hirakuni45/RX/rxprog/README.md

Renesas RX microcontroller flash programming tool (rx_prog)
=========
R5F564ML

[Japanese](READMEja.md)

## Overview
Tool to write program to flash memory of RX microcontroller using serial interface   
   
|RX Microcontroller|Support|operation verification|
|:-:|:-:|:-:|
|RX13T|〇|ー|
|RX140|〇|〇|
|RX220|〇|〇|
|RX230|〇|ー|
|RX231|〇|〇|
|RX23T|〇|ー|
|RX24T|〇|〇|
|RX24U|〇|ー|
|RX260/RX261|〇|ー|
|RX26T|〇|〇|
|RX621/RX62N|〇|〇|
|RX631/RX63N|〇|〇|
|RX63T|〇|〇|
|RX64M|〇|〇|
|RX651/RX65N|〇|ー|
|RX66T|〇|〇|
|RX71M|〇|〇|
|RX72T|〇|〇|
|RX72N|〇|ー|
   
---
   
## Project list
   
- main.cpp
- conf_in.hpp
- file_io.cpp
- file_io.hpp
- format.hpp
- motsx_io.hpp
- protocol_base.hpp
- rs232c_io.hpp
- rx_prog.hpp
- rx_protocol.hpp
- rx220_protocol.hpp
- rx23x_protocol.hpp
- rx24t_protocol.hpp
- rx26t_protocol.hpp
- rx62x_protocol.hpp
- rx63x_protocol.hpp
- rx64m_protocol.hpp
- rx65x_protocol.hpp
- rx66t_protocol.hpp
- rx72t_protocol.hpp
- sjis_utf16.cpp
- sjis_utf16.hpp
- string_utils.cpp
- string_utils.hpp
- Makefile
- rx_prog.conf
- /USB_CH9102F
- /USB_CP2102N
   
---
   
## Preparation of build (compilation) environment (Windows)
   
- MSYS2 setup
- gcc related installation (C++20)
- With C++20 support, Boost is no longer required
   
See development environment preparation of 'RX/README.md'
   
---
   
## Build method, environment setting
   
- make
- Copy configuration file and executable file by make install
- pass the path to '/usr/local/bin'
   
---
   
## Connection preparation (serial connection)
   
- Connect the VSS pin of the microcontroller to the GND of USB serial.
- Connect the RXD1 pin on the microcontroller side with the USB serial TXD.
- Connect the TXD1 pin on the microcontroller side with the USB serial RXD.
※SCI port at boot (usually SCI1, hardware manual for confirmation)   
- Pull down if the device has a UB terminal. (4.7K)
- Pull down if there is an EMLE terminal. (4.7K)
- Set the MD terminal to "Low" and input the "Reset" signal.
- When executing an internal program, set the MD pin to "High level" and input reset signal.
- MDE(13) is 0 (assumed little-endian)

---

## Connection terminal list

### RX140:

|Terminal|LFQFP 64|
|---|---|
|MD|MD(3)|
|RXD|P30/RXD1(14)|
|TXD|P26/TXD1(16)|

|Mode|MD|
|---|:---:|
|Serial Boot|0|
|Single Chip|1|

VCL: 4.7uF

### RX220:
|Terminal|LFQFP 64|
|---|---|
|MD|MD(3)|
|B/UB|PC7(27)|
|RXD|P30/RXD1(14)|
|TXD|P26/TXD1(16)|

|Mode|B/UB|MD|
|---|:---:|:---:|
|Boot Mode|0|0|
|User Boot Mode|1|0|
|Single Chip|-|1|

VCL: 0.1uF

---
### RX231:   
|Terminal|LFQFP 64|LFQFP 100|
|---|---|---|
|MD|MD(3)|MD(7)|
|UB|PC7(27)|PC7(45)|
|RXD|P30/RXD1(14)|P30/RXD1(20)|
|TXD|P26/TXD1(16)|P25/TXD1(23)|

|Mode|UB|MD|
|---|:---:|:---:|
|Serial Boot|0|0|
|USB Boot|1|0|
|Single Chip|-|1|

VCL: 4.7uF

---
### RX621/RX62N:
|Terminal|RX621/RX62N (144)|
|---|---|
|MD0|MD0(16)|
|MD1|MD1(15)|
|EMLE|EMLE(10)|
|RXD|P30/RXD1(29)|
|TXD|P26/TXD1(31)|
   
|Mode|MD0|MD1|
|---|:---:|:---:|
|Serial Boot|1|0|
|USB Boot|0|1|
|Single Chip|1|1|

VCL: 0.1uF

---
### RX631/RX63N:
|Terminal|LQFP 48|LQFP 64|TFLGA 64|LQFP 100|TFLGA 100|LQFP 144|TFLGA 145|LQFP 176|LFBGA 176|TFLGA 177|
|---|---|---|---|---|---|---|---|---|---|---|
|UB|PC7(21)|PC7(27)|PA6(D5)|PC7(45)|PC7(H7)|PC7(60)|PC7(N9)|PC7(76)|PC7(N10)|PC7(N10)|
|MD|MD/FINED(2)|MD/FINED(3)|MD/FINED(C2)|MD/FINED(7)|MD/FINED(D3)|MD/FINED(16)|MD/FINED(G3)|MD/FINED(18)|MD/FINED(G3)|MD/FINED(G3)|
|EMLE|-|EMLE(1)|EMLE(C3)|EMLE(2)|EMLE(B1)|EMLE(10)|EMLE(E4)|EMLE(10)|EMLE(E2)|EMLE(E2)|
|RXD|P30/RXD1(10)|P30/RXD1(14)|P30/RXD1(E3)|P30/RXD1(20)|P30/RXD1(G3)|P30/RXD1(29)|P30/RXD1(J4)|PF2/RXD1(31)|PF2/RXD1(K3)|PF2/RXD1(K3)|
|TXD|P26/TXD1(12)|P26/TXD1(16)|P26/TXD1(G2)|P26/TXD1(22)|P26/RXD1(H1)|P26/RXD1(31)|P26/RXD1(K2)|PF0/RXD1(35)|PF0/RXD1(L3)|PF0/RXD1(L3)|

|Mode|UB|MD|
|---|:---:|:---:|
|Serial Boot|0|0|
|USB Boot|1|0|
|Single Chip|-|1|

VCL: 0.1uF

---
### RX63T/RX24T/RX26T/RX66T/RX72T:
|Terminal|RX63T (64)|RX24T (100)|RX26T (100)|RX66T (100)|RX72T (144)|
|---|---|---|---|---|---|
|VCL|0.1uF|4.7uF|0.47uF|0.47uF|0.47uF|0.47uF|
|UB|P00(2)|ー|ー|UB/P00(4)|UB/P00(9)|
|MD|MD(5)|MD(6)|MD/FINED(6)|MD/FINED(6)|MD/FINED(11)|
|EMLE|EMLE(1)|ー|EMLE(2)|EMLE(2)|EMLE(7)|
|RXD|PD5/RXD1(14)|PD5/RXD1(20)|PD5/RXD1(20)|PD5/RXD1(20)|PD5/RXD1(25)|
|TXD|PD3/TXD1(16)|PD3/TXD1(22)|PD3/TXD1(22)|PD3/TXD1(22)|PD3/TXD1(27)|

|Mode|UB|MD|
|---|:---:|:---:|
|Serial Boot|0|0|
|USB Boot|1|0|
|Single Chip|-|1|

---
### RX64M/RX71M/RX651/RX65N:
|Terminal|RX64M (176)|RX71M (176)|RX651/RX65N (176)|
|---|---|---|---|
|VCL|0.1uF|0.22uF|0.22uF|
|UB|PC7/UB(76)|PC7/UB(76)|PC7/UB(76)|
|MD|MD/FINED(18)|MD/FINED(18)|MD/FINED(18)|
|EMLE|EMLE(10)|EMLE(10)|EMLE(10)|
|RXD|PF2/RXD1(31)|PF2/RXD1(31)|PF2/RXD1(31)|
|TXD|PF0/TXD1(35)|PF0/TXD1(35)|PF0/TXD1(35)|
   
|Mode|UB|MD|
|---|:---:|:---:|
|Serial Boot|0|0|
|USB Boot|1|0|
|Single Chip|-|1|

---
### RX660/RX671:
|Terminal|RX660 (144)|RX671 (144)|
|---|---|---|
|UB|PC7/UB(60)|PC7/UB(60)|
|MD|MD/PN6(16)|MD(16)|
|RXD|P30/RXD1(29)|P30/RXD1(29)|
|TXD|P26/TXD1(31)|P26/TXD1(31)|

RX660:
|Mode|UB|MD|
|---|:---:|:---:|
|Serial Boot|0|0|
|User Boot|1|0|
|Single Chip|-|1|

VCL: 0.47uF

RX660: USB boot not available due to lack of USB interface

RX671:
|Mode|UB|MD|
|---|:---:|:---:|
|Serial Boot|0|0|
|USB Boot|1|0|
|Single Chip|-|1|

VCL: 0.22uF

---
   
- MD0、MD1、UB、MD、B/UB, and EMLE terminals are pulled up or down with a resistor (approximately 4.7K).
- Connect appropriate crystals to XTAL and EXTAL.
- Connect the specified capacitor to VCL.
- Connect all the power supplies such as VSS, VCC, AVSS, AVCC etc.
- Connect USB power sources such as USB_VSS and USB_VCC properly.
   
※For details, refer to the hardware manual for each device, "Overview, Pin Assignment", "Flash Memory, Boot Mode".   
※The circuit diagram of the Renesas board is available for reference.   
   
---
## Method of operation
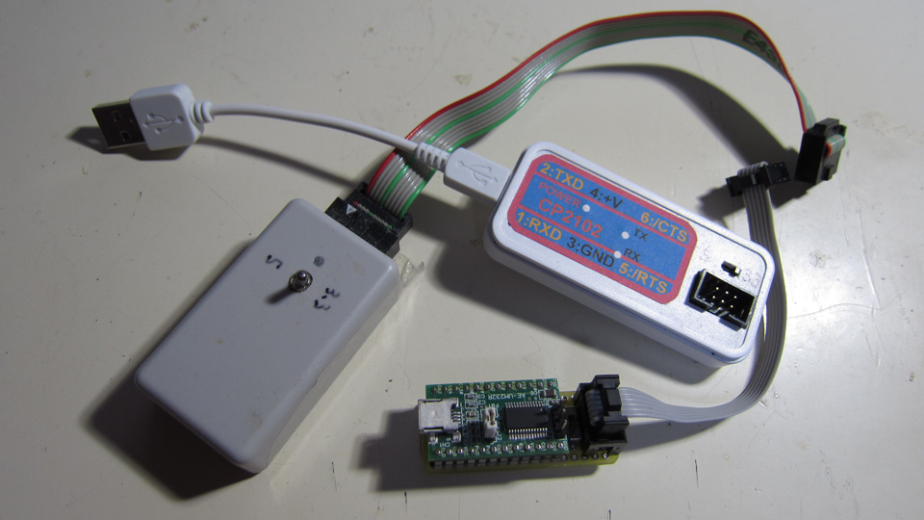
[picture p10: docs/USB_Serial.jpg]

### Confirm start of rx_prog
 - Run rx_prog and verify that it works (help is listed)
```
% rx_prog
Renesas RX Series Programmer Version 1.98
Copyright (C) 2016, 2026 Hiramatsu Kunihito (hira@rvf-rc45.net)
usage:
rx_prog [options] [mot file] ...

Options :
    -P PORT,   --port=PORT     Specify serial port
    -s SPEED,  --speed=SPEED   Specify serial speed
    -d DEVICE, --device=DEVICE Specify device name
    -e, --erase                Perform a device erase to a minimum
    --id=ID[:,]ID[:,] ...      Specify protect ID (16 bytes)
    -r, --read                 Perform data read
	--area=ORG[:,]END          Specify read area
    -v, --verify               Perform data verify
    -w, --write                Perform data write
    --progress                 display Progress output
    --erase-page-wait=WAIT     Delay per read page  (2000) [uS]
    --write-page-wait=WAIT     Delay per write page (5000) [uS]
    --device-list              Display device list
    --verbose                  Verbose output
    -h, --help                 Display this
```
   
### rx_prog.conf settings
 - Describe the settings of each device, port, baud rate, and so on.
 - You can specify the serial device port path individually so that settings can be shared between platforms.
 - Set the port name, baud rate, etc. according to your environment.
 - For the RX62x, the error is limited to 115200 for high baud rates.
   
rx_prog.conf configuration example
```
# Standard serial port, platform dependent port name
# port_win, port_osx and port_linux are recognized by platform and take precedence over port.
#port = /dev/ttyS10
#port = COM12
port_win   = COM3
port_osx   = /dev/tty.usbserial-DA00X2QP
port_linux = /dev/ttyUSB0

# Standard serial speed, platform dependent speed
# speed_win, speed_osx and speed_linux are recognized by platform and take precedence over speed.
# ※The maximum speed that can be set varies depending on the platform.
#speed = 230400
speed_win = 230400
speed_osx = 230400
speed_linux = 230400

# erase-page command wait [uS]
erase_page_wait = 2000
# write-page command wait [uS]
write_page_wait = 5000
```
rx_prog.conf is scanned and loaded in the following order:   
- Current directory
- Command directory (usually /usr/local/bin)
- The RX621/RX62N internally limits the serial speed to 115200 due to high baud rate errors.
- For devices such as RX621/RX62N and RX63T, external connection crystal frequency and multiplier settings are required when connecting.
- The RX63T internally limits the serial speed to 115200 due to high baud rate errors.
- This is done in the configuration file as shown below.
- If there are multiple settings with the same group name, the first setting found in the group will take effect.

```C++
R5F56217 {
	group = "RX621"
	clock = 1200
	divide_sys = 8
	divide_ext = 4

...

}
```

---

### Supported device list display

```sh
 % rx_prog --device-list
R5F513T3 (RX13T): Program-Flash:   64K, RAM:   12K, Data-Flash:  4K
R5F513T5 (RX13T): Program-Flash:  128K, RAM:   12K, Data-Flash:  4K
R5F51403 (RX140): Program-Flash:   64K, RAM:   16K, Data-Flash:  4K
R5F51405 (RX140): Program-Flash:  128K, RAM:   32K, Data-Flash:  8K
R5F51406 (RX140): Program-Flash:  256K, RAM:   64K, Data-Flash:  8K
R5F52206 (RX220): Program-Flash:  256K, RAM:   16K, Data-Flash:  8K
R5F52315 (RX231): Program-Flash:  128K, RAM:   32K, Data-Flash:  8K
R5F52316 (RX231): Program-Flash:  256K, RAM:   32K, Data-Flash:  8K
R5F52317 (RX231): Program-Flash:  384K, RAM:   64K, Data-Flash:  8K
R5F52318 (RX231): Program-Flash:  512K, RAM:   64K, Data-Flash:  8K
R5F524T8 (RX24T): Program-Flash:  128K, RAM:   16K, Data-Flash:  8K
R5F524TA (RX24T): Program-Flash:  256K, RAM:   16K, Data-Flash:  8K
R5F524UB (RX24U): Program-Flash:  256K, RAM:   32K, Data-Flash:  8K
R5F524UE (RX24U): Program-Flash:  512K, RAM:   32K, Data-Flash:  8K
R5F52618 (RX261): Program-Flash:  512K, RAM:  128K, Data-Flash:  8K
R5F526TF (RX26T): Program-Flash:  512K, RAM:   64K, Data-Flash: 16K
R5F56217 (RX621): Program-Flash:  384K, RAM:   64K, Data-Flash: 32K
R5F56218 (RX621): Program-Flash:  512K, RAM:   96K, Data-Flash: 32K
R5F562N7 (RX62N): Program-Flash:  384K, RAM:   64K, Data-Flash: 32K
R5F562N8 (RX62N): Program-Flash:  512K, RAM:   96K, Data-Flash: 32K
R5F5631F (RX631): Program-Flash: 2048K, RAM:  256K, Data-Flash: 32K
R5F563NE (RX63N): Program-Flash: 2048K, RAM:  128K, Data-Flash: 32K
R5F564MF (RX64M): Program-Flash: 2048K, RAM:  512K, Data-Flash: 64K
R5F571MF (RX71M): Program-Flash: 2048K, RAM:  512K, Data-Flash: 64K
R5F564MG (RX64M): Program-Flash: 2560K, RAM:  512K, Data-Flash: 64K
R5F571MG (RX71M): Program-Flash: 2560K, RAM:  512K, Data-Flash: 64K
R5F564MJ (RX64M): Program-Flash: 3072K, RAM:  512K, Data-Flash: 64K
R5F571MJ (RX71M): Program-Flash: 3072K, RAM:  512K, Data-Flash: 64K
R5F564ML (RX64M): Program-Flash: 4096K, RAM:  512K, Data-Flash: 64K
R5F571ML (RX71M): Program-Flash: 4096K, RAM:  512K, Data-Flash: 64K
R5F5651E (RX651): Program-Flash: 2048K, RAM:  640K, Data-Flash: 32K
R5F565NE (RX65N): Program-Flash: 2048K, RAM:  640K, Data-Flash: 32K
R5F5671C (RX671): Program-Flash: 1536K, RAM:  384K, Data-Flash:  8K
R5F5671E (RX671): Program-Flash: 2048K, RAM:  384K, Data-Flash:  8K
R5F566ND (RX66N): Program-Flash: 2048K, RAM: 1024K, Data-Flash: 32K
R5F566NN (RX66N): Program-Flash: 4096K, RAM: 1024K, Data-Flash: 32K
R5F572ND (RX72N): Program-Flash: 2048K, RAM: 1024K, Data-Flash: 32K
R5F572NN (RX72N): Program-Flash: 4096K, RAM: 1024K, Data-Flash: 32K
R5F572MD (RX72M): Program-Flash: 2048K, RAM: 1024K, Data-Flash: 32K
R5F572MN (RX72M): Program-Flash: 4096K, RAM: 1024K, Data-Flash: 32K
R5F563T6 (RX63T): Program-Flash:   64K, RAM:    8K, Data-Flash:  8K
R5F566TA (RX66T): Program-Flash:  256K, RAM:   64K, Data-Flash: 32K
R5F566TE (RX66T): Program-Flash:  512K, RAM:   64K, Data-Flash: 32K
R5F566TF (RX66T): Program-Flash:  512K, RAM:  128K, Data-Flash: 32K
R5F566TK (RX66T): Program-Flash: 1024K, RAM:  128K, Data-Flash: 32K
R5F572TF (RX72T): Program-Flash:  512K, RAM:  128K, Data-Flash: 32K
R5F572TK (RX72T): Program-Flash: 1024K, RAM:  128K, Data-Flash: 32K
```
   
---

### Current Implementation Dependency

- The current implementation does not implement a mechanism for device information profiles defined in rx_prog.conf to be referenced or evaluated during flash programming.
- This is for future extension.
- Information required for connection, such as "clock, divide_sys, divide_ext", is based on the profile of the first matched group device.
- Originally, the device profile obtained at the time of connection, in line with the device TYP, should be used, but this has not been implemented.
- This is because the TYP and device profile documents are not publicly available.
- Note that there are devices in the same group with different hardware specifications, and even if different definitions are made in rx_prog.conf, they will not be reflected.
- Rewriting of OFS option setting memory is not supported.

---

### Connection check
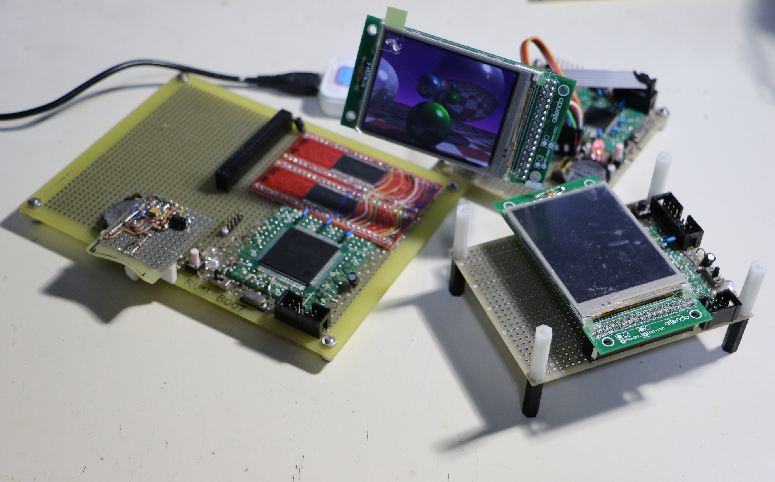
[picture p11: docs/RX_boards.jpg]

```
rx_prog -d RX71M --verbose
# Platform: 'Cygwin'
# Configuration file path: '/usr/local/bin/rx_prog.conf'
# Device: 'RX71M'
# Serial port path: 'COM3'
# Serial port speed: 230400
# Serial port alias: COM3 ---> /dev/ttyS2
# Serial port path: '/dev/ttyS2'
# Connection OK.
#01/01: Device Type TYP: 20 02 FD 09 01 48 40 00
#01/01: Device Type OSA: 16000000
#01/01: Device Type OSI: 16000000
#01/01: Device Type CPA: 120000000
#01/01: Device Type CPI: 120000000
#01/01: Endian is little.
#01/01: System clock: 120000000
#01/01: Device clock: 60000000
#01/01: Change baud rate: 230400
#01/01: ID: Disable
```
   
---

### Erase, write, compare (with progress bar, "test_sample.mot" file)
```
rx_prog -d RX71M --progress --write --verify test_sample.mot
Erase:  ################################################# 100 %
Write:  ################################################# 100 %
Verify: ################################################# 100 %
```
   
---

### Delete unnecessary serial port (Windows)
```
set devmgr_show_nonpresent_devices=1
start devmgmt.msc
```
   
- Remove all USB serial devices from your computer.
- Create a BAT file as above, right click and execute with "administrator privileges".
- Check "Display"-"Display Hidden Device".
- Delete unused COM ports.
- Once again, connect USB serial devices to the computer in order.
   
※In the case of the same maker device, since the change of COM port number etc. occur after the second one, it is necessary to take measures such as changing the internal serial ID number with a maker's dedicated tool depending on the situation.
※Please check with the device manufacturer's HP regarding the use of dedicated tools.
   
---
### Difference between FT232RL, FT231XS and CP2102
FT231XS, FT232RL:
```
Neptune./d/Git/RX/RAYTRACER_sample/RX66T % time rx_prog -d RX66T --progress --erase --write --verify raytracer_sample.mot
Erase:  ################################################# 100 %
Write:  ################################################# 100 %
Verify: ################################################# 100 %

real    0m16.617s
user    0m0.202s
sys     0m0.421s
```
   
CP2102:
```
Neptune./d/Git/RX/RAYTRACER_sample/RX66T % time rx_prog -P COM12 -d RX66T --progress --erase --write --verify raytracer_sample.mot
Erase:  ################################################# 100 %
Write:  ################################################# 100 %
Verify: ################################################# 100 %

real    0m6.616s
user    0m0.078s
sys     0m0.187s
```
   
※FTDI devices seem to be slower than silicon lab devices.

---

## USB Serial hardwear (KiCAD Project)

### CH9102F

---

## RX62N Imprint and Capacity

- The "R5F562N7" with FRK-RX62N is listed in the catalog as a FlashROM: 384K and RAM: 64K item.
- However, when we performed a connection test, it reported a FlashROM area that does not normally exist, as shown below.

```
 % rx_prog -d RX62N --verbose
# Platform: 'Cygwin'
# Configuration file path: 'rx_prog.conf'
# Device: 'RX62N'
# Serial port path: 'COM7'
# Serial port speed: 230400
# Erase Page Wait: 2000 [uS]
# Write Page Wait: 5000 [uS]
# Serial port alias: COM7 ---> /dev/ttyS6
# Serial port path: '/dev/ttyS6'
Connection OK. (RX62x)
#01/01: Device: RX600 Series
#01/01: Device ID: 0x35307936
#01/01: Clock Mode: 0x00
#01/02: Multiplier: 1, 2, 4, 8
#02/02: Multiplier: 1, 2, 4, 8
#01/02: Frequency Min: 8 MHz, Max: 100 MHz
#02/02: Frequency Min: 8 MHz, Max: 50 MHz
#01/01: Change baud rate: 115200
#01/01: Boot Area: FF7FC000, FF7FFFFF
#01/01: Area: FFF80000, FFFFFFFF
#01/54: Area: FFFFF000, FFFFFFFF
#02/54: Area: FFFFE000, FFFFEFFF
#03/54: Area: FFFFD000, FFFFDFFF
#04/54: Area: FFFFC000, FFFFCFFF
#05/54: Area: FFFFB000, FFFFBFFF
#06/54: Area: FFFFA000, FFFFAFFF
#07/54: Area: FFFF9000, FFFF9FFF
#08/54: Area: FFFF8000, FFFF8FFF

...

#50/54: Area: 00102000, 001027FF
#51/54: Area: 00101800, 00101FFF
#52/54: Area: 00101000, 001017FF
#53/54: Area: 00100800, 00100FFF
#54/54: Area: 00100000, 001007FF
#01/01: Program size: 256 Bytes
#01/01: ID Protect: false
```

- As with the R5F562N8, 512K bytes of FlashROM and 96K bytes of RAM are available from FFF80000.
- The actual program is ready and operation has been confirmed.

---

Translated with www.DeepL.com/Translator (free version)

---
   
License
---

MIT
