hirakuni45/RX/RX72T/README.md

## RX72T features / 特徴

- RXv3 core / RXv3 コア
- Maximum operating frequency 200MHz / 最大動作周波数 200MHz
- Single-precision 32-bit floating point / 32 ビット単精度浮動小数点
- 2.7V ～ 5.5V Operation / 動作
- USB2.0 Full Speed, Host, Function (Optional)
- CAN Module (CAN) / CAN モジュール (CAN)
- Arithmetic Unit for Trigonometric Functions (TFUv1) / 三角関数演算器 (TFUv1)
- 12 Bits A/D / １２ビットＡ／Ｄ変換器
- 12 Bits D/A / １２ビットＤ／Ａ変換器

### Package/パッケージ

|R5F572T---XX|Package/パッケージ|Pin/ピン数|Pitch/ピッチ|
|---|:-:|:-:|:-:|
|R5F572TxxxFB|LFQFP|144|0.50|
|R5F572TxxxFP|LFQFP|100|0.50|

### Ambient operating temperature/動作周囲温度

|R5F572T--X--|degree Celsius|
|---|:-:|
|R5F572TxxDxx|-40 ～ +85℃|
|R5F572TxxGxx|-40 ～ +105℃|

### PGA, TSIP, USB

|R5F572T-X---|PGA|TSIP|USB|
|---|:-:|:-:|:-:|
|R5F572TxAxxx|〇|-|-|
|R5F572TxBxxx|-|-|-|
|R5F572TxCxxx|〇|-|〇|
|R5F572TxExxx|〇|〇|-|
|R5F572TxFxxx|-|〇|-|
|R5F572TxGxxx|〇|〇|〇|

### Memoey size/メモリ容量

|R5F572TX----|CodeFlash|RAM|ECCRAM|DataFlash|
|---|:-:|:-:|:-:|:-:|
|R5F572TKxxxx|1M|128K|16K|32K|
|R5F572TFxxxx|512K|128K|16K|32K|

### Data Flash/データ・フラッシュ

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

---

## RX72T Linker file / リンカーファイル

|Type|Code Flash|RAM|Data Flash|Linker File|Ustack|Istack|
|---|:-:|:-:|:-:|---|:-:|:-:|
|R5F572TK|1024K|128K+16K|32K|[R5F572TK.ld](R5F572TK.ld?ts=4)|7168|1024|
|R5F572TF|512K|128K+16K|32K|[R5F572TF.ld](R5F572TF.ld?ts=4)|7168|1024|

RAM: 16K(With ECC)

---

## RX72T Dedicated class / 専用クラス

|Function/機能|Source|Remarks/備考|
|---|---|:-:|
|Peripheral Name/ペリフェラル名|[peripheral.hpp](peripheral.hpp?ts=4)||
|Hardware-specific Definition/ハード固有定義|[board_profile.hpp](board_profile.hpp?ts=4)||
|Operating Frequency Definition/動作周波数定義|[clock_profile.hpp](clock_profile.hpp?ts=4)||
|Power Control/電力制御|[power_mgr.hpp](power_mgr.hpp?ts=4)||
|Port Definition/ポート定義|[port.hpp](port.hpp?ts=4)||
|Interrupt Definition/割り込み定義|[icu.hpp](icu.hpp?ts=4)||
|Interrupt Management/割り込み管理|[icu_mgr.hpp](icu_mgr.hpp?ts=4)||
|Port Function Definition/ポート機能定義|[mpc.hpp](mpc.hpp?ts=4)||
|Port Mapping/ポートマッピング|[port_map.hpp](port_map.hpp?ts=4)||
|Port Mapping IRQ/ポートマッピング IRQ|[port_map_irq.hpp](port_map_irq.hpp?ts=4)||
|Port Mapping MTU/ポートマッピング MTU|[port_map_mtu.hpp](port_map_mtu.hpp?ts=4)||
|Port Mapping TMR/ポートマッピング TMR|[port_map_tmr.hpp](port_map_tmr.hpp?ts=4)||
|Port Mapping GPTW/ポートマッピング GPTW|[port_map_gptw.hpp](port_map_gptw.hpp?ts=4)||
|POE3 Definition/POE3 定義|[poe3.hpp](poe3.hpp?ts=4)||
|A/D Definition/A/D 定義|[s12adh.hpp](s12adh.hpp?ts=4)||

---

## Basic Pin Assignments / 基本ピンアサイン

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

- VCL: 0.47uF/25V

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

- EMLE: 0

---

## Device, Renesas / デバイス、ルネサス

- [device.hpp (SIG_RX72T)](../common/device.hpp?ts=4)
- [renesas.hpp (SIG_RX72T)](../common/renesas.hpp?ts=4)

|name space|Device, Renesas|デバイス、ルネサス|
|---|---|---|
|[clock_profile](../RX72T/clock_profile?ts=4)|Clock Profile|クロック・プロファイル|
|[SYSTEM](../RX72T/system.hpp?ts=4)|Clock Generation Circuit|クロック発生回路|
|[power_mgr](../RX72T/power_mgr.hpp?ts=4)|Low Power Consumption|消費電力低減機能|
|[ICU](../RX72T/icu.hpp?ts=4)|Interrupt Controller|割り込みコントローラ|
|[icu_mgr](../RX72T/icu_mgr.hpp?ts=4)|ICU Manager|ICU マネージャー|
|[MPC](../RX72T/mpc.hpp?ts=4)|Multi-Function Pin Controller|マルチファンクションピンコントローラ|
|[PORTx](../RX72T/port.hpp?ts=4)|I/O Ports|I/O ポート|
|[port_map](../RX72T/port_map.hpp?ts=4)|Port Mapping|ポート・マッピング|
|[port_map_mtu](../RX72T/port_map_mtu.hpp?ts=4)|Port Mapping MTU|ポート・マッピング MTU|
|[port_map_gptw](../RX72T/port_map_gptw.hpp?ts=4)|Port Mapping GPTW|ポート・マッピング GPTW|
|[port_map_tmr](../RX72T/port_map_tmr.hpp?ts=4)|Port Mapping TMR|ポート・マッピング TMR|
|[port_map_irq](../RX72T/port_map_irq.hpp?ts=4)|Port Mapping IRQ|ポート・マッピング IRQ|
|[FLASH](../RX600/flash.hpp?ts=4)|Flash Memory|フラッシュメモリ|
|[SYSTEM_IO](../RX600/system_io.hpp?ts=4)|System In/Out (Clock Setting)|システム In/Out (クロック設定)|
|[FLASH_IO](../RX600/flash_io.hpp?ts=4)|Flash In/Out|フラッシュ In/Out|
|[adc_in](../RX600/adc_in.hpp?ts=4)|A/D Converter Input|A/D 変換入力|
|[dac_out](../RX600/dac_out.hpp?ts=4)|D/A Converter Output|D/A 変換出力|
|[board_profile](../RX72T/board_profile?ts=4)|Board Profile|ボード・プロファイル|

---

## Peripheral / ペリフェラル

- [peripheral.hpp](peripheral.hpp?ts=4)

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

---

## Port map order (IRQ) / ポートマップ候補 (IRQ)

- [port_map_irq.hpp](port_map_irq.hpp?ts=4)

### LFQFP100

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

### LFQFP144

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

---

## Port map order / ポートマップ候補

- [port_map.hpp](port_map.hpp?ts=4)

### LFQFP100

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

### LFQFP144

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

---

## Port map order (GPTW) / ポートマップ候補 (GPTW)

- [port_map_gptw.hpp](port_map_gptw.hpp?ts=4)

### LFQFP100

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

### LFQFP144

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

---

## Port map order (MTU) / ポートマップ候補 (MTU)

- [port_map_mtu.hpp](port_map_mtu.hpp?ts=4)

### LFQFP100

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

### LFQFP144

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

---

## 12 Bits A/D Converter input (S12AD) / 12 ビット A/D コンバーター入力 (S12AD)

- [s12adh.hpp](s12adh.hpp?ts=4)

### LFQFP100

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

### LFQFP144

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

---

## 12 Bits D/A Converter output (R12DA) / 12 ビット D/A コンバーター出力 (R12DA)

- [r12da.hpp](../RX600/r12da.hpp?ts=4)

### LFQFP100

|R12DA/ANALOG|Port|
|---|---|
|DA0|P64 (71)|
|DA1|P65 (70)|

### LFQFP144

|R12DA/ANALOG|Port|
|---|---|
|DA0|P64 (103)|
|DA1|P65 (102)|

---

## rx_prog Flash Programming / rx_prog フラッシュプログラム

||Support/サポート|operation verification/動作検証|
|-|:-:|:-:|
|[rxprog](../rxprog)|〇|〇|

---

Translated with www.DeepL.com/Translator (free version)

---

## License

[MIT](../LICENSE)
