hirakuni45/RX/RX21A/README.md

---

# underconstructions...

---

## RX21A features / 特徴

- RXv1 core / RXv1 コア
- Maximum operating frequency 50MHz / 最大動作周波数 50MHz
- 1.8V ～ 3.6V Operation / 動作
- 24 bits ∆ΣA/D converter / 24 ビット ∆ΣA/D コンバータ
- The operating supply voltage for the ΔΣA/D converter is 2.7 V to 3.6 V / ΔΣA/D コンバータ動作時の電源電圧は 2.7V ～ 3.6V

### Package/パッケージ

|R5F521A---XX|Package/パッケージ|Pin/ピン数|Pitch/ピッチ|
|---|:-:|:-:|:-:|
|R5F521AxxxFP|LQFP|100|0.50|
|R5F521AxxxFN|LQFP|80|0.50|
|R5F521AxxxFM|LQFP|64|0.50|
|R5F521AxxxLJ|TFLGA|100|0.65|

### Ambient operating temperature/動作周囲温度

|R5F521A--X--|degree Celsius|
|---|:-:|
|R5F521AxxDxx|-40 ～ +85℃|
|R5F521AxxGxx|-40 ～ +105℃|

### Memoey size/メモリ容量

|R5F521AX----|CodeFlash|RAM|DataFlash|
|---|:-:|:-:|:-:|
|R5F521A8xxxx|512K|64K|8K|
|R5F521A7xxxx|384K|64K|8K|
|R5F521A6xxxx|256K|32K|8K|

### Data Flash/データ・フラッシュ

|Capacity|Erase Size|Blank Check Size|Write Size|Erase Value|ID|
|:-:|:-:|:-:|:-:|:-:|:-:|
|8K|128|2/2048|2|0x??|4|

---

## RX21A Linker file / リンカーファイル

|Type|Code Flash|RAM|Data Flash|Linker File|Ustack|Istack|
|---|:-:|:-:|:-:|---|:-:|:-:|
|R5F521A6|256K|32K|8K|[R5F521A6.ld](R5F521A6.ld?ts=4)|1536|512|

---

## RX21A Dedicated class / 専用クラス

|Function/機能|Source|Remarks/備考|
|---|---|:-:|
|Peripheral Name/ペリフェラル名|[peripheral.hpp](peripheral.hpp?ts=4)||
|Hardware-specific Definition/ハード固有定義|[board_profile.hpp](board_profile.hpp?ts=4)||
|Operating Frequency Definition/動作周波数定義|[clock_profile.hpp](clock_profile.hpp?ts=4)||
|Power Control/電力制御|[power_mgr.hpp](power_mgr.hpp?ts=4)||
|Port Definition/ポート定義|[port.hpp](port.hpp?ts=4)||
|Interrupt Definition/割り込み定義|[icu.hpp](icu.hpp?ts=4)||
|Interrupt Management/割り込み管理|[icu_mgr.hpp](../RX220/icu_mgr.hpp?ts=4)||
|Port Function Definition/ポート機能定義|[mpc.hpp](mpc.hpp?ts=4)||
|Port Mapping/ポートマッピング|[port_map.hpp](port_map.hpp?ts=4)||
|Port Mapping IRQ/ポートマッピング IRQ|[port_map_irq.hpp](port_map_irq.hpp?ts=4)||
|Port Mapping MTU/ポートマッピング MTU|[port_map_mtu.hpp](port_map_mtu.hpp?ts=4)||
|Port Mapping MTU/ポートマッピング TMR|[port_map_tmr.hpp](../RX220/port_map_tmr.hpp?ts=4)||
|CMPA Definition/CMPA 定義|[cmpa.hpp](cmpa.hpp?ts=4)||
|MTU2 Definition/MTU2 定義|[mtu2.hpp](mtu2.hpp?ts=4)||
|POE2 Definition/POE2 定義|[poe2.hpp](poe2.hpp?ts=4)||
|RTC Definition/RTC 定義|[rtc.hpp](rtc.hpp?ts=4)||
|A/D Definition/A/D 定義|[s12ad.hpp](s12ad.hpp?ts=4)||
|FLASH Definition/FLASH 定義|[flash.hpp](flash.hpp?ts=4)||
|FLASH I/O Definition/FLASH I/O 定義|[flash_io.hpp](flash_io.hpp?ts=4)||
|System Definition/システム定義|[system.hpp](system.hpp?ts=4)||
|System I/O Definition/システム I/O 定義|[system_io.hpp](system_io.hpp?ts=4)||

---

## Basic Pin Assignments / 基本ピンアサイン

|Terminal/端子|LQFP 64|LQFP 100|
|---|---|---|
|VCL|VCL(2)|VCL(5)|
|Reset Input/リセット入力|RES#(6)|RES#(10)|
|Mode Select|PC7(27)|PC7(45)|
|Mode Controle/モード制御|MD/FINED(3)|MD/FINED(7)|
|RXD|P30/RXD1(14)|P30/RXD1(20)|
|TXD|P26/TXD1(16)|P26/TXD1(22)|
|Power/電源|VCC(10), VCC(38)|VCC(14), VCC(60)|
|GND/接地|VSS(8), VSS(40)|VSS(12), VSS(62)|
|Analog Power/アナログ電源|AVCC0(62)|AVCC0(97)|
|Analog GND/アナログ接地|AVSS0(64)|AVSS0(99)|
|Analog Refarence L/アナログ基準電源Ｌ|VREFL0(59)|VREFL0(94)|
|Analog Refarence H/アナログ基準電源Ｈ|VREFH0(61)|VREFH0(96)|
|OSC out|XTAL(7)|XTAL(11)|
|OSC in|EXTAL(9)|EXTAL(13)|
|Sub OSC out|XCOUT(5)|XCOUT(9)|
|Sub OSC in|XCIN(4)|XCIN(8)|
|DSAD Power 電源|AVCCA(52)|AVCCA(83)|
|DSAD GND 接地|AVSSA(51)|AVSSA(82)|
|DSAD Refarence L 基準電源Ｌ|VREFDSL(53)|VREFDSL(84)|
|DSAD Refarence H 基準電源Ｈ|VREFDSH(54)|VREFDSH(85)|
|DSAD VCOMMDS|VCOMMDS(55)|VCOMMDS(86)|
|DSAD Signal GND|ANDSSG(57)|ANDSSG(90)|
|DSAD Refarence external/リファレンス外部印加|BGR_BO(46)|BGR_BO(73)|

- VCL: 0.1uF/25V
- VCOMMDS: 0.1uF/25V to Analog GND

|Mode/モード|PC7|MD|
|---|:---:|:---:|
|Serial BOOT/シリアルブート|0|0|
|User Boot/ユーザーブート|1|0|
|Single Chip/シングルチップ|-|1|

---

## Peripheral / ペリフェラル

- [peripheral.hpp](peripheral.hpp?ts=4)

|Peripheral|Function|機能|
|---|---|---|
|CAC|Clock Frequency Accuracy Measurement Circuit|クロック周波数精度測定回路|
|DMAC0|DMA Controller channel 0|DMA コントローラ・チャネル０|
|DMAC1|DMA Controller channel 1|DMA コントローラ・チャネル１|
|DMAC2|DMA Controller channel 2|DMA コントローラ・チャネル２|
|DMAC3|DMA Controller channel 3|DMA コントローラ・チャネル３|
|DTC|Data Transfer Controller|データトランスファコントローラ|
|ELC|Event Link Controller|イベントリンクコントローラ|
|MTU0|Multi-Function Timer Pulse Unit 0|マルチファンクションタイマパルスユニット０|
|MTU1|Multi-Function Timer Pulse Unit 1|マルチファンクションタイマパルスユニット１|
|MTU2|Multi-Function Timer Pulse Unit 2|マルチファンクションタイマパルスユニット２|
|MTU3|Multi-Function Timer Pulse Unit 3|マルチファンクションタイマパルスユニット３|
|MTU4|Multi-Function Timer Pulse Unit 4|マルチファンクションタイマパルスユニット４|
|MTU5|Multi-Function Timer Pulse Unit 5|マルチファンクションタイマパルスユニット５|
|POE2|Port Output Enable 2|ポートアウトプットイネーブル２|
|TMR0|8-Bit Timer 0|8 ビットタイマ０|
|TMR1|8-Bit Timer 1|8 ビットタイマ１|
|TMR2|8-Bit Timer 2|8 ビットタイマ２|
|TMR3|8-Bit Timer 3|8 ビットタイマ３|
|CMT0|Compare Match Timer 0|コンペアマッチタイマ０|
|CMT1|Compare Match Timer 1|コンペアマッチタイマ１|
|CMT2|Compare Match Timer 2|コンペアマッチタイマ２|
|CMT3|Compare Match Timer 3|コンペアマッチタイマ３|
|RTC|Realtime Clock|リアルタイムクロック|
|IWDT|Independent Watchdog Timer|独立ウォッチドッグタイマ|
|SCI1|Serial Communications Interface 1|シリアルコミュニケーションインタフェース１|
|SCI5|Serial Communications Interface 5|シリアルコミュニケーションインタフェース５|
|SCI6|Serial Communications Interface 6|シリアルコミュニケーションインタフェース６|
|SCI8|Serial Communications Interface 8|シリアルコミュニケーションインタフェース８|
|SCI9|Serial Communications Interface 9|シリアルコミュニケーションインタフェース９|
|IrDA|IrDA Interface|IrDA インタフェース|
|RIIC0|I2C-bus Interface 0|I2C バスインタフェース０|
|RIIC1|I2C-bus Interface 1|I2C バスインタフェース１|
|RSPI0|Serial Peripheral Interface 0|シリアルペリフェラルインタフェース０|
|RSPI1|Serial Peripheral Interface 1|シリアルペリフェラルインタフェース１|
|CRC|CRC Calculator|CRC 演算器|
|AD|10-Bit A/D Converter|10 ビット A/D コンバータ|
|CMPA|Comparator A|コンパレータＡ|
|CMPB|Comparator B|コンパレータＢ|
|DOC|Data Operation Circuit|データ演算回路|

---

## Port map order (IRQ) / ポートマップ候補 (IRQ)

- [port_map_irq.hpp](port_map_irq.hpp?ts=4)

### LQFP64

|IRQ|FIRST|SECOND|THIRD|FOURTH|
|---|---|---|---|---|
|IRQ0|P30 (14)|PD0 (--)|PH1 (23)|-|
|IRQ1|P31 (13)|PD1 (--)|PH2 (22)|-|
|IRQ2|P32 (12)|P12 (--)|PD2 (--)|-|
|IRQ3|P33 (--)|P13 (--)|PD3 (--)|-|
|IRQ4|PB1 (37)|P14 (20)|P34 (--)|PD4 (--)|
|IRQ5|PA4 (42)|P15 (19)|PD5 (--)|PE5 (46)|
|IRQ6|PA3 (43)|P16 (18)|PD6 (--)|PE6 (--)|
|IRQ7|PE2 (49)|P17 (17)|PD7 (--)|PE7 (--)|

### LQFP100

|IRQ|FIRST|SECOND|THIRD|FOURTH|
|---|---|---|---|---|
|IRQ0|P30 (20)|PD0 (86)|PH1 (37)|-|
|IRQ1|P31 (19)|PD1 (85)|PH2 (36)|-|
|IRQ2|P32 (18)|P12 (34)|PD2 (84)|-|
|IRQ3|P33 (17)|P13 (33)|PD3 (83)|-|
|IRQ4|PB1 (59)|P14 (32)|P34 (16)|PD4 (82)|
|IRQ5|PA4 (66)|P15 (31)|PD5 (81)|PE5 (73)|
|IRQ6|PA3 (67)|P16 (30)|PD6 (80)|PE6 (72)|
|IRQ7|PE2 (76)|P17 (29)|PD7 (79)|PE7 (71)|

---

## Port map order / ポートマップ候補

- [port_map.hpp](port_map.hpp?ts=4)

### LQFP64

|Peripheral|FIRST|SECOND|THIRD|FOURTH|
|---|---|---|---|---|
|SCI1 / RXD|P15 (19)|P30 (14)|-|-|
|SCI1 / TXD|P16 (18)|P26 (16)|-|-|
|SCI1 / SCK|P17 (17)|P27 (15)|-|-|
|SCI5 / RXD|PA2 (--)|PA3 (43)|PC2 (32)|-|
|SCI5 / TXD|PA4 (42)|PA4 (42)|PC3 (31)|-|
|SCI5 / SCK|PA1 (44)|PA1 (44)|PC4 (30)|-|
|SCI6 / RXD|P33 (--)|PB0 (39)|-|-|
|SCI6 / TXD|P32 (12)|PB1 (37)|-|-|
|SCI6 / SCK|P34 (--)|PB3 (36)|-|-|
|SCI9 / RXD|PB6 (34)|-|-|-|
|SCI9 / TXD|PB7 (33)|-|-|-|
|SCI9 / SCK|PB5 (35)|-|-|-|
|SCI12 / RXD|PE2 (49)|-|-|-|
|SCI12 / TXD|PE1 (50)|-|-|-|
|SCI12 / SCK|PE0 (51)|-|-|-|
|RIIC0 / SCL|P16 (18)|P12 (--)|-|-|
|RIIC0 / SDA|P17 (17)|P13 (--)|-|-|
|RSPI0 / RSPCK|PA5 (--)|PB0 (39)|PC5 (29)|-|
|RSPI0 / MOSI|PA6 (41)|P16 (18)|PC6 (28)|-|
|RSPI0 / MISO|PA7 (--)|P17 (17)|PC7 (27)|-|
|RSPI0 / SSL0|PA4 (42)|PC4 (30)|-|-|
|RSPI0 / SSL1|PA0 (45)|PC0 (--)|-|-|
|RSPI0 / SSL2|PA1 (44)|PC1 (--)|-|-|
|RSPI0 / SSL3|PA2 (--)|PC2 (32)|-|-|

### LQFP100

|Peripheral|FIRST|SECOND|THIRD|FOURTH|
|---|---|---|---|---|
|SCI1 / RXD|P15 (31)|P30 (20)|-|-|
|SCI1 / TXD|P16 (30)|P26 (22)|-|-|
|SCI1 / SCK|P17 (29)|P27 (21)|-|-|
|SCI5 / RXD|PA2 (68)|PA3 (67)|PC2 (50)|-|
|SCI5 / TXD|PA4 (66)|PA4 (66)|PC3 (49)|-|
|SCI5 / SCK|PA1 (69)|PA1 (69)|PC4 (48)|-|
|SCI6 / RXD|P33 (17)|PB0 (61)|-|-|
|SCI6 / TXD|P32 (18)|PB1 (59)|-|-|
|SCI6 / SCK|P34 (16)|PB3 (57)|-|-|
|SCI9 / RXD|PB6 (54)|-|-|-|
|SCI9 / TXD|PB7 (53)|-|-|-|
|SCI9 / SCK|PB5 (55)|-|-|-|
|SCI12 / RXD|PE2 (76)|-|-|-|
|SCI12 / TXD|PE1 (77)|-|-|-|
|SCI12 / SCK|PE0 (78)|-|-|-|
|RIIC0 / SCL|P16 (30)|P12 (34)|-|-|
|RIIC0 / SDA|P17 (29)|P13 (33)|-|-|
|RSPI0 / RSPCK|PA5 (65)|PB0 (61)|PC5 (47)|-|
|RSPI0 / MOSI|PA6 (64)|P16 (30)|PC6 (46)|-|
|RSPI0 / MISO|PA7 (63)|P17 (29)|PC7 (45)|-|
|RSPI0 / SSL0|PA4 (66)|PC4 (48)|-|-|
|RSPI0 / SSL1|PA0 (70)|PC0 (52)|-|-|
|RSPI0 / SSL2|PA1 (69)|PC1 (51)|-|-|
|RSPI0 / SSL3|PA2 (68)|PC2 (50)|-|-|

---

## Port map order (MTU) / ポートマップ候補 (MTU)

- [port_map_mtu.hpp](port_map_mtu.hpp?ts=4)

### LFQFP64

|MTU|FIRST|SECOND|THIRD|FOURTH|FIFTH|
|---|---|---|---|---|---|
|MTIOC0A|P34 (--)|PB3 (36)|-|-|-|
|MTIOC0B|P13 (--)|P15 (19)|PA1 (44)|-|-|
|MTIOC0C|P32 (12)|PB1 (37)|-|-|-|
|MTIOC0D|P33 (--)|PA3 (43)|-|-|-|
|MTIOC1A|P20 (--)|PE4 (47)|-|-|-|
|MTIOC1B|P21 (--)|PB5 (35)|-|-|-|
|MTIOC2A|P26 (16)|PB5 (35)|-|-|-|
|MTIOC2B|P27 (15)|PE5 (46)|-|-|-|
|MTIOC3A|P14 (20)|P17 (17)|PC1 (--)|PC7 (27)|PJ1 (--)|
|MTIOC3B|P17 (17)|P22 (--)|PB7 (33)|PC5 (29)|-|
|MTIOC3C|P16 (18)|PC0 (--)|PC6 (28)|PJ3 (--)|-|
|MTIOC3D|P16 (18)|P23 (--)|PB6 (34)|PC4 (30)|-|
|MTIOC4A|P24 (--)|PA0 (45)|PB3 (36)|PE2 (49)|-|
|MTIOC4B|P30 (14)|P54 (26)|PC2 (32)|PD1 (--)|PE3 (48)|
|MTIOC4C|P25 (--)|PB1 (37)|PE1 (50)|PE5 (46)|-|
|MTIOC4D|P31 (13)|P55 (25)|PC3 (31)|PD2 (--)|PE4 (47)|
|MTIOC5U|PA4 (42)|PD7 (--)|-|-|-|
|MTIOC5V|PA6 (41)|PD6 (--)|-|-|-|
|MTIOC5W|PB0 (39)|PD5 (--)|-|-|-|
|MTCLKA|P14 (20)|P24 (--)|PA4 (42)|PC6 (28)|-|
|MTCLKB|P15 (19)|P25 (--)|PA6 (41)|PC7 (27)|-|
|MTCLKC|P22 (--)|PA1 (44)|PC4 (30)|-|-|
|MTCLKD|P23 (--)|PA3 (43)|PC5 (29)|-|-|

### LFQFP100

|MTU|FIRST|SECOND|THIRD|FOURTH|FIFTH|
|---|---|---|---|---|---|
|MTIOC0A|P34 (16)|PB3 (57)|-|-|-|
|MTIOC0B|P13 (33)|P15 (31)|PA1 (69)|-|-|
|MTIOC0C|P32 (18)|PB1 (59)|-|-|-|
|MTIOC0D|P33 (17)|PA3 (67)|-|-|-|
|MTIOC1A|P20 (28)|PE4 (74)|-|-|-|
|MTIOC1B|P21 (27)|PB5 (55)|-|-|-|
|MTIOC2A|P26 (22)|PB5 (55)|-|-|-|
|MTIOC2B|P27 (21)|PE5 (73)|-|-|-|
|MTIOC3A|P14 (32)|P17 (29)|PC1 (51)|PC7 (45)|PJ1 (6)|
|MTIOC3B|P17 (29)|P22 (26)|PB7 (53)|PC5 (47)|-|
|MTIOC3C|P16 (30)|PC0 (52)|PC6 (46)|PJ3 (4)|-|
|MTIOC3D|P16 (30)|P23 (25)|PB6 (54)|PC4 (48)|-|
|MTIOC4A|P24 (24)|PA0 (70)|PB3 (57)|PE2 (76)|-|
|MTIOC4B|P30 (20)|P54 (40)|PC2 (50)|PD1 (85)|PE3 (75)|
|MTIOC4C|P25 (23)|PB1 (59)|PE1 (77)|PE5 (73)|-|
|MTIOC4D|P31 (19)|P55 (39)|PC3 (49)|PD2 (84)|PE4 (74)|
|MTIOC5U|PA4 (66)|PD7 (79)|-|-|-|
|MTIOC5V|PA6 (64)|PD6 (80)|-|-|-|
|MTIOC5W|PB0 (61)|PD5 (81)|-|-|-|
|MTCLKA|P14 (32)|P24 (24)|PA4 (66)|PC6 (46)|-|
|MTCLKB|P15 (31)|P25 (23)|PA6 (64)|PC7 (45)|-|
|MTCLKC|P22 (26)|PA1 (69)|PC4 (48)|-|-|
|MTCLKD|P23 (25)|PA3 (67)|PC5 (47)|-|-|

---

## Port map order (TMR) / ポートマップ候補 (TMR)

- [port_map_tmr.hpp](port_map_tmr.hpp?ts=4)

### LFQFP64

|TMR|FIRST|SECOND|THIRD|
|---|---|---|---|
|TMO0|P22 (--)|PB3 (36)|PH1 (23)|
|TMCI0|P21 (--)|PB1 (37)|PH3 (21)|
|TMRI0|P20 (--)|PA4 (42)|PH2 (22)|
|TMO1|P17 (17)|P26 (16)|-|
|TMCI1|P12 (--)|P54 (26)|PC4 (30)|
|TMRI1|P24 (--)|PB5 (35)|-|
|TMO2|P16 (18)|PC7 (27)|-|
|TMCI2|P15 (19)|P31 (13)|PC6 (28)|
|TMRI2|P14 (20)|PC5 (29)|-|
|TMO3|P13 (--)|P32 (12)|P55 (25)|
|TMCI3|P27 (15)|P34 (--)|PA6 (41)|
|TMRI3|P30 (14)|P33 (--)|-|

### LFQFP100

|TMR|FIRST|SECOND|THIRD|
|---|---|---|---|
|TMO0|P22 (26)|PB3 (57)|PH1 (37)|
|TMCI0|P21 (27)|PB1 (59)|PH3 (35)|
|TMRI0|P20 (28)|PA4 (66)|PH2 (36)|
|TMO1|P17 (29)|P26 (22)|-|
|TMCI1|P12 (34)|P54 (40)|PC4 (48)|
|TMRI1|P24 (24)|PB5 (55)|-|
|TMO2|P16 (30)|PC7 (45)|-|
|TMCI2|P15 (31)|P31 (19)|PC6 (46)|
|TMRI2|P14 (32)|PC5 (47)|-|
|TMO3|P13 (33)|P32 (18)|P55 (39)|
|TMCI3|P27 (21)|P34 (16)|PA6 (64)|
|TMRI3|P30 (20)|P33 (17)|-|

---

## 10 Bits A/D Converter input (AD) / 10 ビット A/D コンバーター入力 (AD)

- [ad.hpp](ad.hpp?ts=4)

### LFQFP64

|AD/ANALOG|Port|
|---|---|
|AN0|P40 (60)|
|AN1|P41 (58)|
|AN2|P42 (--)|
|AN3|P43 (--)|
|AN4|P03 (1)|
|AN5|P05 (63)|
|AN6|P07 (--)|

### LFQFP100

|AD/ANALOG|Port|
|---|---|
|AN0|P40 (95)|
|AN1|P41 (93)|
|AN2|P42 (92)|
|AN3|P43 (91)|
|AN4|P03 (2)|
|AN5|P05 (100)|
|AN6|P07 (98)|

---

## 24 Bits ∆ΣA/D Converter input (DSAD) / 24 ビット ∆ΣA/D コンバーター入力 (DSAD)

- [dsad.hpp](dsad.hpp?ts=4)

### LFQFP64

|DSAD/ANALOG|Port|
|---|---|
|ANDS0P|ANDS0P (48)|
|ANDS0N|ANDS0N (47)|
|ANDS1P|ANDS1P (50)|
|ANDS1N|ANDS1N (49)|
|ANDS2P|ANDS2P (--)|
|ANDS2N|ANDS2N (--)|
|ANDS3P|ANDS3P (--)|
|ANDS3N|ANDS3N (--)|
|ANDS4|ANDS4 (56)|
|ANDS5|ANDS5 (--)|
|ANDS6|ANDS6 (--)|

### LFQFP100

|DSAD/ANALOG|Port|
|---|---|
|ANDS0P|ANDS0P (75)|
|ANDS0N|ANDS0N (74)|
|ANDS1P|ANDS1P (77)|
|ANDS1N|ANDS1N (76)|
|ANDS2P|ANDS2P (79)|
|ANDS2N|ANDS2N (78)|
|ANDS3P|ANDS3P (81)|
|ANDS3N|ANDS3N (80)|
|ANDS4|ANDS4 (87)|
|ANDS5|ANDS5 (88)|
|ANDS6|ANDS6 (89)|

---

## rx_prog Flash Programming / rx_prog フラッシュプログラム

||Support/サポート|operation verification/動作検証|
|-|:-:|:-:|
|[rxprog](../rxprog)|-|-|

---

Translated with www.DeepL.com/Translator (free version)

---

## License

[MIT](../LICENSE)
