hirakuni45/RX/RX110/README.md

## RX110 features / 特徴

- RXv1 core / RXv1 コア
- Maximum operating frequency 32MHz / 最大動作周波数 32MHz
- 1.8V ～ 3.6V Operation / 動作
- 12 Bits A/D / １２ビットＡ／Ｄ変換器

### Package/パッケージ

|R5F5110---XX|Package/パッケージ|Pin/ピン数|Pitch/ピッチ|
|---|:-:|:-:|:-:|
|R5F5110xxxFM|LFQFP|64|0.50|
|R5F5110xxxFK|LQFP|64|0.80|
|R5F5110xxxLF|WFLGA|64|0.50|
|R5F5110xxxFL|LFQFP|48|0.50|
|R5F5110xxxNE|HWQFN|48|0.50|
|R5F5110xxxNF|HWQFN|40|0.50|
|R5F5110xxxLM|WFLGA|36|0.50|

### Ambient operating temperature/動作周囲温度

|R5F5110--X--|degree Celsius|
|---|:-:|
|R5F5110xxDxx|-40 ～ +85℃|
|R5F5110xxGxx|-40 ～ +105℃|

### Memoey size/メモリ容量

|R5F5110X----|CodeFlash|RAM|DataFlash|
|---|:-:|:-:|:-:|
|R5F51105xxxx|128K|16K|0K|
|R5F51104xxxx|96K|16K|0K|
|R5F51103xxxx|64K|10K|0K|
|R5F51101xxxx|32K|10K|0K|
|R5F5110Jxxxx|16K|8K|0K|
|R5F5110Hxxxx|8K|8K|0K|

### Data Flash/データ・フラッシュ

|Capacity|Erase Size|Blank Check Size|Write Size|Erase Value|ID|
|:-:|:-:|:-:|:-:|:-:|:-:|
|0K|-|-|-|-|4|

---

## RX110 Linker file / リンカーファイル

|Type|Code Flash|RAM|Data Flash|Linker File|Ustack|Istack|
|---|:-:|:-:|:-:|---|:-:|:-:|
|R5F51105|128K|16K|0K|[R5F51105.ld](R5F51105.ld?ts=4)|768|256|
|R5F51104|96K|16K|0K|[R5F51104.ld](R5F51104.ld?ts=4)|768|256|
|R5F51103|64K|10K|0K|[R5F51113.ld](R5F51103.ld?ts=4)|256|128|

---

## RX110 Dedicated class / 専用クラス

|Function/機能|Source|Remarks/備考|
|---|---|:-:|
|Peripheral Name/ペリフェラル名|[peripheral.hpp](peripheral.hpp?ts=4)||
|Hardware-specific Definition/ハード固有定義|[board_profile.hpp](board_profile.hpp?ts=4)||
|Operating Frequency Definition/動作周波数定義|[clock_profile.hpp](clock_profile.hpp?ts=4)||
|Power Control/電力制御|[power_mgr.hpp](power_mgr.hpp?ts=4)||
|Interrupt Definition/割り込み定義|[icu.hpp](icu.hpp?ts=4)||
|Port Function Definition/ポート機能定義|[mpc.hpp](mpc.hpp?ts=4)||
|Port Mapping/ポートマッピング|[port_map.hpp](port_map.hpp?ts=4)||
|Port Mapping IRQ/ポートマッピング IRQ|[port_map_irq.hpp](port_map_irq.hpp?ts=4)||
|Port Mapping MTU/ポートマッピング MTU|[port_map_mtu.hpp](port_map_mtu.hpp?ts=4)||
|FLASH Definition/FLASH 定義|[flash.hpp](flash.hpp?ts=4)||
|A/D Definition/A/D 定義|[s12adb.hpp](s12adb.hpp?ts=4)||
|System Definition/システム定義|[system.hpp](system.hpp?ts=4)||

---

## Basic Pin Assignments / 基本ピンアサイン

|Terminal/端子|LFQFP 64|
|---|---|
|VCL|VCL(13)|
|Reset Input/リセット入力|RES#(7)|
|Mode Controle/モード制御|MD/FINED(6)|
|B/UB|P14(20)|
|RXD|P15/RXD1(19)|
|TXD|P16/TXD1(18)|
|USB_VCC|VCC_USB(21)|
|USB_VSS|VSS_USB(24)|
|USB+|USB_DP(23)|
|USB-|USB_DM(22)|
|Power/電源|VCC(15), VCC(38)|
|GND/接地|VSS(14), VSS(40)|
|Analog Power/アナログ電源|AVCC0(63)|
|Analog GND/アナログ接地|AVSS0(62)|
|Analog Refarence L/アナログ基準電源Ｌ|VREFL0(59)|
|Analog Refarence H/アナログ基準電源Ｈ|VREFH0(61)|
|OSC out|XTAL(11)|
|OSC in|EXTAL(12)|
|Sub OSC out|XCOUT(8)|
|Sub OSC in|XCIN(9)|

- VCL: 4.7uF/25V

|Mode/モード|MD|
|---|:---:|
|Serial BOOT/シリアルブート|0|
|Single Chip/シングルチップ|1|

---

## Device, Renesas / デバイス、ルネサス

- [device.hpp (SIG_RX110)](../common/device.hpp?ts=4)
- [renesas.hpp (SIG_RX110)](../common/renesas.hpp?ts=4)

|name space|Device, Renesas|デバイス、ルネサス|
|---|---|---|
|[clock_profile](../RX110/clock_profile?ts=4)|Clock Profile|クロック・プロファイル|
|[SYSTEM](../RX111/system.hpp?ts=4)|Clock Generation Circuit|クロック発生回路|
|[power_mgr](../RX111/power_mgr.hpp?ts=4)|Low Power Consumption|消費電力低減機能|
|[ICU](../RX111/icu.hpp?ts=4)|Interrupt Controller|割り込みコントローラ|
|[icu_mgr](../RX111/icu_mgr.hpp?ts=4)|ICU Manager|ICU マネージャー|
|[MPC](../RX111/mpc.hpp?ts=4)|Multi-Function Pin Controller|マルチファンクションピンコントローラ|
|[PORTx](../RX111/port.hpp?ts=4)|I/O Ports|I/O ポート|
|[port_map](../RX111/port_map.hpp?ts=4)|Port Mapping|ポート・マッピング|
|[port_map_mtu](../RX111/port_map_mtu.hpp?ts=4)|Port Mapping MTU|ポート・マッピング MTU|
|[port_map_irq](../RX111/port_map_irq.hpp?ts=4)|Port Mapping IRQ|ポート・マッピング IRQ|
|[SYSTEM_IO](../RX140/system_io.hpp?ts=4)|System In/Out (Clock Setting)|システム In/Out (クロック設定)|
|[adc_in](../RX24T/adc_in.hpp?ts=4)|A/D Converter Input|A/D 変換入力|
|[board_profile](../RX110/board_profile?ts=4)|Board Profile|ボード・プロファイル|

---

## Peripheral / ペリフェラル

- [peripheral.hpp](../RX111/peripheral.hpp?ts=4)

|Peripheral|Function|機能|
|---|---|---|
|[CAC](../RX600/cac.hpp?ts=4)|Clock Frequency Accuracy Measurement Circuit|クロック周波数精度測定回路|
|[DTC](../RX600/dtc.hpp?ts=4)|Data Transfer Controller|データトランスファコントローラ|
|[ELC](../RX140/elc.hpp?ts=4)|Event Link Controller|イベントリンクコントローラ|
|[MTU0](../RX220/mtu2.hpp?ts=4)|Multi-Function Timer Pulse Unit 0|マルチファンクションタイマパルスユニット０|
|[MTU1](../RX220/mtu2.hpp?ts=4)|Multi-Function Timer Pulse Unit 1|マルチファンクションタイマパルスユニット１|
|[MTU2](../RX220/mtu2.hpp?ts=4)|Multi-Function Timer Pulse Unit 2|マルチファンクションタイマパルスユニット２|
|[MTU5](../RX220/mtu2.hpp?ts=4)|Multi-Function Timer Pulse Unit 5|マルチファンクションタイマパルスユニット５|
|[CMT0](../RX600/cmt.hpp?ts=4)|Compare Match Timer 0|コンペアマッチタイマ０|
|[CMT1](../RX600/cmt.hpp?ts=4)|Compare Match Timer 1|コンペアマッチタイマ１|
|[RTC](../RX140/rtc.hpp?ts=4)|Realtime Clock|リアルタイムクロック|
|[IWDT](../RX600/iwdt.hpp?ts=4)|Independent Watchdog Timer|独立ウォッチドッグタイマ|
|[SCI1](../RX600/sci_e.hpp?ts=4)|Serial Communications Interface 1|シリアルコミュニケーションインタフェース１|
|[SCI5](../RX600/sci_e.hpp?ts=4)|Serial Communications Interface 5|シリアルコミュニケーションインタフェース５|
|[SCI12](../RX600/sci_f.hpp?ts=4)|Serial Communications Interface 12|シリアルコミュニケーションインタフェース１２|
|[RIIC0](../RX600/riic.hpp?ts=4)|I2C-bus Interface 0|I2C バスインタフェース０|
|[RSPI0](../RX600/rspi.hpp?ts=4)|Serial Peripheral Interface 0|シリアルペリフェラルインタフェース０|
|[CRC](../RX600/crc.hpp?ts=4)|CRC Calculator|CRC 演算器|
|[S12AD](../RX111/s12adb.hpp?ts=4)|12-Bit A/D Converter|12 ビット A/D コンバータ|
|[DOC](../RX600/doc.hpp?ts=4)|Data Operation Circuit|データ演算回路|

---

## Port map order (IRQ) / ポートマップ候補 (IRQ)

- [port_map_irq.hpp](../RX111/port_map_irq.hpp?ts=4)

### LFQFP64

|IRQ|FIRST|SECOND|THIRD|
|---|---|---|---|
|IRQ0|P30 (4)|PE0 (51)|-|
|IRQ1|P31 (5)|PE1 (50)|-|
|IRQ2|P32 (16)|PB0 (39)|PC4 (30)|
|IRQ3|P27 (2)|PE3 (48)|PA6 (41)|
|IRQ4|P14 (20)|PB1 (37)|PE4 (47)|
|IRQ5|P15 (19)|PA4 (42)|PE5 (46)|
|IRQ6|P16 (18)|PA3 (43)|PE6 (53)|
|IRQ7|P17 (17)|PE2 (49)|PE7 (52)|

---

## Port map order / ポートマップ候補

- [port_map.hpp](../RX111/port_map.hpp?ts=4)

### LFQFP64

|Peripheral|FIRST|SECOND|THIRD|FOURTH|
|---|---|---|---|---|
|SCI1 / RXD|P15 (19)|P30 (4)|PC6 (28)|-|
|SCI1 / TXD|P16 (18)|P26 (3)|PC7 (27)|-|
|SCI1 / SCK|P17 (17)|P27 (2)|PC5 (29)|-|
|SCI5 / RXD|PA3 (43)|PC2 (32)|-|-|
|SCI5 / TXD|PA4 (42)|PC3 (31)|-|-|
|SCI5 / SCK|PA1 (44)|PC4 (30)|-|-|
|SCI12 / RXD|PE2 (49)|P17 (17)|-|-|
|SCI12 / TXD|PE1 (50)|P14 (20)|-|-|
|SCI12 / SCK|PE0 (51)|P27 (2)|-|-|
|RIIC0 / SCL|P16 (18)|PB0 (39)|-|-|
|RIIC0 / SDA|P17 (17)|PA6 (41)|-|-|
|RSPI0 / RSPCK|P15 (19)|PB0 (39)|PC5 (29)|PE3 (48)|
|RSPI0 / MOSI|P16 (18)|PA6 (41)|PC6 (28)|PE4 (47)|
|RSPI0 / MISO|P17 (17)|PA3 (43)|PC7 (27)|PA3 (43)|
|RSPI0 / SSL0|P14 (20)|PA4 (42)|PC4 (30)|-|
|RSPI0 / SSL1|PA0 (45)|-|-|-|
|RSPI0 / SSL2|PA1 (44)|-|-|-|
|RSPI0 / SSL3|PC2 (32)|-|-|-|

---

## Port map order (MTU) / ポートマップ候補 (MTU)

- [port_map_mtu.hpp](../RX111/port_map_mtu.hpp?ts=4)

### LFQFP64

|MTU|FIRST|SECOND|THIRD|FOURTH|
|---|---|---|---|---|
|MTIOC0A|P14 (20)|PB3 (36)|PE3 (48)|-|
|MTIOC0B|P15 (19)|PA1 (44)|-|-|
|MTIOC0C|P17 (17)|P32 (16)|PB0 (39)|PB1 (37)|
|MTIOC0D|PA3 (43)|-|-|-|
|MTIOC1A|PE4 (47)|-|-|-|
|MTIOC1B|PA3 (43)|PB5 (35)|PE3 (48)|-|
|MTIOC2A|P26 (3)|PA6 (41)|PB5 (35)|PE0 (51)|
|MTIOC2B|P27 (2)|PA4 (42)|PE5 (46)|-|
|MTIOC5U|PA4 (42)|-|-|-|
|MTIOC5V|PA6 (41)|-|-|-|
|MTIOC5W|PB0 (39)|-|-|-|
|MTCLKA|P14 (20)|PA4 (42)|PC6 (28)|-|
|MTCLKB|P15 (19)|PA6 (41)|PC7 (27)|-|
|MTCLKC|PA1 (44)|PC4 (30)|-|-|
|MTCLKD|PA3 (43)|PC5 (29)|-|-|

---

## 12 Bits A/D Converter input (S12AD) / 12 ビット A/D コンバーター入力 (S12AD)

- [s12adb.hpp](../RX111/s12adb.hpp?ts=4)

### LFQFP64

|S12AD/ANALOG|Port|
|---|---|
|AN000|P40 (60)|
|AN001|P41 (58)|
|AN002|P42 (57)|
|AN003|P43 (56)|
|AN004|P44 (55)|
|||
|AN006|P46 (54)|
|||
|AN008|PE0 (51)|
|AN009|PE1 (50)|
|AN010|PE2 (49)|
|AN011|PE3 (48)|
|AN012|PE4 (47)|
|AN013|PE5 (46)|
|AN014|PE6 (53)|
|AN015|PE7 (52)|

---

## rx_prog Flash Programming / rx_prog フラッシュプログラム

||Support/サポート|operation verification/動作検証|
|-|:-:|:-:|
|[rxprog](../rxprog)|||

---

Translated with www.DeepL.com/Translator (free version)

---

## License

[MIT](../LICENSE)
