hirakuni45/RX/RX660/README.md

## RX660 features / 特徴

- RXv3 core / RXv3 コア
- Maximum operating frequency 120MHz / 最大動作周波数 120MHz
- Single-precision 32-bit floating point / 32 ビット単精度浮動小数点
- 2.7V ～ 5.5V Operation / 動作
- CAN FD Module (CANFD) / CAN FD (CAN FD)
- 12 Bits A/D / １２ビットＡ／Ｄ変換器
- 12 Bits D/A / １２ビットＤ／Ａ変換器

### Package/パッケージ

|R5F5660---XX|Package/パッケージ|Pin/ピン数|Pitch/ピッチ|
|---|:-:|:-:|:-:|
|R5F5660xxxFB|LFQFP|144|0.50|
|R5F5660xxxFP|LFQFP|100|0.50|
|R5F5660xxxFN|LFQFP|80|0.50|
|R5F5660xxxFM|LFQFP|64|0.50|
|R5F5660xxxFL|LFQFP|48|0.50|

### Ambient operating temperature/動作周囲温度

|R5F5660--X--|degree Celsius|
|---|:-:|
|R5F5660xxDxx|-40 ～ +85℃|
|R5F5660xxGxx|-40 ～ +105℃|

### JTAG, Sub-clock, CAN

|R5F5660-X---|JTAG|Sub-clock|CAN|
|---|:-:|:-:|:-:|
|R5F5660xAxxx|-|-|2.0|
|R5F5660xBxxx|-|-|FD|
|R5F5660xCxxx|-|〇|2.0|
|R5F5660xDxxx|-|〇|FD|
|R5F5660xExxx|〇|-|2.0|
|R5F5660xFxxx|〇|-|FD|
|R5F5660xGxxx|〇|〇|2.0|
|R5F5660xHxxx|〇|〇|FD|

### Memoey size/メモリ容量

|R5F5660X----|Code Flash|RAM|Data Flash|
|---|:-:|:-:|:-:|
|R5F56609xxxx|1M|128K|32K|
|R5F56604xxxx|512K|128K|32K|

### Data Flash/データ・フラッシュ

|Capacity|Erase Size|Blank Check Size|Write Size|Erase Value|ID|
|:-:|:-:|:-:|:-:|:-:|:-:|
|32K|64|4/64|4|0x??|4|

---

## RX660 Linker file / リンカーファイル

|Type|Code Flash|RAM|Data Flash|Linker File|Ustack|Istack|
|---|:-:|:-:|:-:|---|:-:|:-:|
|R5F56609|1024K|128K|32K|[R5F56609.ld](R5F56609.ld?ts=4)|7168|1024|

---

## RX660 Dedicated class / 専用クラス

|Function/機能|Source|Remarks/備考|
|---|---|:-:|
|Peripheral Name/ペリフェラル名|[peripheral.hpp](peripheral.hpp?ts=4)||
|Hardware-specific Definition/ハード固有定義|[board_profile.hpp](board_profile.hpp?ts=4)||
|Operating Frequency Definition/動作周波数定義|[clock_profile.hpp](clock_profile.hpp?ts=4)||
|Power Control/電力制御|[power_mgr.hpp](power_mgr.hpp?ts=4)||
|Port Definition/ポート定義|[port.hpp](port.hpp?ts=4)||
|Interrupt Definition/割り込み定義|[icu.hpp](icu.hpp?ts=4)||
|Interrupt Management/割り込み管理|[icu_mgr.hpp](icu_mgr.hpp?ts=4)||
|Port Function Definition/ポート機能定義|[mpc.hpp](mpc.hpp?ts=4)||
|Port Mapping/ポートマッピング|[port_map.hpp](port_map.hpp?ts=4)||
|A/D Definition/A/D 定義|[s12adh.hpp](s12adh.hpp?ts=4)||

---

## Basic Pin Assignments / 基本ピンアサイン

|Terminal/端子|LFQFP 100|LFQFP 144|
|---|---|---|
|VCL|VCL(5)|VCL(14)|
|Reset Input/リセット入力|RES#(10)|RES#(19)|
|Mode Controle/モード制御|MD/FINED(7)|MD/FINED(16)|
|UB|PC7/UB(45)|PC7/UB(60)|
|EMLE|EMLE(2)|EMLE(10)|
|RXD|P30/RXD1(20)|P30/RXD1(29)|
|TXD|P26/TXD1(22)|P26/TXD1(31)|
|Power/電源|VCC(14), VCC(60)|VCC(23), VCC(59), VCC(74), VCC(91)|
|Power/電源||VCC(103), VCC(118), VCC(132)|
|GND/接地|VSS(12), VSS(62)|VSS(12), VSS(21), VSS(57), VSS(76)|
|GND/接地||VSS(93), VSS(105), VSS(116), VSS(130)|
|Analog Power/アナログ電源|AVCC0(97), AVCC1(1)|AVCC0(143), AVCC1(3)|
|Analog GND/アナログ接地|AVSS0(99), AVSS1(3)|AVSS0(1), AVSS1(5)|
|Analog Refarence L0/アナログ基準電源Ｌ0|VREFL0(94)|VREFL0(140)|
|Analog Refarence H0/アナログ基準電源Ｈ0|VREFH0(96)|VREFH0(142)|
|VBATT|VBATT(6)|VBATT(15)|
|OSC in|EXTAL(13)|EXTAL(22)|
|OSC out|XTAL(11)|XTAL(20)|
|Sub OSC in|XCIN(8)|XCIN(17)|
|Sub OSC out|XCOUT(9)|XCOUT(18)|

- VCL: 0.22uF/25V

|Mode/モード|UB|MD|
|---|:---:|:---:|:---:|
|Serial BOOT/シリアルブート|0|0|
|User Boot/ユーザーブート|1|0|
|Single Chip/シングルチップ|-|1|

---

## Device, Renesas / デバイス、ルネサス

- [device.hpp (SIG_RX660)](../common/device.hpp?ts=4)
- [renesas.hpp (SIG_RX660)](../common/renesas.hpp?ts=4)

|name space|Device, Renesas|デバイス、ルネサス|
|---|---|---|
|[clock_profile](../RX660/clock_profile?ts=4)|Clock Profile|クロック・プロファイル|
|[SYSTEM](../RX600/system.hpp?ts=4)|Clock Generation Circuit|クロック発生回路|
|[power_mgr](../RX660/power_mgr.hpp?ts=4)|Low Power Consumption|消費電力低減機能|
|[ICU](../RX660/icu.hpp?ts=4)|Interrupt Controller|割り込みコントローラ|
|[icu_mgr](../RX660/icu_mgr.hpp?ts=4)|ICU Manager|ICU マネージャー|
|[MPC](../RX660/mpc.hpp?ts=4)|Multi-Function Pin Controller|マルチファンクションピンコントローラ|
|[PORTx](../RX660/port.hpp?ts=4)|I/O Ports|I/O ポート|
|[port_map](../RX660/port_map.hpp?ts=4)|Port Mapping|ポート・マッピング|
|[port_map_mtu](../RX660/port_map_mtu.hpp?ts=4)|Port Mapping MTU|ポート・マッピング MTU|
|[port_map_tmr](../RX671/port_map_tmr.hpp?ts=4)|Port Mapping TMR|ポート・マッピング TMR|
|[port_map_irq](../RX671/port_map_irq.hpp?ts=4)|Port Mapping IRQ|ポート・マッピング IRQ|
|[FLASH](../RX600/flash.hpp?ts=4)|Flash Memory|フラッシュメモリ|
|[SYSTEM_IO](../RX600/system_io.hpp?ts=4)|System In/Out (Clock Setting)|システム In/Out (クロック設定)|
|[FLASH_IO](../RX600/flash_io.hpp?ts=4)|Flash In/Out|フラッシュ In/Out|
|[adc_in](../RX600/adc_in.hpp?ts=4)|A/D Converter Input|A/D 変換入力|
|[dac_out](../RX600/dac_out.hpp?ts=4)|D/A Converter Output|D/A 変換出力|
|[board_profile](../RX671/board_profile?ts=4)|Board Profile|ボード・プロファイル|

---

## Peripheral / ペリフェラル

- [peripheral.hpp](peripheral.hpp?ts=4)

|Peripheral|Function|機能|
|---|---|---|
|[CAC](../RX600/cac.hpp?ts=4)|Clock Frequency Accuracy Measurement Circuit|クロック周波数精度測定回路|
|[DMAC0](../RX600/dmac.hpp?ts=4)|DMA Controller channel 0|DMA コントローラ・チャネル０|
|[DMAC1](../RX600/dmac.hpp?ts=4)|DMA Controller channel 1|DMA コントローラ・チャネル１|
|[DMAC2](../RX600/dmac.hpp?ts=4)|DMA Controller channel 2|DMA コントローラ・チャネル２|
|[DMAC3](../RX600/dmac.hpp?ts=4)|DMA Controller channel 3|DMA コントローラ・チャネル３|
|[DMAC4](../RX600/dmac.hpp?ts=4)|DMA Controller channel 4|DMA コントローラ・チャネル４|
|[DMAC5](../RX600/dmac.hpp?ts=4)|DMA Controller channel 5|DMA コントローラ・チャネル５|
|[DMAC6](../RX600/dmac.hpp?ts=4)|DMA Controller channel 6|DMA コントローラ・チャネル６|
|[DMAC7](../RX600/dmac.hpp?ts=4)|DMA Controller channel 7|DMA コントローラ・チャネル７|
|[DTC](../RX600/dtc.hpp?ts=4)|Data Transfer Controller|データトランスファコントローラ|
|[ELC](../RX600/elc.hpp?ts=4)|Event Link Controller|イベントリンクコントローラ|
|[MTU0](../RX600/mtu3.hpp?ts=4)|Multi-Function Timer Pulse Unit 0|マルチファンクションタイマパルスユニット０|
|[MTU1](../RX600/mtu3.hpp?ts=4)|Multi-Function Timer Pulse Unit 1|マルチファンクションタイマパルスユニット１|
|[MTU2](../RX600/mtu3.hpp?ts=4)|Multi-Function Timer Pulse Unit 2|マルチファンクションタイマパルスユニット２|
|[MTU3](../RX600/mtu3.hpp?ts=4)|Multi-Function Timer Pulse Unit 3|マルチファンクションタイマパルスユニット３|
|[MTU4](../RX600/mtu3.hpp?ts=4)|Multi-Function Timer Pulse Unit 4|マルチファンクションタイマパルスユニット４|
|[MTU5](../RX600/mtu3.hpp?ts=4)|Multi-Function Timer Pulse Unit 5|マルチファンクションタイマパルスユニット５|
|[MTU6](../RX600/mtu3.hpp?ts=4)|Multi-Function Timer Pulse Unit 6|マルチファンクションタイマパルスユニット６|
|[MTU7](../RX600/mtu3.hpp?ts=4)|Multi-Function Timer Pulse Unit 7|マルチファンクションタイマパルスユニット７|
|[MTU8](../RX600/mtu3.hpp?ts=4)|Multi-Function Timer Pulse Unit 8|マルチファンクションタイマパルスユニット８|
|[POE3](../RX72N/poe3.hpp?ts=4)|Port Output Enable 3|ポートアウトプットイネーブル３|
|[TMR0](../RX600/tmr.hpp?ts=4)|8-Bit Timer 0|8 ビットタイマ０|
|[TMR1](../RX600/tmr.hpp?ts=4)|8-Bit Timer 1|8 ビットタイマ１|
|[TMR2](../RX600/tmr.hpp?ts=4)|8-Bit Timer 2|8 ビットタイマ２|
|[TMR3](../RX600/tmr.hpp?ts=4)|8-Bit Timer 3|8 ビットタイマ３|
|[CMT0](../RX600/cmt.hpp?ts=4)|Compare Match Timer 0|コンペアマッチタイマ０|
|[CMT1](../RX600/cmt.hpp?ts=4)|Compare Match Timer 1|コンペアマッチタイマ１|
|[CMT2](../RX600/cmt.hpp?ts=4)|Compare Match Timer 2|コンペアマッチタイマ２|
|[CMT3](../RX600/cmt.hpp?ts=4)|Compare Match Timer 3|コンペアマッチタイマ３|
|[CMTW0](../RX600/cmtw.hpp?ts=4)|Compare Match Timer W0|コンペアマッチタイマＷ０|
|[CMTW1](../RX600/cmtw.hpp?ts=4)|Compare Match Timer W1|コンペアマッチタイマＷ１|
|[RTC](../RX600/rtc.hpp?ts=4)|Realtime Clock|リアルタイムクロック|
|[WDTA](../RX600/wdta.hpp?ts=4)|Watchdog Timer|ウォッチドッグタイマ|
|[IWDT](../RX600/iwdt.hpp?ts=4)|Independent Watchdog Timer|独立ウォッチドッグタイマ|
|[USB0](../RX600/usb.hpp?ts=4)|USB 2.0 FS Host/Function Module 0|USB 2.0 FS ホスト/ファンクションモジュール０|
|[USB1](../RX600/usb.hpp?ts=4)|USB 2.0 FS Host/Function Module 1|USB 2.0 FS ホスト/ファンクションモジュール１|
|[SCI0](../RX600/sci_g.hpp?ts=4)|Serial Communications Interface 0|シリアルコミュニケーションインタフェース０|
|[SCI1](../RX600/sci_g.hpp?ts=4)|Serial Communications Interface 1|シリアルコミュニケーションインタフェース１|
|[SCI2](../RX600/sci_g.hpp?ts=4)|Serial Communications Interface 2|シリアルコミュニケーションインタフェース２|
|[SCI3](../RX600/sci_g.hpp?ts=4)|Serial Communications Interface 3|シリアルコミュニケーションインタフェース３|
|[SCI4](../RX600/sci_g.hpp?ts=4)|Serial Communications Interface 4|シリアルコミュニケーションインタフェース４|
|[SCI5](../RX600/sci_g.hpp?ts=4)|Serial Communications Interface 5|シリアルコミュニケーションインタフェース５|
|[SCI6](../RX600/sci_g.hpp?ts=4)|Serial Communications Interface 6|シリアルコミュニケーションインタフェース６|
|[SCI7](../RX600/sci_g.hpp?ts=4)|Serial Communications Interface 7|シリアルコミュニケーションインタフェース７|
|[SCI8](../RX600/sci_g.hpp?ts=4)|Serial Communications Interface 8|シリアルコミュニケーションインタフェース８|
|[SCI9](../RX600/sci_g.hpp?ts=4)|Serial Communications Interface 9|シリアルコミュニケーションインタフェース９|
|[SCI10](../RX600/sci_m.hpp?ts=4)|Serial Communications Interface 10|シリアルコミュニケーションインタフェース１０|
|[SCI11](../RX600/sci_m.hpp?ts=4)|Serial Communications Interface 11|シリアルコミュニケーションインタフェース１１|
|[SCI12](../RX600/sci_h.hpp?ts=4)|Serial Communications Interface 12|シリアルコミュニケーションインタフェース１２|
|[RSCI10](../RX600/rsci.hpp?ts=4)|(R)Serial Communications Interface 10|Ｒシリアルコミュニケーションインタフェース１０|
|[RSCI11](../RX600/rsci.hpp?ts=4)|(R)Serial Communications Interface 11|Ｒシリアルコミュニケーションインタフェース１１|
|[RIIC0](../RX600/riic.hpp?ts=4)|I2C-bus Interface 0|I2C バスインタフェース０|
|[RIIC2](../RX600/riic.hpp?ts=4)|I2C-bus Interface 2|I2C バスインタフェース２|
|[CANFD0](../RX600/canfd.hpp?ts=4)|CANFD-Lite Module 0|CANFD-Lite モジュール０|
|[RSPI0](../RX600/rspi.hpp?ts=4)|Serial Peripheral Interface 0|シリアルペリフェラルインタフェース０|
|[CRC](../RX600/crc.hpp?ts=4)|CRC Calculator|CRC 演算器|
|[REMC0](../RX600/remc.hpp?ts=4)|Remote Control Signal Receiver|リモコン信号受信機能|
|[S12AD](../RX660/s12adh.hpp?ts=4)|12-Bit A/D Converter|12 ビット A/D コンバータ|
|[R12DA](../RX600/r12da.hpp?ts=4)|12-Bit D/A Converter|12 ビット D/A コンバータ|
|[TEMPS](../RX600/system.hpp?ts=4)|Temperature Sensor|温度センサ|
|[CMPC0](../RX600/cmpc.hpp?ts=4)|Comparator C0|コンパレータＣ０|
|[CMPC1](../RX600/cmpc.hpp?ts=4)|Comparator C1|コンパレータＣ１|
|[CMPC2](../RX600/cmpc.hpp?ts=4)|Comparator C2|コンパレータＣ２|
|[CMPC3](../RX600/cmpc.hpp?ts=4)|Comparator C3|コンパレータＣ３|
|[DOC](../RX600/doc.hpp?ts=4)|Data Operation Circuit|データ演算回路|

---

## Port map order (IRQ) / ポートマップ候補 (IRQ)

- [port_map_irq.hpp](../RX671/port_map_irq.hpp?ts=4)

### LFQFP100

|IRQ|FIRST|SECOND|THIRD|FOURTH|FIFTH|SIXTH|SEVENTH|EIGHTH|
|---|---|---|---|---|---|---|---|---|
|IRQ0|P30 DS (20)|P50 (44)|P60 (---)|P70 (---)|P90 (---)|PA0 (70)|PD0 (86)|PH1 (37)|
|IRQ1|P31 DS (19)|P51 (43)|P61 (---)|P71 (---)|PD1 (85)|PH2 (36)|-|-|
|IRQ2|P32 DS (18)|P12 (34)|P52 (42)|P62 (---)|P82 (---)|PB2 (58)|PD2 (84)|-|
|IRQ3|P33 DS (17)|P13 (33)|P23 (25)|P53 (41)|P63 (---)|P83 (---)|PB3 (57)|PD3 (83)|
|IRQ4|PB1 DS (59)|P14 (32)|P34 (16)|P54 (---)|P64 (---)|PB4 (56)|PD4 (82)|PF5 (---)|
|IRQ5|PA4 DS (66)|P15 (31)|P25 (23)|PA5 (65)|PC5 (47)|PD5 (81)|PE5 (73)|-|
|IRQ6|PA3 DS (67)|P16 (30)|P26 (22)|P56 (---)|PB6 (54)|PD6 (80)|PE6 (72)|-|
|IRQ7|PE2 DS (76)|P17 (29)|P27 (21)|P77 (---)|PA7 (63)|PD7 (79)|PE7 (71)|-|
|IRQ8|P40 DS (95)|P00 (---)|P20 (28)|P73 (---)|P80 (---)|PE0 (78)|-|-|
|IRQ9|P41 DS (93)|P01 (---)|P21 (27)|P81 (---)|P91 (---)|PE1 (77)|-|-|
|IRQ10|P42 DS (92)|P02 (---)|P55 (39)|P72 (---)|P92 (---)|PA2 (68)|PC2 (50)|-|
|IRQ11|P43 DS (91)|P03 (---)|P93 (---)|PA1 (69)|PC3 (49)|PE3 (75)|PJ3 (4)|-|
|IRQ12|P44 DS (90)|P24 (24)|P74 (---)|PB0 (61)|PC1 (51)|PC4 (48)|PE4 (74)|-|
|IRQ13|P45 DS (89)|P05 (100)|P65 (---)|P75 (---)|PB5 (55)|PC6 (46)|PJ5 (---)|-|
|IRQ14|P46 DS (88)|P66 (---)|P76 (---)|P86 (---)|PA6 (64)|PC0 (52)|PC7 (45)|-|
|IRQ15|P47 DS (87)|P07 (98)|P22 (26)|P67 (---)|P87 (---)|PB7 (53)|-|-|

### LFQFP144

|IRQ|FIRST|SECOND|THIRD|FOURTH|FIFTH|SIXTH|SEVENTH|EIGHTH|
|---|---|---|---|---|---|---|---|---|
|IRQ0|P30 DS (29)|P50 (56)|P60 (117)|P70 (104)|P90 (131)|PA0 (97)|PD0 (126)|PH1 (48)|
|IRQ1|P31 DS (28)|P51 (55)|P61 (115)|P71 (86)|PD1 (125)|PH2 (47)|-|-|
|IRQ2|P32 DS (27)|P12 (45)|P52 (54)|P62 (114)|P82 (63)|PB2 (83)|PD2 (124)|-|
|IRQ3|P33 DS (26)|P13 (44)|P23 (34)|P53 (53)|P63 (113)|P83 (58)|PB3 (82)|PD3 (123)|
|IRQ4|PB1 DS (84)|P14 (43)|P34 (25)|P54 (52)|P64 (112)|PB4 (81)|PD4 (122)|PF5 (9)|
|IRQ5|PA4 DS (92)|P15 (42)|P25 (32)|PA5 (90)|PC5 (62)|PD5 (121)|PE5 (106)|-|
|IRQ6|PA3 DS (94)|P16 (40)|P26 (31)|P56 (50)|PB6 (79)|PD6 (120)|PE6 (102)|-|
|IRQ7|PE2 DS (109)|P17 (38)|P27 (30)|P77 (68)|PA7 (88)|PD7 (119)|PE7 (101)|-|
|IRQ8|P40 DS (141)|P00 (8)|P20 (37)|P73 (77)|P80 (65)|PE0 (111)|-|-|
|IRQ9|P41 DS (139)|P01 (7)|P21 (36)|P81 (64)|P91 (129)|PE1 (110)|-|-|
|IRQ10|P42 DS (138)|P02 (6)|P55 (51)|P72 (85)|P92 (128)|PA2 (95)|PC2 (70)|-|
|IRQ11|P43 DS (137)|P03 (4)|P93 (127)|PA1 (96)|PC3 (67)|PE3 (108)|PJ3 (13)|-|
|IRQ12|P44 DS (136)|P24 (33)|P74 (72)|PB0 (87)|PC1 (73)|PC4 (66)|PE4 (107)|-|
|IRQ13|P45 DS (135)|P05 (2)|P65 (100)|P75 (71)|PB5 (80)|PC6 (61)|PJ5 (11)|-|
|IRQ14|P46 DS (134)|P66 (99)|P76 (69)|P86 (41)|PA6 (89)|PC0 (75)|PC7 (68)|-|
|IRQ15|P47 DS (133)|P07 (144)|P22 (35)|P67 (98)|P87 (39)|PB7 (78)|-|-|

---

## Port map order / ポートマップ候補

- [port_map.hpp](port_map.hpp?ts=4)

### LFQFP100

|Peripheral|FIRST|SECOND|THIRD|FOURTH|
|---|---|---|---|---|
|SCI0 / RXD|P21 (27)|P33 (17)|-|-|
|SCI0 / TXD|P20 (28)|P32 (18)|-|-|
|SCI0 / SCK|P22 (26)|P34 (16)|-|-|
|SCI1 / RXD|P15 (31)|P30 (20)|-|-|
|SCI1 / TXD|P16 (30)|P26 (22)|-|-|
|SCI1 / SCK|P17 (29)|P27 (21)|-|-|
|SCI2 / RXD|P12 (34)|P52 (42)|-|-|
|SCI2 / TXD|P13 (33)|P50 (44)|-|-|
|SCI2 / SCK|P51 (43)|P51 (43)|-|-|
|SCI3 / RXD|P16 (30)|P25 (23)|-|-|
|SCI3 / TXD|P17 (29)|P23 (25)|-|-|
|SCI3 / SCK|P15 (31)|P24 (24)|-|-|
|SCI4 / RXD|PB0 (61)|-|-|-|
|SCI4 / TXD|PB1 (59)|-|-|-|
|SCI4 / SCK|PB3 (57)|-|-|-|
|SCI5 / RXD|PA2 (68)|PA3 (67)|PC2 (50)|PC2 (50)|
|SCI5 / TXD|PA4 (66)|PA4 (66)|PC3 (49)|PC3 (49)|
|SCI5 / SCK|PA1 (69)|PA1 (69)|PC1 (51)|PC4 (48)|
|SCI6 / RXD|P01 (---)|P33 (17)|PB0 (61)|-|
|SCI6 / TXD|P00 (---)|P32 (18)|PB1 (59)|-|
|SCI6 / SCK|P02 (---)|P34 (16)|PB3 (57)|-|
|SCI7 / RXD|P92 (---)|P92 (---)|-|-|
|SCI7 / TXD|P90 (---)|P55 (39)|-|-|
|SCI7 / SCK|P91 (---)|P56 (---)|-|-|
|SCI8 / RXD|PC6 (46)|-|-|-|
|SCI8 / TXD|PC7 (45)|-|-|-|
|SCI8 / SCK|PC5 (47)|-|-|-|
|SCI9 / RXD|PB6 (54)|-|-|-|
|SCI9 / TXD|PB7 (53)|-|-|-|
|SCI9 / SCK|PB5 (55)|-|-|-|
|SCI10 / RXD|P81 (---)|P86 (---)|PC6 (46)|-|
|SCI10 / TXD|P82 (---)|P87 (---)|PC7 (45)|-|
|SCI10 / SCK|P80 (---)|P83 (---)|PC5 (47)|-|
|SCI11 / RXD|P76 (---)|PB6 (54)|-|-|
|SCI11 / TXD|P77 (---)|PB7 (53)|-|-|
|SCI11 / SCK|P75 (---)|PB5 (55)|-|-|
|SCI12 / RXD|PE2 (76)|PA2 (68)|-|-|
|SCI12 / TXD|PE1 (77)|PA4 (66)|-|-|
|SCI12 / SCK|PE0 (78)|PA1 (69)|-|-|
|RSCI10 / RXD|P81 (---)|P86 (---)|PC6 (46)|-|
|RSCI10 / TXD|P82 (---)|P87 (---)|PC7 (45)|-|
|RSCI10 / SCK|P80 (---)|P83 (---)|PC5 (47)|-|
|RSCI10 / DE|P80 (---)|-|-|-|
|RSCI11 / RXD|P76 (---)|PB6 (54)|PC0 (52)|-|
|RSCI11 / TXD|P77 (---)|PB7 (53)|PC1 (51)|-|
|RSCI11 / SCK|P75 (---)|PB5 (55)|PB5 (55)|-|
|RSCI11 / DE|P75 (---)|-|-|-|
|RIIC0 / SCL|P12 (34)|-|-|-|
|RIIC0 / SDA|P13 (33)|-|-|-|
|RIIC2 / SCL|P16 (30)|-|-|-|
|RIIC2 / SDA|P17 (29)|-|-|-|
|CANFD0 / CRX|P15 (31)|P33 (17)|P55 (39)|PD2 (84)|
|CANFD0 / CTX|P14 (32)|P32 (18)|P54 (40)|PD1 (85)|
|RSPI0 / RSPCK|PA5 (65)|PC5 (47)|-|-|
|RSPI0 / MOSI|PA6 (64)|PC6 (46)|-|-|
|RSPI0 / MISO|PA7 (63)|PC7 (45)|-|-|
|RSPI0 / SSL0|PA4 (66)|PC4 (48)|-|-|
|RSPI0 / SSL1|PA0 (70)|PC0 (52)|-|-|
|RSPI0 / SSL2|PA1 (69)|PC1 (51)|-|-|
|RSPI0 / SSL3|PA2 (68)|PC2 (50)|-|-|

### LFQFP144

|Peripheral|FIRST|SECOND|THIRD|FOURTH|
|---|---|---|---|---|
|SCI0 / RXD|P21 (36)|P33 (26)|-|-|
|SCI0 / TXD|P20 (37)|P32 (27)|-|-|
|SCI0 / SCK|P22 (35)|P34 (25)|-|-|
|SCI1 / RXD|P15 (42)|P30 (29)|-|-|
|SCI1 / TXD|P16 (40)|P26 (31)|-|-|
|SCI1 / SCK|P17 (38)|P27 (30)|-|-|
|SCI2 / RXD|P12 (45)|P52 (54)|-|-|
|SCI2 / TXD|P13 (44)|P50 (56)|-|-|
|SCI2 / SCK|P51 (55)|P51 (55)|-|-|
|SCI3 / RXD|P16 (40)|P25 (32)|-|-|
|SCI3 / TXD|P17 (38)|P23 (34)|-|-|
|SCI3 / SCK|P15 (42)|P24 (33)|-|-|
|SCI4 / RXD|PB0 (87)|-|-|-|
|SCI4 / TXD|PB1 (84)|-|-|-|
|SCI4 / SCK|PB3 (82)|-|-|-|
|SCI5 / RXD|PA2 (95)|PA3 (94)|PC2 (70)|PC2 (70)|
|SCI5 / TXD|PA4 (92)|PA4 (92)|PC3 (67)|PC3 (67)|
|SCI5 / SCK|PA1 (96)|PA1 (96)|PC1 (73)|PC4 (66)|
|SCI6 / RXD|P01 (7)|P33 (26)|PB0 (87)|-|
|SCI6 / TXD|P00 (8)|P32 (27)|PB1 (84)|-|
|SCI6 / SCK|P02 (6)|P34 (25)|PB3 (82)|-|
|SCI7 / RXD|P92 (128)|P92 (128)|-|-|
|SCI7 / TXD|P90 (131)|P55 ( 51)|-|-|
|SCI7 / SCK|P91 (129)|P56 ( 50)|-|-|
|SCI8 / RXD|PC6 (61)|-|-|-|
|SCI8 / TXD|PC7 (60)|-|-|-|
|SCI8 / SCK|PC5 (62)|-|-|-|
|SCI9 / RXD|PB6 (79)|-|-|-|
|SCI9 / TXD|PB7 (78)|-|-|-|
|SCI9 / SCK|PB5 (80)|-|-|-|
|SCI10 / RXD|P81 (64)|P86 (41)|PC6 (61)|-|
|SCI10 / TXD|P82 (63)|P87 (39)|PC7 (60)|-|
|SCI10 / SCK|P80 (65)|P83 (58)|PC5 (62)|-|
|SCI11 / RXD|P76 (69)|PB6 (79)|-|-|
|SCI11 / TXD|P77 (68)|PB7 (78)|-|-|
|SCI11 / SCK|P75 (71)|PB5 (80)|-|-|
|SCI12 / RXD|PE2 (109)|PA2 (95)|-|-|
|SCI12 / TXD|PE1 (110)|PA4 (92)|-|-|
|SCI12 / SCK|PE0 (111)|PA1 (96)|-|-|
|RSCI10 / RXD|PB6 (79)|P86 (41)|PC6 (61)|-|
|RSCI10 / TXD|PB7 (78)|P87 (39)|PC7 (60)|-|
|RSCI10 / SCK|PB5 (80)|P83 (58)|PC5 (62)|-|
|RSCI10 / DE|P80 (65)|-|-|-|
|RSCI11 / RXD|P76 (69)|PB6 (79)|PC0 (75)|-|
|RSCI11 / TXD|P77 (68)|PB7 (78)|PC1 (73)|-|
|RSCI11 / SCK|P75 (71)|PB5 (80)|PB5 (80)|-|
|RSCI11 / DE|P75 (71)|-|-|-|
|RIIC0 / SCL|P12 (45)|-|-|-|
|RIIC0 / SDA|P13 (44)|-|-|-|
|RIIC2 / SCL|P16 (40)|-|-|-|
|RIIC2 / SDA|P17 (38)|-|-|-|
|CANFD0 / CRX|P15 (42)|P33 (26)|P55 (51)|PD2 (124)|
|CANFD0 / CTX|P14 (43)|P32 (27)|P54 (52)|PD1 (125)|
|RSPI0 / RSPCK|PA5 (90)|PC5 (62)|-|-|
|RSPI0 / MOSI|PA6 (89)|PC6 (61)|-|-|
|RSPI0 / MISO|PA7 (88)|PC7 (60)|-|-|
|RSPI0 / SSL0|PA4 (92)|PC4 (66)|-|-|
|RSPI0 / SSL1|PA0 (97)|PC0 (75)|-|-|
|RSPI0 / SSL2|PA1 (96)|PC1 (73)|-|-|
|RSPI0 / SSL3|PA2 (95)|PC2 (70)|-|-|

---

## Port map order (MTU) / ポートマップ候補 (MTU)

- [port_map_mtu.hpp](port_map_mtu.hpp?ts=4)

### LFQFP100

|MTU|FIRST|SECOND|THIRD|FOURTH|FIFTH|SIXTH|SEVENTH|EIGHTH|
|---|---|---|---|---|---|---|---|---|
|MTIOC0A|P34 (16)|PB3 (57)|PC4 (48)|-|-|-|-|-|
|MTIOC0B|P13 (33)|P15 (31)|PA1 (69)|-|-|-|-|-|
|MTIOC0C|P32 (18)|PB1 (59)|PC5 (47)|-|-|-|-|-|
|MTIOC0D|P33 (17)|PA3 (67)|-|-|-|-|-|-|
|MTIOC1A|P20 (28)|PE4 (74)|-|-|-|-|-|-|
|MTIOC1B|P21 (27)|PB5 (55)|PE3 (75)|-|-|-|-|-|
|MTIOC2A|P26 (22)|PB5 (55)|-|-|-|-|-|-|
|MTIOC2B|P27 (21)|PE5 (73)|-|-|-|-|-|-|
|MTIOC3A|P14 (32)|P17 (29)|PC1 (51)|PC7 (45)|PJ1 (6)|-|-|-|
|MTIOC3B|P17 (29)|P22 (26)|P80 (---)|PA1 (69)|PB7 (53)|PC5 (47)|PE1 (77)|PH0 (---)|
|MTIOC3C|P16 (30)|P56 (---)|PC0 (52)|PC6 (46)|PJ3 (4)|-|-|-|
|MTIOC3D|P16 (30)|P23 (25)|P81 (---)|PA6 (64)|PB6 (54)|PC4 (48)|PE0 (78)|PH1 (---)|
|MTIOC4A|P21 (27)|P24 (24)|P55 (39)|P82 (---)|PA0 (70)|PB3 (57)|PE2 (76)|PE4 (74)|
|MTIOC4B|P17 (29)|P30 (20)|P54 (40)|PC2 (50)|PD1 (85)|PE3 (75)|-|-|
|MTIOC4C|P25 (23)|P83 (---)|P87 (---)|PA4 (63)|PB1 (59)|PE1 (77)|PE5 (73)|PH2 (---)|
|MTIOC4D|P31 (19)|P55 (39)|P86 (---)|PA3 (67)|PC3 (49)|PD2 (84)|PE4 (74)|PH3 (---)|
|MTIC5U|P12 (34)|PA4 (66)|PD7 (79)|-|-|-|-|-|
|MTIC5V|PA3 (67)|PA6 (64)|PD6 (80)|-|-|-|-|-|
|MTIC5W|PB0 (61)|PD5 (81)|-|-|-|-|-|-|
|MTIOC6A|PE7 (71)|-|-|-|-|-|-|-|
|MTIOC6B|PA5 (65)|PA6 (64)|-|-|-|-|-|-|
|MTIOC6C|PE6 (72)|-|-|-|-|-|-|-|
|MTIOC6D|PA0 (70)|-|-|-|-|-|-|-|
|MTIOC7A|PA2 (68)|PE2 (76)|-|-|-|-|-|-|
|MTIOC7B|PA1 (69)|-|-|-|-|-|-|-|
|MTIOC7C|P67 (---)|PA4 (66)|-|-|-|-|-|-|
|MTIOC7D|P66 (---)|PE4 (74)|-|-|-|-|-|-|
|MTIOC8A|PD6 (80)|-|-|-|-|-|-|-|
|MTIOC8B|PD4 (82)|-|-|-|-|-|-|-|
|MTIOC8C|PD5 (81)|-|-|-|-|-|-|-|
|MTIOC8D|PD3 (83)|-|-|-|-|-|-|-|
|MTCLKA|P14 (32)|P24 (24)|PA4 (66)|PC6 (46)|-|-|-|-|
|MTCLKB|P15 (31)|P25 (23)|PA6 (64)|PC7 (45)|-|-|-|-|
|MTCLKC|P22 (26)|PA1 (69)|PC4 (48)|-|-|-|-|-|
|MTCLKD|P23 (25)|PA3 (67)|PC5 (47)|-|-|-|-|-|

### LFQFP144

|MTU|FIRST|SECOND|THIRD|FOURTH|FIFTH|SIXTH|SEVENTH|EIGHTH|
|---|---|---|---|---|---|---|---|---|
|MTIOC0A|P34 (25)|PB3 (82)|PC4 (66)|-|-|-|-|-|
|MTIOC0B|P13 (44)|P15 (42)|PA1 (96)|-|-|-|-|-|
|MTIOC0C|P32 (27)|PB1 (84)|PC5 (62)|-|-|-|-|-|
|MTIOC0D|P33 (26)|PA3 (94)|-|-|-|-|-|-|
|MTIOC1A|P20 (37)|PE4 (107)|-|-|-|-|-|-|
|MTIOC1B|P21 (36)|PB5 (80)|PE3 (108)|-|-|-|-|-|
|MTIOC2A|P26 (31)|PB5 (80)|-|-|-|-|-|-|
|MTIOC2B|P27 (30)|PE5 (106)|-|-|-|-|-|-|
|MTIOC3A|P14 (43)|P17 (38)|PC1 (73)|PC7 (60)|PJ1 (15)|-|-|-|
|MTIOC3B|P17 (38)|P22 (35)|P80 (65)|PA1 (96)|PB7 (78)|PC5 (62)|PE1 (110)|PH0 (49)|
|MTIOC3C|P16 (40)|P56 (50)|PC0 (75)|PC6 (61)|PJ3 (13)|-|-|-|
|MTIOC3D|P16 (40)|P23 (34)|P81 (64)|PA6 (89)|PB6 (79)|PC4 (66)|PE0 (111)|PH1 (48)|
|MTIOC4A|P21 (36)|P24 (33)|P55 (51)|P82 (63)|PA0 (97)|PB3 (82)|PE2 (109)|PE4 (107)|
|MTIOC4B|P17 (38)|P30 (29)|P54 (52)|PC2 (70)|PD1 (125)|PE3 (108)|-|-|
|MTIOC4C|P25 (32)|P83 (58)|P87 (39)|PA4 (92)|PB1 (84)|PE1 (110)|PE5 (106)|PH2 (47)|
|MTIOC4D|P31 (28)|P55 (51)|P86 (41)|PA3 (94)|PC3 (67)|PD2 (124)|PE4 (107)|PH3 (46)|
|MTIC5U|P12 (45)|PA4 (92)|PD7 (119)|-|-|-|-|-|
|MTIC5V|PA3 (94)|PA6 (89)|PD6 (120)|-|-|-|-|-|
|MTIC5W|PB0 (87)|PD5 (121)|-|-|-|-|-|-|
|MTIOC6A|PE7 (101)|-|-|-|-|-|-|-|
|MTIOC6B|PA5 (90)|PA6 (89)|-|-|-|-|-|-|
|MTIOC6C|PE6 (102)|-|-|-|-|-|-|-|
|MTIOC6D|PA0 (97)|-|-|-|-|-|-|-|
|MTIOC7A|PA2 (95)|PE2 (109)|-|-|-|-|-|-|
|MTIOC7B|PA1 (96)|-|-|-|-|-|-|-|
|MTIOC7C|P67 (98)|PA4 (92)|-|-|-|-|-|-|
|MTIOC7D|P66 (99)|PE4 (107)|-|-|-|-|-|-|
|MTIOC8A|PD6 (120)|-|-|-|-|-|-|-|
|MTIOC8B|PD4 (122)|-|-|-|-|-|-|-|
|MTIOC8C|PD5 (121)|-|-|-|-|-|-|-|
|MTIOC8D|PD3 (123)|-|-|-|-|-|-|-|
|MTCLKA|P14 (43)|P24 (33)|PA4 (92)|PC6 (61)|-|-|-|-|
|MTCLKB|P15 (42)|P25 (32)|PA6 (89)|PC7 (60)|-|-|-|-|
|MTCLKC|P22 (35)|PA1 (96)|PC4 (66)|-|-|-|-|-|
|MTCLKD|P23 (34)|PA3 (94)|PC5 (62)|-|-|-|-|-|

---

## Port map order (TMR) / ポートマップ候補 (TMR)

- [port_map_tmr.hpp](../RX671/port_map_tmr.hpp?ts=4)

### LFQFP100

|TMR|FIRST|SECOND|THIRD|FOURTH|
|---|---|---|---|---|
|TMO0|P22 (26)|PB3 (57)|PH1 (37)|-|
|TMCI0|P01 (---)|P21 (27)|PB1 (59)|PH3 (35)|
|TMRI0|P00 (---)|P20 (28)|PA4 (66)|PH2 (36)|
|TMO1|P17 (29)|P26 (22)|-|-|
|TMCI1|P02 (---)|P12 (34)|P54 (40)|PC4 (48)|
|TMRI1|P24 (24)|PB5 (55)|-|-|
|TMO2|P16 (30)|PC7 (45)|-|-|
|TMCI2|P15 (31)|P31 (19)|PC6 (46)|-|
|TMRI2|P14 (32)|PC5 (47)|-|-|
|TMO3|P13 (33)|P32 (18)|P55 (39)|-|
|TMCI3|P27 (21)|P34 (16)|PA6 (64)|-|
|TMRI3|P30 (20)|P33 (17)|-|-|

### LFQFP144

|TMR|FIRST|SECOND|THIRD|FOURTH|
|---|---|---|---|---|
|TMO0|P22 (35)|PB3 (82)|PH1 (48)|-|
|TMCI0|P01 (7)|P21 (36)|PB1 (84)|PH3 (46)|
|TMRI0|P00 (8)|P20 (37)|PA4 (92)|PH2 (47)|
|TMO1|P17 (38)|P26 (31)|-|-|
|TMCI1|P02 (6)|P12 (45)|P54 (52)|PC4 (66)|
|TMRI1|P24 (33)|PB5 (80)|-|-|
|TMO2|P16 (40)|PC7 (60)|-|-|
|TMCI2|P15 (42)|P31 (28)|PC6 (61)|-|
|TMRI2|P14 (43)|PC5 (62)|-|-|
|TMO3|P13 (44)|P32 (27)|P55 (51)|-|
|TMCI3|P27 (30)|P34 (25)|PA6 (89)|-|
|TMRI3|P30 (29)|P33 (26)|-|-|

---

## 12 Bits A/D Converter input (S12AD) / 12 ビット A/D コンバーター入力 (S12AD)

- [s12adh.hpp](s12adh.hpp?ts=4)

### LFQFP100

|S12AD/ANALOG|Port|
|---|---|
|AN000|P40 (95)|
|AN001|P41 (93)|
|AN002|P42 (92)|
|AN003|P43 (91)|
|AN004|P44 (90)|
|AN005|P45 (89)|
|AN006|P46 (88)|
|AN007|P47 (87)|
|AN008|PE0 (78)|
|AN009|PE1 (77)|
|AN010|PE2 (76)|
|AN011|PE3 (75)|
|AN012|PE4 (74)|
|AN013|PE5 (73)|
|AN014|PE6 (72)|
|AN015|PE7 (71)|
|AN016|PD0 (86)|
|AN017|PD1 (85)|
|AN018|PD2 (84)|
|AN019|PD3 (83)|
|AN020|PD4 (82)|
|AN021|PD5 (81)|
|AN022|PD6 (80)|
|AN023|PD7 (79)|

### LFQFP144

|S12AD/ANALOG|Port|
|---|---|
|AN000|P40 (141)|
|AN001|P41 (139)|
|AN002|P42 (138)|
|AN003|P43 (137)|
|AN004|P44 (136)|
|AN005|P45 (135)|
|AN006|P46 (134)|
|AN007|P47 (133)|
|AN008|PE0 (111)|
|AN009|PE1 (110)|
|AN010|PE2 (109)|
|AN011|PE3 (108)|
|AN012|PE4 (107)|
|AN013|PE5 (106)|
|AN014|PE6 (102)|
|AN015|PE7 (101)|
|AN016|PD0 (126)|
|AN017|PD1 (125)|
|AN018|PD2 (124)|
|AN019|PD3 (123)|
|AN020|PD4 (122)|
|AN021|PD5 (121)|
|AN022|PD6 (120)|
|AN023|PD7 (119)|

---

## 12 Bits D/A Converter output (R12DA) / 12 ビット D/A コンバーター出力 (R12DA)

- [r12da.hpp](../RX600/r12da.hpp?ts=4)

### LFQFP100

|R12DA/ANALOG|Port|
|---|---|
|DA0|P03 (---)|
|DA1|P05 (100)|

### LFQFP144

|R12DA/ANALOG|Port|
|---|---|
|DA0|P03 (4)|
|DA1|P05 (2)|

### LFQFP176

|R12DA/ANALOG|Port|
|---|---|
|DA0|P03 (4)|
|DA1|P05 (2)|

---

## rx_prog Flash Programming / rx_prog フラッシュプログラム

||Support/サポート|operation verification/動作検証|
|-|:-:|:-:|
|[rxprog](../rxprog)|-|-|

---

Translated with www.DeepL.com/Translator (free version)

---

## License

[MIT](../LICENSE)
