hirakuni45/RX/RX63T/README.md

## RX63T features / 特徴

- RXv1 core / RXv1 コア
- Maximum operating frequency 100MHz / 最大動作周波数 100MHz
- Single-precision 32-bit floating point / 32 ビット単精度浮動小数点
- 3.3V ～ 5.0V Operation / 動作
- 12 Bits A/D / １２ビットＡ／Ｄ変換器
- 10 Bits D/A / １０ビットＤ／Ａ変換器

### Package/パッケージ

|R5F563T---XX|Package/パッケージ|Pin/ピン数|Pitch/ピッチ|
|---|:-:|:-:|:-:|
|R5F563TxxxFB|LFQFP|144|0.50|
|R5F563TxxxFP|LFQFP|100|0.50|
|R5F563TxxxFP|LFQFP|100|0.50|
|R5F563TxxxFP|LFQFP|100|0.50|
|R5F563TxxxFP|LFQFP|100|0.50|
|R5F563TxxxFP|LFQFP|100|0.50|

### Ambient operating temperature/動作周囲温度

|R5F563T--X--|degree Celsius|
|---|:-:|
|R5F563TxxDxx|-40 ～ +85℃|
|R5F563TxxGxx|-40 ～ +105℃|

### VCC, CAN

|R5F563T-X---|VCC|CAN|
|---|:-:|:-:|
|R5F563TxAxxx|5V|〇|
|R5F563TxBxxx|3V|〇|
|R5F563TxDxxx|5V|-|
|R5F563TxExxx|3V|-|

### Memoey size/メモリ容量

|R5F563TX----|CodeFlash|RAM|DataFlash|
|---|:-:|:-:|:-:|
|R5F563TExxxx|512K|48K|32K|
|R5F563TCxxxx|384K|32K|32K|
|R5F563TBxxxx|256K|24K|32K|
|R5F563T6xxxx|64K|8K|8K|
|R5F563T5xxxx|48K|8K|8K|
|R5F563T4xxxx|32K|8K|8K|

### Data Flash/データ・フラッシュ

|Capacity|Erase Size|Blank Check Size|Write Size|Erase Value|ID|
|:-:|:-:|:-:|:-:|:-:|:-:|
|8K/32K|32|2/32|2|0x??|0|

---

## RX63T Linker file / リンカーファイル

|Type|Code Flash|RAM|Data Flash|Linker File|Ustack|Istack|
|---|:-:|:-:|:-:|---|:-:|:-:|
|R5F563T6|64K|8K|8K|[R5F563T6.ld](R5F563T6.ld?ts=4)|768|256|

---

## RX63T Dedicated class / 専用クラス

|Function/機能|Source|Remarks/備考|
|---|---|:-:|
|Peripheral Name/ペリフェラル名|[peripheral.hpp](peripheral.hpp?ts=4)||
|Hardware-specific Definition/ハード固有定義|[board_profile.hpp](board_profile.hpp?ts=4)||
|Operating Frequency Definition/動作周波数定義|[clock_profile.hpp](clock_profile.hpp?ts=4)||
|Power Control/電力制御|[power_mgr.hpp](power_mgr.hpp?ts=4)||
|Port Definition/ポート定義|[port.hpp](port.hpp?ts=4)||
|Interrupt Definition/割り込み定義|[icu.hpp](icu.hpp?ts=4)||
|Interrupt Management/割り込み管理|[icu_mgr.hpp](icu_mgr.hpp?ts=4)||
|Port Function Definition/ポート機能定義|[mpc.hpp](mpc.hpp?ts=4)||
|Port Mapping/ポートマッピング|[port_map.hpp](port_map.hpp?ts=4)||
|Port Mapping IRQ/ポートマッピング IRQ|[port_map_irq.hpp](port_map_irq.hpp?ts=4)||
|Port Mapping MTU/ポートマッピング MTU|[port_map_mtu.hpp](port_map_mtu.hpp?ts=4)||
|Port Mapping GPT/ポートマッピング GPT|[port_map_gpt.hpp](port_map_gpt.hpp?ts=4)||
|A/D Definition/A/D 定義|[ad.hpp](ad.hpp?ts=4)||
|BUS Definition/BUS 定義|[bus.hpp](bus.hpp?ts=4)||
|D/A Definition/D/A 定義|[da.hpp](da.hpp?ts=4)||
|DPC Definition/DPC 定義|[dpc.hpp](dpc.hpp?ts=4)||
|FLASH Definition/FLASH 定義|[flash.hpp](flash.hpp?ts=4)||
|GPT Definition/GPT 定義|[gpt.hpp](gpt.hpp?ts=4)||
|LVDA Definition/LVDA 定義|[lvda.hpp](lvda.hpp?ts=4)||
|POE3 Definition/POE3 定義|[poe3.hpp](poe3.hpp?ts=4)||
|A/D Definition/A/D 定義|[s12adb.hpp](s12adb.hpp?ts=4)||
|System Definition/システム定義|[system.hpp](system.hpp?ts=4)||
|System I/O Definition/システム I/O 定義|[system_io.hpp](system_io.hpp?ts=4)||

---

## Basic Pin Assignments / 基本ピンアサイン

|Terminal/端子|LQFP 64|
|---|---|---|
|VCL|VCL(3)|
|Reset Input/リセット入力|RES#(6)|
|Mode Controle/モード制御|MD/FINED(5)|
|EMLE|EMLE(1)|
|RXD|PD5/RXD1(14)|
|TXD|PD3/TXD1(16)|
|Power/電源|VCC(10), VCC(20), VCC(42)|
|GND/接地|VSS(8), VSS(22), VSS(44)|
|Analog Power/アナログ電源|AVCC0(57)|
|Analog GND/アナログ接地|AVSS0(60)|
|Analog Refarence H/アナログ基準電源 H|VREFH0(58)|
|Analog Refarence L/アナログ基準電源 L|VREFL0(59)|
|OSC in|EXTAL(9)|
|OSC out|XTAL(7)|

- VCL: 0.1uF/25V

|Mode/モード|MD|
|---|:---:|
|Serial BOOT/シリアルブート|0|
|Single Chip/シングルチップ|1|

---

## Device, Renesas / デバイス、ルネサス

- [device.hpp (SIG_RX63T)](../common/device.hpp?ts=4)
- [renesas.hpp (SIG_RX63T)](../common/renesas.hpp?ts=4)

|name space|Device, Renesas|デバイス、ルネサス|
|---|---|---|
|[clock_profile](../RX63T/clock_profile?ts=4)|Clock Profile|クロック・プロファイル|
|[SYSTEM](../RX63T/system.hpp?ts=4)|Clock Generation Circuit|クロック発生回路|
|[power_mgr](../RX63T/power_mgr.hpp?ts=4)|Low Power Consumption|消費電力低減機能|
|[ICU](../RX63T/icu.hpp?ts=4)|Interrupt Controller|割り込みコントローラ|
|[icu_mgr](../RX63T/icu_mgr.hpp?ts=4)|ICU Manager|ICU マネージャー|
|[MPC](../RX63T/mpc.hpp?ts=4)|Multi-Function Pin Controller|マルチファンクションピンコントローラ|
|[PORTx](../RX63T/port.hpp?ts=4)|I/O Ports|I/O ポート|
|[port_map](../RX63T/port_map.hpp?ts=4)|Port Mapping|ポート・マッピング|
|[port_map_mtu](../RX63T/port_map_mtu.hpp?ts=4)|Port Mapping MTU|ポート・マッピング MTU|
|[port_map_gpt](../RX63T/port_map_gpt.hpp?ts=4)|Port Mapping GPT|ポート・マッピング GPT|
|[port_map_irq](../RX63T/port_map_irq.hpp?ts=4)|Port Mapping IRQ|ポート・マッピング IRQ|
|[FLASH](../RX63T/flash.hpp?ts=4)|Flash Memory|フラッシュメモリ|
|[SYSTEM_IO](../RX63T/system_io.hpp?ts=4)|System In/Out (Clock Setting)|システム In/Out (クロック設定)|
|[FLASH_IO](../RX62x/flash_io.hpp?ts=4)|Flash In/Out|フラッシュ In/Out|
|[adc_in](../RX600/adc_in.hpp?ts=4)|A/D Converter Input|A/D 変換入力|
|[board_profile](../RX63T/board_profile?ts=4)|Board Profile|ボード・プロファイル|

---

## Peripheral / ペリフェラル

- [peripheral.hpp](peripheral.hpp?ts=4)

|Peripheral|Function|機能|
|---|---|---|
|[CAC](../RX600/cac.hpp?ts=4)|Clock Frequency Accuracy Measurement Circuit|クロック周波数精度測定回路|
|[DMAC0](../RX600/dmac.hpp?ts=4)|DMA Controller channel 0|DMA コントローラ・チャネル０|
|[DMAC1](../RX600/dmac.hpp?ts=4)|DMA Controller channel 1|DMA コントローラ・チャネル１|
|[DMAC2](../RX600/dmac.hpp?ts=4)|DMA Controller channel 2|DMA コントローラ・チャネル２|
|[DMAC3](../RX600/dmac.hpp?ts=4)|DMA Controller channel 3|DMA コントローラ・チャネル３|
|[DTC](../RX600/dtc.hpp?ts=4)|Data Transfer Controller|データトランスファコントローラ|
|[MTU0](../RX600/mtu3.hpp?ts=4)|Multi-Function Timer Pulse Unit 0|マルチファンクションタイマパルスユニット０|
|[MTU1](../RX600/mtu3.hpp?ts=4)|Multi-Function Timer Pulse Unit 1|マルチファンクションタイマパルスユニット１|
|[MTU2](../RX600/mtu3.hpp?ts=4)|Multi-Function Timer Pulse Unit 2|マルチファンクションタイマパルスユニット２|
|[MTU3](../RX600/mtu3.hpp?ts=4)|Multi-Function Timer Pulse Unit 3|マルチファンクションタイマパルスユニット３|
|[MTU4](../RX600/mtu3.hpp?ts=4)|Multi-Function Timer Pulse Unit 4|マルチファンクションタイマパルスユニット４|
|[MTU5](../RX600/mtu3.hpp?ts=4)|Multi-Function Timer Pulse Unit 5|マルチファンクションタイマパルスユニット５|
|[MTU6](../RX600/mtu3.hpp?ts=4)|Multi-Function Timer Pulse Unit 6|マルチファンクションタイマパルスユニット６|
|[MTU7](../RX600/mtu3.hpp?ts=4)|Multi-Function Timer Pulse Unit 7|マルチファンクションタイマパルスユニット７|
|[POE3](../RX63T/poe3.hpp?ts=4)|Port Output Enable 3|ポートアウトプットイネーブル３|
|[GPT0](../RX63T/gpt.hpp?ts=4)|General PWM Timer 0|汎用 PWM タイマ０|
|[GPT1](../RX63T/gpt.hpp?ts=4)|General PWM Timer 1|汎用 PWM タイマ１|
|[GPT2](../RX63T/gpt.hpp?ts=4)|General PWM Timer 2|汎用 PWM タイマ２|
|[GPT3](../RX63T/gpt.hpp?ts=4)|General PWM Timer 3|汎用 PWM タイマ３|
|[GPT4](../RX63T/gpt.hpp?ts=4)|General PWM Timer 4|汎用 PWM タイマ４|
|[GPT5](../RX63T/gpt.hpp?ts=4)|General PWM Timer 5|汎用 PWM タイマ５|
|[GPT6](../RX63T/gpt.hpp?ts=4)|General PWM Timer 6|汎用 PWM タイマ６|
|[GPT7](../RX63T/gpt.hpp?ts=4)|General PWM Timer 7|汎用 PWM タイマ７|
|[CMT0](../RX600/cmt.hpp?ts=4)|Compare Match Timer 0|コンペアマッチタイマ０|
|[CMT1](../RX600/cmt.hpp?ts=4)|Compare Match Timer 1|コンペアマッチタイマ１|
|[CMT2](../RX600/cmt.hpp?ts=4)|Compare Match Timer 2|コンペアマッチタイマ２|
|[CMT3](../RX600/cmt.hpp?ts=4)|Compare Match Timer 3|コンペアマッチタイマ３|
|[WDTA](../RX600/wdta.hpp?ts=4)|Watchdog Timer|ウォッチドッグタイマ|
|[IWDT](../RX600/iwdt.hpp?ts=4)|Independent Watchdog Timer|独立ウォッチドッグタイマ|
|[USB0](../RX600/usb.hpp?ts=4)|USB 2.0 Host/Function Module 0|USB 2.0 ホスト/ファンクションモジュール０|
|[SCI0](../RX600/sci_c.hpp?ts=4)|Serial Communications Interface 0|シリアルコミュニケーションインタフェース０|
|[SCI1](../RX600/sci_c.hpp?ts=4)|Serial Communications Interface 1|シリアルコミュニケーションインタフェース１|
|[SCI2](../RX600/sci_c.hpp?ts=4)|Serial Communications Interface 2|シリアルコミュニケーションインタフェース２|
|[SCI3](../RX600/sci_c.hpp?ts=4)|Serial Communications Interface 3|シリアルコミュニケーションインタフェース３|
|[SCI12](../RX600/sci_d.hpp?ts=4)|Serial Communications Interface 12|シリアルコミュニケーションインタフェース１２|
|[RIIC0](../RX600/riic.hpp?ts=4)|I2C-bus Interface 0|I2C バスインタフェース０|
|[RIIC1](../RX600/riic.hpp?ts=4)|I2C-bus Interface 1|I2C バスインタフェース１|
|[CAN1](../RX600/can.hpp?ts=4)|CAN Module 1|CAN モジュール１|
|[RSPI0](../RX600/rspi.hpp?ts=4)|Serial Peripheral Interface 0|シリアルペリフェラルインタフェース０|
|[RSPI1](../RX600/rspi.hpp?ts=4)|Serial Peripheral Interface 1|シリアルペリフェラルインタフェース１|
|[CRC](../RX600/crc.hpp?ts=4)|CRC Calculator|CRC 演算器|
|[S12AD](../RX63T/s12adb.hpp?ts=4)|12-Bit A/D Converter|12 ビット A/D コンバータ|
|[S12AD1](../RX63T/s12adb.hpp?ts=4)|12-Bit A/D Converter 1|12 ビット A/D コンバータ１|
|[S12AD2](../RX63T/s12adb.hpp?ts=4)|12-Bit A/D Converter 2|12 ビット A/D コンバータ２|
|[AD](../RX63T/ad.hpp?ts=4)|10-Bit A/D Converter|10 ビット A/D コンバータ|
|[DA](../RX63T/da.hpp?ts=4)|10-Bit D/A Converter|10 ビット D/A コンバータ|
|[DOC](../RX600/doc.hpp?ts=4)|Data Operation Circuit|データ演算回路|
|[DPC0](../RX63T/dpc.hpp?ts=4)|Digital Power Supply Controller 0|デジタル電源制御演算器０|
|[DPC1](../RX63T/dpc.hpp?ts=4)|Digital Power Supply Controller 1|デジタル電源制御演算器１|
|[DPC2](../RX63T/dpc.hpp?ts=4)|Digital Power Supply Controller 2|デジタル電源制御演算器２|
|[DPC3](../RX63T/dpc.hpp?ts=4)|Digital Power Supply Controller 3|デジタル電源制御演算器３|

---

## Port map order (IRQ) / ポートマップ候補 (IRQ)

- [port_map_irq.hpp](port_map_irq.hpp?ts=4)

### LFQFP64

|IRQ|FIRST|SECOND|THIRD|FOURTH|
|---|---|---|---|---|
|IRQ0|P30[DS] (45)|PB5 (19)|PE5 (--)|PG0 (--)|
|IRQ1|P11[DS] (61)|P93 (30)|PE4 (--)|PG1 (--)|
|IRQ2|P00[DS] (2)|PE3[DS] (--)|PB6 (18)|PG2 (--)|
|IRQ3|PB4[DS] (21)|P34 (--)|P82 (--)|-|
|IRQ4|P01[DS] (4)|P96 [DS] (--)|P24 (46)|PB1 (25)|
|IRQ5|P70[DS] (39)|P80 (--)|PF2 (--)|-|
|IRQ6|P21[DS] (--)|PD5 (14)|PG4 (--)|-|
|IRQ7|P20[DS] (--)|P03 (--)|PE0 (--)|-|

### LFQFP100

|IRQ|FIRST|SECOND|THIRD|FOURTH|
|---|---|---|---|---|
|IRQ0|P30[DS] (63)|PB5 (28)|PE5 (1)|PG0 (---)|
|IRQ1|P11[DS] (99)|P93 (47)|PE4 (8)|PG1 (---)|
|IRQ2|P00[DS] (6)|PE3[DS] (9)|PB6 (27)|PG2 (---)|
|IRQ3|PB4[DS] (30)|P34 (---)|P82 (96)|-|
|IRQ4|P01[DS] (4)|P96 [DS] (43)|P24 (64)|PB1 (34)|
|IRQ5|P70[DS] (57)|P80 (98)|PF2 (---)|-|
|IRQ6|P21[DS] (67)|PD5 (20)|PG4 (---)|-|
|IRQ7|P20[DS] (68)|P03 (---)|PE0 (17)|-|

---

## Port map order / ポートマップ候補

- [port_map.hpp](port_map.hpp?ts=4)

### LFQFP64

|Peripheral|FIRST|SECOND|THIRD|FOURTH|
|---|---|---|---|---|
|SCI0 / RXD|P22 (48)|P24 (46)|PA5 (63)|PB1 (25)|
|SCI0 / TXD|P23 (47)|P30 (45)|PA4 (64)|PB2 (24)|
|SCI0 / SCK|P30 (45)|P23 (47)|PA3 (27)|PB3 (23)|
|SCI1 / RXD|P93 (30)|P96 (--)|PD5 (14)|PF2 (--)|
|SCI1 / TXD|P94 (29)|P95 (--)|PD3 (16)|PF3 (--)|
|SCI1 / SCK|P92 (31)|P92 (--)|PD4 (15)|PG6 (--)|
|SCI2 / RXD|P03 (--)|PA2 (28)|PG1 (--)|-|
|SCI2 / TXD|P02 (--)|PA1 (--)|PG0 (--)|-|
|SCI2 / SCK|P14 (--)|PA0 (--)|PG2 (--)|-|
|SCI3 / RXD|P34 (--)|PG4 (--)|-|-|
|SCI3 / TXD|P35 (--)|PG3 (--)|-|-|
|SCI3 / SCK|PG5 (--)|PG5 (--)|-|-|
|SCI12 / RXD|P80 (--)|PB6 (18)|-|-|
|SCI12 / TXD|P81 (--)|PB5 (19)|-|-|
|SCI12 / SCK|P82 (--)|PB7 (17)|-|-|
|RIIC0 / SCL|PB1 (25)|-|-|
|RIIC0 / SDA|PB2 (24)|-|-|
|RIIC1 / SCL|P25 (--)|-|-|
|RIIC1 / SDA|P26 (--)|-|-|
|CAN1 / CRX|P22 (48)|PB6 (18)|PE0 (--)|-|
|CAN1 / CTX|P23 (47)|PB5 (19)|PD7 (12)|-|
|RSPI0 / RSPCK|P24 (46)|PA4 (64)|PD0 (--)|-|
|RSPI0 / MOSI|P23 (47)|PB0 (26)|PD2 (--)|-|
|RSPI0 / MISO|P22 (48)|PA5 (63)|PD1 (--)|-|
|RSPI0 / SSL0|P30 (45)|PA3 (27)|PD6 (13)|
|RSPI0 / SSL1|P31 (43)|PA2 (28)|PD7 (12)|
|RSPI0 / SSL2|P32 (41)|PA1 (--)|PE0 (--)|
|RSPI0 / SSL3|P33 (40)|PA0 (--)|PE1 (--)|
|RSPI1 / RSPCK|P24 (46)|PA4 (64)|PD0 (--)|-|
|RSPI1 / MOSI|P23 (47)|PB0 (26)|PD2 (--)|-|
|RSPI1 / MISO|P22 (48)|PA5 (63)|PD1 (--)|-|
|RSPI1 / SSL0|P30 (45)|PA3 (27)|PD6 (13)|
|RSPI1 / SSL1|P31 (43)|PA2 (28)|PD7 (12)|
|RSPI1 / SSL2|P32 (41)|PA1 (--)|PE0 (--)|
|RSPI1 / SSL3|P33 (40)|PA0 (--)|PE1 (--)|
|USB0 / VBUS|PE5 (--)|-|-|
|USB0 / EXICEN|PD1 (--)|-|-|
|USB0 / VBUSEN|P13 (--)|-|-|
|USB0 / OVRCURA|PE1 (--)|-|-|
|USB0 / OVRCURB|PE0 (--)|-|-|
|USB0 / ID|PD2 (--)|-|-|
|USB0 / DRRPD|P12 (--)|-|-|
|USB0 / DRPD|P01 (--)|-|-|

### LFQFP100

|Peripheral|FIRST|SECOND|THIRD|FOURTH|
|---|---|---|---|---|
|SCI0 / RXD|P22 (66)|P24 (64)|PA5 (36)|PB1 (34)|
|SCI0 / TXD|P23 (65)|P30 (63)|PA4 (37)|PB2 (33)|
|SCI0 / SCK|P30 (63)|P23 (65)|PA3 (38)|PB3 (32)|
|SCI1 / RXD|P93 (47)|P96 (43)|PD5 (20)|PF2 (---)|
|SCI1 / TXD|P94 (46)|P95 (45)|PD3 (22)|PF3 (---)|
|SCI1 / SCK|P92 (48)|P92 (48)|PD4 (21)|PG6 (---)|
|SCI2 / RXD|P03 (---)|PA2 (39)|PG1 (---)|-|
|SCI2 / TXD|P02 (---)|PA1 (40)|PG0 (---)|-|
|SCI2 / SCK|P14 (---)|PA0 (41)|PG2 (---)|-|
|SCI3 / RXD|P34 (---)|PG4 (---)|-|-|
|SCI3 / TXD|P35 (---)|PG3 (---)|-|-|
|SCI3 / SCK|PG5 (---)|PG5 (---)|-|-|
|SCI12 / RXD|P80 (---)|PB6 (27)|-|-|
|SCI12 / TXD|P81 (---)|PB5 (28)|-|-|
|SCI12 / SCK|P82 (---)|PB7 (26)|-|-|
|RIIC0 / SCL|PB1 (34)|-|-|
|RIIC0 / SDA|PB2 (33)|-|-|
|RIIC1 / SCL|P25 (---)|-|-|
|RIIC1 / SDA|P26 (---)|-|-|
|CAN1 / CRX|P22 (66)|PB6 (27)|PE0 (17)|-|
|CAN1 / CTX|P23 (65)|PB5 (28)|PD7 (18)|-|
|RSPI0 / RSPCK|P24 (64)|PA4 (37)|PD0 (25)|-|
|RSPI0 / MOSI|P23 (65)|PB0 (35)|PD2 (23)|-|
|RSPI0 / MISO|P22 (66)|PA5 (36)|PD1 (24)|-|
|RSPI0 / SSL0|P30 (63)|PA3 (38)|PD6 (19)|
|RSPI0 / SSL1|P31 (61)|PA2 (39)|PD7 (18)|
|RSPI0 / SSL2|P32 (59)|PA1 (40)|PE0 (17)|
|RSPI0 / SSL3|P33 (58)|PA0 (41)|PE1 (16)|
|RSPI1 / RSPCK|P24 (64)|PA4 (37)|PD0 (25)|-|
|RSPI1 / MOSI|P23 (65)|PB0 (35)|PD2 (23)|-|
|RSPI1 / MISO|P22 (66)|PA5 (36)|PD1 (24)|-|
|RSPI0 / SSL0|P30 (63)|PA3 (38)|PD6 (19)|
|RSPI0 / SSL1|P31 (61)|PA2 (39)|PD7 (18)|
|RSPI0 / SSL2|P32 (59)|PA1 (40)|PE0 (17)|
|RSPI0 / SSL3|P33 (58)|PA0 (41)|PE1 (16)|
|USB0 / VBUS|PE5 (1)|-|-|
|USB0 / EXICEN|PD1 (24)|-|-|
|USB0 / VBUSEN|P13 (---)|-|-|
|USB0 / OVRCURA|PE1 (16)|-|-|
|USB0 / OVRCURB|PE0 (17)|-|-|
|USB0 / ID|PD2 (23)|-|-|
|USB0 / DRRPD|P12 (---)|-|-|
|USB0 / DRPD|P01 (4)|-|-|

---

## Port map order (GPT) / ポートマップ候補 (GPT)

- [port_map_gpt.hpp](port_map_gpt.hpp?ts=4)

### LFQFP64

|GPT|FIRST|SECOND|THIRD|FOURTH|
|---|---|---|---|---|
|GTIOC0A|P71 (38)|PD7 (12)|-|-|
|GTIOC0B|P74 (35)|PD6 (13)|-|-|
|GTIOC1A|P72 (37)|PD5 (14)|-|-|
|GTIOC1B|P75 (34)|PD4 (15)|-|-|
|GTIOC2A|P73 (36)|PD3 (16)|-|-|
|GTIOC2B|P76 (33)|PB6 (18)|PB7 (17)|PD2 (--)|
|GTIOC3A|P00 (2)|PD1 (--)|-|-|
|GTIOC3B|P01 (4)|PD0 (--)|-|-|
|GTIOC4A|P95 (--)|-|-|-|
|GTIOC4B|P92 (31)|-|-|-|
|GTIOC5A|P94 (29)|-|-|-|
|GTIOC5B|P91 (32)|-|-|-|
|GTIOC6A|P93 (30)|PG3 (--)|-|-|
|GTIOC6B|P90 (--)|PG4 (--)|-|-|
|GTIOC7A|PG0 (--)|-|-|-|
|GTIOC7B|PG1 (--)|-|-|-|
|GTETRG|PB4 (21)|-|-|-|
|GTETRG0|PB4 (21)|-|-|-|
|GTETRG1|P34 (--)|-|-|-|

### LFQFP100

|GPT|FIRST|SECOND|THIRD|FOURTH|
|---|---|---|---|---|
|GTIOC0A|P71 (56)|PD7 (18)|-|-|
|GTIOC0B|P74 (53)|PD6 (19)|-|-|
|GTIOC1A|P72 (55)|PD5 (20)|-|-|
|GTIOC1B|P75 (52)|PD4 (21)|-|-|
|GTIOC2A|P73 (54)|PD3 (22)|-|-|
|GTIOC2B|P76 (51)|PB6 (27)|PB7 (26)|PD2 (23)|
|GTIOC3A|P00 (6)|PD1 (24)|-|-|
|GTIOC3B|P01 (4)|PD0 (25)|-|-|
|GTIOC4A|P95 (45)|-|-|-|
|GTIOC4B|P92 (48)|-|-|-|
|GTIOC5A|P94 (46)|-|-|-|
|GTIOC5B|P91 (49)|-|-|-|
|GTIOC6A|P93 (47)|PG3 (---)|-|-|
|GTIOC6B|P90 (50)|PG4 (---)|-|-|
|GTIOC7A|PG0 (---)|-|-|-|
|GTIOC7B|PG1 (---)|-|-|-|
|GTETRG|PB4 (30)|-|-|-|
|GTETRG0|PB4 (30)|-|-|-|
|GTETRG1|P34 (---)|-|-|-|

---

## Port map order (MTU) / ポートマップ候補 (MTU)

- [port_map_mtu.hpp](port_map_mtu.hpp?ts=4)

### LFQFP64

|MTU|FIRST|SECOND|THIRD|FOURTH|
|---|---|---|---|---|
|MTIOC0A|P31 (43)|PB3 (23)|-|-|
|MTIOC0B|P30 (45)|PB2 (24)|-|-|
|MTIOC0C|PB1 (25)|-|-|-|
|MTIOC0D|PB0 (26)|-|-|-|
|MTIOC1A|PA5 (63)|-|-|-|
|MTIOC1B|PA4 (64)|-|-|-|
|MTIOC2A|PA3 (27)|-|-|-|
|MTIOC2B|PA2 (28)|-|-|-|
|MTIOC3A|P33 (40)|-|-|-|
|MTIOC3B|P71 (38)|-|-|-|
|MTIOC3C|P32 (41)|-|-|-|
|MTIOC3D|P74 (35)|-|-|-|
|MTIOC4A|P72 (37)|-|-|-|
|MTIOC4B|P73 (36)|-|-|-|
|MTIOC4C|P75 (34)|-|-|-|
|MTIOC4D|P76 (33)|-|-|-|
|MTIOC5U|P24 (46)|P82 (--)|-|-|
|MTIOC5V|P23 (47)|P81 (--)|-|-|
|MTIOC5W|P22 (48)|P80 (--)|-|-|
|MTIOC6A|P33 (40)|PA1 (--)|-|-|
|MTIOC6B|P71 (38)|P95 (--)|-|-|
|MTIOC6C|P32 (41)|PA0 (--)|-|-|
|MTIOC6D|P74 (35)|P92 (31)|-|-|
|MTIOC7A|P72 (37)|P94 (29)|-|-|
|MTIOC7B|P73 (36)|P93 (30)|-|-|
|MTIOC7C|P75 (34)|P91 (32)|-|-|
|MTIOC7D|P76 (33)|P90 (--)|-|-|
|MTCLKA|P21 (--)|P22 (48)|P33 (40)|PB3 (23)|
|MTCLKB|P20 (--)|P23 (47)|P32 (41)|PB2 (24)|
|MTCLKC|P11 (61)|P24 (46)|P31 (43)|PE4 (--)|
|MTCLKD|P10 (62)|P30 (45)|PE3 (--)|-|

### LFQFP100

|MTU|FIRST|SECOND|THIRD|FOURTH|
|---|---|---|---|---|
|MTIOC0A|P31 (61)|PB3 (32)|-|-|
|MTIOC0B|P30 (63)|PB2 (33)|-|-|
|MTIOC0C|PB1 (34)|-|-|-|
|MTIOC0D|PB0 (35)|-|-|-|
|MTIOC1A|PA5 (36)|-|-|-|
|MTIOC1B|PA4 (37)|-|-|-|
|MTIOC2A|PA3 (38)|-|-|-|
|MTIOC2B|PA2 (39)|-|-|-|
|MTIOC3A|P33 (58)|-|-|-|
|MTIOC3B|P71 (56)|-|-|-|
|MTIOC3C|P32 (59)|-|-|-|
|MTIOC3D|P74 (53)|-|-|-|
|MTIOC4A|P72 (55)|-|-|-|
|MTIOC4B|P73 (54)|-|-|-|
|MTIOC4C|P75 (52)|-|-|-|
|MTIOC4D|P76 (51)|-|-|-|
|MTIOC5U|P24 (64)|P82 (96)|-|-|
|MTIOC5V|P23 (65)|P81 (97)|-|-|
|MTIOC5W|P22 (66)|P80 (98)|-|-|
|MTIOC6A|P33 (58)|PA1 (40)|-|-|
|MTIOC6B|P71 (56)|P95 (45)|-|-|
|MTIOC6C|P32 (59)|PA0 (41)|-|-|
|MTIOC6D|P74 (53)|P92 (48)|-|-|
|MTIOC7A|P72 (55)|P94 (46)|-|-|
|MTIOC7B|P73 (54)|P93 (47)|-|-|
|MTIOC7C|P75 (52)|P91 (49)|-|-|
|MTIOC7D|P76 (51)|P90 (50)|-|-|
|MTCLKA|P21 (67)|P22 (66)|P33 (58)|PB3 (32)|
|MTCLKB|P20 (68)|P23 (65)|P32 (59)|PB2 (33)|
|MTCLKC|P11 (99)|P24 (64)|P31 (61)|PE4 (8)|
|MTCLKD|P10 (100)|P30 (63)|PE3 (9)|-|

---

## 10 Bits A/D Converter input (AD) / 10 ビット A/D コンバーター入力 (AD)

- [ad.hpp](ad.hpp?ts=4)

### LFQFP64

|AD/ANALOG|Port|
|---|---|
|AN0|P60 (--)|
|AN1|P61 (--)|
|AN2|P62 (--)|
|AN3|P63 (--)|
|AN4|P64 (--)|
|AN5|P65 (--)|
|AN6|P50 (--)|
|AN7|P51 (--)|
|AN8|P52 (--)|
|AN9|P53 (--)|
|AN10|P54 (--)|
|AN11|P55 (--)|
|AN12|P56 (--)|
|AN13|P57 (--)|
|AN14|PC0 (--)|
|AN15|PC1 (--)|
|AN16|PC2 (--)|
|AN17|PC3 (--)|
|AN18|PC4 (--)|
|AN19|PC5 (--)|

### LFQFP100

|AD/ANALOG|Port|
|---|---|
|AN0|P60 (77)|
|AN1|P61 (76)|
|AN2|P62 (75)|
|AN3|P63 (74)|
|AN4|P64 (70)|
|AN5|P65 (69)|
|AN6|P50 (83)|
|AN7|P51 (82)|
|AN8|P52 (81)|
|AN9|P53 (80)|
|AN10|P54 (79)|
|AN11|P55 (78)|
|AN12|P56 (---)|
|AN13|P57 (---)|
|AN14|PC0 (---)|
|AN15|PC1 (---)|
|AN16|PC2 (---)|
|AN17|PC3 (---)|
|AN18|PC4 (---)|
|AN19|PC5 (---)|

---

## 12 Bits A/D Converter input (S12AD) / 12 ビット A/D コンバーター入力 (S12AD)

- [s12adb.hpp](s12adb.hpp?ts=4)
- 64/48 pin, 8 channel / 1 unit
- 100~ pin, 4 channel / 2 units

### LFQFP64

|S12AD/ANALOG|Port|
|---|---|
|AN000|P40 (56)|
|AN001|P41 (55)|
|AN002|P42 (54)|
|AN003|P43 (53)|
|AN004|P44 (52)|
|AN005|P45 (51)|
|AN006|P46 (50)|
|AN007|P47 (49)|

### LFQFP100

|S12AD/ANALOG|Port|
|---|---|
|AN000|P40 (91)|
|AN001|P41 (90)|
|AN002|P42 (89)|
|AN003|P43 (88)|

|S12AD1/ANALOG|Port|
|---|---|
|AN104|P44 (87)|
|AN105|P45 (86)|
|AN106|P46 (85)|
|AN107|P47 (84)|

---

## 10 Bits D/A Converter output (DA) / 10 ビット D/A コンバーター出力 (DA)

- [da.hpp](da.hpp?ts=4)

### LFQFP64

|DA/ANALOG|Port|
|---|---|
|DA0|P54 (---)|
|DA1|P55 (---)|

### LFQFP100

|DA/ANALOG|Port|
|---|---|
|DA0|P54 (79)|
|DA1|P55 (78)|

---

## rx_prog Flash Programming / rx_prog フラッシュプログラム

||Support/サポート|operation verification/動作検証|
|-|:-:|:-:|
|[rxprog](../rxprog)|〇|〇|

---

Translated with www.DeepL.com/Translator (free version)

---

## License

[MIT](../LICENSE)
