hirakuni45/RX/RX71M/README.md

## RX71M features / 特徴

- RXv2 core / コア
- Maximum operating frequency / 最大動作周波数 240MHz
- IEEE754 FPU on board (single precision floating point) / FPU 搭載（単精度浮動小数点）
- 2.7V ～ 3.6V Operation / 動作
- IEEE1588 Ether-MAC (10/100 Mbps) on board
- USB2.0 Full Speed, Host, Function
- CAN (ISO11898-1)
- SDHI Interface (Optional)
- 12 Bits A/D / １２ビットＡ／Ｄ変換器
- 12 Bits D/A / １２ビットＤ／Ａ変換器

|R5F571M---XX|Package/パッケージ|Pin/ピン数|Pitch/ピッチ|
|---|:-:|:-:|:-:|
|R5F571MxxxFC|LFQFP|176|0.50|
|R5F571MxxxBG|LFBGA|176|0.80|
|R5F571MxxxLC|TFLGA|177|0.50|
|R5F571MxxxFB|LFQFP|144|0.50|
|R5F571MxxxLK|TFLGA|145|0.50|
|R5F571MxxxFP|LFQFP|100|0.50|
|R5F571MxxxLJ|TFLGA|100|0.65|

### Ambient operating temperature/動作周囲温度

|R5F571M--X--|degree Celsius|
|---|:-:|
|R5F571MxxDxx|-40 ～ +85℃|
|R5F571MxxGxx|-40 ～ +105℃|

### Crypt/暗号、SDHI

|R5F571M-X---|Crypt|SDHI|
|---|:-:|:-:|
|R5F571MxDxxx|-|〇|
|R5F571MxHxxx|〇|〇|
|R5F571MxCxxx|-|-|
|R5F571MxGxxx|〇|-|

### Memoey size/メモリ容量

|R5F571MX----|Code Flash|RAM|ECCRAM|StanbyRAM|Data Flash|
|---|:-:|:-:|:-:|:-:|:-:|
|R5F571MLxxxx|4M|512K|32K|8K|64K|
|R5F571MJxxxx|3M|512K|32K|8K|64K|
|R5F571MGxxxx|2.5M|512K|32K|8K|64K|
|R5F571MFxxxx|2M|512K|32K|8K|64K|

### Data Flash/データ・フラッシュ

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

---

## RX71M Linker file / リンカーファイル

|Type|Code Flash|RAM|Data Flash|Linker File|Ustack|Istack|
|---|:-:|:-:|:-:|---|:-:|:-:|
|R5F571ML|4096K|512K+32K|64K|[R5F571ML.ld](R5F571ML.ld?ts=4)|6144|2048|
|R5F571MJ|3072K|512K+32K|64K|[R5F571MJ.ld](R5F571MJ.ld?ts=4)|6144|2048|
|R5F571MG|2560K|512K+32K|64K|[R5F571MG.ld](R5F571MG.ld?ts=4)|6144|2048|
|R5F571MF|2048K|512K+32K|64K|[R5F571MF.ld](R5F571MF.ld?ts=4)|6144|2048|

---

## RX71M Dedicated class / 専用クラス

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

---

## Basic Pin Assignments / 基本ピンアサイン

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

- VCL: 0.1uF/25V

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

---

## Device, Renesas / デバイス、ルネサス

- [device.hpp (SIG_RX71M)](../common/device.hpp?ts=4)
- [renesas.hpp (SIG_RX71M)](../common/renesas.hpp?ts=4)

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

---

## Peripheral / ペリフェラル

- [peripheral.hpp](../RX64M/peripheral.hpp?ts=4)

|Peripheral|Function|機能|
|---|---|---|
|[CAC](../RX600/cac.hpp?ts=4)|Clock Frequency Accuracy Measurement Circuit|クロック周波数精度測定回路|
|[ELC](../RX600/elc.hpp?ts=4)|Event Link Controller|イベントリンクコントローラ|
|[DMAC0](../RX600/dmac.hpp?ts=4)|DMA Controller channel 0|DMA コントローラ・チャネル０|
|[DMAC1](../RX600/dmac.hpp?ts=4)|DMA Controller channel 1|DMA コントローラ・チャネル１|
|[DMAC2](../RX600/dmac.hpp?ts=4)|DMA Controller channel 2|DMA コントローラ・チャネル２|
|[DMAC3](../RX600/dmac.hpp?ts=4)|DMA Controller channel 3|DMA コントローラ・チャネル３|
|[DMAC4](../RX600/dmac.hpp?ts=4)|DMA Controller channel 4|DMA コントローラ・チャネル４|
|[DMAC5](../RX600/dmac.hpp?ts=4)|DMA Controller channel 5|DMA コントローラ・チャネル５|
|[DMAC6](../RX600/dmac.hpp?ts=4)|DMA Controller channel 6|DMA コントローラ・チャネル６|
|[DMAC7](../RX600/dmac.hpp?ts=4)|DMA Controller channel 7|DMA コントローラ・チャネル７|
|[DTC](../RX600/dtc.hpp?ts=4)|Data Transfer Controller|データトランスファコントローラ|
|[EXDMAC0](../RX600/exdmac.hpp?ts=4)|EXDMA Controller channel 0|EXDMA コントローラ・チャネル０|
|[EXDMAC1](../RX600/exdmac.hpp?ts=4)|EXDMA Controller channel 1|EXDMA コントローラ・チャネル１|
|[MTU0](../RX600/mtu3.hpp?ts=4)|Multi-Function Timer Pulse Unit 0|マルチファンクションタイマパルスユニット０|
|[MTU1](../RX600/mtu3.hpp?ts=4)|Multi-Function Timer Pulse Unit 1|マルチファンクションタイマパルスユニット１|
|[MTU2](../RX600/mtu3.hpp?ts=4)|Multi-Function Timer Pulse Unit 2|マルチファンクションタイマパルスユニット２|
|[MTU3](../RX600/mtu3.hpp?ts=4)|Multi-Function Timer Pulse Unit 3|マルチファンクションタイマパルスユニット３|
|[MTU4](../RX600/mtu3.hpp?ts=4)|Multi-Function Timer Pulse Unit 4|マルチファンクションタイマパルスユニット４|
|[MTU5](../RX600/mtu3.hpp?ts=4)|Multi-Function Timer Pulse Unit 5|マルチファンクションタイマパルスユニット５|
|[MTU6](../RX600/mtu3.hpp?ts=4)|Multi-Function Timer Pulse Unit 6|マルチファンクションタイマパルスユニット６|
|[MTU7](../RX600/mtu3.hpp?ts=4)|Multi-Function Timer Pulse Unit 7|マルチファンクションタイマパルスユニット７|
|[MTU8](../RX600/mtu3.hpp?ts=4)|Multi-Function Timer Pulse Unit 8|マルチファンクションタイマパルスユニット８|
|[POE3](../RX64M/poe3.hpp?ts=4)|Port Output Enable 3|ポートアウトプットイネーブル３|
|[GPT0](../RX600/gpt.hpp?ts=4)|General PWM Timer 0|汎用 PWM タイマ０|
|[GPT1](../RX600/gpt.hpp?ts=4)|General PWM Timer 1|汎用 PWM タイマ１|
|[GPT2](../RX600/gpt.hpp?ts=4)|General PWM Timer 2|汎用 PWM タイマ２|
|[GPT3](../RX600/gpt.hpp?ts=4)|General PWM Timer 3|汎用 PWM タイマ３|
|[TPU0](../RX600/tpu.hpp?ts=4)|16-Bit Timer Pulse Unit 0|16 ビットタイマパルスユニット０|
|[TPU1](../RX600/tpu.hpp?ts=4)|16-Bit Timer Pulse Unit 1|16 ビットタイマパルスユニット１|
|[TPU2](../RX600/tpu.hpp?ts=4)|16-Bit Timer Pulse Unit 2|16 ビットタイマパルスユニット２|
|[TPU3](../RX600/tpu.hpp?ts=4)|16-Bit Timer Pulse Unit 3|16 ビットタイマパルスユニット３|
|[TPU4](../RX600/tpu.hpp?ts=4)|16-Bit Timer Pulse Unit 4|16 ビットタイマパルスユニット４|
|[TPU5](../RX600/tpu.hpp?ts=4)|16-Bit Timer Pulse Unit 5|16 ビットタイマパルスユニット５|
|[PPG0](../RX600/ppg.hpp?ts=4)|Programmable Pulse Generator 0|プログラマブルパルスジェネレータ０|
|[PPG1](../RX600/ppg.hpp?ts=4)|Programmable Pulse Generator 1|プログラマブルパルスジェネレータ１|
|[TMR0](../RX600/tmr.hpp?ts=4)|8-Bit Timer 0|8 ビットタイマ０|
|[TMR1](../RX600/tmr.hpp?ts=4)|8-Bit Timer 1|8 ビットタイマ１|
|[TMR2](../RX600/tmr.hpp?ts=4)|8-Bit Timer 2|8 ビットタイマ２|
|[TMR3](../RX600/tmr.hpp?ts=4)|8-Bit Timer 3|8 ビットタイマ３|
|[CMT0](../RX600/cmt.hpp?ts=4)|Compare Match Timer 0|コンペアマッチタイマ０|
|[CMT1](../RX600/cmt.hpp?ts=4)|Compare Match Timer 1|コンペアマッチタイマ１|
|[CMT2](../RX600/cmt.hpp?ts=4)|Compare Match Timer 2|コンペアマッチタイマ２|
|[CMT3](../RX600/cmt.hpp?ts=4)|Compare Match Timer 3|コンペアマッチタイマ３|
|[CMTW0](../RX600/cmtw.hpp?ts=4)|Compare Match Timer W0|コンペアマッチタイマＷ０|
|[CMTW1](../RX600/cmtw.hpp?ts=4)|Compare Match Timer W1|コンペアマッチタイマＷ１|
|[RTC](../RX600/rtc.hpp?ts=4)|Realtime Clock|リアルタイムクロック|
|[WDTA](../RX600/wdta.hpp?ts=4)|Watchdog Timer|ウォッチドッグタイマ|
|[IWDT](../RX600/iwdt.hpp?ts=4)|Independent Watchdog Timer|独立ウォッチドッグタイマ|
|[ETHERC0](../RX600/etherc.hpp?ts=4)|Ethernet Controller 0|イーサネットコントローラ０|
|[ETHERC1](../RX600/etherc.hpp?ts=4)|Ethernet Controller 1|イーサネットコントローラ１|
|[EPTPC](../RX600/eptpc.hpp?ts=4)|PTP Module for the Ethernet Controller|イーサネットコントローラ用 PTP コントローラ|
|[EPTPC0](../RX600/eptpc.hpp?ts=4)|PTP Module for the Ethernet Controller 0|イーサネットコントローラ用 PTP コントローラ０|
|[EPTPC1](../RX600/eptpc.hpp?ts=4)|PTP Module for the Ethernet Controller 1|イーサネットコントローラ用 PTP コントローラ１|
|[EDMAC0](../RX600/edmac.hpp?ts=4)|DMA Controller for the Ethernet Controller 0|イーサネットコントローラ用 DMA コントローラ０|
|[EDMAC1](../RX600/edmac.hpp?ts=4)|DMA Controller for the Ethernet Controller 1|イーサネットコントローラ用 DMA コントローラ１|
|[PTPEDMAC](../RX600/edmac.hpp?ts=4)|PTP Ethernet DMA|PTP イーサネット DMA|
|[USB0](../RX600/usb.hpp?ts=4)|USB 2.0 FS Host/Function Module 0|USB 2.0 FS ホスト/ファンクションモジュール０|
|[USBA](../RX600/usba.hpp?ts=4)|USB 2.0 High-Speed Host/Function Module|USB 2.0 High-Speed ホスト/ファンクションモジュール|
|[SCI0](../RX600/sci_g.hpp?ts=4)|Serial Communications Interface 0|シリアルコミュニケーションインタフェース０|
|[SCI1](../RX600/sci_g.hpp?ts=4)|Serial Communications Interface 1|シリアルコミュニケーションインタフェース１|
|[SCI2](../RX600/sci_g.hpp?ts=4)|Serial Communications Interface 2|シリアルコミュニケーションインタフェース２|
|[SCI3](../RX600/sci_g.hpp?ts=4)|Serial Communications Interface 3|シリアルコミュニケーションインタフェース３|
|[SCI4](../RX600/sci_g.hpp?ts=4)|Serial Communications Interface 4|シリアルコミュニケーションインタフェース４|
|[SCI5](../RX600/sci_g.hpp?ts=4)|Serial Communications Interface 5|シリアルコミュニケーションインタフェース５|
|[SCI6](../RX600/sci_g.hpp?ts=4)|Serial Communications Interface 6|シリアルコミュニケーションインタフェース６|
|[SCI7](../RX600/sci_g.hpp?ts=4)|Serial Communications Interface 7|シリアルコミュニケーションインタフェース７|
|[SCIF8](../RX600/scif.hpp?ts=4)|FIFO Embedded Serial Communications Interface 8|FIFO 内臓シリアルコミュニケーションインターフェース８|
|[SCIF9](../RX600/scif.hpp?ts=4)|FIFO Embedded Serial Communications Interface 9|FIFO 内臓シリアルコミュニケーションインターフェース９|
|[SCIF10](../RX600/scif.hpp?ts=4)|FIFO Embedded Serial Communications Interface 10|FIFO 内臓シリアルコミュニケーションインターフェース１０|
|[SCIF11](../RX600/scif.hpp?ts=4)|FIFO Embedded Serial Communications Interface 11|FIFO 内臓シリアルコミュニケーションインターフェース１１|
|[SCI12](../RX600/sci_h.hpp?ts=4)|Serial Communications Interface 12|シリアルコミュニケーションインタフェース１２|
|[RIIC0](../RX600/riic.hpp?ts=4)|I2C-bus Interface 0|I2C バスインタフェース０|
|[RIIC2](../RX600/riic.hpp?ts=4)|I2C-bus Interface 2|I2C バスインタフェース２|
|[CAN0](../RX600/can.hpp?ts=4)|CAN Module 0|CAN モジュール０|
|[CAN1](../RX600/can.hpp?ts=4)|CAN Module 1|CAN モジュール１|
|[CAN2](../RX600/can.hpp?ts=4)|CAN Module 2|CAN モジュール２|
|[RSPI0](../RX600/rspi.hpp?ts=4)|Serial Peripheral Interface 0|シリアルペリフェラルインタフェース０|
|[RSPI1](../RX600/rspi.hpp?ts=4)|Serial Peripheral Interface 1|シリアルペリフェラルインタフェース１|
|[QSPI](../RX64M/qspi.hpp?ts=4)|Quad-SPI Memory Interface|クワッド SPI メモリインタフェース|
|[CRC](../RX600/crc.hpp?ts=4)|CRC Calculator|CRC 演算器|
|[SSI0](../RX600/ssi.hpp?ts=4)|Serial Sound Interface 0|シリアルサウンドインタフェース０|
|[SSI1](../RX600/ssi.hpp?ts=4)|Serial Sound Interface 1|シリアルサウンドインタフェース１|
|[SDHI](../RX600/sdhi.hpp?ts=4)|SD Host Interface|SD ホストインタフェース|
|[MMCIF](../RX600/mmcif.hpp?ts=4)|MultiMediaCard Interface|マルチメディアカードインタフェース|
|[PDC](../RX600/pdc.hpp?ts=4)|Parallel Data Capture Unit|パラレルデータキャプチャユニット|
|[S12AD](../RX600/s12adc.hpp?ts=4)|12-Bit A/D Converter|12 ビット A/D コンバータ|
|[S12AD1](../RX600/s12adc.hpp?ts=4)|12-Bit A/D Converter 1|12 ビット A/D コンバータ１|
|[R12DA](../RX600/r12da.hpp?ts=4)|12-Bit D/A Converter|12 ビット D/A コンバータ|
|[TEMPS](../RX600/system.hpp?ts=4)|Temperature Sensor|温度センサ|
|[DOC](../RX600/doc.hpp?ts=4)|Data Operation Circuit|データ演算回路|
|ECCRAM|ECC RAM (32K)|ECC RAM (32K)|
|[STBRAM](../RX600/standby_ram.hpp?ts=4)|Standby RAM|スタンバイ RAM|

---

## Port map order (IRQ) / ポートマップ候補 (IRQ)

- [port_map_irq.hpp](../RX64M/port_map_irq.hpp?ts=4)

### LFQFP100

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

### LFQFP144

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

### LFQFP176

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

---

## Port map order / ポートマップ候補

- [port_map.hpp](../RX64M/port_map.hpp?ts=4)

### LFQFP100

|Peripheral|FIRST|SECOND|THIRD|FOURTH|
|---|---|---|---|---|
|SCI0 / RXD|P21 (27)|P33 (17)|-|-|
|SCI0 / TXD|P20 (28)|P32 (18)|-|-|
|SCI0 / SCK|P22 (26)|P34 (16)|-|-|
|SCI1 / RXD|P15 (31)|P30 (20)|PF2 (---)|-|
|SCI1 / TXD|P16 (30)|P26 (22)|PF0 (---)|-|
|SCI1 / SCK|P17 (29)|P27 (21)|PF1 (---)|-|
|SCI2 / RXD|P12 (34)|P52 (42)|-|-|
|SCI2 / TXD|P13 (33)|P50 (44)|-|-|
|SCI2 / SCK|P11 (---)|P51 (43)|-|-|
|SCI3 / RXD|P16 (30)|P25 (23)|-|-|
|SCI3 / TXD|P17 (29)|P23 (25)|-|-|
|SCI3 / SCK|P15 (31)|P24 (24)|-|-|
|SCI4 / RXD|PB0 (61)|-|-|-|
|SCI4 / TXD|PB1 (59)|-|-|-|
|SCI4 / SCK|PB3 (57)|-|-|-|
|SCI5 / RXD|PA2 (68)|PA3 (67)|PC2 (50)|PC2 (50)|
|SCI5 / TXD|PA4 (66)|PA4 (66)|PC3 (49)|PC3 (49)|
|SCI5 / SCK|PA1 (69)|PA1 (69)|PC1 (51)|PC4 (48)|
|SCI6 / RXD|P01 (---)|P33 (17)|PB0 (61)|-|
|SCI6 / TXD|P00 (---)|P32 (18)|PB1 (59)|-|
|SCI6 / SCK|P02 (---)|P34 (16)|PB3 (57)|-|
|SCI7 / RXD|P92 (---)|-|-|-|
|SCI7 / TXD|P90 (---)|-|-|-|
|SCI7 / SCK|P91 (---)|-|-|-|
|SCIF8 / RXD|PC6 (46)|-|-|-|
|SCIF8 / TXD|PC7 (45)|-|-|-|
|SCIF8 / SCK|PC5 (47)|-|-|-|
|SCIF9 / RXD|PB6 (54)|-|-|-|
|SCIF9 / TXD|PB7 (53)|-|-|-|
|SCIF9 / SCK|PB5 (55)|-|-|-|
|SCIF10 / RXD|P81 (---)|P86 (---)|-|-|
|SCIF10 / TXD|P82 (---)|P87 (---)|-|-|
|SCIF10 / SCK|P80 (---)|P83 (---)|-|-|
|SCIF11 / RXD|P76 (---)|-|-|-|
|SCIF11 / TXD|P77 (---)|-|-|-|
|SCIF11 / SCK|P75 (---)|-|-|-|
|SCI12 / RXD|PE2 (76)|-|-|-|
|SCI12 / TXD|PE1 (77)|-|-|-|
|SCI12 / SCK|PE0 (78)|-|-|-|
|RIIC0 / SCL|P12 (34)|-|-|-|
|RIIC0 / SDA|P13 (33)|-|-|-|
|RIIC2 / SCL|P16 (30)|-|-|-|
|RIIC2 / SDA|P17 (29)|-|-|-|
|CAN0 / CRX|P33 (17)|PD2 (84)|-|-|
|CAN0 / CTX|P32 (18)|PD1 (85)|-|-|
|CAN1 / CRX|P15 (31)|P55 (39)|-|-|
|CAN1 / CTX|P14 (32)|P54 (40)|-|-|
|CAN2 / CRX|P67 (---)|--|-|-|
|CAN2 / CTX|P66 (---)|--|-|-|
|RSPI0 / RSPCK|PA5 (65)|PC5 (47)|-|-|
|RSPI0 / MOSI|PA6 (64)|PC6 (46)|-|-|
|RSPI0 / MISO|PA7 (63)|PC7 (45)|-|-|
|RSPI0 / SSL0|PA4 (66)|PC4 (48)|-|-|
|RSPI0 / SSL1|PA0 (70)|PC0 (52)|-|-|
|RSPI0 / SSL2|PA1 (69)|PC1 (51)|-|-|
|RSPI0 / SSL3|PA2 (68)|PC2 (50)|-|-|
|RSPI1 / RSPCK|P27 (21)|PE5 (73)|-|-|
|RSPI1 / MOSI|P26 (22)|PE6 (72)|-|-|
|RSPI1 / MISO|P30 (20)|PE7 (71)|-|-|
|RSPI1 / SSL0|P31 (19)|PE4 (74)|-|-|
|RSPI1 / SSL1|P50 (44)|PE0 (78)|-|-|
|RSPI1 / SSL2|P51 (43)|PE1 (77)|-|-|
|RSPI1 / SSL3|P52 (42)|PE2 (76)|-|-|
|SSI0 / AUDIO_CLK|P22 (26)|-|-|-|
|SSI0 / SSISCK0|P23 (25)|-|-|-|
|SSI0 / SSIWS0|P21 (27)|-|-|-|
|SSI0 / SSIRXD0|P20 (28)|-|-|-|
|SSI0 / SSITXD0|P17 (29)|-|-|-|
|SSI1 / AUDIO_CLK|P22 (26)|-|-|-|
|SSI1 / SSISCK1|P24 (25)|-|-|-|
|SSI1 / SSIWS1|P15 (31)|-|-|-|
|SSI1 / SSIDATA1|P25 (23)|-|-|-|
|USB0 / VBUS|P16 (30)|-|-|-|
|USB0 / EXICEN|P21 (27)|-|-|-|
|USB0 / VBUSEN|P16 (30)|P24 (24)|P32 (18)|-|
|USB0 / OVRCURA|P14 (32)|-|-|-|
|USB0 / OVRCURB|P16 (30)|P22 (26)|-|-|
|USB0 / ID|P20 (28)|-|-|-|

### LFQFP144

|Peripheral|FIRST|SECOND|THIRD|FOURTH|
|---|---|---|---|---|
|SCI0 / RXD|P21 (36)|P33 (26)|-|-|
|SCI0 / TXD|P20 (37)|P32 (27)|-|-|
|SCI0 / SCK|P22 (35)|P34 (25)|-|-|
|SCI1 / RXD|P15 (42)|P30 (29)|PF2 (---)|-|
|SCI1 / TXD|P16 (40)|P26 (31)|PF0 (---)|-|
|SCI1 / SCK|P17 (38)|P27 (30)|PF1 (---)|-|
|SCI2 / RXD|P12 (45)|P52 (54)|-|-|
|SCI2 / TXD|P13 (44)|P50 (56)|-|-|
|SCI2 / SCK|P11 (---)|P51 (55)|-|-|
|SCI3 / RXD|P16 (40)|P25 (32)|-|-|
|SCI3 / TXD|P17 (38)|P23 (34)|-|-|
|SCI3 / SCK|P15 (42)|P24 (33)|-|-|
|SCI4 / RXD|PB0 (87)|-|-|-|
|SCI4 / TXD|PB1 (84)|-|-|-|
|SCI4 / SCK|PB3 (82)|-|-|-|
|SCI5 / RXD|PA2 (95)|PA3 (94)|PC2 (70)|PC2 (70)|
|SCI5 / TXD|PA4 (92)|PA4 (92)|PC3 (67)|PC3 (67)|
|SCI5 / SCK|PA1 (96)|PA1 (96)|PC1 (73)|PC4 (66)|
|SCI6 / RXD|P01 (7)|P33 (26)|PB0 (87)|-|
|SCI6 / TXD|P00 (8)|P32 (27)|PB1 (84)|-|
|SCI6 / SCK|P02 (6)|P34 (25)|PB3 (82)|-|
|SCIF7 / RXD|P92 (128)|-|-|-|
|SCIF7 / TXD|P90 (131)|-|-|-|
|SCIF7 / SCK|P91 (129)|-|-|-|
|SCIF8 / RXD|PC6 (61)|-|-|-|
|SCIF8 / TXD|PC7 (60)|-|-|-|
|SCIF8 / SCK|PC5 (62)|-|-|-|
|SCIF9 / RXD|PB6 (79)|-|-|-|
|SCIF9 / TXD|PB7 (78)|-|-|-|
|SCIF9 / SCK|PB5 (80)|-|-|-|
|SCIF10 / RXD|P81 (64)|P86 (41)|-|-|
|SCIF10 / TXD|P82 (63)|P87 (39)|-|-|
|SCIF10 / SCK|P80 (65)|P83 (58)|-|-|
|SCIF11 / RXD|P76 (69)|-|-|-|
|SCIF11 / TXD|P77 (68)|-|-|-|
|SCIF11 / SCK|P75 (71)|-|-|-|
|SCI12 / RXD|PE2 (109)|-|-|-|
|SCI12 / TXD|PE1 (110)|-|-|-|
|SCI12 / SCK|PE0 (111)|-|-|-|
|RIIC0 / SCL|P12 (45)|-|-|-|
|RIIC0 / SDA|P13 (44)|-|-|-|
|RIIC2 / SCL|P16 (40)|-|-|-|
|RIIC2 / SDA|P17 (38)|-|-|-|
|CAN0 / CRX|P33 (26)|PD2 (124)|-|-|
|CAN0 / CTX|P32 (27)|PD1 (125)|-|-|
|CAN1 / CRX|P15 (42)|P55 (51)|-|-|
|CAN1 / CTX|P14 (43)|P54 (52)|-|-|
|CAN2 / CRX|P67 (98)|-|-|-|
|CAN2 / CTX|P66 (99)|-|-|-|
|RSPI0 / RSPCK|PA5 (90)|PC5 (62)|-|-|
|RSPI0 / MOSI|PA6 (89)|PC6 (61)|-|-|
|RSPI0 / MISO|PA7 (88)|PC7 (60)|-|-|
|RSPI0 / SSL0|PA4 (92)|PC4 (66)|-|-|
|RSPI0 / SSL1|PA0 (97)|PC0 (75)|-|-|
|RSPI0 / SSL2|PA1 (96)|PC1 (73)|-|-|
|RSPI0 / SSL3|PA2 (95)|PC2 (70)|-|-|
|RSPI1 / RSPCK|P27 (30)|PE5 (106)|-|-|
|RSPI1 / MOSI|P26 (31)|PE6 (102)|-|-|
|RSPI1 / MISO|P30 (29)|PE7 (101)|-|-|
|RSPI1 / SSL0|P31 (28)|PE4 (107)|-|-|
|RSPI1 / SSL1|P50 (56)|PE0 (111)|-|-|
|RSPI1 / SSL2|P51 (55)|PE1 (110)|-|-|
|RSPI1 / SSL3|P52 (54)|PE2 (109)|-|-|
|SSI0 / AUDIO_CLK|P22 (35)|-|-|-|
|SSI0 / SSISCK0|P23 (34)|-|-|-|
|SSI0 / SSIWS0|P21 (36)|-|-|-|
|SSI0 / SSIRXD0|P20 (37)|-|-|-|
|SSI0 / SSITXD0|P17 (38)|-|-|-|
|SSI1 / AUDIO_CLK|P22 (35)|-|-|-|
|SSI1 / SSISCK1|P24 (33)|-|-|-|
|SSI1 / SSIWS1|P15 (42)|-|-|-|
|SSI1 / SSIDATA1|P25 (32)|-|-|-|
|USB0 / VBUS|P16 (40)|-|-|-|
|USB0 / EXICEN|P21 (36)|-|-|-|
|USB0 / VBUSEN|P16 (40)|P24 (33)|P32 (27)|-|
|USB0 / OVRCURA|P14 (43)|-|-|-|
|USB0 / OVRCURB|P16 (40)|P22 (35)|-|-|
|USB0 / ID|P20 (37)|-|-|-|

### LFQFP176

|Peripheral|FIRST|SECOND|THIRD|FOURTH|
|---|---|---|---|---|
|SCI0 / RXD|P21 (44)|P33 (28)|-|-|
|SCI0 / TXD|P20 (45)|P32 (29)|-|-|
|SCI0 / SCK|P22 (43)|P34 (27)|-|-|
|SCI1 / RXD|P15 (50)|P30 (33)|PF2 (31)|-|
|SCI1 / TXD|P16 (48)|P26 (37)|PF0 (35)|-|
|SCI1 / SCK|P17 (46)|P27 (36)|PF1 (34)|-|
|SCI2 / RXD|P12 (53)|P52 (70)|-|-|
|SCI2 / TXD|P13 (52)|P50 (72)|-|-|
|SCI2 / SCK|P11 (67)|P51 (71)|-|-|
|SCI3 / RXD|P16 (48)|P25 (38)|-|-|
|SCI3 / TXD|P17 (46)|P23 (42)|-|-|
|SCI3 / SCK|P15 (50)|P24 (40)|-|-|
|SCI4 / RXD|PB0 (104)|-|-|-|
|SCI4 / TXD|PB1 (100)|-|-|-|
|SCI4 / SCK|PB3 (98)|-|-|-|
|SCI5 / RXD|PA2 (112)|PA3 (110)|PC2 (86)|PC2 (86)|
|SCI5 / TXD|PA4 (109)|PA4 (109)|PC3 (83)|PC3 (83)|
|SCI5 / SCK|PA1 (114)|PA1 (114)|PC1 (89)|PC4 (82)|
|SCI6 / RXD|P01 (7)|P33 (28)|PB0 (104)|-|
|SCI6 / TXD|P00 (8)|P32 (29)|PB1 (100)|-|
|SCI6 / SCK|P02 (6)|P34 (27)|PB3 (98)|-|
|SCI7 / RXD|P92 (160)|-|-|-|
|SCI7 / TXD|P90 (163)|-|-|-|
|SCI7 / SCK|P91 (161)|-|-|-|
|SCIF8 / RXD|PC6 (77)|-|-|-|
|SCIF8 / TXD|PC7 (76)|-|-|-|
|SCIF8 / SCK|PC5 (78)|-|-|-|
|SCIF9 / RXD|PB6 (95)|-|-|-|
|SCIF9 / TXD|PB7 (94)|-|-|-|
|SCIF9 / SCK|PB5 (96)|-|-|-|
|SCIF10 / RXD|P81 (80)|P86 (49)|-|-|
|SCIF10 / TXD|P82 (79)|P87 (47)|-|-|
|SCIF10 / SCK|P80 (81)|P83 (74)|-|-|
|SCIF11 / RXD|P76 (85)|-|-|-|
|SCIF11 / TXD|P77 (84)|-|-|-|
|SCIF11 / SCK|P75 (87)|-|-|-|
|SCI12 / RXD|PE2 (133)|-|-|-|
|SCI12 / TXD|PE1 (134)|-|-|-|
|SCI12 / SCK|PE0 (135)|-|-|-|
|RIIC0 / SCL|P12 (53)|-|-|-|
|RIIC0 / SDA|P13 (52)|-|-|-|
|RIIC2 / SCL|P16 (48)|-|-|-|
|RIIC2 / SDA|P17 (46)|-|-|-|
|CAN0 / CRX|P33 (28)|PD2 (154)|-|-|
|CAN0 / CTX|P32 (29)|PD1 (156)|-|-|
|CAN1 / CRX|P15 (50)|P55 (65)|-|-|
|CAN1 / CTX|P14 (51)|P54 (66)|-|-|
|CAN2 / CRX|P67 (120)|-|-|-|
|CAN2 / CTX|P66 (122)|-|-|-|
|RSPI0 / RSPCK|PA5 (108)|PC5 (78)|-|-|
|RSPI0 / MOSI|PA6 (107)|PC6 (77)|-|-|
|RSPI0 / MISO|PA7 (106)|PC& (76)|-|-|
|RSPI0 / SSL0|PA4 (109)|PC4 (82)|-|-|
|RSPI0 / SSL1|PA0 (118)|PC0 (91)|-|-|
|RSPI0 / SSL2|PA1 (114)|PC1 (89)|-|-|
|RSPI0 / SSL3|PA2 (112)|PC2 (86)|-|-|
|RSPI1 / RSPCK|P27 (36)|PC5 (78)|-|-|
|RSPI1 / MOSI|P26 (37)|PC6 (77)|-|-|
|RSPI1 / MISO|P30 (33)|PC& (76)|-|-|
|RSPI1 / SSL0|P31 (32)|PE4 (131)|-|-|
|RSPI1 / SSL1|P50 (72)|PE0 (135)|-|-|
|RSPI1 / SSL2|P51 (71)|PE1 (134)|-|-|
|RSPI1 / SSL3|P52 (70)|PE2 (133)|-|-|
|SSI0 / AUDIO_CLK|P22 (43)|-|-|-|
|SSI0 / SSISCK0|P23 (42)|-|-|-|
|SSI0 / SSIWS0|P21 (44)|-|-|-|
|SSI0 / SSIRXD0|P20 (45)|-|-|-|
|SSI0 / SSITXD0|P17 (46)|-|-|-|
|SSI1 / AUDIO_CLK|P22 (43)|-|-|-|
|SSI1 / SSISCK1|P24 (40)|-|-|-|
|SSI1 / SSIWS1|P15 (50)|-|-|-|
|SSI1 / SSIDATA1|P25 (38)|-|-|-|
|USB0 / VBUS|P16 (48)|-|-|-|
|USB0 / EXICEN|P21 (44)|-|-|-|
|USB0 / VBUSEN|P16 (48)|P24 (40)|P32 (29)|-|
|USB0 / OVRCURA|P14 (51)|-|-|-|
|USB0 / OVRCURB|P16 (48)|P22 (43)|-|-|
|USB0 / ID|P20 (45)|-|-|-|

---

## Port map order (GPTW) / ポートマップ候補 (GPT)

- [port_map_gpt.hpp](../RX64M/port_map_gpt.hpp?ts=4)

### LFQGFP100

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

### LFQGFP144

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

### LFQGFP176

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

---

## Port map order (MTU) / ポートマップ候補 (MTU)

- [port_map_mtu.hpp](../RX64M/port_map_mtu.hpp?ts=4)

### LFQFP100

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

### LFQFP144

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

### LFQFP176

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

---

## Port map order (TPU) / ポートマップ候補 (TPU)

- [port_map_tpu.hpp](port_map_tpu.hpp?ts=4)

### LFQFP100

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

### LFQFP144

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

### LFQFP176

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

---

## Port map order (TMR) / ポートマップ候補 (TMR)

- [port_map_tmr.hpp](../RX63x/port_map_tmr.hpp?ts=4)

### LFQFP100

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

### LFQFP144

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

### LFQFP176

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

---

## Port map order (QSPI) / ポートマップ候補 (QSPI)

- [port_map_qspi.hpp](../RX64M/port_map_qspi.hpp?ts=4)

### LFQFP100

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

### LFQFP144

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

### LFQFP176

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

---

## Port map order (ETHERC0) / ポートマップ候補 (ETHERC0)

- [port_map_ether.hpp](../RX64M/port_map_ether.hpp?ts=4)

### LFQFP100

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

### LFQFP144

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

### LFQFP176

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

---

## Port map order (ETHERC1) / ポートマップ候補 (ETHERC1)

- [port_map_ether.hpp](../RX64M/port_map_ether.hpp?ts=4)

### LFQFP100

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

### LFQFP144

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

### LFQFP176

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

---

## 12 Bits A/D Converter input (S12AD) / 12 ビット A/D コンバーター入力 (S12AD)

- [s12adf.hpp](../RX600/s12adf.hpp?ts=4)

### LFQFP100

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

### LFQFP144

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

### LFQFP176

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

---

## 12 Bits D/A Converter output (R12DA) / 12 ビット D/A コンバーター出力 (R12DA)

- [r12da.hpp](../RX600/r12da.hpp?ts=4)

### LFQFP100

|R12DA/ANALOG|Port|
|---|---|
|DA0|P03 (---)|
|DA1|P05 (100)|

### LFQFP144

|R12DA/ANALOG|Port|
|---|---|
|DA0|P03 (4)|
|DA1|P05 (2)|

### LFQFP176

|R12DA/ANALOG|Port|
|---|---|
|DA0|P03 (4)|
|DA1|P05 (2)|

---

## rx_prog Flash Programming / rx_prog フラッシュプログラム

||Support/サポート|operation verification/動作検証|
|-|:-:|:-:|
|[rxprog](../rxprog)|〇|〇|

---

Translated with www.DeepL.com/Translator (free version)

---

## License

[MIT](../LICENSE)
