hirakuni45/RX/RX72M/README.md

## RX72M features / 特徴

- RXv3 core / RXv3 コア
- Maximum operating frequency 240MHz / 最大動作周波数 240MHz
- Single-precision 32-bit floating point / 32 ビット単精度浮動小数点
- Double-precision 64-bit IEEE-754 floating point / 64 ビット倍精度浮動小数点
- 2.7V ～ 3.6V Operation / 動作
- IEEE1588 Ether-MAC (10/100 Mbps)
- USB2.0 Full Speed, Host, Function
- CAN (ISO11898-1)
- Serial Sound Interface (SSIE) / シリアルサウンドインタフェース (SSIE)
- SD Host Interface (SDHI) / SD ホストインタフェース (SDHI)
- Graphic LCD Controller (GLCDC) / グラフィック LCD コントローラ (GLCDC)
- 2D Drawing Engine (DRW2D) / 2D 描画エンジン (DRW2D)
- Arithmetic Unit for Trigonometric Functions (TFUv1) / 三角関数演算器 (TFUv1)
- 12 Bits A/D / １２ビットＡ／Ｄ変換器
- 12 Bits D/A / １２ビットＤ／Ａ変換器

### Package/パッケージ

|R5F572M---XX|Package/パッケージ|Pin/ピン数|Pitch/ピッチ|
|---|:-:|:-:|:-:|
|R5F572MxxxBD|LFBGA|224|0.80|
|R5F572MxxxFC|LFQFP|176|0.50|
|R5F572MxxxBG|LFBGA|176|0.80|

### Ambient operating temperature/動作周囲温度

|R5F572M--X--|degree Celsius|
|---|:-:|
|R5F572MxxDxx|-40 ～ +85℃|
|R5F572MxxGxx|-40 ～ +105℃|

### Crypt/暗号

|R5F572M-X---|Crypt|
|---|:-:|
|R5F572MxDxxx|-|
|R5F572MxHxxx|〇|

### Memoey size/メモリ容量

|R5F572MX----|CodeFlash|RAM|ECCRAM|StanbyRAM|DataFlash|
|---|:-:|:-:|:-:|:-:|:-:|
|R5F572MNxxxx|4M|1M|32K|8K|32K|
|R5F572MDxxxx|2M|1M|32K|8K|32K|

### Data Flash/データ・フラッシュ

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

---

## RX72M Linker file / リンカーファイル

|Type|Code Flash|RAM|Data Flash|Linker File|Ustack|Istack|
|---|:-:|:-:|:-:|---|:-:|:-:|
|R5F572MN|4096K|512K+512K+32K+8K|64K|[R5F572MN.ld](R5F572MN.ld?ts=4)|12288|4096|
|R5F572MD|2048K|512K+512K+32K+8K|64K|[R5F572MD.ld](R5F572MD.ld?ts=4)|12288|4096|

---

## RX72M Dedicated class / 専用クラス

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

---

## Basic Pin Assignments / 基本ピンアサイン

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

- VCL: 0.22uF/25V

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

- EMLE: 0

---

## Device, Renesas / デバイス、ルネサス

- [device.hpp (SIG_RX72M)](../common/device.hpp?ts=4)
- [renesas.hpp (SIG_RX72M)](../common/renesas.hpp?ts=4)

|name space|Device, Renesas|デバイス、ルネサス|
|---|---|---|
|[clock_profile](../RX72M/clock_profile?ts=4)|Clock Profile|クロック・プロファイル|
|[SYSTEM](../RX600/system.hpp?ts=4)|Clock Generation Circuit|クロック発生回路|
|[power_mgr](../RX72M/power_mgr.hpp?ts=4)|Low Power Consumption|消費電力低減機能|
|[ICU](../RX72M/icu.hpp?ts=4)|Interrupt Controller|割り込みコントローラ|
|[icu_mgr](../RX72M/icu_mgr.hpp?ts=4)|ICU Manager|ICU マネージャー|
|[MPC](../RX72M/mpc.hpp?ts=4)|Multi-Function Pin Controller|マルチファンクションピンコントローラ|
|[PORTx](../RX72M/port.hpp?ts=4)|I/O Ports|I/O ポート|
|[port_map](../RX72N/port_map.hpp?ts=4)|Port Mapping|ポート・マッピング|
|[port_map_mtu](../RX72N/port_map_mtu.hpp?ts=4)|Port Mapping MTU|ポート・マッピング MTU|
|[port_map_tpu](../RX72N/port_map_tpu.hpp?ts=4)|Port Mapping TPU|ポート・マッピング TPU|
|[port_map_tmr](../RX63x/port_map_tmr.hpp?ts=4)|Port Mapping TMR|ポート・マッピング TMR|
|[port_map_qspi](../RX72N/port_map_qspi.hpp?ts=4)|Port Mapping QSPI|ポート・マッピング QSPI|
|[port_map_ether](../RX72N/port_map_ether.hpp?ts=4)|Port Mapping ETHER|ポート・マッピング ETHER|
|[port_map_irq](../RX600/port_map_irq.hpp?ts=4)|Port Mapping IRQ|ポート・マッピング IRQ|
|[FLASH](../RX600/flash.hpp?ts=4)|Flash Memory|フラッシュメモリ|
|[SYSTEM_IO](../RX600/system_io.hpp?ts=4)|System In/Out (Clock Setting)|システム In/Out (クロック設定)|
|[FLASH_IO](../RX600/flash_io.hpp?ts=4)|Flash In/Out|フラッシュ In/Out|
|[adc_in](../RX600/adc_in.hpp?ts=4)|A/D Converter Input|A/D 変換入力|
|[dac_out](../RX600/dac_out.hpp?ts=4)|D/A Converter Output|D/A 変換出力|
|[board_profile](../RX72M/board_profile?ts=4)|Board Profile|ボード・プロファイル|

---

## Peripheral / ペリフェラル

- [peripheral.hpp](peripheral.hpp?ts=4)

|Peripheral|Function|機能|
|---|---|---|
|[CAC](../RX600/cac.hpp?ts=4)|Clock Frequency Accuracy Measurement Circuit|クロック周波数精度測定回路|
|[ELC](../RX600/elc.hpp?ts=4)|Event Link Controller|イベントリンクコントローラ|
|[DMAC0](../RX600/dmac.hpp?ts=4)|DMA Controller channel 0|DMA コントローラ・チャネル０|
|[DMAC1](../RX600/dmac.hpp?ts=4)|DMA Controller channel 1|DMA コントローラ・チャネル１|
|[DMAC2](../RX600/dmac.hpp?ts=4)|DMA Controller channel 2|DMA コントローラ・チャネル２|
|[DMAC3](../RX600/dmac.hpp?ts=4)|DMA Controller channel 3|DMA コントローラ・チャネル３|
|[DMAC4](../RX600/dmac.hpp?ts=4)|DMA Controller channel 4|DMA コントローラ・チャネル４|
|[DMAC5](../RX600/dmac.hpp?ts=4)|DMA Controller channel 5|DMA コントローラ・チャネル５|
|[DMAC6](../RX600/dmac.hpp?ts=4)|DMA Controller channel 6|DMA コントローラ・チャネル６|
|[DMAC7](../RX600/dmac.hpp?ts=4)|DMA Controller channel 7|DMA コントローラ・チャネル７|
|[DTC](../RX600/dtc.hpp?ts=4)|Data Transfer Controller|データトランスファコントローラ|
|[EXDMAC0](../RX600/exdmac.hpp?ts=4)|EXDMA Controller channel 0|EXDMA コントローラ・チャネル０|
|[EXDMAC1](../RX600/exdmac.hpp?ts=4)|EXDMA Controller channel 1|EXDMA コントローラ・チャネル１|
|[MTU0](../RX600/mtu3.hpp?ts=4)|Multi-Function Timer Pulse Unit 0|マルチファンクションタイマパルスユニット０|
|[MTU1](../RX600/mtu3.hpp?ts=4)|Multi-Function Timer Pulse Unit 1|マルチファンクションタイマパルスユニット１|
|[MTU2](../RX600/mtu3.hpp?ts=4)|Multi-Function Timer Pulse Unit 2|マルチファンクションタイマパルスユニット２|
|[MTU3](../RX600/mtu3.hpp?ts=4)|Multi-Function Timer Pulse Unit 3|マルチファンクションタイマパルスユニット３|
|[MTU4](../RX600/mtu3.hpp?ts=4)|Multi-Function Timer Pulse Unit 4|マルチファンクションタイマパルスユニット４|
|[MTU5](../RX600/mtu3.hpp?ts=4)|Multi-Function Timer Pulse Unit 5|マルチファンクションタイマパルスユニット５|
|[MTU6](../RX600/mtu3.hpp?ts=4)|Multi-Function Timer Pulse Unit 6|マルチファンクションタイマパルスユニット６|
|[MTU7](../RX600/mtu3.hpp?ts=4)|Multi-Function Timer Pulse Unit 7|マルチファンクションタイマパルスユニット７|
|[MTU8](../RX600/mtu3.hpp?ts=4)|Multi-Function Timer Pulse Unit 8|マルチファンクションタイマパルスユニット８|
|[POE3](../RX72N/poe3.hpp?ts=4)|Port Output Enable 3|ポートアウトプットイネーブル３|
|[GPTW0](../RX600/gptw.hpp?ts=4)|General PWM Timer 0|汎用 PWM タイマ０|
|[GPTW1](../RX600/gptw.hpp?ts=4)|General PWM Timer 1|汎用 PWM タイマ１|
|[GPTW2](../RX600/gptw.hpp?ts=4)|General PWM Timer 2|汎用 PWM タイマ２|
|[GPTW3](../RX600/gptw.hpp?ts=4)|General PWM Timer 3|汎用 PWM タイマ３|
|[TPU0](../RX600/tpu.hpp?ts=4)|16-Bit Timer Pulse Unit 0|16 ビットタイマパルスユニット０|
|[TPU1](../RX600/tpu.hpp?ts=4)|16-Bit Timer Pulse Unit 1|16 ビットタイマパルスユニット１|
|[TPU2](../RX600/tpu.hpp?ts=4)|16-Bit Timer Pulse Unit 2|16 ビットタイマパルスユニット２|
|[TPU3](../RX600/tpu.hpp?ts=4)|16-Bit Timer Pulse Unit 3|16 ビットタイマパルスユニット３|
|[TPU4](../RX600/tpu.hpp?ts=4)|16-Bit Timer Pulse Unit 4|16 ビットタイマパルスユニット４|
|[TPU5](../RX600/tpu.hpp?ts=4)|16-Bit Timer Pulse Unit 5|16 ビットタイマパルスユニット５|
|[PPG0](../RX600/ppg.hpp?ts=4)|Programmable Pulse Generator 0|プログラマブルパルスジェネレータ０|
|[PPG1](../RX600/ppg.hpp?ts=4)|Programmable Pulse Generator 1|プログラマブルパルスジェネレータ１|
|[TMR0](../RX600/tmr.hpp?ts=4)|8-Bit Timer 0|8 ビットタイマ０|
|[TMR1](../RX600/tmr.hpp?ts=4)|8-Bit Timer 1|8 ビットタイマ１|
|[TMR2](../RX600/tmr.hpp?ts=4)|8-Bit Timer 2|8 ビットタイマ２|
|[TMR3](../RX600/tmr.hpp?ts=4)|8-Bit Timer 3|8 ビットタイマ３|
|[CMT0](../RX600/cmt.hpp?ts=4)|Compare Match Timer 0|コンペアマッチタイマ０|
|[CMT1](../RX600/cmt.hpp?ts=4)|Compare Match Timer 1|コンペアマッチタイマ１|
|[CMT2](../RX600/cmt.hpp?ts=4)|Compare Match Timer 2|コンペアマッチタイマ２|
|[CMT3](../RX600/cmt.hpp?ts=4)|Compare Match Timer 3|コンペアマッチタイマ３|
|[CMTW0](../RX600/cmtw.hpp?ts=4)|Compare Match Timer W0|コンペアマッチタイマＷ０|
|[CMTW1](../RX600/cmtw.hpp?ts=4)|Compare Match Timer W1|コンペアマッチタイマＷ１|
|[RTC](../RX600/rtc.hpp?ts=4)|Realtime Clock|リアルタイムクロック|
|[WDTA](../RX600/wdta.hpp?ts=4)|Watchdog Timer|ウォッチドッグタイマ|
|[IWDT](../RX600/iwdt.hpp?ts=4)|Independent Watchdog Timer|独立ウォッチドッグタイマ|
|[ETHERC0](../RX600/etherc.hpp?ts=4)|Ethernet Controller 0|イーサネットコントローラ０|
|[ETHERC1](../RX600/etherc.hpp?ts=4)|Ethernet Controller 1|イーサネットコントローラ１|
|[EPTPC](../RX600/eptpc.hpp?ts=4)|PTP Module for the Ethernet Controller|イーサネットコントローラ用 PTP コントローラ|
|[EPTPC0](../RX600/eptpc.hpp?ts=4)|PTP Module for the Ethernet Controller 0|イーサネットコントローラ用 PTP コントローラ０|
|[EPTPC1](../RX600/eptpc.hpp?ts=4)|PTP Module for the Ethernet Controller 1|イーサネットコントローラ用 PTP コントローラ１|
|[EDMAC0](../RX600/edmac.hpp?ts=4)|DMA Controller for the Ethernet Controller 0|イーサネットコントローラ用 DMA コントローラ０|
|[PTPEDMAC](../RX600/edmac.hpp?ts=4)|PTP Ethernet DMA|PTP イーサネット DMA|
|[PMGI0](../RX600/pmgi.hpp?ts=4)|PHY Management Interface 0|PHY マネジメントインタフェース０|
|[PMGI1](../RX600/pmgi.hpp?ts=4)|PHY Management Interface 1|PHY マネジメントインタフェース１|
|[ESC](../RX600/esc.hpp?ts=4)|EtherCAT Slave Controller|EtherCAT スレーブコントローラ|
|[USB0](../RX600/usb.hpp?ts=4)|USB 2.0 FS Host/Function Module 0|USB 2.0 FS ホスト/ファンクションモジュール０|
|[SCI0](../RX600/sci_j.hpp?ts=4)|Serial Communications Interface 0|シリアルコミュニケーションインタフェース０|
|[SCI1](../RX600/sci_j.hpp?ts=4)|Serial Communications Interface 1|シリアルコミュニケーションインタフェース１|
|[SCI2](../RX600/sci_j.hpp?ts=4)|Serial Communications Interface 2|シリアルコミュニケーションインタフェース２|
|[SCI3](../RX600/sci_j.hpp?ts=4)|Serial Communications Interface 3|シリアルコミュニケーションインタフェース３|
|[SCI4](../RX600/sci_j.hpp?ts=4)|Serial Communications Interface 4|シリアルコミュニケーションインタフェース４|
|[SCI5](../RX600/sci_j.hpp?ts=4)|Serial Communications Interface 5|シリアルコミュニケーションインタフェース５|
|[SCI6](../RX600/sci_j.hpp?ts=4)|Serial Communications Interface 6|シリアルコミュニケーションインタフェース６|
|[SCI7](../RX600/sci_i.hpp?ts=4)|Serial Communications Interface 7|シリアルコミュニケーションインタフェース７|
|[SCI8](../RX600/sci_i.hpp?ts=4)|Serial Communications Interface 8|シリアルコミュニケーションインタフェース８|
|[SCI9](../RX600/sci_i.hpp?ts=4)|Serial Communications Interface 9|シリアルコミュニケーションインタフェース９|
|[SCI10](../RX600/sci_i.hpp?ts=4)|Serial Communications Interface 10|シリアルコミュニケーションインタフェース１０|
|[SCI11](../RX600/sci_i.hpp?ts=4)|Serial Communications Interface 11|シリアルコミュニケーションインタフェース１１|
|[SCI12](../RX600/sci_h.hpp?ts=4)|Serial Communications Interface 12|シリアルコミュニケーションインタフェース１２|
|[RIIC0](../RX600/riic.hpp?ts=4)|I2C-bus Interface 0|I2C バスインタフェース０|
|[RIIC1](../RX600/riic.hpp?ts=4)|I2C-bus Interface 1|I2C バスインタフェース１|
|[RIIC2](../RX600/riic.hpp?ts=4)|I2C-bus Interface 2|I2C バスインタフェース２|
|[CAN0](../RX600/can.hpp?ts=4)|CAN Module 0|CAN モジュール０|
|[CAN1](../RX600/can.hpp?ts=4)|CAN Module 1|CAN モジュール１|
|[CAN2](../RX600/can.hpp?ts=4)|CAN Module 2|CAN モジュール２|
|[RSPI0](../RX600/rspi.hpp?ts=4)|Serial Peripheral Interface 0|シリアルペリフェラルインタフェース０|
|[RSPI1](../RX600/rspi.hpp?ts=4)|Serial Peripheral Interface 1|シリアルペリフェラルインタフェース１|
|[RSPI2](../RX600/rspi.hpp?ts=4)|Serial Peripheral Interface 2|シリアルペリフェラルインタフェース２|
|[QSPI](../RX600/qspi.hpp?ts=4)|Quad-SPI Memory Interface|クワッド SPI メモリインタフェース|
|[CRC](../RX600/crca.hpp?ts=4)|CRC Calculator|CRC 演算器|
|[SSIE0](../RX600/ssie.hpp?ts=4)|Serial Sound Interface 0|シリアルサウンドインタフェース０|
|[SSIE1](../RX600/ssie.hpp?ts=4)|Serial Sound Interface 1|シリアルサウンドインタフェース１|
|[SDHI](../RX600/sdhi.hpp?ts=4)|SD Host Interface|SD ホストインタフェース|
|[MMCIF](../RX600/mmcif.hpp?ts=4)|MultiMediaCard Interface|マルチメディアカードインタフェース|
|[PDC](../RX600/pdc.hpp?ts=4)|Parallel Data Capture Unit|パラレルデータキャプチャユニット|
|[GLCDC](../RX600/glcdc.hpp?ts=4)|Graphic LCD Controller|グラフィックスＬＣＤコントローラ|
|[DRW2D](../RX600/drw2d.hpp?ts=4)|2D Drawing Engine|２Ｄ描画エンジン|
|TSIP|Trusted Secure IP|Trusted Secure IP|
|[DSMIF0](../RX600/dsmif.hpp?ts=4)|ΔΣ Modulator Interface 0|ΔΣモジュレータインターフェース０|
|[DSMIF1](../RX600/dsmif.hpp?ts=4)|ΔΣ Modulator Interface 1|ΔΣモジュレータインターフェース１|
|[S12AD](../RX600/s12adf.hpp?ts=4)|12-Bit A/D Converter|12 ビット A/D コンバータ|
|[S12AD1](../RX600/s12adf.hpp?ts=4)|12-Bit A/D Converter 1|12 ビット A/D コンバータ１|
|[R12DA](../RX600/r12da.hpp?ts=4)|12-Bit D/A Converter|12 ビット D/A コンバータ|
|[TEMPS](../RX600/system.hpp?ts=4)|Temperature Sensor|温度センサ|
|[DOC](../RX600/doc.hpp?ts=4)|Data Operation Circuit|データ演算回路|
|RAM|RAM (512K)|RAM (512K)|
|EXTRAM|Expansion RAM (512K)|拡張 RAM (512K)|
|ECCRAM|ECC RAM (32K)|ECC RAM (32K)|
|[STBRAM](../RX600/standby_ram.hpp?ts=4)|Standby RAM|スタンバイ RAM|

---

## Port map order (IRQ) / ポートマップ候補 (IRQ)

- [port_map_irq.hpp](port_map_irq.hpp?ts=4)

### LFQFP100

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

### LFQFP144

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

### LFQFP176

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

---

## Port map order / ポートマップ候補

- [port_map.hpp](,,/RX72N/port_map.hpp?ts=4)

### LFQFP100

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

### LFQFP144

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

### LFQFP176

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

---

## Port map order (GPTW) / ポートマップ候補 (GPTW)

- [port_map_gptw.hpp](,,/RX72N/port_map_gptw.hpp?ts=4)

### LFQGFP100

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

### LFQGFP144

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

### LFQGFP176

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

---

## Port map order (MTU) / ポートマップ候補 (MTU)

- [port_map_mtu.hpp](,,/RX72N/port_map_mtu.hpp?ts=4)

### LFQFP100

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

### LFQFP144

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

### LFQFP176

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

---

## Port map order (TPU) / ポートマップ候補 (TPU)

- [port_map_tpu.hpp](../RX72N/port_map_tpu.hpp?ts=4)

### LFQFP100

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

### LFQFP144

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

### LFQFP176

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

---

## Port map order (TMR) / ポートマップ候補 (TMR)

- [port_map_tmr.hpp](../RX63x/port_map_tmr.hpp?ts=4)

### LFQFP100

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

### LFQFP144

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

### LFQFP176

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

---

## Port map order (QSPI) / ポートマップ候補 (QSPI)

- [port_map_qspi.hpp](../RX72N/port_map_qspi.hpp?ts=4)

### LFQFP100

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

### LFQFP144

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

### LFQFP176

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

---

## Port map order (ETHERC0) / ポートマップ候補 (ETHERC0)

- [port_map_ether.hpp](../RX72N/port_map_ether.hpp?ts=4)

### LFQFP100

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

### LFQFP144

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

### LFQFP176

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

---

## Port map order (ETHERC1) / ポートマップ候補 (ETHERC1)

- [port_map_ether.hpp](../RX72N/port_map_ether.hpp?ts=4)

### LFQFP100

|ETHERC0|FIRST|SECOND|THIRD|
|---|---|---|---|
|ET1_MDC|P31 (19)|PD5 (81)|PN5 (---)|
|ET1_MDIO|P30 (20)|PD4 (82)|PN4 (---)|
|ET1_CRS|P92 (---)|PQ0 (---)|-|
|ET1_RX_DV|P90 (---)|PQ2 (---)|-|
|ET1_EX_OUT|P26 (22)|PD2 (84)|-|
|ET1_LINKSTA|P84 (---)|P93 (---)|-|
|ET1_ETXD0|P64 (---)|PG3 (---)|PQ5 (---)|
|ET1_ETXD1|P63 (---)|PG4 (---)|PQ6 (---)|
|ET1_ETXD2|PG5 (---)|PM0 (---)|-|
|ET1_ETXD3|PG6 (---)|PN1 (---)|-|
|ET1_ERXD0|P62 (---)|P94 (---)|PM0 (---)|
|ET1_ERXD1|P61 (---)|P95 (---)|PM1 (---)|
|ET1_ERXD2|P96 (---)|PM2 (---)|-|
|ET1_ERXD3|P97 (---)|PM3 (---)|-|
|ET1_TX_EN|P60 (---)|PQ7 (---)|-|
|ET1_TX_ER|PG7 (---)|PQ3 (---)|-|
|ET1_RX_ER|PD7 (79)|PG1 (---)|PN3 (---)|
|ET1_TX_CLK|PG2 (---)|PN2 (---)|-|
|ET1_RX_CLK|PD6 (80)|PG0 (---)|PQ4 (---)|
|ET1_COL|P91 (---)|PQ1 (---)|-|
|ET1_WOL|P27 (21)|PD3 (83)|-|
|REF50CK1|PD6 (80)|PG0 (---)|PQ4 (---)|
|RMII1_CRS_DV|P92 (---)|PQ0 (---)|-|
|RMII1_TXD0|P64 (---)|PG3 (---)|PQ5 (---)|
|RMII1_TXD1|P63 (---)|PG4 (---)|PQ6 (---)|
|RMII1_RXD0|P62 (---)|P94 (---)|PM0 (---)|
|RMII1_RXD1|P61 (---)|P95 (---)|PM1 (---)|
|RMII1_TXD_EN|P60 (---)|PQ7 (---)|-|
|RMII1_RX_ER|PD7 (79)|PG1 (---)|PN3 (---)|

### LFQFP144

|ETHERC0|FIRST|SECOND|THIRD|
|---|---|---|---|
|ET1_MDC|P31 (28)|PD5 (121)|PN5 (---)|
|ET1_MDIO|P30 (29)|PD4 (122)|PN4 (---)|
|ET1_CRS|P92 (128)|PQ0 (---)|-|
|ET1_RX_DV|P90 (131)|PQ2 (---)|-|
|ET1_EX_OUT|P26 (31)|PD2 (124)|-|
|ET1_LINKSTA|P84 (---)|P93 (127)|-|
|ET1_ETXD0|P64 (112)|PG3 (---)|PQ5 (---)|
|ET1_ETXD1|P63 (113)|PG4 (---)|PQ6 (---)|
|ET1_ETXD2|PG5 (---)|PM0 (---)|-|
|ET1_ETXD3|PG6 (---)|PN1 (---)|-|
|ET1_ERXD0|P62 (114)|P94 (---)|PM0 (---)|
|ET1_ERXD1|P61 (115)|P95 (---)|PM1 (---)|
|ET1_ERXD2|P96 (---)|PM2 (---)|-|
|ET1_ERXD3|P97 (---)|PM3 (---)|-|
|ET1_TX_EN|P60 (117)|PQ7 (---)|-|
|ET1_TX_ER|PG7 (---)|PQ3 (---)|-|
|ET1_RX_ER|PD7 (119)|PG1 (---)|PN3 (---)|
|ET1_TX_CLK|PG2 (---)|PN2 (---)|-|
|ET1_RX_CLK|PD6 (120)|PG0 (---)|PQ4 (---)|
|ET1_COL|P91 (129)|PQ1 (---)|-|
|ET1_WOL|P27 (30)|PD3 (123)|-|
|REF50CK1|PD6 (120)|PG0 (---)|PQ4 (---)|
|RMII1_CRS_DV|P92 (128)|PQ0 (---)|-|
|RMII1_TXD0|P64 (112)|PG3 (---)|PQ5 (---)|
|RMII1_TXD1|P63 (113)|PG4 (---)|PQ6 (---)|
|RMII1_RXD0|P62 (114)|P94 (---)|PM0 (---)|
|RMII1_RXD1|P61 (115)|P95 (---)|PM1 (---)|
|RMII1_TXD_EN|P60 (117)|PQ7 (---)|-|
|RMII1_RX_ER|PD7 (119)|PG1 (---)|PN3 (---)|

### LFQFP176

|ETHERC0|FIRST|SECOND|THIRD|
|---|---|---|---|
|ET1_MDC|P31 (32)|PD5 (147)|PN5 (---)|
|ET1_MDIO|P30 (33)|PD4 (147)|PN4 (---)|
|ET1_CRS|P92 (160)|PQ0 (---)|-|
|ET1_RX_DV|P90 (163)|PQ2 (---)|-|
|ET1_EX_OUT|P26 (37)|PD2 (154)|-|
|ET1_LINKSTA|P84 (62)|P93 (159)|-|
|ET1_ETXD0|P64 (136)|PG3 (121)|PQ5 (---)|
|ET1_ETXD1|P63 (137)|PG4 (119)|PQ6 (---)|
|ET1_ETXD2|PG5 (116)|PM0 (---)|-|
|ET1_ETXD3|PG6 (113)|PN1 (---)|-|
|ET1_ERXD0|P62 (138)|P94 (157)|PM0 (---)|
|ET1_ERXD1|P61 (139)|P95 (155)|PM1 (---)|
|ET1_ERXD2|P96 (152)|PM2 (---)|-|
|ET1_ERXD3|P97 (149)|PM3 (---)|-|
|ET1_TX_EN|P60 (141)|PQ7 (---)|-|
|ET1_TX_ER|PG7 (111)|PQ3 (---)|-|
|ET1_RX_ER|PD7 (143)|PG1 (144)|PN3 (---)|
|ET1_TX_CLK|PG2 (123)|PN2 (---)|-|
|ET1_RX_CLK|PD6 (145)|PG0 (146)|PQ4 (---)|
|ET1_COL|P91 (161)|PQ1 (---)|-|
|ET1_WOL|P27 (36)|PD3 (150)|-|
|REF50CK1|PD6 (145)|PG0 (146)|PQ4 (---)|
|RMII1_CRS_DV|P92 (160)|PQ0 (---)|-|
|RMII1_TXD0|P64 (136)|PG3 (121)|PQ5 (---)|
|RMII1_TXD1|P63 (137)|PG4 (119)|PQ6 (---)|
|RMII1_RXD0|P62 (138)|P94 (157)|PM0 (---)|
|RMII1_RXD1|P61 (139)|P95 (155)|PM1 (---)|
|RMII1_TXD_EN|P60 (141)|PQ7 (---)|-|
|RMII1_RX_ER|PD7 (143)|PG1 (144)|PN3 (---)|

---

## 12 Bits A/D Converter input (S12AD) / 12 ビット A/D コンバーター入力 (S12AD)

- [s12adf.hpp](../RX600/s12adf.hpp?ts=4)

### LFQFP100

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

### LFQFP144

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

### LFQFP176

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

---

## 12 Bits D/A Converter output (R12DA) / 12 ビット D/A コンバーター出力 (R12DA)

- [r12da.hpp](../RX600/r12da.hpp?ts=4)

### LFQFP100

|R12DA/ANALOG|Port|
|---|---|
|DA0|P03 (---)|
|DA1|P05 (100)|

### LFQFP144

|R12DA/ANALOG|Port|
|---|---|
|DA0|P03 (4)|
|DA1|P05 (2)|

### LFQFP176

|R12DA/ANALOG|Port|
|---|---|
|DA0|P03 (4)|
|DA1|P05 (2)|

---

## rx_prog Flash Programming / rx_prog フラッシュプログラム

||Support/サポート|operation verification/動作検証|
|-|:-:|:-:|
|[rxprog](../rxprog)|〇|-|

---

Translated with www.DeepL.com/Translator (free version)

---

## License

[MIT](../LICENSE)
