hirakuni45/RX/RX24U/README.md

## RX24U features / 特徴

- RXv2 core / RXv2 コア
- Maximum operating frequency 80MHz / 最大動作周波数 80MHz
- Single-precision 32-bit floating point / 32 ビット単精度浮動小数点
- 2.7V ～ 5.5V Operation / 動作
- 12 Bits A/D / １２ビットＡ／Ｄ変換器
- 8 Bits D/A / ８ビットＤ／Ａ変換器

### Package/パッケージ

|R5F524U---XX|Package/パッケージ|Pin/ピン数|Pitch/ピッチ|
|---|:-:|:-:|:-:|
|R5F524UxxxFB|LFQFP|144|0.50|
|R5F524UxxxFP|LFQFP|100|0.50|

### Ambient operating temperature/動作周囲温度

|R5F524U--X--|degree Celsius|
|---|:-:|
|R5F524UxxDxx|-40 ～ +85℃|

### Memoey size/メモリ容量

|R5F524UX----|CodeFlash|RAM|DataFlash|
|---|:-:|:-:|:-:|
|R5F524UExxxx|512K|32K|8K|
|R5F524UCxxxx|384K|32K|8K|
|R5F524UBxxxx|256K|32K|8K|

### Data Flash/データ・フラッシュ

|Capacity|Erase Size|Blank Check Size|Write Size|Erase Value|ID|
|:-:|:-:|:-:|:-:|:-:|:-:|
|8K|1024|1/1024|1|0xFF|4|

---

## RX24U Linker file / リンカーファイル

|Type|Code Flash|RAM|Data Flash|Linker File|Ustack|Istack|
|---|:-:|:-:|:-:|---|:-:|:-:|
|R5F524UE|512K|32K|8K|[R5F524UE.ld](R5F524UE.ld?ts=4)|1536|512|
|R5F524UB|256K|32K|8K|[R5F524UB.ld](R5F524UB.ld?ts=4)|1536|512|

---

## RX24U Dedicated class / 専用クラス

|Function/機能|Source|Remarks/備考|
|---|---|:-:|
|Peripheral Name/ペリフェラル名|[peripheral.hpp](peripheral.hpp?ts=4)||
|Hardware-specific Definition/ハード固有定義|[board_profile.hpp](board_profile.hpp?ts=4)||
|Operating Frequency Definition/動作周波数定義|[clock_profile.hpp](clock_profile.hpp?ts=4)||
|Power Control/電力制御|[power_mgr.hpp](power_mgr.hpp?ts=4)||
|Interrupt Definition/割り込み定義|[icu.hpp](icu.hpp?ts=4)||

---

## Basic Pin Assignments / 基本ピンアサイン

|Terminal/端子|LFQFP 100|LFQFP 144|
|---|---|---|
|VCL|VCL(5)|VCL(5)|
|Reset Input/リセット入力|RES#(10)|RES#(10)|
|Mode Controle/モード制御|MD/FINED(6)|MD/FINED(6)|
|RXD|PD5/RXD1(20)|PD5/RXD1(27)|
|TXD|PD3/TXD1(22)|PD3/TXD1(29)|
|Power/電源|VCC(14), VCC(29), VCC(42), VCC(60)|VCC(6), VCC(20), VCC(21), VCC(40)|
|Power/電源|-|VCC(63), VCC(85), VCC(86)|
|GND/接地|VSS(3), VSS(12), VSS(31), VSS(44)|VSS(8), VSS(9), VSS(18), VSS(42)|
|GND/接地|VSS(62)|VSS(65), VSS(66), VSS(88), VSS(89)|
|Analog Power/アナログ電源|AVCC0(93), AVCC1(92), AVCC2(72)|AVCC0(129), AVCC1(127), AVCC2(104)|
|Analog GND/アナログ接地|AVSS0(94), AVSS1(95), AVSS2(73)|AVSS0(131), AVSS1(133), AVSS2(105)|
|Programable Gain AMP GND0|PGAVSS0(91)|PGAVSS0(126)|
|Programable Gain AMP GND1|PGAVSS1(86)|PGAVSS1(121)|
|Analog Refarence L0/アナログ基準電源Ｌ0|-|VREFL0(132)|
|Analog Refarence H0/アナログ基準電源Ｈ0|-|VREFH0(130)|
|Analog Refarence L1/アナログ基準電源Ｌ0|-|VREFL1(134)|
|Analog Refarence H1/アナログ基準電源Ｈ0|-|VREFH1(128)|
|Analog Refarence L2/アナログ基準電源Ｌ0|-|VREFL2(106)|
|Analog Refarence H2/アナログ基準電源Ｈ0|-|VREFH2(103)|
|OSC in|EXTAL(13)|EXTAL(19)|
|OSC out|XTAL(11)|XTAL(17)|

- VCL: 4.7uF/25V

|Mode/モード|MD|
|---|:---:|
|Serial BOOT/シリアルブート|0|
|Single Chip/シングルチップ|1|

---

## Device, Renesas / デバイス、ルネサス

- [device.hpp (SIG_RX24U)](../common/device.hpp?ts=4)
- [renesas.hpp (SIG_RX24U)](../common/renesas.hpp?ts=4)

|name space|Device, Renesas|デバイス、ルネサス|
|---|---|---|
|[clock_profile](../RX24U/clock_profile?ts=4)|Clock Profile|クロック・プロファイル|
|[SYSTEM](../RX24T/system.hpp?ts=4)|Clock Generation Circuit|クロック発生回路|
|[power_mgr](../RX24T/power_mgr.hpp?ts=4)|Low Power Consumption|消費電力低減機能|
|[ICU](../RX24U/icu.hpp?ts=4)|Interrupt Controller|割り込みコントローラ|
|[icu_mgr](../RX24T/icu_mgr.hpp?ts=4)|ICU Manager|ICU マネージャー|
|[MPC](../RX24U/mpc.hpp?ts=4)|Multi-Function Pin Controller|マルチファンクションピンコントローラ|
|[PORTx](../RX24U/port.hpp?ts=4)|I/O Ports|I/O ポート|
|[port_map](../RX24U/port_map.hpp?ts=4)|Port Mapping|ポート・マッピング|
|[port_map_mtu](../RX24U/port_map_mtu.hpp?ts=4)|Port Mapping MTU|ポート・マッピング MTU|
|[port_map_gpt](../RX24U/port_map_gpt.hpp?ts=4)|Port Mapping GPT|ポート・マッピング GPT|
|[port_map_tmr](../RX24U/port_map_tmr.hpp?ts=4)|Port Mapping TMR|ポート・マッピング TMR|
|[port_map_irq](../RX24U/port_map_irq.hpp?ts=4)|Port Mapping IRQ|ポート・マッピング IRQ|
|[FLASH](../RX24T/flash.hpp?ts=4)|Flash Memory|フラッシュメモリ|
|[SYSTEM_IO](../RX24T/system_io.hpp?ts=4)|System In/Out (Clock Setting)|システム In/Out (クロック設定)|
|[FLASH_IO](../RX24T/flash_io.hpp?ts=4)|Flash In/Out|フラッシュ In/Out|
|[adc_in](../RX24T/adc_in.hpp?ts=4)|A/D Converter Input|A/D 変換入力|
|[dac_out](../RX24T/dac_out.hpp?ts=4)|D/A Converter Output|D/A 変換出力|
|[board_profile](../RX24U/board_profile?ts=4)|Board Profile|ボード・プロファイル|

---

## Peripheral / ペリフェラル

- [peripheral.hpp](peripheral.hpp?ts=4)

|Peripheral|Function|機能|
|---|---|---|
|[CAC](../RX600/cac.hpp?ts=4)|Clock Frequency Accuracy Measurement Circuit|クロック周波数精度測定回路|
|[DTC](../RX600/dtc.hpp?ts=4)|Data Transfer Controller|データトランスファコントローラ|
|[MTU0](../RX600/mtu3.hpp?ts=4)|Multi-Function Timer Pulse Unit 0|マルチファンクションタイマパルスユニット０|
|[MTU1](../RX600/mtu3.hpp?ts=4)|Multi-Function Timer Pulse Unit 1|マルチファンクションタイマパルスユニット１|
|[MTU2](../RX600/mtu3.hpp?ts=4)|Multi-Function Timer Pulse Unit 2|マルチファンクションタイマパルスユニット２|
|[MTU3](../RX600/mtu3.hpp?ts=4)|Multi-Function Timer Pulse Unit 3|マルチファンクションタイマパルスユニット３|
|[MTU4](../RX600/mtu3.hpp?ts=4)|Multi-Function Timer Pulse Unit 4|マルチファンクションタイマパルスユニット４|
|[MTU5](../RX600/mtu3.hpp?ts=4)|Multi-Function Timer Pulse Unit 5|マルチファンクションタイマパルスユニット５|
|[MTU6](../RX600/mtu3.hpp?ts=4)|Multi-Function Timer Pulse Unit 6|マルチファンクションタイマパルスユニット６|
|[MTU7](../RX600/mtu3.hpp?ts=4)|Multi-Function Timer Pulse Unit 7|マルチファンクションタイマパルスユニット７|
|[MTU9](../RX600/mtu3.hpp?ts=4)|Multi-Function Timer Pulse Unit 9|マルチファンクションタイマパルスユニット９|
|[POE3](../RX24T/poe3.hpp?ts=4)|Port Output Enable 3|ポートアウトプットイネーブル３|
|[GPT0](../RX600/gpt.hpp?ts=4)|General PWM Timer 0|汎用 PWM タイマ０|
|[GPT1](../RX600/gpt.hpp?ts=4)|General PWM Timer 1|汎用 PWM タイマ１|
|[GPT2](../RX600/gpt.hpp?ts=4)|General PWM Timer 2|汎用 PWM タイマ２|
|[GPT3](../RX600/gpt.hpp?ts=4)|General PWM Timer 3|汎用 PWM タイマ３|
|[TMR0](../RX600/tmr.hpp?ts=4)|8-Bit Timer 0|8 ビットタイマ０|
|[TMR1](../RX600/tmr.hpp?ts=4)|8-Bit Timer 1|8 ビットタイマ１|
|[TMR2](../RX600/tmr.hpp?ts=4)|8-Bit Timer 2|8 ビットタイマ２|
|[TMR3](../RX600/tmr.hpp?ts=4)|8-Bit Timer 3|8 ビットタイマ３|
|[TMR4](../RX600/tmr.hpp?ts=4)|8-Bit Timer 4|8 ビットタイマ４|
|[TMR5](../RX600/tmr.hpp?ts=4)|8-Bit Timer 5|8 ビットタイマ５|
|[TMR6](../RX600/tmr.hpp?ts=4)|8-Bit Timer 6|8 ビットタイマ６|
|[TMR7](../RX600/tmr.hpp?ts=4)|8-Bit Timer 7|8 ビットタイマ７|
|[CMT0](../RX600/cmt.hpp?ts=4)|Compare Match Timer 0|コンペアマッチタイマ０|
|[CMT1](../RX600/cmt.hpp?ts=4)|Compare Match Timer 1|コンペアマッチタイマ１|
|[CMT2](../RX600/cmt.hpp?ts=4)|Compare Match Timer 2|コンペアマッチタイマ２|
|[CMT3](../RX600/cmt.hpp?ts=4)|Compare Match Timer 3|コンペアマッチタイマ３|
|[IWDT](../RX600/iwdt.hpp?ts=4)|Independent Watchdog Timer|独立ウォッチドッグタイマ|
|[SCI1](../RX600/sci_g.hpp?ts=4)|Serial Communications Interface 1|シリアルコミュニケーションインタフェース１|
|[SCI5](../RX600/sci_g.hpp?ts=4)|Serial Communications Interface 5|シリアルコミュニケーションインタフェース５|
|[SCI6](../RX600/sci_g.hpp?ts=4)|Serial Communications Interface 6|シリアルコミュニケーションインタフェース６|
|[SCI8](../RX600/sci_g.hpp?ts=4)|Serial Communications Interface 8|シリアルコミュニケーションインタフェース８|
|[SCI9](../RX600/sci_g.hpp?ts=4)|Serial Communications Interface 9|シリアルコミュニケーションインタフェース９|
|[SCI11](../RX600/sci_g.hpp?ts=4)|Serial Communications Interface 11|シリアルコミュニケーションインタフェース１１|
|[RIIC0](../RX600/riic.hpp?ts=4)|I2C-bus Interface 0|I2C バスインタフェース０|
|[RSCAN](../RX600/rscan.hpp?ts=4)|RSCAN Module|RSCAN モジュール|
|[RSPI0](../RX600/rspi.hpp?ts=4)|Serial Peripheral Interface 0|シリアルペリフェラルインタフェース０|
|[CRC](../RX600/crc.hpp?ts=4)|CRC Calculator|CRC 演算器|
|[S12AD](../RX24T/s12ad.hpp?ts=4)|12-Bit A/D Converter|12 ビット A/D コンバータ|
|[S12AD1](../RX24T/s12ad.hpp?ts=4)|12-Bit A/D Converter 1|12 ビット A/D コンバータ１|
|[S12AD2](../RX24T/s12ad.hpp?ts=4)|12-Bit A/D Converter 2|12 ビット A/D コンバータ２|
|[DA](../RX24T/da.hpp?ts=4)|8-Bit D/A Converter|8 ビット D/A コンバータ|
|[CMPC0](../RX600/cmpc.hpp?ts=4)|Comparator C0|コンパレーターＣ０|
|[CMPC1](../RX600/cmpc.hpp?ts=4)|Comparator C1|コンパレーターＣ１|
|[CMPC2](../RX600/cmpc.hpp?ts=4)|Comparator C2|コンパレーターＣ２|
|[CMPC3](../RX600/cmpc.hpp?ts=4)|Comparator C3|コンパレーターＣ３|
|[DOC](../RX600/doc.hpp?ts=4)|Data Operation Circuit|データ演算回路|

---

## Port map order (IRQ) / ポートマップ候補 (IRQ)

- [port_map_irq.hpp](port_map_irq.hpp?ts=4)

### LFQGFP100

|IRQ|FIRST|SECOND|THIRD|FOURTH|FIFTH|
|---|---|---|---|---|---|
|IRQ0|P10 (100)|P52 (81)|PE5 (1)|-|-|
|IRQ1|P11 (99)|P53 (80)|PA5 (36)|PE4 (8)|-|
|IRQ2|P00 (4)|P54 (79)|PD4 (21)|PE3 (9)|-|
|IRQ3|P55 (78)|PB4 (30)|PD5 (20)|PE6 (---)|-|
|IRQ4|P01 (7)|P60 (77)|P96 (43)|-|-|
|IRQ5|P02 (2)|P61 (76)|P70 (57)|PB6 (27)|PD6 (19)|
|IRQ6|P21 (68)|P31 (61)|P62 (75)|-|-|
|IRQ7|P20 (69)|P30 (63)|P63 (74)|-|-|

### LFQGFP144

|IRQ|FIRST|SECOND|THIRD|FOURTH|FIFTH|
|---|---|---|---|---|---|
|IRQ0|P10 (141)|P52 (114)|PE5 (5)|-|-|
|IRQ1|P11 (140)|P53 (113)|PA5 (53)|PE4 (14)|-|
|IRQ2|P00 (10)|P54 (112)|PD4 (28)|PE3 (15)|-|
|IRQ3|P55 (111)|PB4 (41)|PD5 (27)|PE6 (4)|-|
|IRQ4|P01 (13)|P60 (110)|P96 (64)|-|-|
|IRQ5|P02 (7)|P61 (109)|P70 (79)|PB6 (38)|PD6 (28)|
|IRQ6|P21 (99)|P31 (87)|P62 (108)|-|-|
|IRQ7|P20 (100)|P30 (90)|P63 (107)|-|-|

---

## Port map order / ポートマップ候補

- [port_map.hpp](port_map.hpp?ts=4)

### LFQFP100

|Peripheral|FIRST|SECOND|THIRD|
|---|---|---|---|
|SCI1 / RXD|PD5 (20)|PC3 (---)|-|
|SCI1 / TXD|PD3 (22)|PC4 (---)|-|
|SCI1 / SCK|PD4 (21)|P25 (---)|-|
|SCI5 / RXD|PB6 (27)|PE0 (17)|-|
|SCI5 / TXD|PB5 (28)|PD7 (18)|-|
|SCI5 / SCK|PB7 (26)|PD2 (23)|-|
|SCI6 / RXD|P80 (98)|PA5 (36)|PB1 (34)|
|SCI6 / TXD|P81 (97)|PB0 (35)|PB2 (33)|
|SCI6 / SCK|P82 (96)|PA4 (37)|PB3 (32)|
|SCI8 / RXD|P83 (---)|PC0 (---)|-|
|SCI8 / TXD|P84 (---)|PC1 (---)|-|
|SCI8 / SCK|PC2 (---)|PC2 (---)|-|
|SCI9 / RXD|PG0 (---)|-|-|
|SCI9 / TXD|PG1 (---)|-|-|
|SCI9 / SCK|PG2 (---)|-|-|
|SCI11 / RXD|PC6 (---)|PD5 (20)|PF1 (---)|
|SCI11 / TXD|PC5 (---)|PD3 (22)|PF0 (---)|
|SCI11 / SCK|PD4 (21)|PD4 (21)|PF2 (---)|
|RIIC0 / SCL|PB1 (34)|-|-|
|RIIC0 / SDA|PB2 (33)|-|-|
|RSCAN / CRX|PA0 (41)|PF2 (---)|-|
|RSCAN / CTX|PA1 (40)|PF3 (---)|-|
|RSPI0 / RSPCK|P24 (65)|PB3 (32)|PD0 (25)|
|RSPI0 / MOSI|P23 (66)|PB0 (35)|PD2 (23)|
|RSPI0 / MISO|P22 (67)|PA5 (36)|PD1 (24)|
|RSPI0 / SSL0|P30 (63)|PA3 (38)|PD6 (19)|
|RSPI0 / SSL1|P31 (61)|PA2 (39)|PD7 (18)|
|RSPI0 / SSL2|P32 (59)|PA1 (40)|PE0 (17)|
|RSPI0 / SSL3|P33 (58)|PA0 (41)|PE1 (16)|

### LFQFP144

|Peripheral|FIRST|SECOND|THIRD|
|---|---|---|---|
|SCI1 / RXD|PD5 (27)|PC3 (98)|-|
|SCI1 / TXD|PD3 (29)|PC4 (97)|-|
|SCI1 / SCK|PD4 (28)|P25 (93)|-|
|SCI5 / RXD|PB6 (38)|PE0 (24)|-|
|SCI5 / TXD|PB5 (39)|PD7 (25)|-|
|SCI5 / SCK|PB7 (37)|PD2 (30)|-|
|SCI6 / RXD|P80 (139)|PA5 (53)|PB1 (49)|
|SCI6 / TXD|P81 (138)|PB0 (50)|PB2 (48)|
|SCI6 / SCK|P82 (137)|PA4 (54)|PB3 (47)|
|SCI8 / RXD|P83 (136)|PC0 (46)|-|
|SCI8 / TXD|P84 (135)|PC1 (45)|-|
|SCI8 / SCK|PC2 (44)|PC2 (44)|-|
|SCI9 / RXD|PG0 (82)|-|-|
|SCI9 / TXD|PG1 (81)|-|-|
|SCI9 / SCK|PG2 (80)|-|-|
|SCI11 / RXD|PC6 (61)|PD5 (27)|PF1 (35)|
|SCI11 / TXD|PC5 (62)|PD3 (29)|PF0 (36)|
|SCI11 / SCK|PD4 (28)|PD4 (28)|PF2 (34)|
|RIIC0 / SCL|PB1 (34)|-|-|
|RIIC0 / SDA|PB2 (33)|-|-|
|RSCAN / CRX|PA0 (58)|PF2 (34)|-|
|RSCAN / CTX|PA1 (57)|PF3 (33)|-|
|RSPI0 / RSPCK|P24 (94)|PB3 (47)|PD0 (32)|
|RSPI0 / MOSI|P23 (95)|PB0 (50)|PD2 (30)|
|RSPI0 / MISO|P22 (96)|PA5 (53)|PD1 (31)|
|RSPI0 / SSL0|P30 (90)|PA3 (55)|PD6 (26)|
|RSPI0 / SSL1|P31 (87)|PA2 (56)|PD7 (25)|
|RSPI0 / SSL2|P32 (84)|PA1 (57)|PE0 (24)|
|RSPI0 / SSL3|P33 (83)|PA0 (58)|PE1 (23)|

---

## Port map order (GPT) / ポートマップ候補 (GPT)

- [port_map_gpt.hpp](port_map_gpt.hpp?ts=4)

### LFQGFP100

|GPT|FIRST|SECOND|THIRD|
|---|---|---|---|
|GTIOC0A|P12 (---)|P71 (56)|PD7 (18)|
|GTIOC0B|P15 (---)|P74 (53)|PD1 (24)|
|GTIOC1A|P13 (---)|P72 (55)|PD0 (25)|
|GTIOC1B|P16 (---)|P75 (52)|PB7 (26)|
|GTIOC2A|P14 (---)|P73 (54)|PB6 (27)|
|GTIOC2B|P17 (---)|P76 (51)|PB5 (28)|
|GTIOC3A|PD7 (18)|-|-|
|GTIOC3B|PD6 (19)|-|-|
|GTECLKA|PD5 (20)|-|-|
|GTECLKB|PD4 (21)|-|-|
|GTECLKC|PD3 (22)|-|-|
|GTECLKD|PB4 (30)|-|-|
|GTETRG|PB4 (30)|PG2 (---)|-|
|GTADSM0|P35 (---)|PA3 (38)|PC2 (---)|
|GTADSM1|P34 (---)|PA2 (39)|PC1 (---)|

### LFQFP144

|GPT|FIRST|SECOND|THIRD|
|---|---|---|---|
|GTIOC0A|P12 (3)|P71 (78)|PD7 (25)|
|GTIOC0B|P15 (144)|P74 (75)|PD1 (31)|
|GTIOC1A|P13 (2)|P72 (76)|PD0 (32)|
|GTIOC1B|P16 (143)|P75 (74)|PB7 (37)|
|GTIOC2A|P14 (1)|P73 (76)|PB6 (38)|
|GTIOC2B|P17 (142)|P76 (73)|PB5 (39)|
|GTIOC3A|PD7 (25)|-|-|
|GTIOC3B|PD6 (26)|-|-|
|GTECLKA|PD5 (27)|-|-|
|GTECLKB|PD4 (28)|-|-|
|GTECLKC|PD3 (29)|-|-|
|GTECLKD|PB4 (41)|-|-|
|GTETRG|PB4 (41)|PG2 (80)|-|
|GTADSM0|P35 (59)|PA3 (55)|PC2 (44)|
|GTADSM1|P34 (60)|PA2 (56)|PC1 (45)|

---

## Port map order (MTU) / ポートマップ候補 (MTU)

- [port_map_mtu.hpp](port_map_mtu.hpp?ts=4)

### LFQGFP100

|MTU|FIRST|SECOND|THIRD|
|---|---|---|---|
|MTIOC0A #|P31 (61)|PB3 (32)|-|
|MTIOC0B #|P30 (63)|PB2 (33)|-|
|MTIOC0C #|PB1 (34)|-|-|
|MTIOC0D #|PB0 (35)|-|-|
|MTIOC1A #|P27 (64)|PA5 (36)|PC6 (---)|
|MTIOC1B #|PA4 (37)|PC5 (---)|-|
|MTIOC2A #|PA3 (38)|-|-|
|MTIOC2B #|PA2 (39)|-|-|
|MTIOC3A #|P11 (99)|P33 (58)|-|
|MTIOC3B #|P12 (---)|P71 (56)|-|
|MTIOC3C #|P32 (59)|-|-|
|MTIOC3D #|P15 (---)|P74 (53)|-|
|MTIOC4A #|P13 (---)|P72 (55)|-|
|MTIOC4B #|P14 (---)|P73 (54)|-|
|MTIOC4C #|P16 (---)|P75 (52)|-|
|MTIOC4D #|P17 (---)|P76 (51)|-|
|MTIC5U #|P24 (65)|P82 (96)|-|
|MTIC5V #|P23 (66)|P81 (97)|-|
|MTIC5W #|P22 (67)|P80 (98)|-|
|MTIOC6A #|PA1 (40)|-|-|
|MTIOC6B #|P95 (45)|-|-|
|MTIOC6C #|PA0 (41)|-|-|
|MTIOC6D #|P92 (48)|-|-|
|MTIOC7A #|P94 (46)|-|-|
|MTIOC7B #|P93 (47)|-|-|
|MTIOC7C #|P91 (49)|-|-|
|MTIOC7D #|P90 (50)|-|-|
|MTIOC9A #|P21 (68)|P26 (---)|PD7 (18)|
|MTIOC9B #|P10 (100)|PE0 (17)|-|
|MTIOC9C #|P20 (69)|PD6 (19)|P25 (---)|
|MTIOC9D #|P02 (2)|PE1 (16)|-|
|MTCLKA #|P21 (68)|P33 (58)|-|
|MTCLKB #|P20 (69)|P32 (59)|-|
|MTCLKC #|P11 (99)|P31 (61)|PE4 (8)|
|MTCLKD #|P10 (100)|P30 (63)|PE3 (9)|
|ADSM0|PA7 (---)|PB2 (33)|PC2 (---)|
|ADSM1|PA6 (---)|PB1 (34)|PC1 (---)|

### LFQGFP144

|MTU|FIRST|SECOND|THIRD|
|---|---|---|---|
|MTIOC0A #|P31 (87)|PB3 (47)|-|
|MTIOC0B #|P30 (90)|PB2 (48)|-|
|MTIOC0C #|PB1 (49)|-|-|
|MTIOC0D #|PB0 (50)|-|-|
|MTIOC1A #|P27 (91)|PA5 (53)|PC6 (61)|
|MTIOC1B #|PA4 (54)|PC5 (62)|-|
|MTIOC2A #|PA3 (55)|-|-|
|MTIOC2B #|PA2 (56)|-|-|
|MTIOC3A #|P11 (140)|P33 (83)|-|
|MTIOC3B #|P12 (3)|P71 (78)|-|
|MTIOC3C #|P32 (84)|-|-|
|MTIOC3D #|P15 (144)|P74 (75)|-|
|MTIOC4A #|P13 (2)|P72 (77)|-|
|MTIOC4B #|P14 (1)|P73 (76)|-|
|MTIOC4C #|P16 (143)|P75 (74)|-|
|MTIOC4D #|P17 (142)|P76 (73)|-|
|MTIC5U #|P24 (94)|P82 (137)|-|
|MTIC5V #|P23 (95)|P81 (138)|-|
|MTIC5W #|P22 (96)|P80 (139)|-|
|MTIOC6A #|PA1 (57)|-|-|
|MTIOC6B #|P95 (67)|-|-|
|MTIOC6C #|PA0 (58)|-|-|
|MTIOC6D #|P92 (70)|-|-|
|MTIOC7A #|P94 (68)|-|-|
|MTIOC7B #|P93 (69)|-|-|
|MTIOC7C #|P91 (71)|-|-|
|MTIOC7D #|P90 (72)|-|-|
|MTIOC9A #|P21 (99)|P26 (92)|PD7 (25)|
|MTIOC9B #|P10 (141)|PE0 (24)|-|
|MTIOC9C #|P20 (100)|PD6 (26)|P25 (93)|
|MTIOC9D #|P02 (7)|PE1 (23)|-|
|MTCLKA #|P21 (99)|P33 (83)|-|
|MTCLKB #|P20 (100)|P32 (84)|-|
|MTCLKC #|P11 (140)|P31 (87)|PE4 (14)|
|MTCLKD #|P10 (141)|P30 (90)|PE3 (15)|
|ADSM0|PA7 (51)|PB2 (48)|PC2 (44)|
|ADSM1|PA6 (52)|PB1 (49)|PC1 (45)|

---

## Port map order (TMR) / ポートマップ候補 (TMR)

- [port_map_tmr.hpp](port_map_tmr.hpp?ts=4)

### LFQFP100

|TMR|FIRST|SECOND|THIRD|FOURTH|FIFTH|
|---|---|---|---|---|---|
|TMO0|P33 (58)|P35 (---)|PB0 (35)|PD3 (22)|-|
|TMCI0|PB1 (34)|PD4 (21)|-|-|-|
|TMRI0|PB2 (33)|PD5 (20)|-|-|-|
|TMO1|PD6 (19)|PF0 (---)|-|-|-|
|TMCI1|PD2 (23)|PE0 (17)|-|-|-|
|TMRI1|PD7 (18)|-|-|-|-|
|TMO2|P23 (66)|PA0 (41)|PA7 (---)|PD1 (24)|-|
|TMCI2|P24 (65)|-|-|-|-|
|TMRI2|P22 (67)|-|-|-|-|
|TMO3|P11 (99)|PF2 (---)|-|-|-|
|TMCI3|PA5 (36)|-|-|-|-|
|TMRI3|P10 (100)|-|-|-|-|
|TMO4|P22 (67)|P34 (---)|P82 (96)|PA1 (40)|PD2 (23)|
|TMCI4|P21 (68)|P81 (97)|-|-|-|
|TMRI4|P20 (69)|P80 (98)|-|-|-|
|TMO5|PE1 (16)|PF1 (---)|-|-|-|
|TMCI5|PE0 (17)|-|-|-|-|
|TMRI5|PD7 (18)|-|-|-|-|
|TMO6|P24 (65)|P32 (59)|PA6 (---)|PD0 (25)|-|
|TMCI6|P30 (63)|PD4 (21)|-|-|-|
|TMRI6|P31 (61)|PD5 (20)|-|-|-|
|TMO7|PA2 (39)|PF3 (---)|-|-|-|
|TMCI7|PA4 (37)|-|-|-|-|
|TMRI7|PA3 (38)|-|-|-|-|

### LFQFP144

|TMR|FIRST|SECOND|THIRD|FOURTH|FIFTH|
|---|---|---|---|---|---|
|TMO0|P33 (83)|P35 (59)|PB0 (50)|PD3 (29)|-|
|TMCI0|PB1 (49)|PD4 (28)|-|-|-|
|TMRI0|PB2 (48)|PD5 (27)|-|-|-|
|TMO1|PD6 (26)|PF0 (36)|-|-|-|
|TMCI1|PD2 (30)|PE0 (24)|-|-|-|
|TMRI1|PD7 (25)|-|-|-|-|
|TMO2|P23 (95)|PA0 (58)|PA7 (51)|PD1 (31)|-|
|TMCI2|P24 (94)|-|-|-|-|
|TMRI2|P22 (96)|-|-|-|-|
|TMO3|P11 (140)|PF2 (34)|-|-|-|
|TMCI3|PA5 (53)|-|-|-|-|
|TMRI3|P10 (141)|-|-|-|-|
|TMO4|P22 (96)|P34 (60)|P82 (137)|PA1 (57)|PD2 (30)|
|TMCI4|P21 (99)|P81 (138)|-|-|-|
|TMRI4|P20 (100)|P80 (139)|-|-|-|
|TMO5|PE1 (23)|PF1 (35)|-|-|-|
|TMCI5|PE0 (24)|-|-|-|-|
|TMRI5|PD7 (25)|-|-|-|-|
|TMO6|P24 (94)|P32 (84)|PA6 (52)|PD0 (31)|-|
|TMCI6|P30 (90)|PD4 (28)|-|-|-|
|TMRI6|P31 (87)|PD5 (27)|-|-|-|
|TMO7|PA2 (56)|PF3 (33)|-|-|-|
|TMCI7|PA4 (54)|-|-|-|-|
|TMRI7|PA3 (55)|-|-|-|-|

---

## 12 Bits A/D Converter input (S12AD) / 12 ビット A/D コンバーター入力 (S12AD)

- [s12ad.hpp](s12ad.hpp?ts=4)

### LFQFP100

|S12AD/ANALOG|Port|
|---|---|
|AN000|P40 (90)|
|AN001|P41 (89)|
|AN002|P42 (88)|
|AN003|P43 (87)|
|AN016|P20 (69)|

|S12AD1/ANALOG|Port|
|---|---|
|AN100|P44 (85)|
|AN101|P45 (84)|
|AN102|P46 (83)|
|AN103|P47 (82)|
|AN116|P21 (68)|

|S12AD2/ANALOG|Port|
|---|---|
|AN200|P60 (77)|
|AN201|P61 (76)|
|AN202|P62 (75)|
|AN203|P63 (74)|
|AN204|P64 (71)|
|AN205|P65 (70)|
|AN206|P50 (---)|
|AN207|P51 (---)|
|AN208|P52 (81)|
|AN209|P53 (80)|
|AN210|P54 (79)|
|AN211|P55 (78)|

### LFQFP144

|S12AD/ANALOG|Port|
|---|---|
|AN000|P40 (125)|
|AN001|P41 (124)|
|AN002|P42 (123)|
|AN003|P43 (122)|
|AN016|P20 (100)|

|S12AD1/ANALOG|Port|
|---|---|
|AN100|P44 (120)|
|AN101|P45 (119)|
|AN102|P46 (118)|
|AN103|P47 (117)|
|AN116|P21 (99)|

|S12AD2/ANALOG|Port|
|---|---|
|AN200|P60 (110)|
|AN201|P61 (109)|
|AN202|P62 (108)|
|AN203|P63 (107)|
|AN204|P64 (102)|
|AN205|P65 (101)|
|AN206|P50 (116)|
|AN207|P51 (115)|
|AN208|P52 (114)|
|AN209|P53 (113)|
|AN210|P54 (112)|
|AN211|P55 (111)|

---

## 8 Bits D/A Converter output (DA) / 8 ビット D/A コンバーター出力 (DA)

- [da.hpp](da.hpp?ts=4)

### LFQFP100

|DA/ANALOG|Port|
|---|---|
|DA0|P24 (65)|
|DA1|P23 (66)|

### LFQFP144

|DA/ANALOG|Port|
|---|---|
|DA0|P24 (94)|
|DA1|P23 (95)|

---

## rx_prog Flash Programming / rx_prog フラッシュプログラム

||Support/サポート|operation verification/動作検証|
|-|:-:|:-:|
|[rxprog](../rxprog)|-|-|

---

Translated with www.DeepL.com/Translator (free version)

---

## License

[MIT](../LICENSE)
