hirakuni45/RX/RX231/README.md

## RX230/RX231 features / 特徴

- RXv2 core / RXv2 コア
- Maximum operating frequency 54MHz / 最大動作周波数 54MHz
- Single-precision 32-bit floating point / 32 ビット単精度浮動小数点
- 1.8V ～ 5.5V Operation / 動作
- USB2.0 Full Speed, Low Speed, Host, Function (RX231 Only)
- RSCAN (RX231 optional)
- SD Host Interface (SDHI) / SD ホストインタフェース (SDHI) (RX231 optional)
- Serial Sound Interface (SSI) / シリアルサウンドインタフェース (SSI)
- 12 Bits A/D / １２ビットＡ／Ｄ変換器
- 12 Bits D/A / １２ビットＤ／Ａ変換器

### Package/パッケージ

|R5F523y---XX|Package/パッケージ|Pin/ピン数|Pitch/ピッチ|
|---|:-:|:-:|:-:|
|R5F523yxxxFP|LFQFP|100|0.50|
|R5F523yxxxFM|LFQFP|64|0.50|
|R5F523yxxxFL|LFQFP|48|0.50|
|R5F523yxxxLA|TFLGA|100|0.50|
|R5F523yxxxLF|WFLGA|64|0.50|
|R5F523yxxxND|HWQFN|64|0.50|
|R5F523yxxxNE|HWQFN|48|0.50|

### Ambient operating temperature/動作周囲温度

|R5F523y--X--|degree Celsius|
|---|:-:|
|R5F523yxxDxx|-40 ～ +85℃|
|R5F523yxxGxx|-40 ～ +105℃|

### Crypt/暗号, SDHI, RSCAN, USB

|R5F523y-X---|Crypt|SDHI|RSCAN|USB|
|---|:-:|:-:|:-:|:-:|
|R5F5231xAxxx|-|-|〇|〇|
|R5F5231xBxxx|〇|〇|〇|〇|
|R5F5231xCxxx|-|-|-|〇|
|R5F5230xAxxx|-|-|-|-|

※R5F5231xBxxx: Excluding 48-pin version / ４８ピン版を除く

### Memoey size/メモリ容量

|R5F523yX----|CodeFlash|RAM|DataFlash|
|---|:-:|:-:|:-:|
|R5F523y8xxxx|512K|64K|8K|
|R5F523y7xxxx|384K|64K|8K|
|R5F523y6xxxx|256K|32K|8K|
|R5F523y5xxxx|128K|32K|8K|

### Data Flash/データ・フラッシュ

|Capacity|Erase Size|Blank Check Size|Write Size|Erase Value|ID|
|:-:|:-:|:-:|:-:|:-:|:-:|
|8K|1024|1/1024|1|0xFF|4|

---

## RX230/RX231 Linker file / リンカーファイル

|Type|Code Flash|RAM|Data Flash|Linker File|Ustack|Istack|
|---|:-:|:-:|:-:|---|:-:|:-:|
|R5F52318|512K|64K|8K|[R5F52318.ld](R5F52318.ld?ts=4)|1536|512|
|R5F52317|384K|64K|8K|[R5F52317.ld](R5F52317.ld?ts=4)|1536|512|
|R5F52316|256K|32K|8K|[R5F52316.ld](R5F52316.ld?ts=4)|1536|512|
|R5F52315|128K|32K|8K|[R5F52315.ld](R5F52315.ld?ts=4)|1536|512|

---

## RX230/RX231 Dedicated class / 専用クラス

|Function/機能|Source|Remarks/備考|
|---|---|:-:|
|Peripheral Name/ペリフェラル名|[peripheral.hpp](peripheral.hpp?ts=4)||
|Hardware-specific Definition/ハード固有定義|[board_profile.hpp](board_profile.hpp?ts=4)||
|Operating Frequency Definition/動作周波数定義|[clock_profile.hpp](clock_profile.hpp?ts=4)||
|Power Control/電力制御|[power_mgr.hpp](power_mgr.hpp?ts=4)||
|Port Definition/ポート定義|[port.hpp](port.hpp?ts=4)||
|Interrupt Definition/割り込み定義|[icu.hpp](icu.hpp?ts=4)||
|Interrupt Management/割り込み管理|[icu_mgr.hpp](icu_mgr.hpp?ts=4)||
|Port Function Definition/ポート機能定義|[mpc.hpp](mpc.hpp?ts=4)||
|Port Mapping/ポートマッピング|[port_map.hpp](port_map.hpp?ts=4)||
|Port Mapping IRQ/ポートマッピング IRQ|[port_map_irq.hpp](port_map_irq.hpp?ts=4)||
|Port Mapping MTU/ポートマッピング MTU|[port_map_mtu.hpp](port_map_mtu.hpp?ts=4)||
|Port Mapping TPU/ポートマッピング TPU|[port_map_tpu.hpp](port_map_tpu.hpp?ts=4)||
|BUS Definition/BUS 定義|[bus.hpp](bus.hpp?ts=4)||
|CMPB Definition/CMPB 定義|[cmpb.hpp](cmpb.hpp?ts=4)||
|ELC Definition/ELC 定義|[elc.hpp](elc.hpp?ts=4)||
|FLASH Definition/FLASH 定義|[flash.hpp](flash.hpp?ts=4)||
|LVDA Definition/LVDA 定義|[lvda.hpp](lvda.hpp?ts=4)||
|POE2 Definition/POE2 定義|[poe2.hpp](poe2.hpp?ts=4)||
|RTC Definition/RTC 定義|[rtc.hpp](rtc.hpp?ts=4)||
|A/D Definition/A/D 定義|[s12ade.hpp](s12ade.hpp?ts=4)||
|System Definition/システム定義|[system.hpp](system.hpp?ts=4)||
|System I/O Definition/システム I/O 定義|[system_io.hpp](system_io.hpp?ts=4)||

---

## Basic Pin Assignments / 基本ピンアサイン

|Terminal/端子|LFQFP 64|LFQFP 100|
|---|---|---|
|VCL|VCL(2)|VCL(5)|
|Reset Input/リセット入力|RES#(6)|RES#(10)|
|Mode Controle/モード制御|MD/FINED(3)|MD/FINED(7)|
|B/UB|PC7(27)|PC7(45)|
|RXD|P30/RXD1(14)|P30/RXD1(20)|
|TXD|P26/TXD1(16)|P26/TXD1(22)|
|USB_VCC|VCC_USB(21)|VCC_USB(35)|
|USB_VSS|VSS_USB(24)|VSS_USB(38)|
|USB+|USB_DP(23)|USB_DP(37)|
|USB-|USB_DM(22)|USB_DM(36)|
|Power/電源|VCC(10), VCC(38)|VCC(14),VCC(60)|
|GND/接地|VSS(8), VSS(40)|VSS(12),VSS(62)|
|Analog Power/アナログ電源|AVCC0(62)|AVCC0(97)|
|Analog GND/アナログ接地|AVSS0(64)|AVSS0(99)|
|Analog Refarence L/アナログ基準電源Ｌ|VREFL(52)|VREFL(3)|
|Analog Refarence H/アナログ基準電源Ｈ|VREFH(54)|VREFH(1)|
|Analog Refarence L0/アナログ基準電源Ｌ0|VREFL0(59)|VREFL0(94)|
|Analog Refarence H0/アナログ基準電源Ｈ0|VREFH0(61)|VREFH0(96)|
|VBATT|VBATT(12)|VBATT(6)|
|OSC in|EXTAL(9)|EXTAL(13)|
|OSC out|XTAL(7)|XTAL(11)|
|Sub OSC in|XCIN(4)|XCIN(8)|
|Sub OSC out|XCOUT(5)|XCOUT(9)|

- VCL: 4.7uF/25V

|Mode/モード|B/UB|MD|
|---|:---:|:---:|
|Serial BOOT/シリアルブート|0|0|
|USB Boot/USB ブート|1|0|
|Single Chip/シングルチップ|-|1|

---

## Peripheral / ペリフェラル

- [peripheral.hpp](peripheral.hpp?ts=4)

|Peripheral|Function|機能|
|---|---|---|
|CAC|Clock Frequency Accuracy Measurement Circuit|クロック周波数精度測定回路|
|VBATT|Battery Backup Function|バッテリバックアップ機能|
|DMAC0|DMA Controller channel 0|DMA コントローラ・チャネル０|
|DMAC1|DMA Controller channel 1|DMA コントローラ・チャネル１|
|DMAC2|DMA Controller channel 2|DMA コントローラ・チャネル２|
|DMAC3|DMA Controller channel 3|DMA コントローラ・チャネル３|
|DTC|Data Transfer Controller|データトランスファコントローラ|
|ELC|Event Link Controller|イベントリンクコントローラ|
|MTU0|Multi-Function Timer Pulse Unit 0|マルチファンクションタイマパルスユニット０|
|MTU1|Multi-Function Timer Pulse Unit 1|マルチファンクションタイマパルスユニット１|
|MTU2|Multi-Function Timer Pulse Unit 2|マルチファンクションタイマパルスユニット２|
|MTU3|Multi-Function Timer Pulse Unit 3|マルチファンクションタイマパルスユニット３|
|MTU4|Multi-Function Timer Pulse Unit 4|マルチファンクションタイマパルスユニット４|
|MTU5|Multi-Function Timer Pulse Unit 5|マルチファンクションタイマパルスユニット５|
|POE2|Port Output Enable 2|ポートアウトプットイネーブル２|
|TPU0|16-Bit Timer Pulse Unit 0|16 ビットタイマパルスユニット０|
|TPU1|16-Bit Timer Pulse Unit 1|16 ビットタイマパルスユニット１|
|TPU2|16-Bit Timer Pulse Unit 2|16 ビットタイマパルスユニット２|
|TPU3|16-Bit Timer Pulse Unit 3|16 ビットタイマパルスユニット３|
|TPU4|16-Bit Timer Pulse Unit 4|16 ビットタイマパルスユニット４|
|TPU5|16-Bit Timer Pulse Unit 5|16 ビットタイマパルスユニット５|
|TMR0|8-Bit Timer 0|8 ビットタイマ０|
|TMR1|8-Bit Timer 1|8 ビットタイマ１|
|TMR2|8-Bit Timer 2|8 ビットタイマ２|
|TMR3|8-Bit Timer 3|8 ビットタイマ３|
|CMT0|Compare Match Timer 0|コンペアマッチタイマ０|
|CMT1|Compare Match Timer 1|コンペアマッチタイマ１|
|CMT2|Compare Match Timer 2|コンペアマッチタイマ２|
|CMT3|Compare Match Timer 3|コンペアマッチタイマ３|
|RTC|Realtime Clock|リアルタイムクロック|
|LPT|Low Power Timer|ローパワータイマ|
|WDTA|Watchdog Timer|ウォッチドッグタイマ|
|IWDT|Independent Watchdog Timer|独立ウォッチドッグタイマ|
|USB0|USB 2.0 FS Host/Function Module 0|USB 2.0 FS ホスト/ファンクションモジュール０|
|SCI0|Serial Communications Interface 0|シリアルコミュニケーションインタフェース０|
|SCI1|Serial Communications Interface 1|シリアルコミュニケーションインタフェース１|
|SCI5|Serial Communications Interface 5|シリアルコミュニケーションインタフェース５|
|SCI6|Serial Communications Interface 6|シリアルコミュニケーションインタフェース６|
|SCI8|Serial Communications Interface 8|シリアルコミュニケーションインタフェース８|
|SCI9|Serial Communications Interface 9|シリアルコミュニケーションインタフェース９|
|SCI12|Serial Communications Interface 12|シリアルコミュニケーションインタフェース１２|
|IrDA|IrDA Interface|IrDA インタフェース|
|RIIC0|I2C-bus Interface 0|I2C バスインタフェース０|
|RSCAN|RSCAN Module|RSCAN インタフェース|
|SSI0|Serial Sound Interface 0|シリアルサウンドインタフェース０|
|RSPI0|Serial Peripheral Interface 0|シリアルペリフェラルインタフェース０|
|CRC|CRC Calculator|CRC 演算器|
|SDHI|SD Host Interface|SD ホストインタフェース|
|TSIP_L|Trusted Secure IP (TSIP-Lite)|Trusted Secure IP (TSIP-Lite)|
|CTSU|Capacitive Touch Sensing Unit|静電容量式タッチセンサ|
|S12AD|12-Bit A/D Converter|12 ビット A/D コンバータ|
|R12DA|12-Bit D/A Converter|12 ビット D/A コンバータ|
|CMPB|Comparator B|コンパレータＢ|
|DOC|Data Operation Circuit|データ演算回路|

---

## Port map order (IRQ) / ポートマップ候補 (IRQ)

- [port_map_irq.hpp](port_map_irq.hpp?ts=4)

### LFQFP64

|IRQ|FIRST|SECOND|THIRD|FOURTH|
|---|---|---|---|---|
|IRQ0|P30 (14)|PD0 (--)|PH1 (23)|-|
|IRQ1|P31 (13)|PD1 (--)|PH2 (22)|-|
|IRQ2|P32 (--)|P12 (--)|PD2 (--)|-|
|IRQ3|P33 (--)|P13 (--)|PD3 (--)|-|
|IRQ4|PB1 (37)|P14 (20)|P34 (--)|PD4 (--)|
|IRQ5|PA4 (42)|P15 (19)|PD5 (--)|PE5 (46)|
|IRQ6|PA3 (43)|P16 (18)|PD6 (--)|PE6 (--)|
|IRQ7|PE2 (49)|P17 (17)|PD7 (--)|PE7 (--)|

### LFQFP100

|IRQ|FIRST|SECOND|THIRD|FOURTH|
|---|---|---|---|---|
|IRQ0|P30 (20)|PD0 (86)|PH1 (37)|-|
|IRQ1|P31 (19)|PD1 (85)|PH2 (36)|-|
|IRQ2|P32 (18)|P12 (34)|PD2 (84)|-|
|IRQ3|P33 (17)|P13 (33)|PD3 (83)|-|
|IRQ4|PB1 (59)|P14 (32)|P34 (16)|PD4 (82)|
|IRQ5|PA4 (66)|P15 (31)|PD5 (81)|PE5 (73)|
|IRQ6|PA3 (67)|P16 (20)|PD6 (80)|PE6 (72)|
|IRQ7|PE2 (76)|P17 (29)|PD7 (79)|PE7 (71)|

---

## Port map order / ポートマップ候補

- [port_map.hpp](port_map.hpp?ts=4)

### LFQFP64

|Peripheral|FIRST|SECOND|THIRD|FOURTH|
|---|---|---|---|---|
|SCI0 / RXD|P21 (--)|-|-|-|
|SCI0 / TXD|P20 (--)|-|-|-|
|SCI0 / SCK|P22 (--)|-|-|-|
|SCI1 / RXD|P15 (19)|P30 (14)|-|-|
|SCI1 / TXD|P16 (18)|P26 (16)|-|-|
|SCI1 / SCK|P17 (17)|P27 (15)|-|-|
|SCI5 / RXD|PA2 (--)|PA3 (43)|PC2 (32)|PC2 (32)|
|SCI5 / TXD|PA4 (42)|PA4 (42)|PC3 (31)|PC3 (31)|
|SCI5 / SCK|PA1 (44)|PA1 (44)|PC4 (30)|PC1 (--)|
|SCI6 / RXD|P33 (--)|PB0 (39)|-|-|
|SCI6 / TXD|P32 (--)|PB1 (37)|-|-|
|SCI6 / SCK|P34 (17)|PB3 (36)|-|-|
|SCI8 / RXD|PC6 (28)|-|-|-|
|SCI8 / TXD|PC7 (27)|-|-|-|
|SCI8 / SCK|PC5 (29)|-|-|-|
|SCI9 / RXD|PB6 (34)|-|-|-|
|SCI9 / TXD|PB7 (33)|-|-|-|
|SCI9 / SCK|PB5 (35)|-|-|-|
|SCI12 / RXD|PE2 (49)|-|-|-|
|SCI12 / TXD|PE1 (50)|-|-|-|
|SCI12 / SCK|PE0 (51)|-|-|-|
|RIIC0 / SCL|P16 (18)|P12 (--)|-|-|
|RIIC0 / SDA|P17 (17)|P13 (--)|-|-|
|RSPI0 / RSPCK|PA5 (--)|PB0 (39)|PC5 (29)|-|
|RSPI0 / MOSI|PA6 (41)|P16 (18)|PC6 (28)|-|
|RSPI0 / MISO|PA7 (--)|P17 (17)|PC7 (27)|-|
|RSPI0 / SSL0|PA4 (42)|PC4 (30)|-|-|
|RSPI0 / SSL1|PA0 (45)|PC0 (--)|-|-|
|RSPI0 / SSL2|PA1 (44)|PC1 (--)|-|-|
|RSPI0 / SSL3|PA2 (--)|PC2 (32)|-|-|
|SSI0 / AUDIO_MCLK|P22 (--)|P30 (14)|PE3 (48)|-|
|SSI0 / SSISCK0|P23 (--)|P31 (13)|PA1 (44)|-|
|SSI0 / SSIWS0|P21 (--)|P27 (15)|PA6 (41)|-|
|SSI0 / SSIRXD0|P20 (--)|P26 (16)|PA3 (43)|-|
|SSI0 / SSITXD0|P17 (17)|P17 (17)|PA4 (42)|-|
|USB0 / VBUS|P16 (18)|PB5 (35)|-|-|
|USB0 / EXICEN|P21 (--)|PC6 (28)|-|-|
|USB0 / VBUSEN|P16 (18)|P24 (--)|P26 (16)|P32 (--)|
|USB0 / OVRCURA|P14 (20)|-|-|-|
|USB0 / OOVRCURB|P16 (18)|P22 (--)|-|-|
|USB0 / ID|P20 (--)|PC5 (29)|-|-|

### LFQFP100

|Peripheral|FIRST|SECOND|THIRD|FOURTH|
|---|---|---|---|---|
|SCI0 / RXD|P21 (27)|-|-|-|
|SCI0 / TXD|P20 (28)|-|-|-|
|SCI0 / SCK|P22 (26)|-|-|-|
|SCI1 / RXD|P15 (31)|P30 (20)|-|-|
|SCI1 / TXD|P16 (30)|P26 (22)|-|-|
|SCI1 / SCK|P17 (29)|P27 (21)|-|-|
|SCI5 / RXD|PA2 (68)|PA3 (67)|PC2 (50)|PC2 (50)|
|SCI5 / TXD|PA4 (66)|PA4 (66)|PC3 (49)|PC3 (49)|
|SCI5 / SCK|PA1 (69)|PA1 (69)|PC4 (48)|PC1 (51)|
|SCI6 / RXD|P33 (17)|PB0 (61)|-|-|
|SCI6 / TXD|P32 (18)|PB1 (59)|-|-|
|SCI6 / SCK|P34 (16)|PB3 (57)|-|-|
|SCI8 / RXD|PC6 (46)|-|-|-|
|SCI8 / TXD|PC7 (45)|-|-|-|
|SCI8 / SCK|PC5 (47)|-|-|-|
|SCI9 / RXD|PB6 (54)|-|-|-|
|SCI9 / TXD|PB7 (53)|-|-|-|
|SCI9 / SCK|PB5 (55)|-|-|-|
|SCI12 / RXD|PE2 (76)|-|-|-|
|SCI12 / TXD|PE1 (77)|-|-|-|
|SCI12 / SCK|PE0 (78)|-|-|-|
|RIIC0 / SCL|P16 (30)|P12 (34)|-|-|
|RIIC0 / SDA|P17 (29)|P13 (33)|-|-|
|RSPI0 / RSPCK|PA5 (65)|PB0 (61)|PC5 (47)|-|
|RSPI0 / MOSI|PA6 (64)|P16 (30)|PC6 (46)|-|
|RSPI0 / MISO|PA7 (63)|P17 (29)|PC7 (45)|-|
|RSPI0 / SSL0|PA4 (66)|PC4 (48)|-|-|
|RSPI0 / SSL1|PA0 (70)|PC0 (52)|-|-|
|RSPI0 / SSL2|PA1 (69)|PC1 (51)|-|-|
|RSPI0 / SSL3|PA2 (68)|PC2 (50)|-|-|
|SSI0 / AUDIO_MCLK|P22 (26)|P30 (20)|PE3 (75)|-|
|SSI0 / SSISCK0|P23 (25)|P31 (19)|PA1 (69)|-|
|SSI0 / SSIWS0|P21 (27)|P27 (21)|PA6 (64)|-|
|SSI0 / SSIRXD0|P20 (28)|P26 (22)|PA3 (67)|-|
|SSI0 / SSITXD0|P17 (29)|P17 (29)|PA4 (66)|-|
|USB0 / VBUS|P16 (30)|PB5 (55)|-|-|
|USB0 / EXICEN|P21 (27)|PC6 (---)|-|-|
|USB0 / VBUSEN|P16 (30)|P24 (24)|P26 (---)|P32 (18)|
|USB0 / OVRCURA|P14 (32)|-|-|-|
|USB0 / OOVRCURB|P16 (30)|P22 (26)|-|-|
|USB0 / ID|P20 (28)|PC5 (---)|-|-|

---

## Port map order (MTU) / ポートマップ候補 (MTU)

- [port_map_mtu.hpp](port_map_mtu.hpp?ts=4)

### LFQFP64

|MTU|FIRST|SECOND|THIRD|FOURTH|FIFTH|
|---|---|---|---|---|---|
|MTIOC0A|P34 (--)|PB3 (36)|-|-|-|
|MTIOC0B|P13 (--)|P15 (19)|PA1 (44)|-|-|
|MTIOC0C|P32 (--)|PB1 (37)|-|-|-|
|MTIOC0D|P33 (--)|PA3 (43)|-|-|-|
|MTIOC1A|P20 (--)|PE4 (47)|-|-|-|
|MTIOC1B|P21 (--)|PB5 (35)|-|-|-|
|MTIOC2A|P26 (16)|PB5 (35)|-|-|-|
|MTIOC2B|P27 (15)|PE5 (46)|-|-|-|
|MTIOC3A|P14 (20)|P17 (17)|PC1 (--)|PC7 (27)|-|
|MTIOC3B|P17 (17)|P22 (--)|PB7 (33)|PC5 (29)|-|
|MTIOC3C|P16 (18)|PC0 (--)|PC6 (28)|PJ3 (--)|-|
|MTIOC3D|P16 (18)|P23 (--)|PB6 (34)|PC4 (30)|-|
|MTIOC4A|P24 (--)|PA0 (45)|PB3 (36)|PE2 (49)|-|
|MTIOC4B|P30 (14)|P54 (26)|PC2 (32)|PD1 (--)|PE3 (48)|
|MTIOC4C|P25 (--)|PB1 (37)|PE1 (50)|PE5 (46)|-|
|MTIOC4D|P31 (13)|P55 (25)|PC3 (31)|PD2 (--)|PE4 (47)|
|MTIOC5U|PA4 (42)|PD7 (--)|-|-|-|
|MTIOC5V|PA6 (41)|PD6 (--)|-|-|-|
|MTIOC5W|PB0 (39)|PD5 (--)|-|-|-|
|MTCLKA|P14 (20)|P24 (--)|PA4 (42)|PC6 (28)|-|
|MTCLKB|P15 (19)|P25 (--)|PA6 (41)|PC7 (27)|-|
|MTCLKC|P22 (--)|PA1 (44)|PC4 (30)|-|-|
|MTCLKD|P23 (--)|PA3 (43)|PC5 (29)|-|-|

### LFQFP100

|MTU|FIRST|SECOND|THIRD|FOURTH|FIFTH|
|---|---|---|---|---|---|
|MTIOC0A|P34 (16)|PB3 (57)|-|-|-|
|MTIOC0B|P13 (33)|P15 (31)|PA1 (69)|-|-|
|MTIOC0C|P32 (18)|PB1 (59)|-|-|-|
|MTIOC0D|P33 (17)|PA3 (67)|-|-|-|
|MTIOC1A|P20 (28)|PE4 (74)|-|-|-|
|MTIOC1B|P21 (27)|PB5 (55)|-|-|-|
|MTIOC2A|P26 (22)|PB5 (55)|-|-|-|
|MTIOC2B|P27 (21)|PE5 (73)|-|-|-|
|MTIOC3A|P14 (32)|P17 (29)|PC1 (51)|PC7 (45)|-|
|MTIOC3B|P17 (29)|P22 (26)|PB7 (53)|PC5 (47)|-|
|MTIOC3C|P16 (30)|PC0 (52)|PC6 (46)|PJ3 (4)|-|
|MTIOC3D|P16 (30)|P23 (25)|PB6 (54)|PC4 (48)|-|
|MTIOC4A|P24 (24)|PA0 (70)|PB3 (57)|PE2 (76)|-|
|MTIOC4B|P30 (20)|P54 (40)|PC2 (50)|PD1 (85)|PE3 (75)|
|MTIOC4C|P25 (23)|PB1 (59)|PE1 (77)|PE5 (73)|-|
|MTIOC4D|P31 (19)|P55 (39)|PC3 (49)|PD2 (84)|PE4 (74)|
|MTIOC5U|PA4 (66)|PD7 (79)|-|-|-|
|MTIOC5V|PA6 (64)|PD6 (80)|-|-|-|
|MTIOC5W|PB0 (61)|PD5 (81)|-|-|-|
|MTCLKA|P14 (32)|P24 (24)|PA4 (66)|PC6 (46)|-|
|MTCLKB|P15 (31)|P25 (23)|PA6 (64)|PC7 (45)|-|
|MTCLKC|P22 (26)|PA1 (69)|PC4 (48)|-|-|
|MTCLKD|P23 (25)|PA3 (67)|PC5 (47)|-|-|

---

## Port map order (TPU) / ポートマップ候補 (TPU)

- [port_map_tpu.hpp](port_map_tpu.hpp?ts=4)

### LFQFP64

|TPU|FIRST|SECOND|THIRD|
|---|---|---|---|
|TIOCA0|PA0 (45)|-|-|
|TIOCB0|P17 (17)|PA1 (44)|-|
|TIOCC0|P32 (--)|-|-|
|TIOCD0|P33 (--)|PA3 (43)|-|
|TIOCA1|PA4 (42)|-|-|
|TIOCB1|P16 (18)|PA5 (--)|-|
|TIOCA2|PA6 (41)|-|-|
|TIOCB2|P15 (19)|PA7 (--)|-|
|TIOCA3|P21 (--)|PB0 (39)|-|
|TIOCB3|P20 (--)|PB1 (37)|-|
|TIOCC3|P22 (--)|PB2 (--)|-|
|TIOCD3|P23 (--)|PB3 (36)|-|
|TIOCA4|P25 (--)|PB4 (--)|-|
|TIOCB4|P24 (--)|PB5 (35)|-|
|TIOCA5|P13 (--)|PB6 (34)|-|
|TIOCB5|P14 (20)|PB7 (33)|-|
|TCLKA|P14 (20)|PC2 (32)|-|
|TCLKB|P15 (19)|PA3 (43)|PC3 (31)|
|TCLKC|P16 (18)|PB2 (--)|PC0 (--)|
|TCLKD|P17 (17)|PB3 (36)|PC1 (--)|

### LFQFP100

|TPU|FIRST|SECOND|THIRD|
|---|---|---|---|
|TIOCA0|PA0 (70)|-|-|
|TIOCB0|P17 (29)|PA1 (69)|-|
|TIOCC0|P32 (18)|-|-|
|TIOCD0|P33 (17)|PA3 (67)|-|
|TIOCA1|PA4 (66)|-|-|
|TIOCB1|P16 (30)|PA5 (65)|-|
|TIOCA2|PA6 (64)|-|-|
|TIOCB2|P15 (31)|PA7 (63)|-|
|TIOCA3|P21 (27)|PB0 (61)|-|
|TIOCB3|P20 (28)|PB1 (59)|-|
|TIOCC3|P22 (26)|PB2 (58)|-|
|TIOCD3|P23 (25)|PB3 (57)|-|
|TIOCA4|P25 (23)|PB4 (56)|-|
|TIOCB4|P24 (24)|PB5 (55)|-|
|TIOCA5|P13 (33)|PB6 (54)|-|
|TIOCB5|P14 (32)|PB7 (53)|-|
|TCLKA|P14 (32)|PC2 (50)|-|
|TCLKB|P15 (31)|PA3 (67)|PC3 (49)|
|TCLKC|P16 (30)|PB2 (58)|PC0 (52)|
|TCLKD|P17 (29)|PB3 (57)|PC1 (51)|

---

## Port map order (TMR) / ポートマップ候補 (TMR)

- [port_map_tmr.hpp](../RX220/port_map_tmr.hpp?ts=4)

### LFQFP64

|TMR|FIRST|SECOND|THIRD|
|---|---|---|---|
|TMO0|P22 (--)|PB3 (36)|PH1 (23)|
|TMCI0|P21 (--)|PB1 (37)|PH3 (21)|
|TMRI0|P20 (--)|PA4 (42)|PH2 (22)|
|TMO1|P17 (17)|P26 (16)|-|
|TMCI1|P12 (--)|P54 (26)|PC4 (30)|
|TMRI1|P24 (--)|PB5 (35)|-|
|TMO2|P16 (18)|PC7 (27)|-|
|TMCI2|P15 (19)|P31 (13)|PC6 (28)|
|TMRI2|P14 (20)|PC5 (29)|-|
|TMO3|P13 (--)|P32 (12)|P55 (25)|
|TMCI3|P27 (15)|P34 (--)|PA6 (41)|
|TMRI3|P30 (14)|P33 (--)|-|

### LFQFP100

|TMR|FIRST|SECOND|THIRD|
|---|---|---|---|
|TMO0|P22 (26)|PB3 (57)|PH1 (37)|
|TMCI0|P21 (27)|PB1 (59)|PH3 (35)|
|TMRI0|P20 (28)|PA4 (66)|PH2 (36)|
|TMO1|P17 (29)|P26 (22)|-|
|TMCI1|P12 (34)|P54 (40)|PC4 (48)|
|TMRI1|P24 (24)|PB5 (55)|-|
|TMO2|P16 (30)|PC7 (45)|-|
|TMCI2|P15 (31)|P31 (19)|PC6 (46)|
|TMRI2|P14 (32)|PC5 (47)|-|
|TMO3|P13 (33)|P32 (18)|P55 (39)|
|TMCI3|P27 (21)|P34 (16)|PA6 (64)|
|TMRI3|P30 (20)|P33 (17)|-|

---

## 12 Bits A/D Converter input (S12AD) / 12 ビット A/D コンバーター入力 (S12AD)

- [s12ade.hpp](s12ade.hpp?ts=4)

### LFQFP64

|S12AD/ANALOG|Port|
|---|---|
|AN000|P40 (60)|
|AN001|P41 (58)|
|AN002|P42 (57)|
|AN003|P43 (56)|
|AN004|P44 (55)|
|AN005|P45 (--)|
|AN006|P46 (53)|
|AN007|P47 (--)|
|||
|AN016|PE0 (51)|
|AN017|PE1 (50)|
|AN018|PE2 (49)|
|AN019|PE3 (48)|
|AN020|PE4 (47)|
|AN021|PE5 (46)|
|AN022|PE6 (--)|
|AN023|PE7 (--)|
|AN024|PD0 (--)|
|AN025|PD1 (--)|
|AN026|PD2 (--)|
|AN027|PD3 (--)|
|AN028|PD4 (--)|
|AN029|PD5 (--)|
|AN030|PD6 (--)|
|AN031|PD7 (--)|

### LFQFP100

|S12AD/ANALOG|Port|
|---|---|
|AN000|P40 (95)|
|AN001|P41 (93)|
|AN002|P42 (92)|
|AN003|P43 (91)|
|AN004|P44 (90)|
|AN005|P45 (89)|
|AN006|P46 (88)|
|AN007|P47 (87)|
|||
|AN016|PE0 (78)|
|AN017|PE1 (77)|
|AN018|PE2 (76)|
|AN019|PE3 (75)|
|AN020|PE4 (74)|
|AN021|PE5 (73)|
|AN022|PE6 (72)|
|AN023|PE7 (71)|
|AN024|PD0 (86)|
|AN025|PD1 (85)|
|AN026|PD2 (84)|
|AN027|PD3 (83)|
|AN028|PD4 (82)|
|AN029|PD5 (81)|
|AN030|PD6 (80)|
|AN031|PD7 (79)|

---

## 12 Bits D/A Converter output (R12DA) / 12 ビット D/A コンバーター出力 (R12DA)

- [r12da.hpp](../RX600/r12da.hpp?ts=4)

### LFQFP64

|R12DA/ANALOG|Port|
|---|---|
|DA0|P03 (1)|
|DA1|P05 (63)|

### LFQFP100

|R12DA/ANALOG|Port|
|---|---|
|DA0|P03 (2)|
|DA1|P05 (100)|

---

## rx_prog Flash Programming / rx_prog フラッシュプログラム

||Support/サポート|operation verification/動作検証|
|-|:-:|:-:|
|[rxprog](../rxprog)|〇|〇|

rx_prog option:
- --write-page-wait=10000
- --erase-page-wait=5000

---

Translated with www.DeepL.com/Translator (free version)

---

## License

[MIT](../LICENSE)
