hirakuni45/RX/AUDIO_sample/res/NoImage.jpg

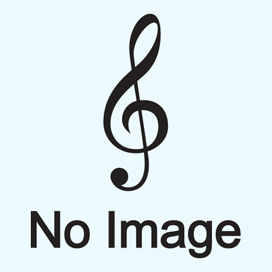
AUDIO_sample/res/NoImage.jpg
