hirakuni45/RX/CALC_sample/resource/MathFont.png

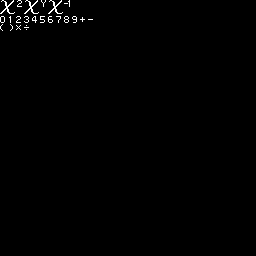
CALC_sample/resource/MathFont.png
