hirakuni45/RX/docs/AUDIO_AMP.jpg

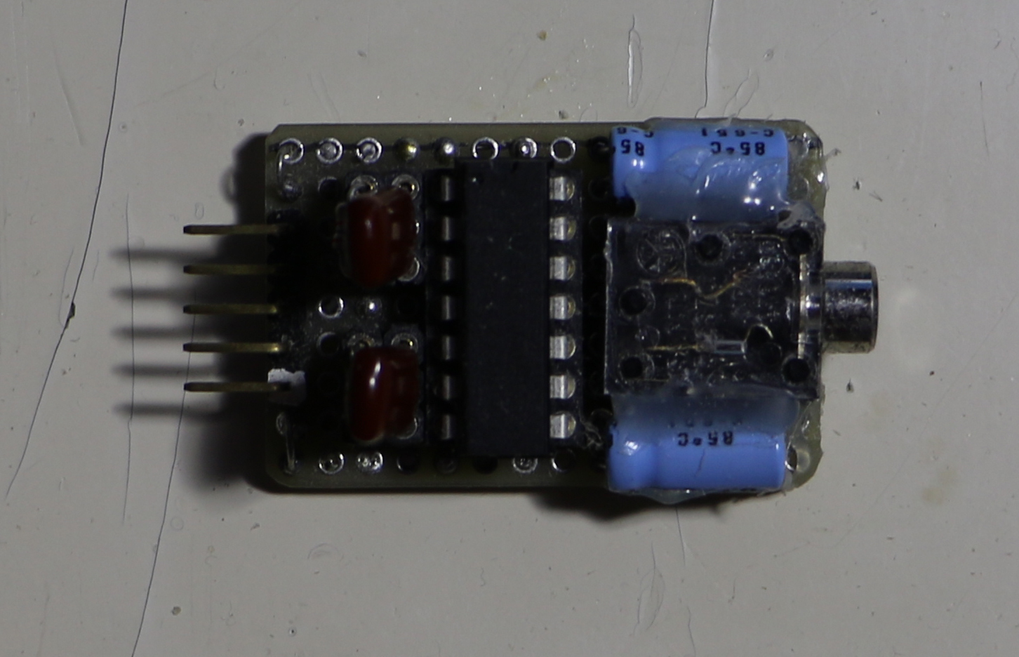
docs/AUDIO_AMP.jpg
