hirakuni45/RX/docs/AudioLead.jpg

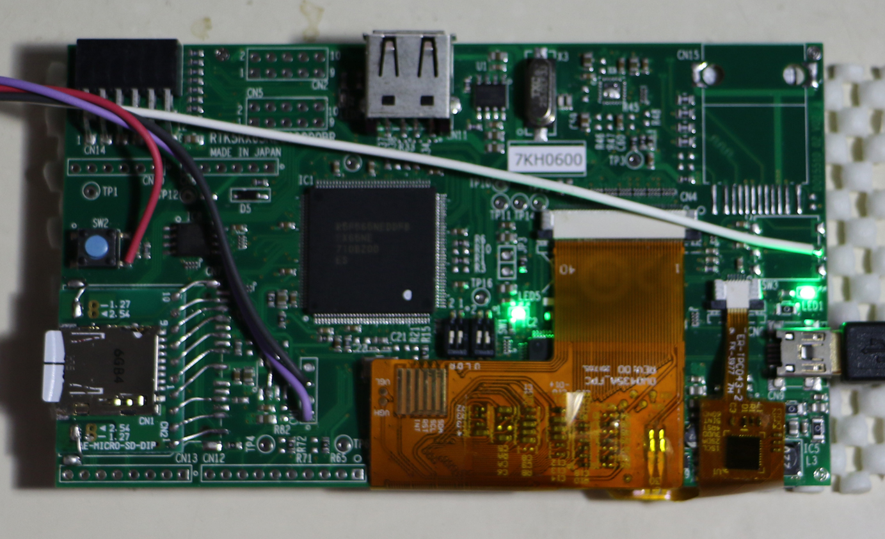
docs/AudioLead.jpg
