hirakuni45/RX/docs/AudioPlayer2.JPG

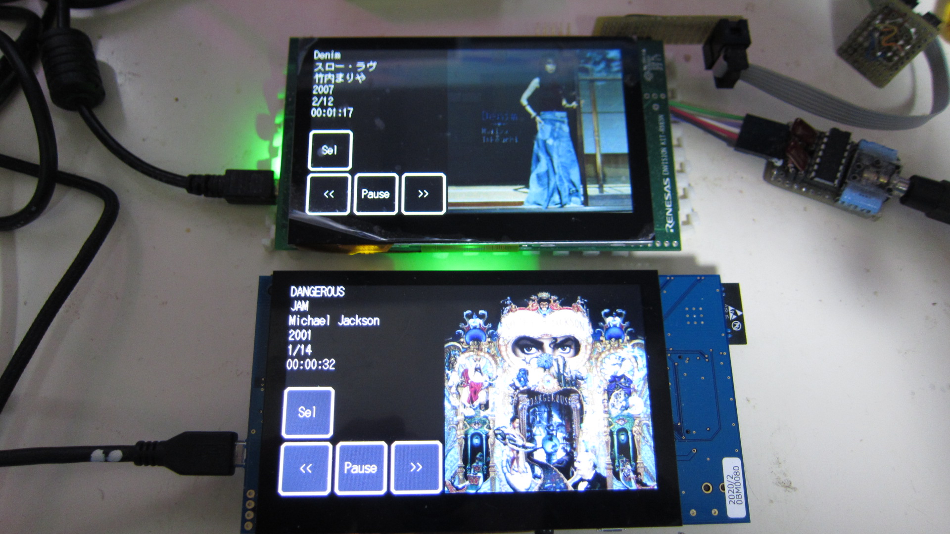
docs/AudioPlayer2.JPG
