hirakuni45/RX/docs/AudioPlayer3.JPG

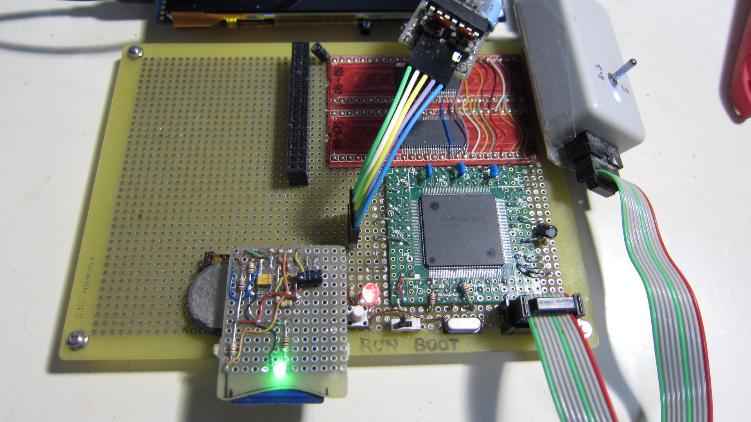
docs/AudioPlayer3.JPG
