hirakuni45/RX/docs/black.jpg

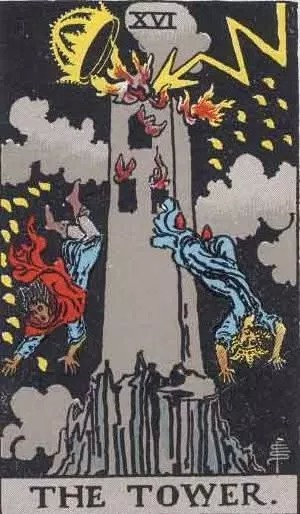
docs/black.jpg
