hirakuni45/RX/docs/C_CPP.jpg

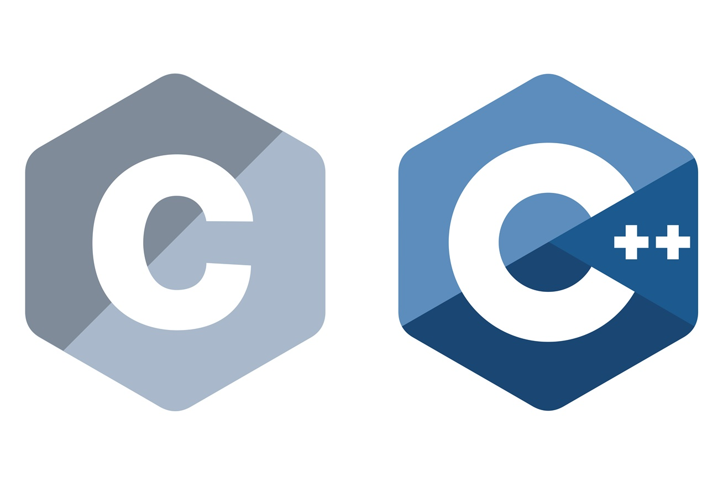
docs/C_CPP.jpg
