hirakuni45/RX/docs/calc_gui1.jpg

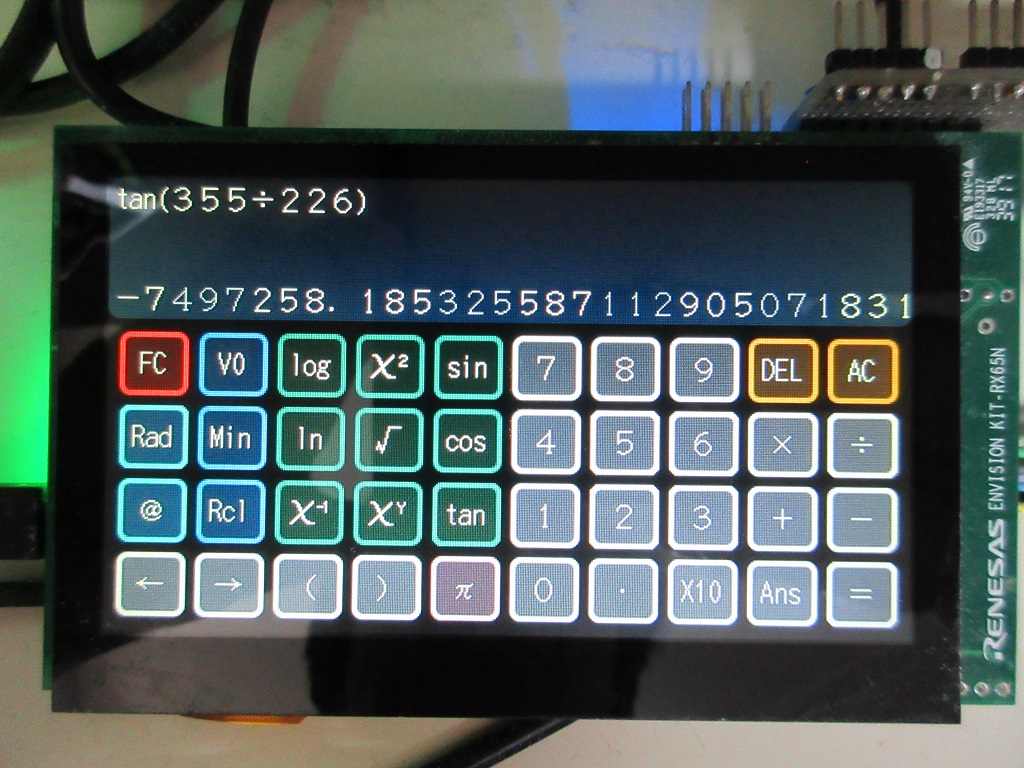
docs/calc_gui1.jpg
