hirakuni45/RX/docs/calc_gui2.jpg

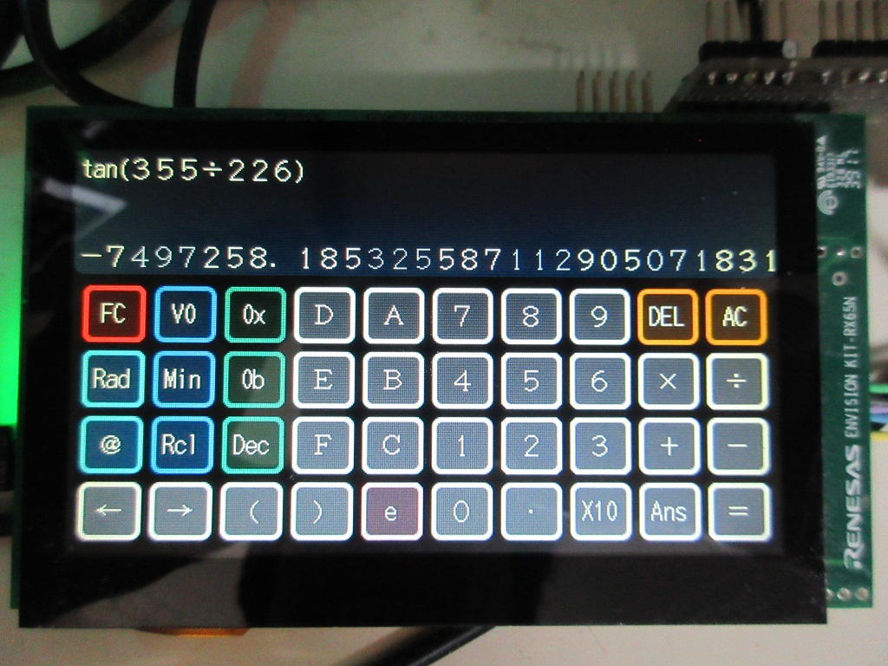
docs/calc_gui2.jpg
