hirakuni45/RX/docs/calc_gui3.jpg

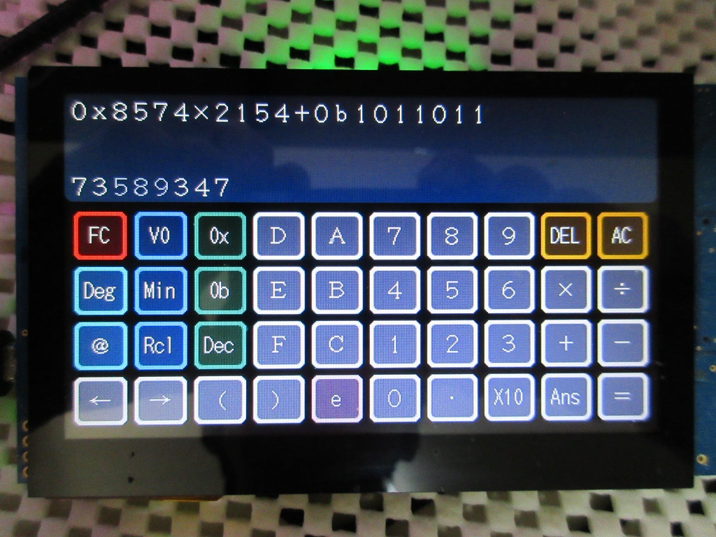
docs/calc_gui3.jpg
