hirakuni45/RX/docs/calc_gui4.jpg

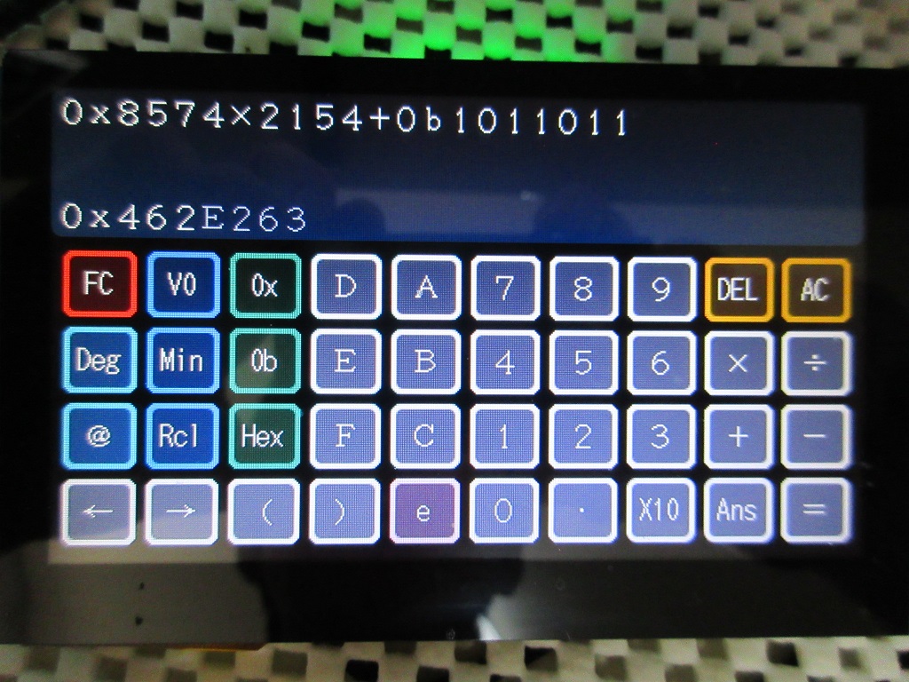
docs/calc_gui4.jpg
