hirakuni45/RX/docs/calc_gui5.jpg

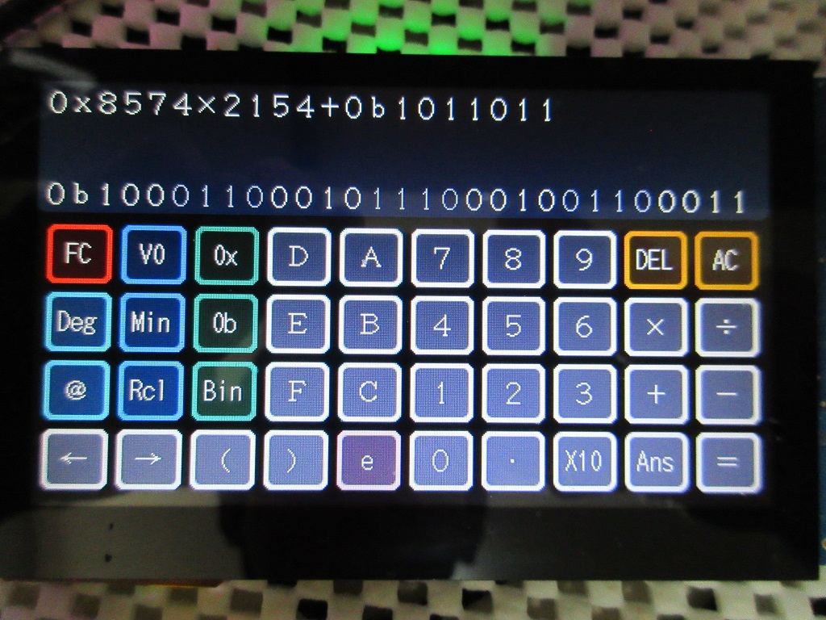
docs/calc_gui5.jpg
