hirakuni45/RX/docs/CAN_IF.png

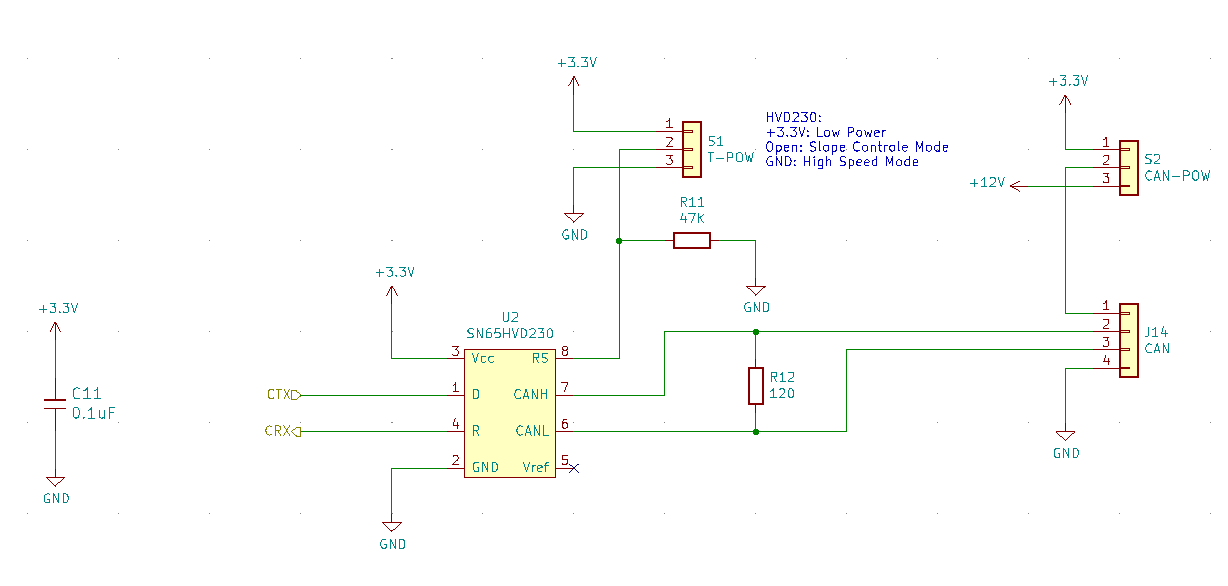
docs/CAN_IF.png
