hirakuni45/RX/docs/cpp_book1.jpg

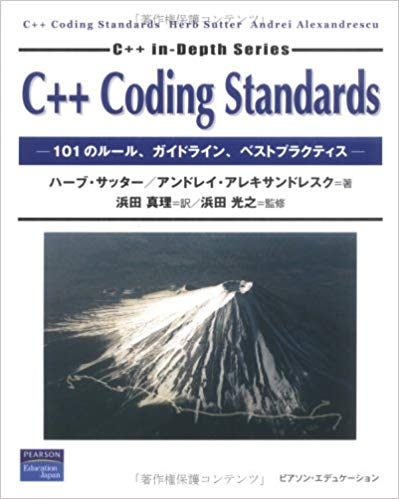
docs/cpp_book1.jpg
