hirakuni45/RX/docs/DSOS_SIN.jpg

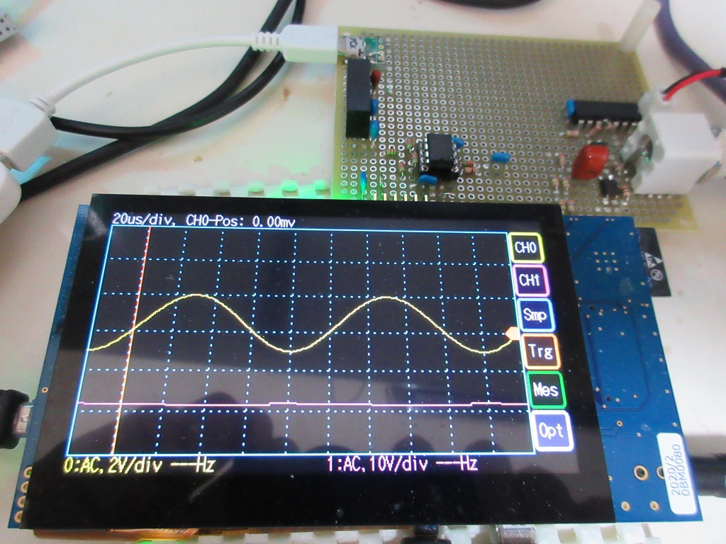
docs/DSOS_SIN.jpg
