hirakuni45/RX/docs/DSOS_SQUARE.jpg

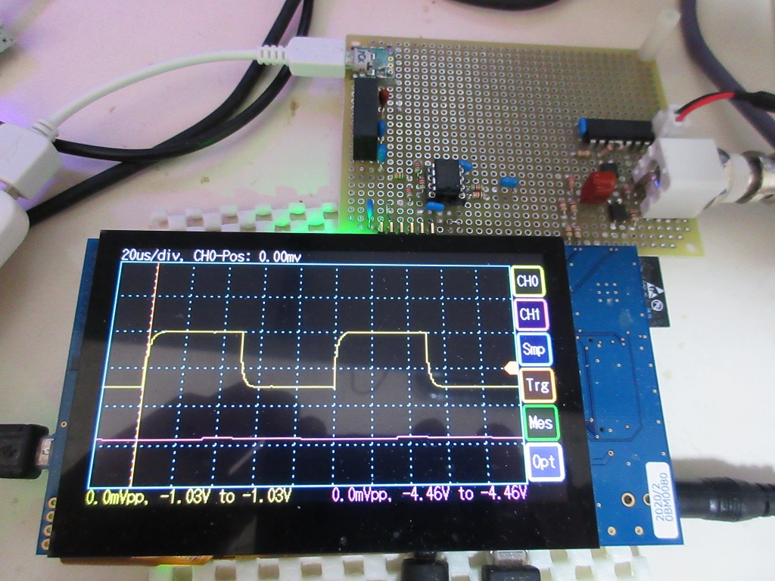
docs/DSOS_SQUARE.jpg
