hirakuni45/RX/docs/gcc_console.png

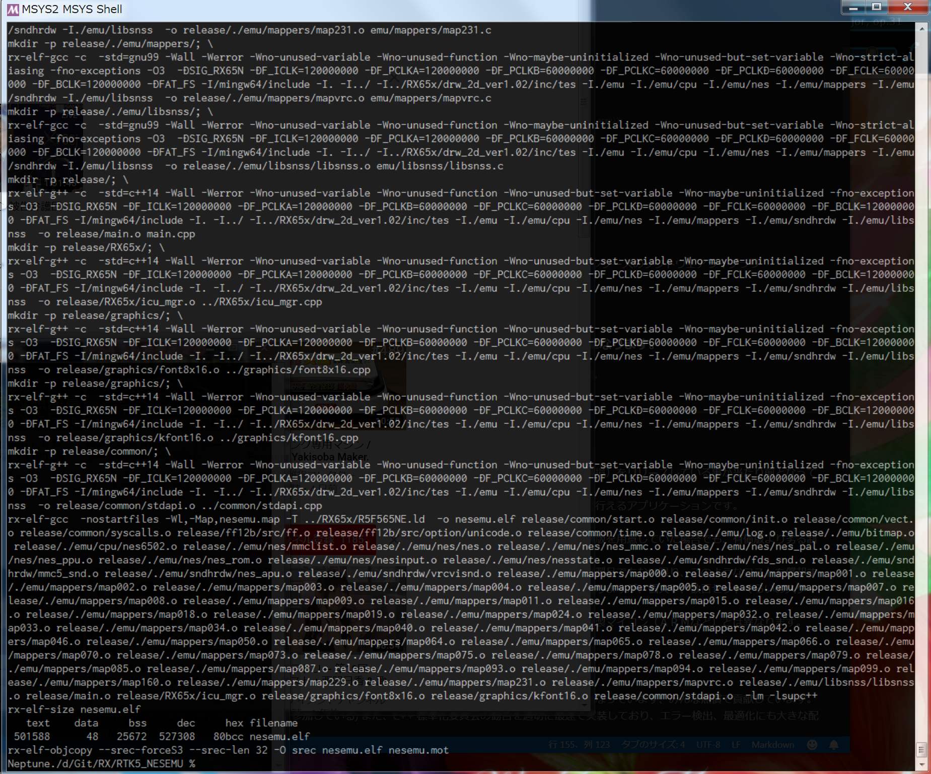
docs/gcc_console.png
