hirakuni45/RX/docs/GPTW_sample_RX72N.png

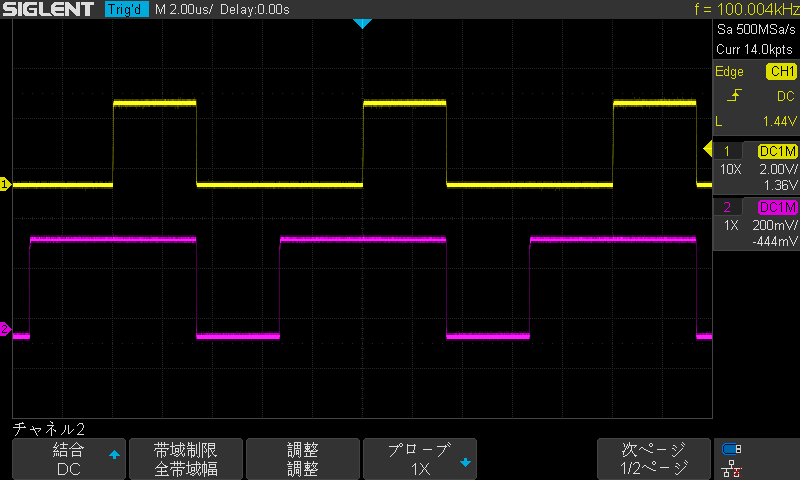
docs/GPTW_sample_RX72N.png
