hirakuni45/RX/docs/gui_sample.jpg

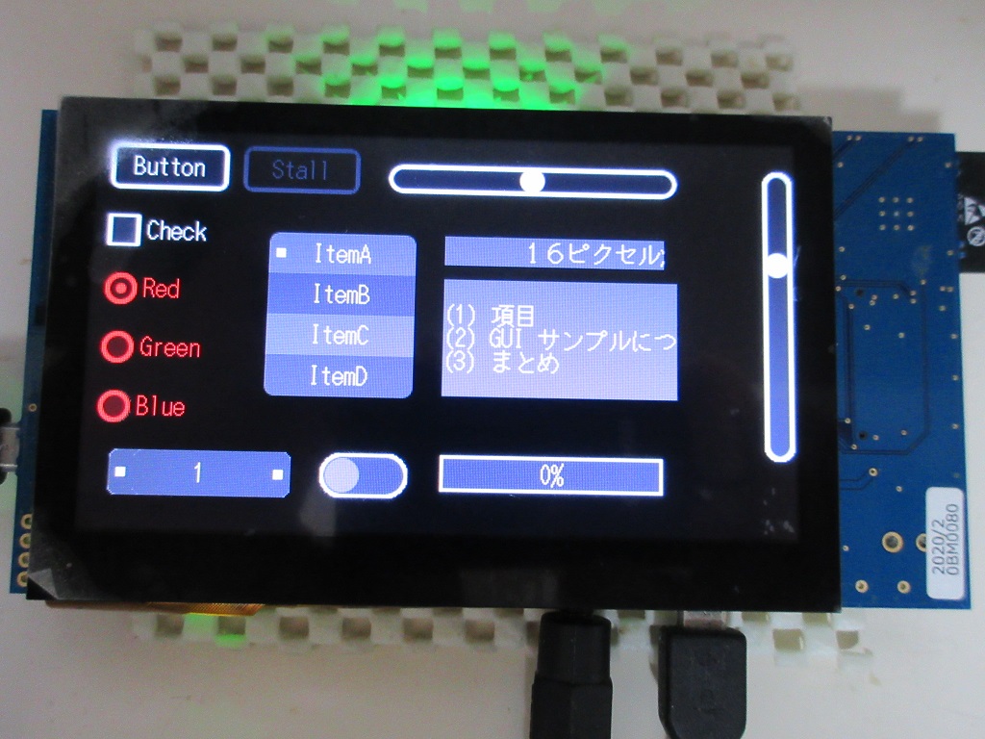
docs/gui_sample.jpg
