hirakuni45/RX/docs/I-03942.jpg

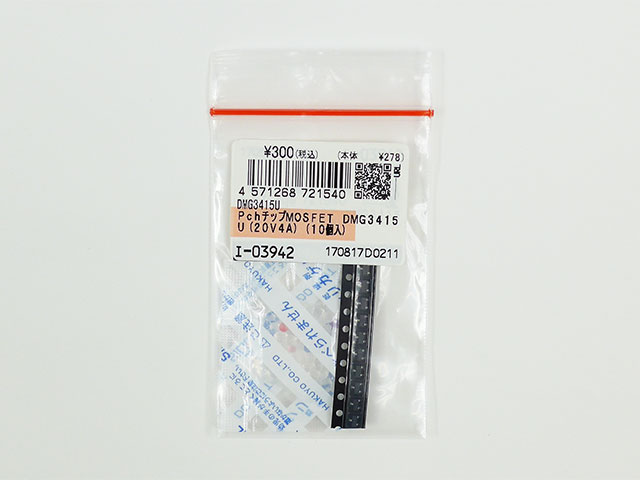
docs/I-03942.jpg
