hirakuni45/RX/docs/IC_ETC.jpg

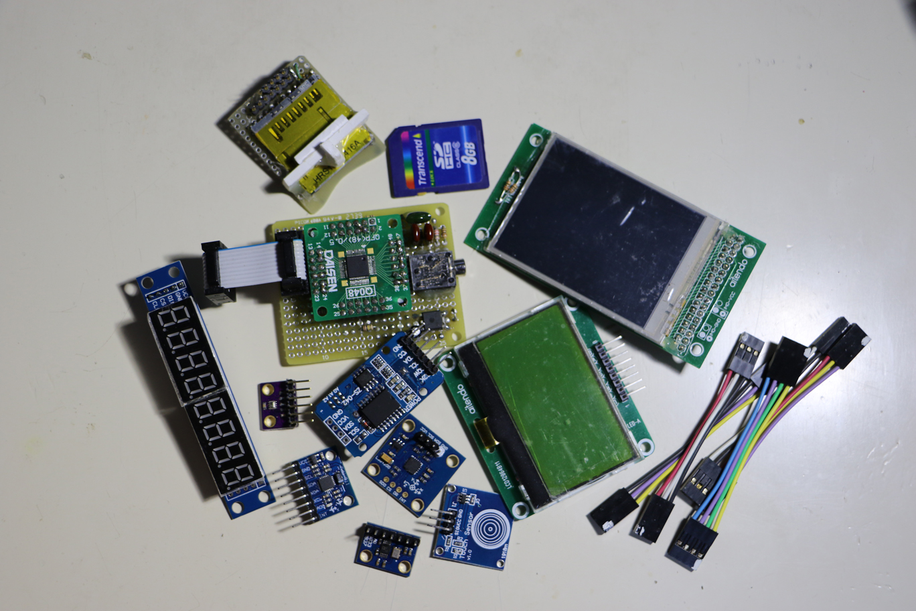
docs/IC_ETC.jpg
