hirakuni45/RX/docs/JoyPad.jpg

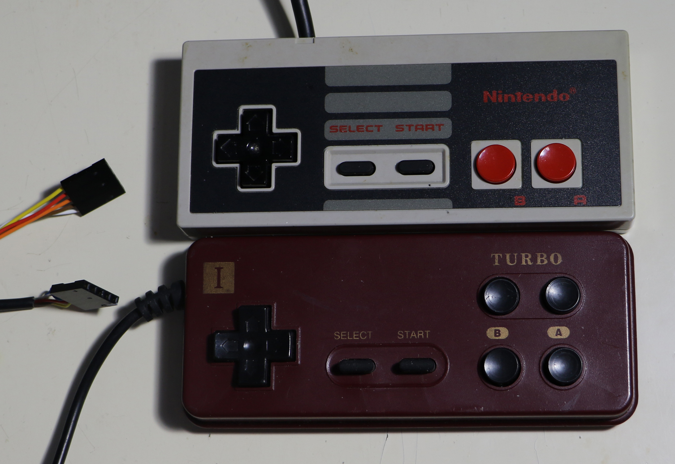
docs/JoyPad.jpg
