hirakuni45/RX/docs/JoyPadCon.jpg

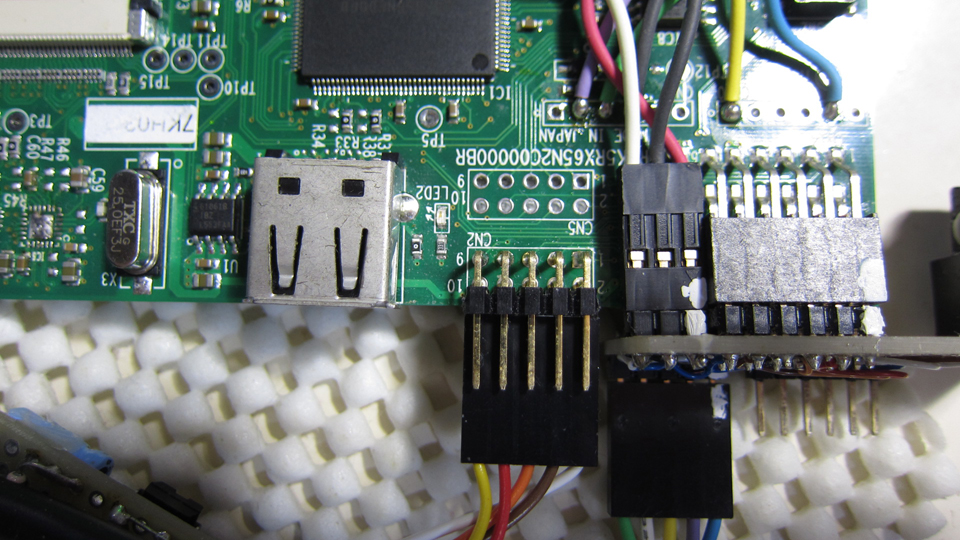
docs/JoyPadCon.jpg
