hirakuni45/RX/docs/MicroSD.JPG

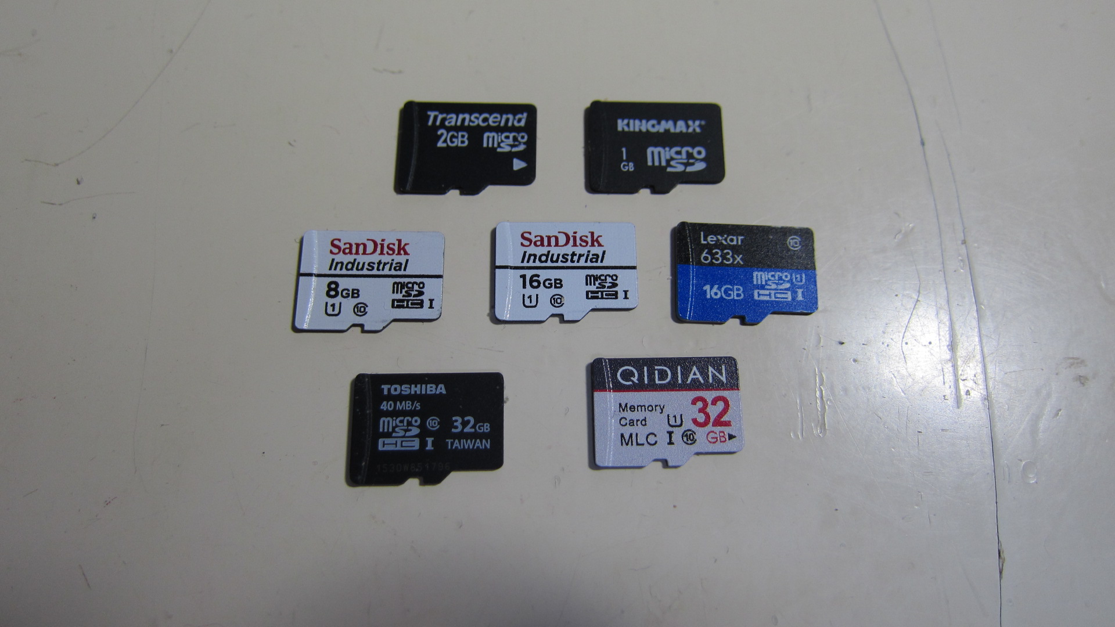
docs/MicroSD.JPG
