hirakuni45/RX/docs/NES_002.jpg

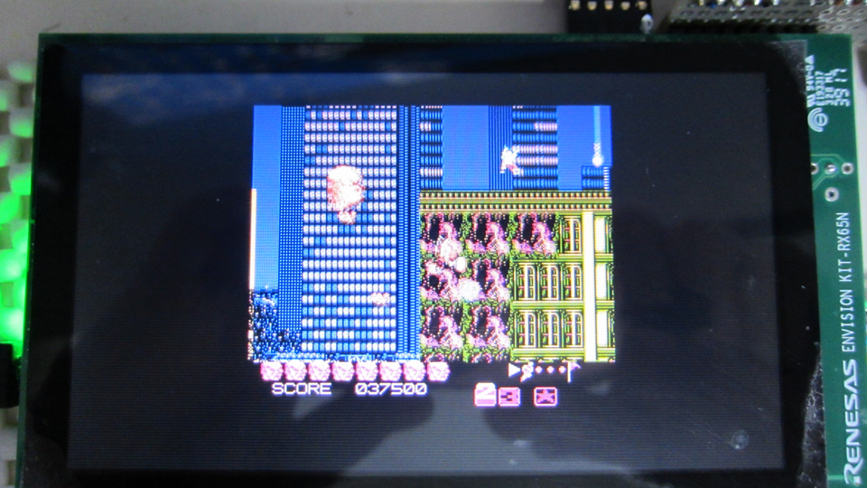
docs/NES_002.jpg
