hirakuni45/RX/docs/ProgramLang.jpg

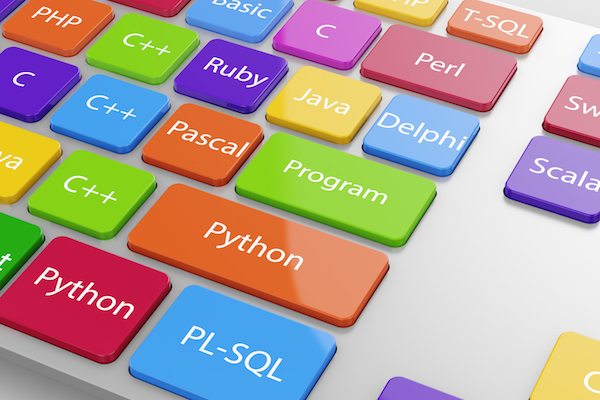
docs/ProgramLang.jpg
