hirakuni45/RX/docs/RFP_001.png

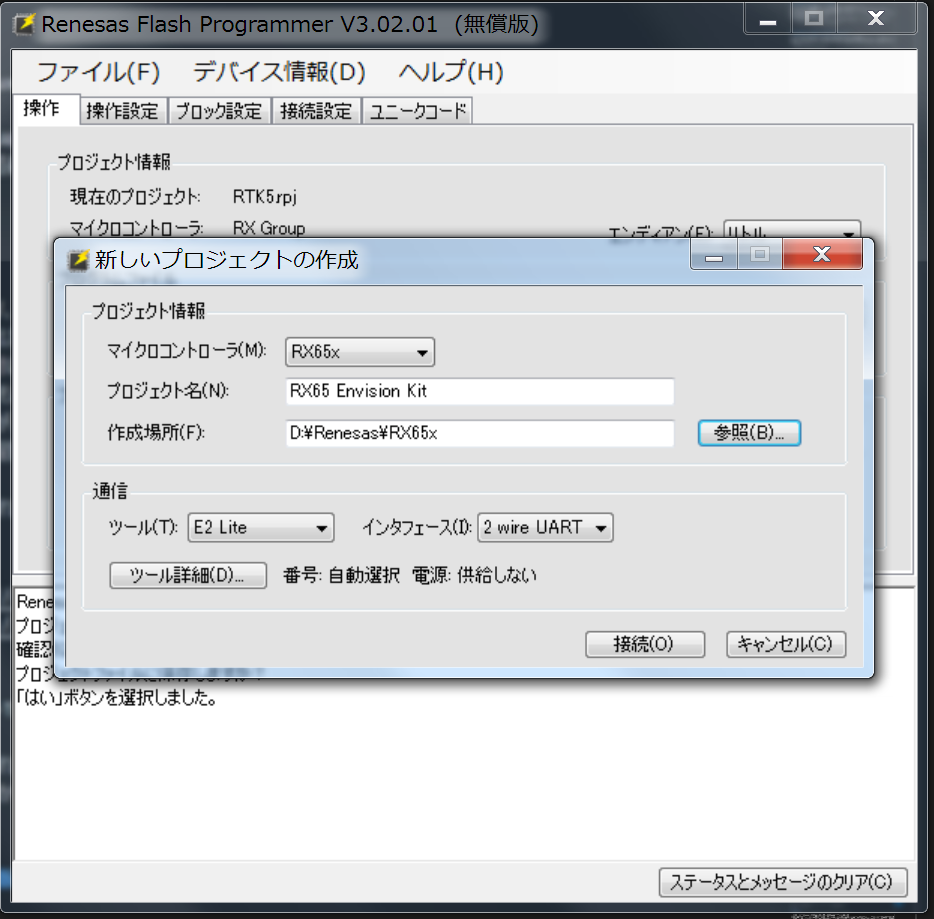
docs/RFP_001.png
