hirakuni45/RX/docs/RFP_002.png

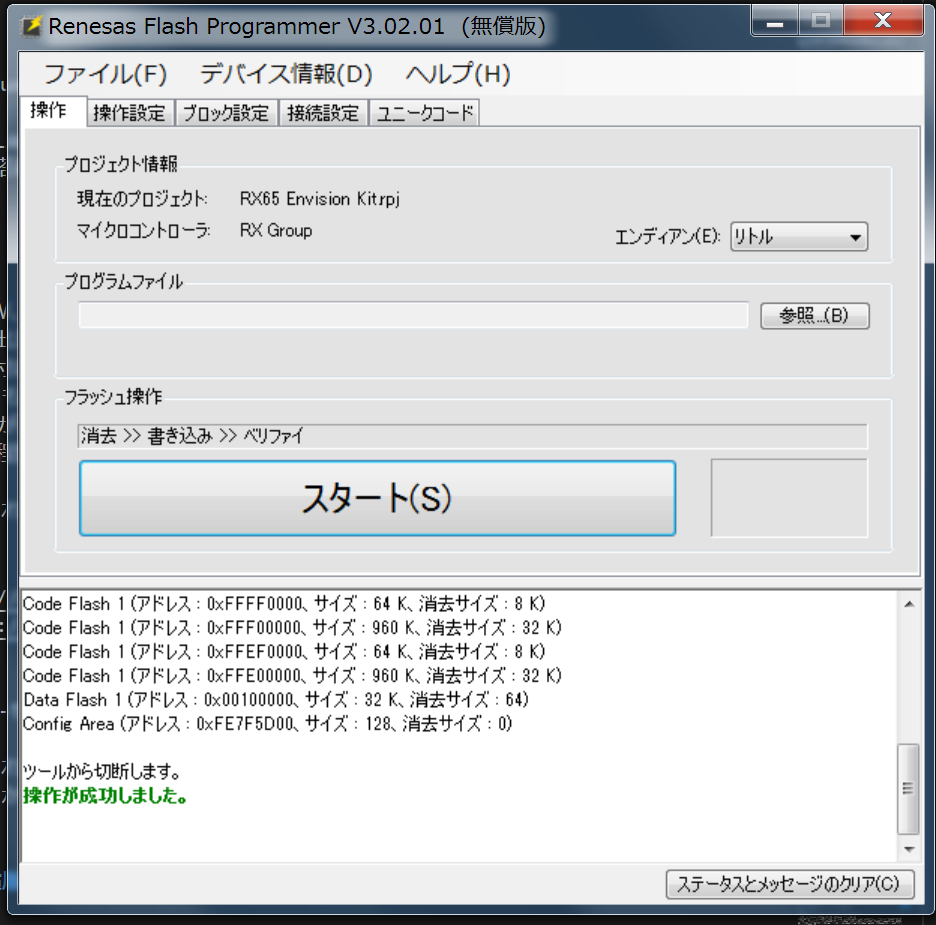
docs/RFP_002.png
