hirakuni45/RX/docs/RFP_003.png

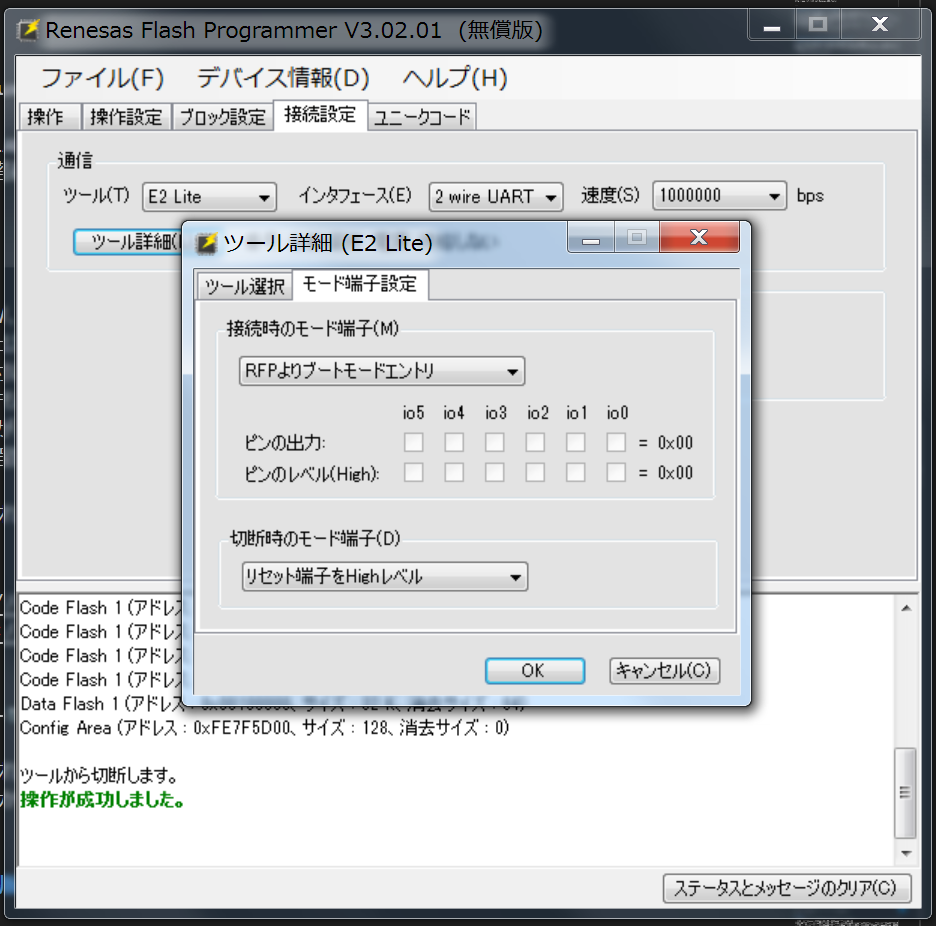
docs/RFP_003.png
