hirakuni45/RX/docs/RTK5_audio_amp.png

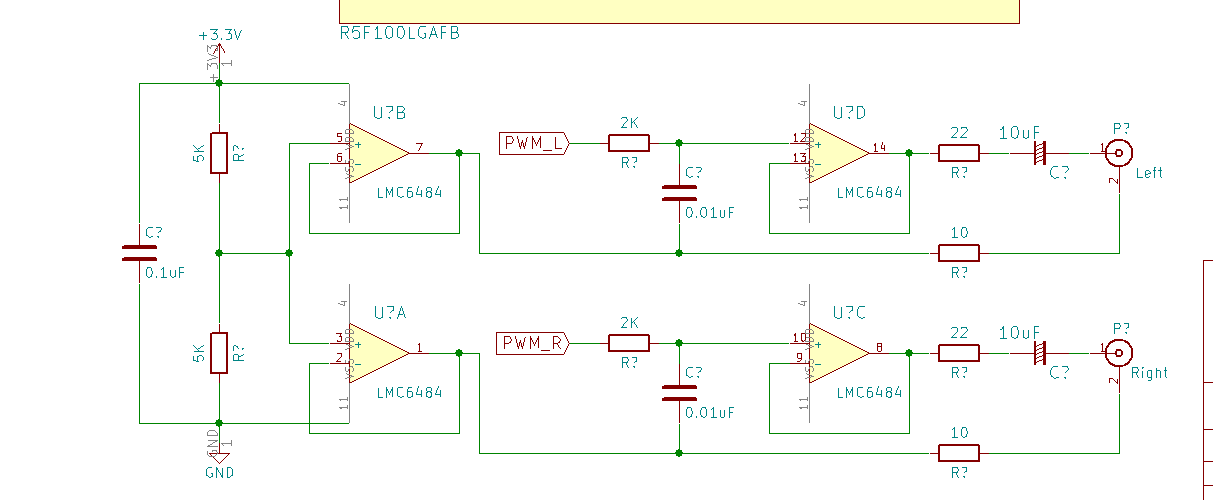
docs/RTK5_audio_amp.png
