hirakuni45/RX/docs/RTK5_MicroSD_PSW.jpg

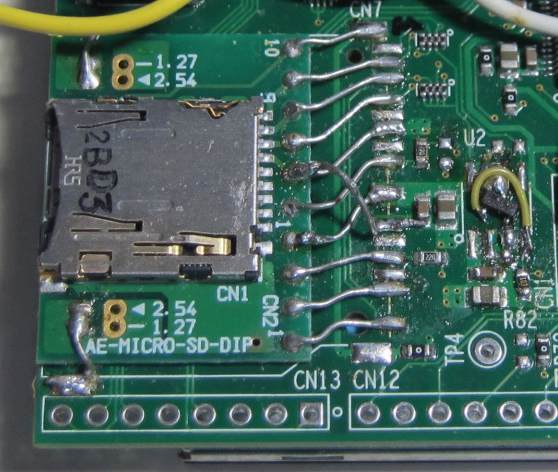
docs/RTK5_MicroSD_PSW.jpg
