hirakuni45/RX/docs/RTK5_MSD.jpg

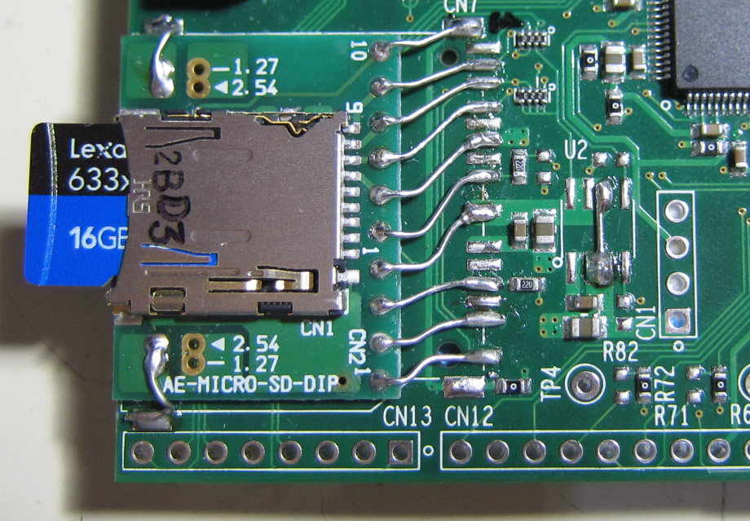
docs/RTK5_MSD.jpg
