hirakuni45/RX/docs/RTK5_SD_Circuit.png

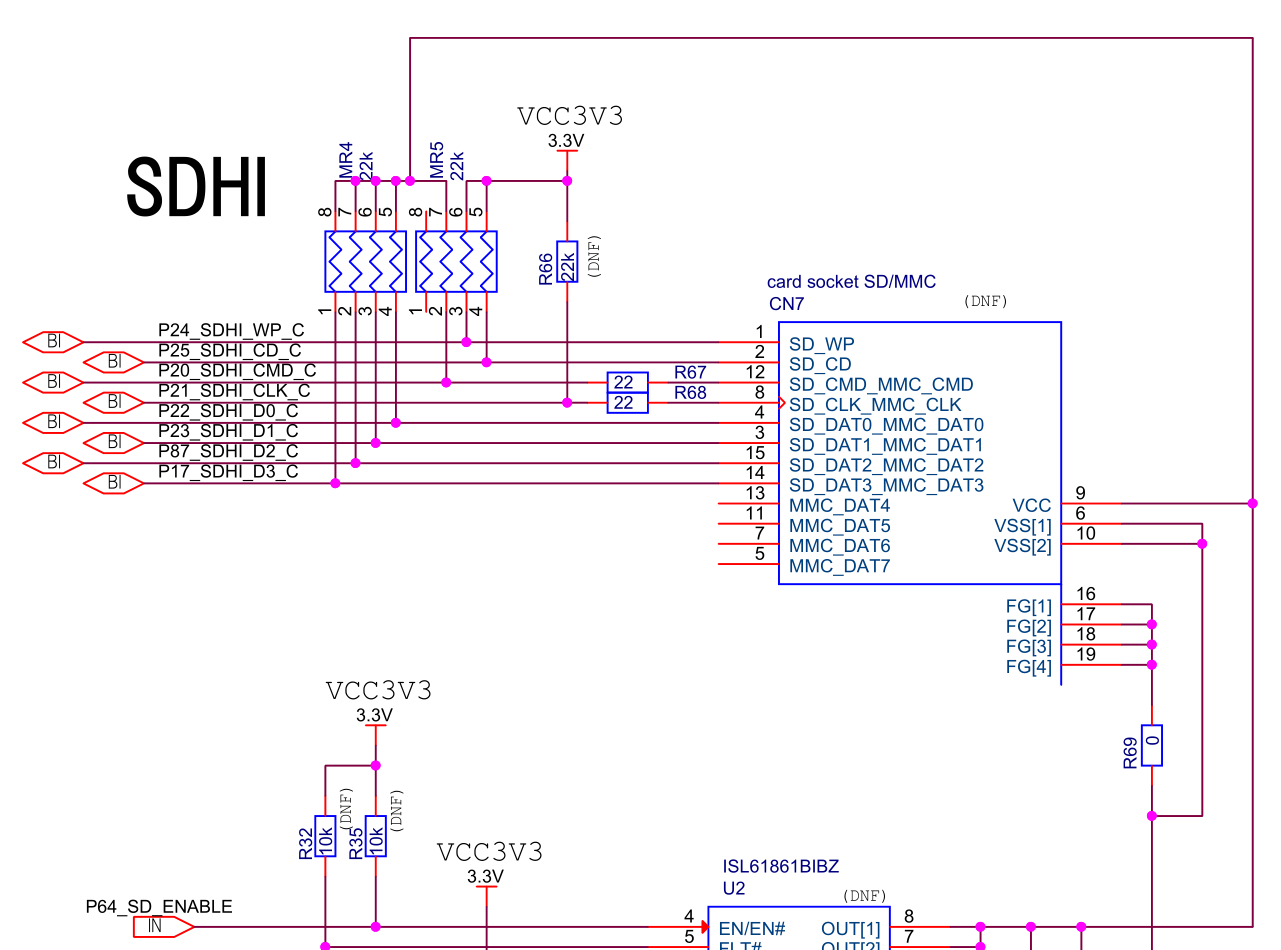
docs/RTK5_SD_Circuit.png
