hirakuni45/RX/docs/RTK5RX65N.jpg

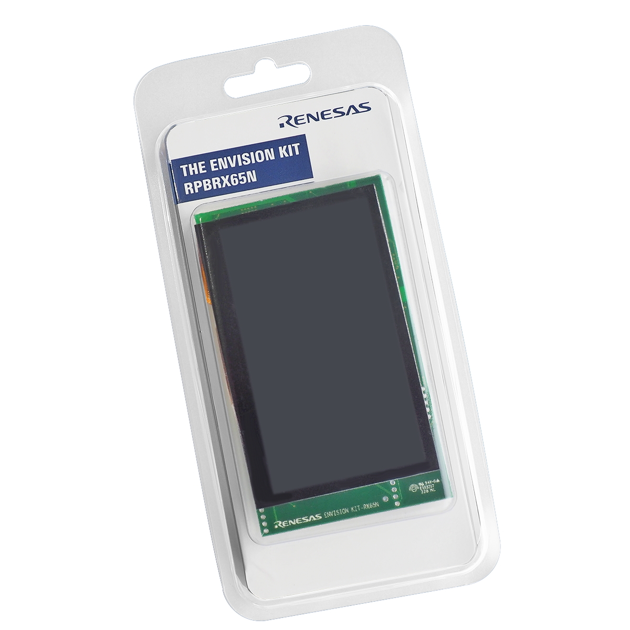
docs/RTK5RX65N.jpg
