hirakuni45/RX/docs/RX64M_SERIAL.jpg

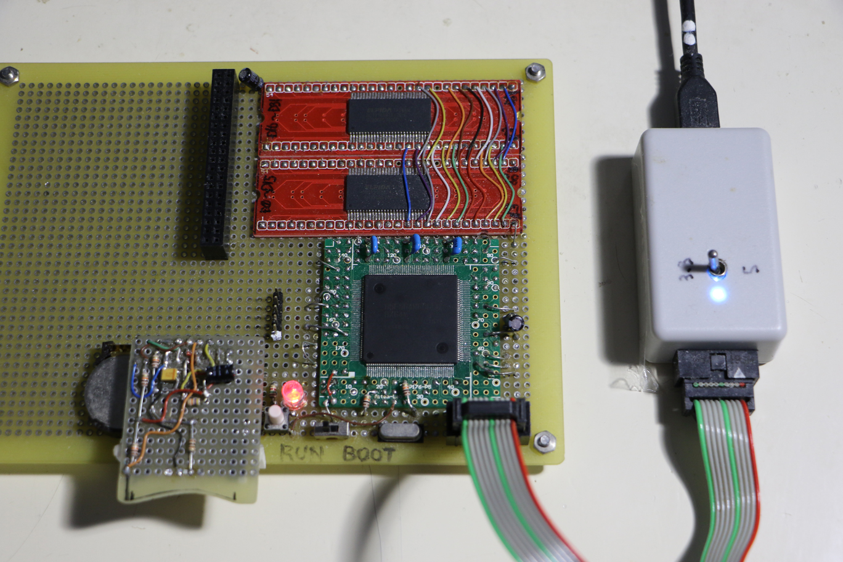
docs/RX64M_SERIAL.jpg
