hirakuni45/RX/docs/RX65N_CN2.png

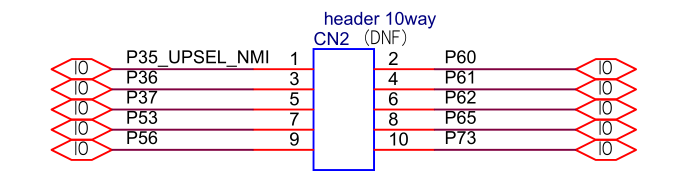
docs/RX65N_CN2.png
