hirakuni45/RX/docs/RX65N_CN2_JoyPad.jpg

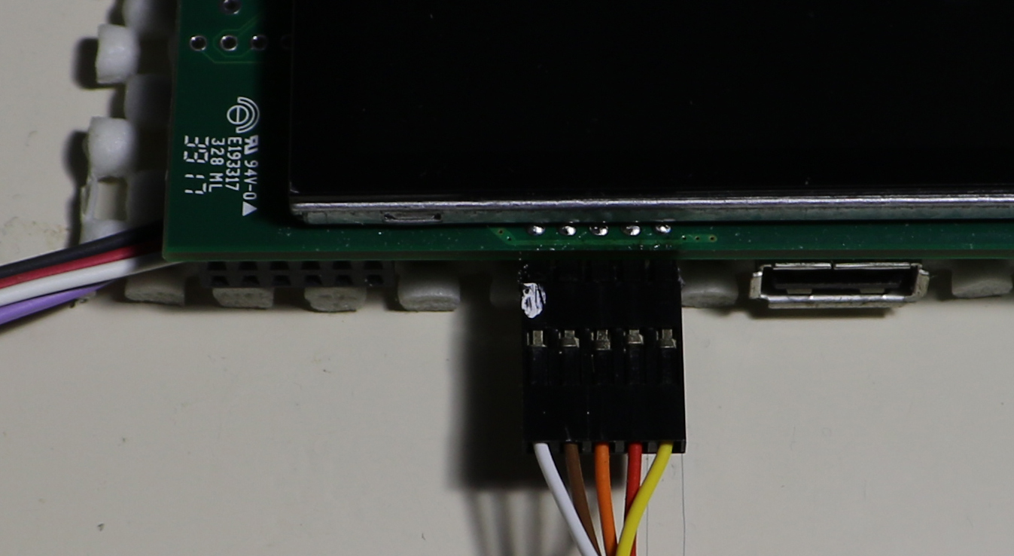
docs/RX65N_CN2_JoyPad.jpg
