hirakuni45/RX/docs/RX65N_DIP_SW.jpg

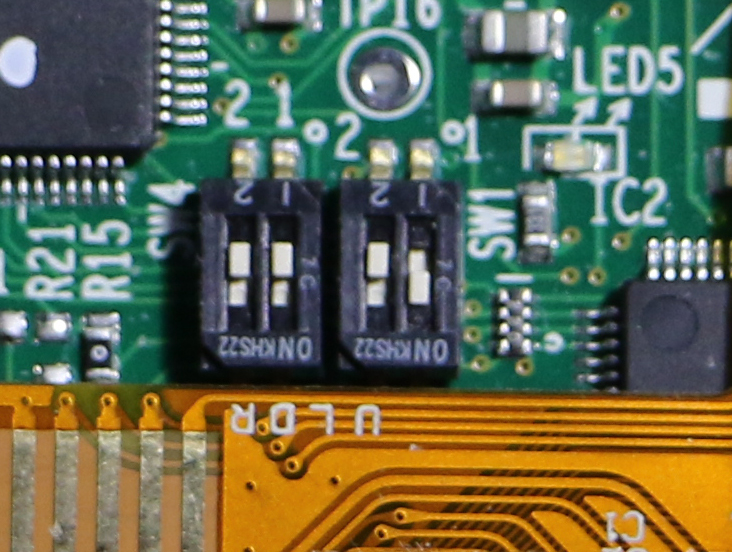
docs/RX65N_DIP_SW.jpg
