hirakuni45/RX/docs/RX65N_LED_BLINK.jpg

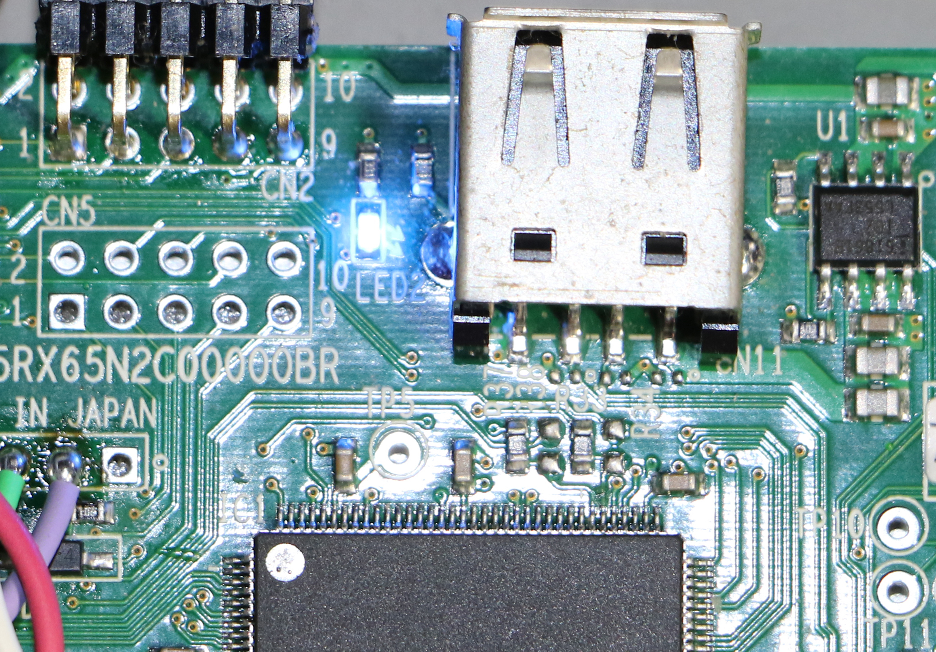
docs/RX65N_LED_BLINK.jpg
