hirakuni45/RX/docs/RX65N_raytrace3.jpg

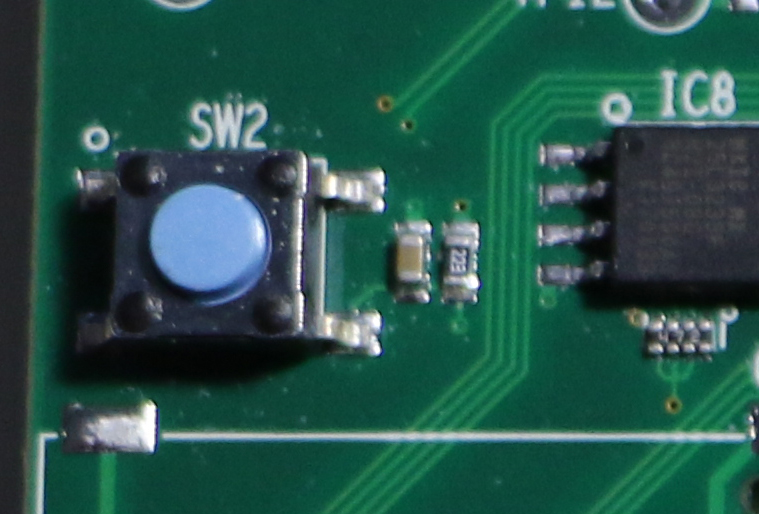
docs/RX65N_raytrace3.jpg
