hirakuni45/RX/docs/RX65N_SDC_001.jpg

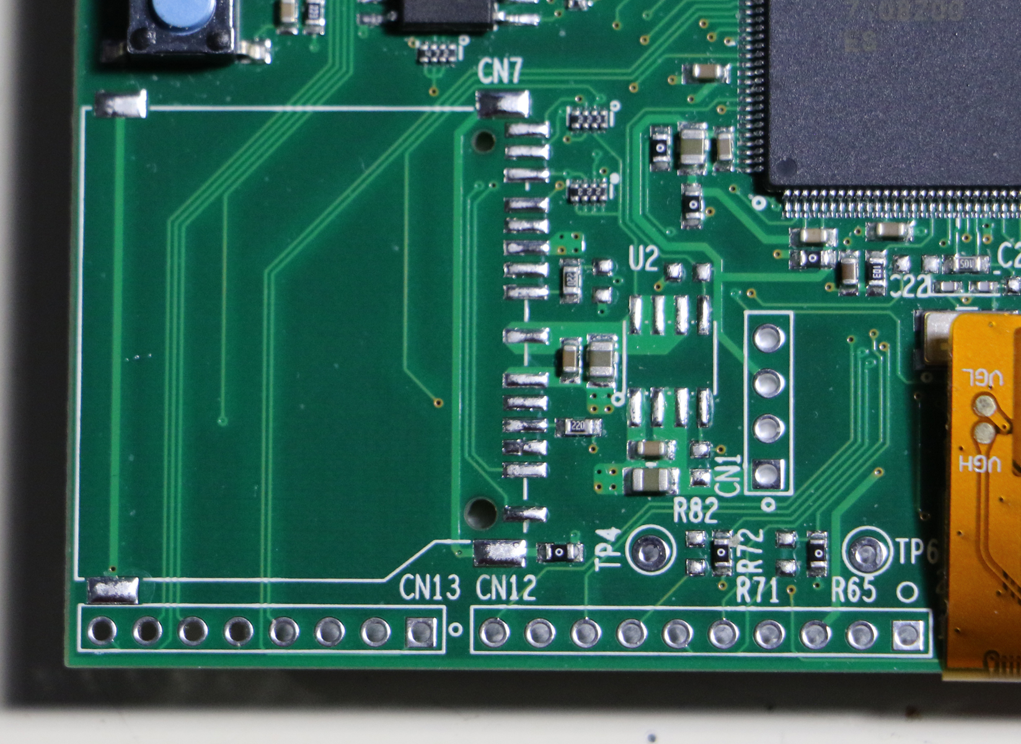
docs/RX65N_SDC_001.jpg
