hirakuni45/RX/docs/RX65N_Serial.jpg

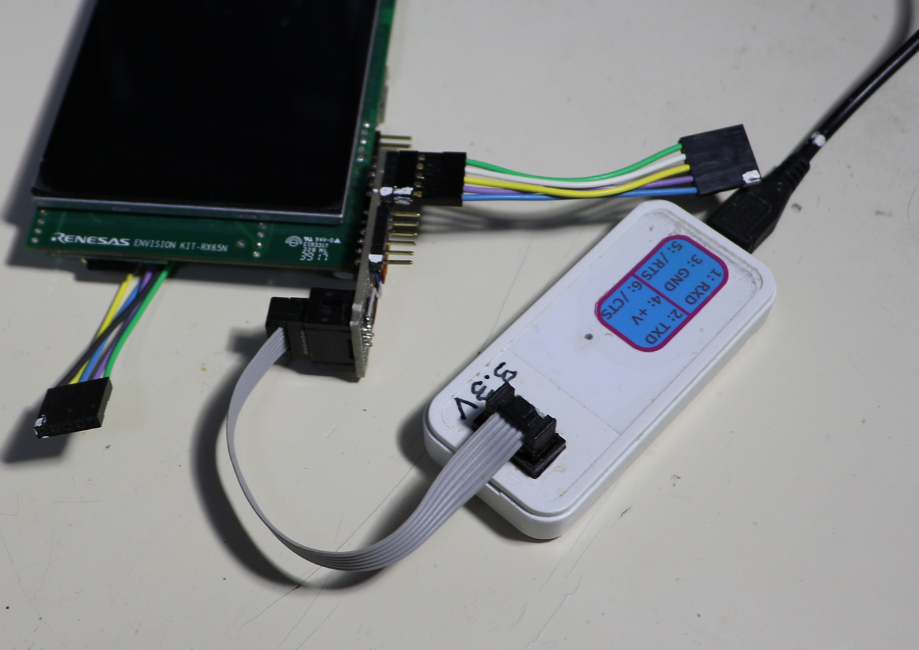
docs/RX65N_Serial.jpg
