hirakuni45/RX/docs/RX72N_MicroSD.JPG

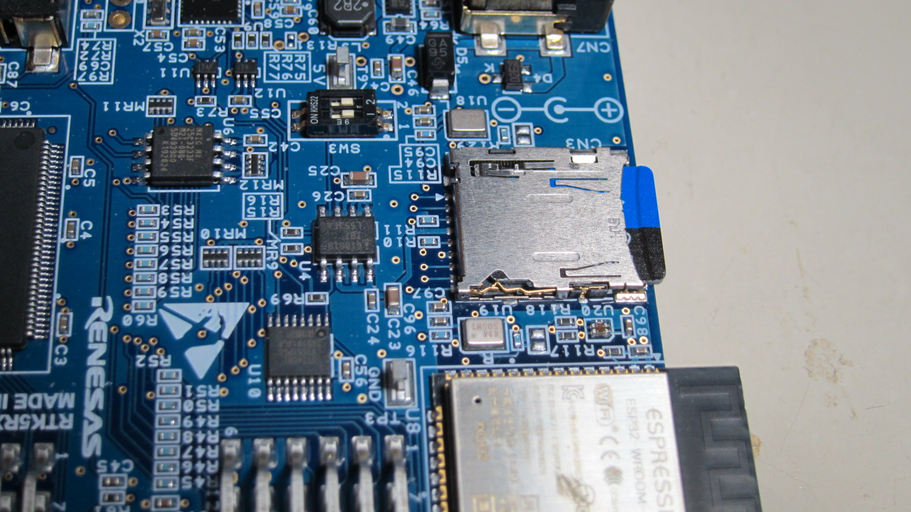
docs/RX72N_MicroSD.JPG
