hirakuni45/RX/docs/RX72T_PCB_fin.png

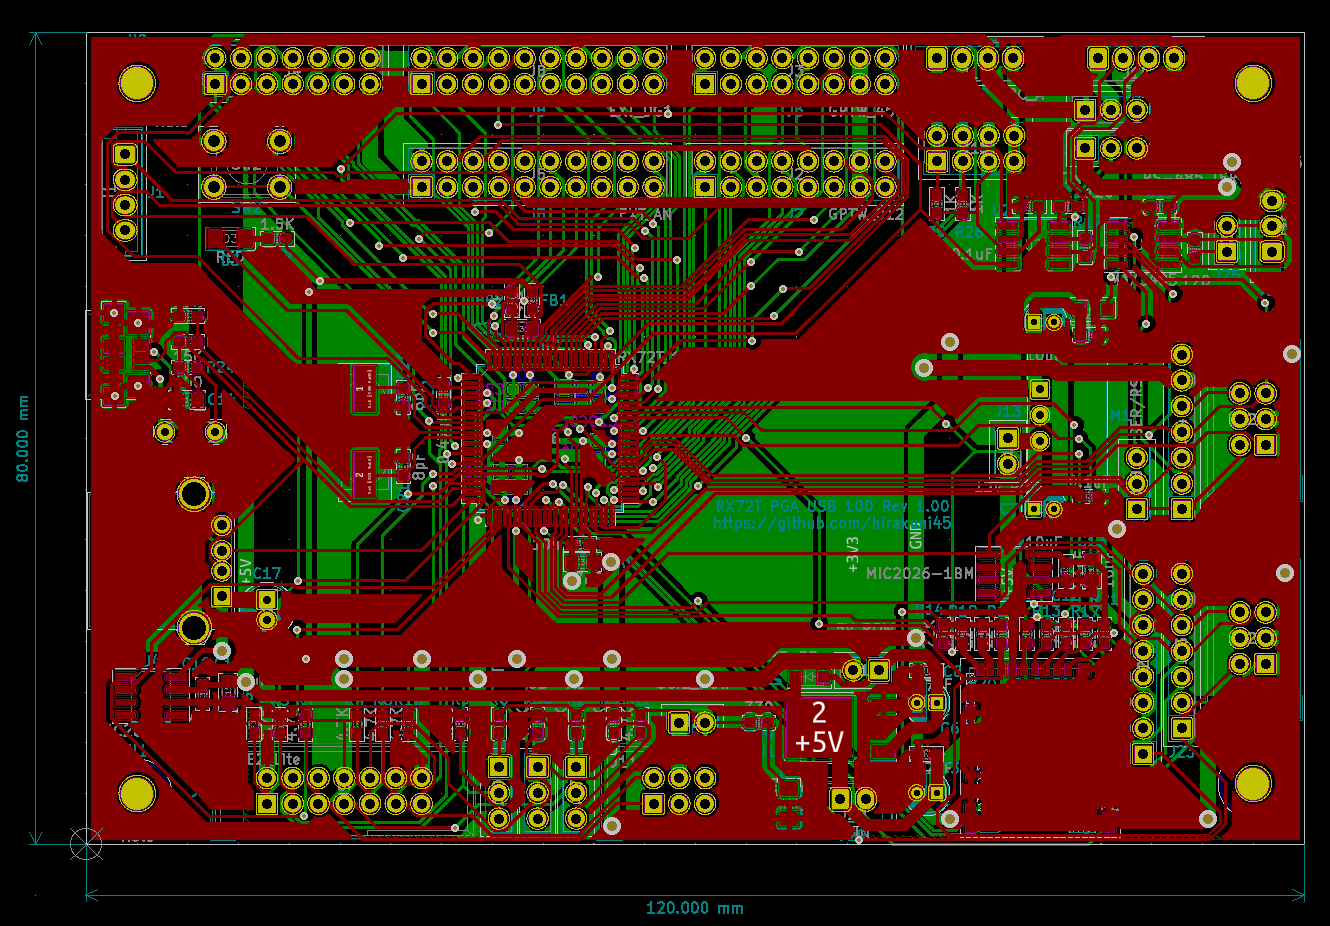
docs/RX72T_PCB_fin.png
