hirakuni45/RX/docs/RX_Serise.jpg

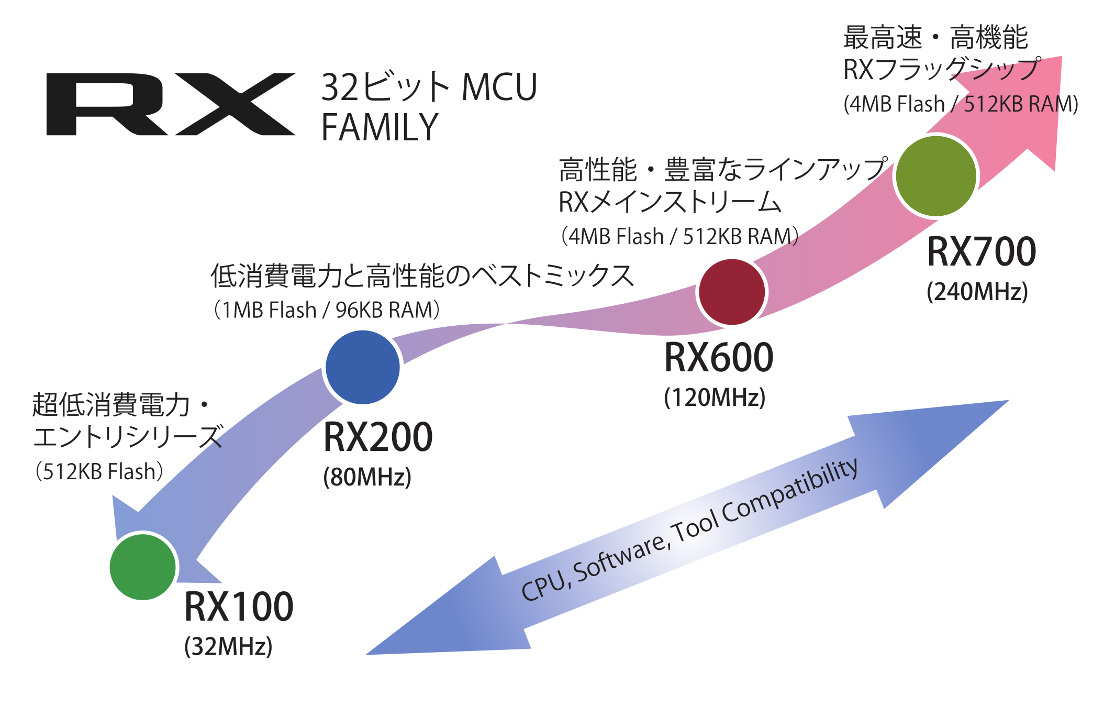
docs/RX_Serise.jpg
