hirakuni45/RX/docs/SD_CARD.jpg

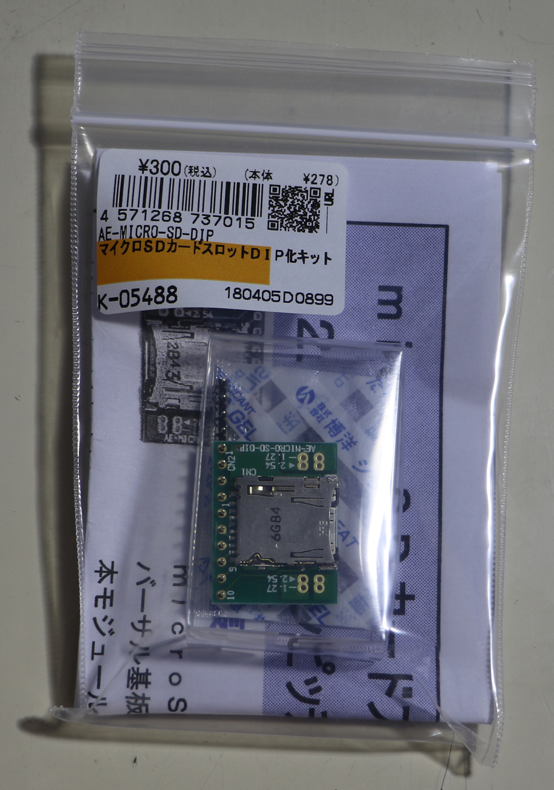
docs/SD_CARD.jpg
