hirakuni45/RX/docs/SD_MOUNT.jpg

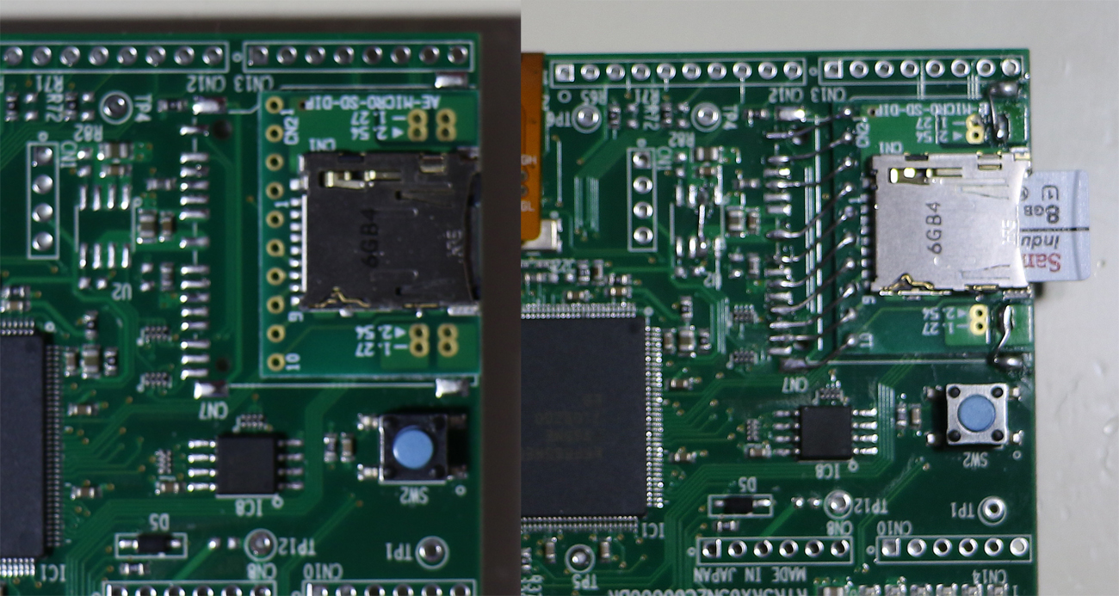
docs/SD_MOUNT.jpg
