hirakuni45/RX/docs/TinyGLsample.jpg

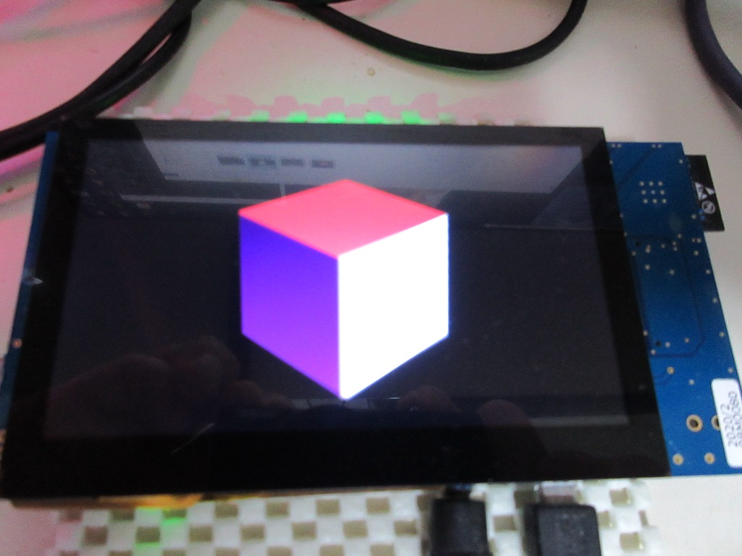
docs/TinyGLsample.jpg
