hirakuni45/RX/docs/Tools.jpg

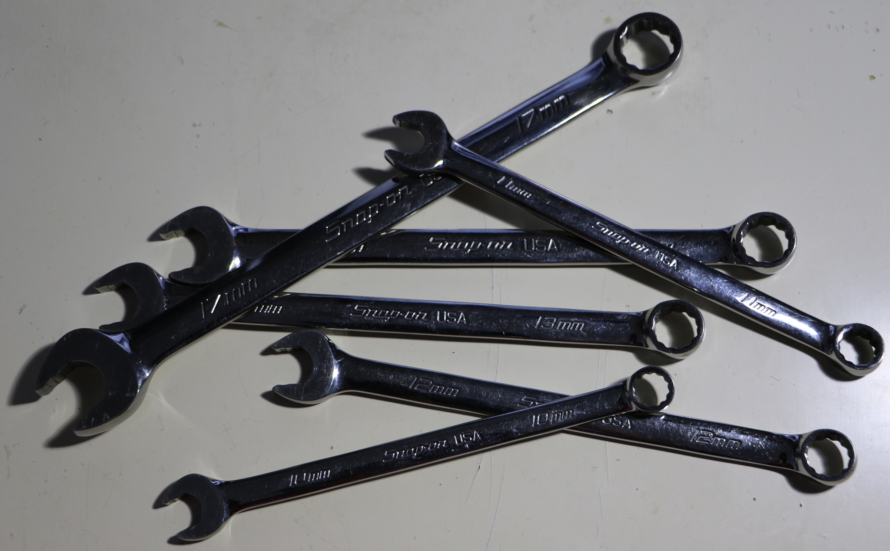
docs/Tools.jpg
