hirakuni45/RX/docs/VSCode_SS1.png

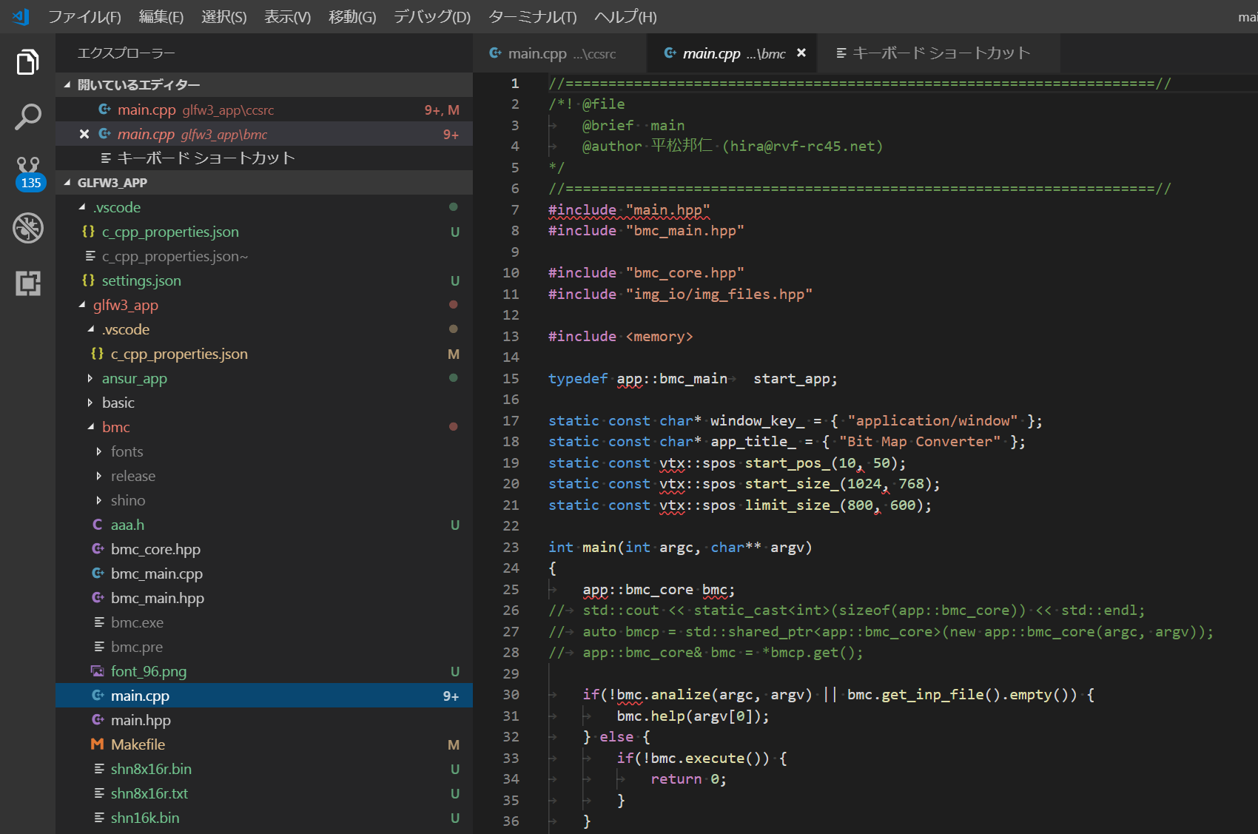
docs/VSCode_SS1.png
