hirakuni45/RX/RAYTRACER_sample/RX65N/Render0.jpg

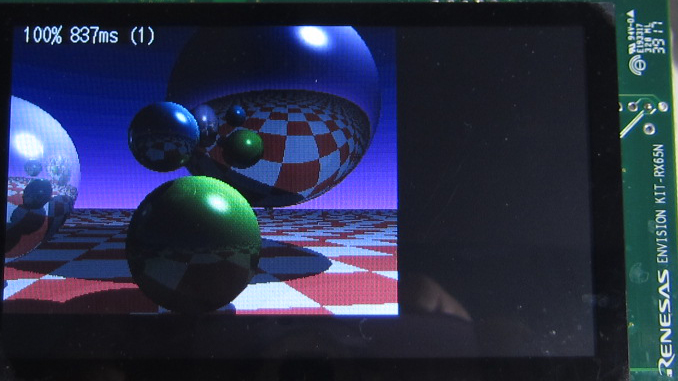
RAYTRACER_sample/RX65N/Render0.jpg
