hirakuni45/RX/RAYTRACER_sample/RX65N/Render1.jpg

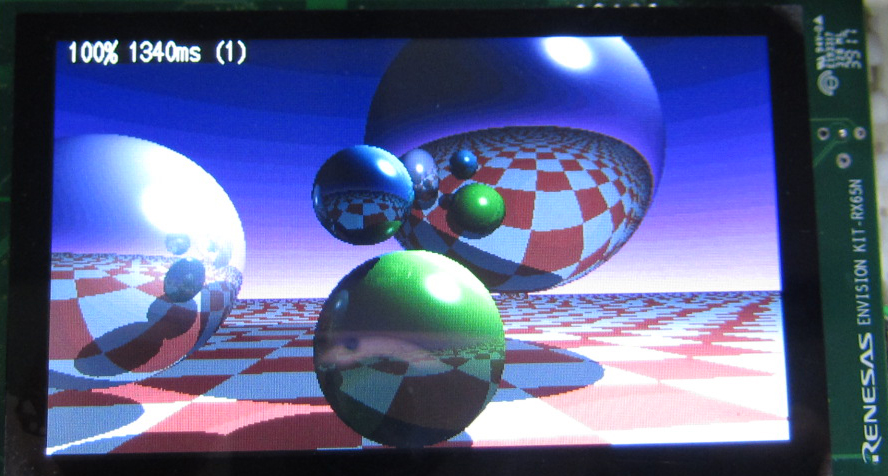
RAYTRACER_sample/RX65N/Render1.jpg
