hirakuni45/RX/rx63t_chager/docs/liion_18650.JPG

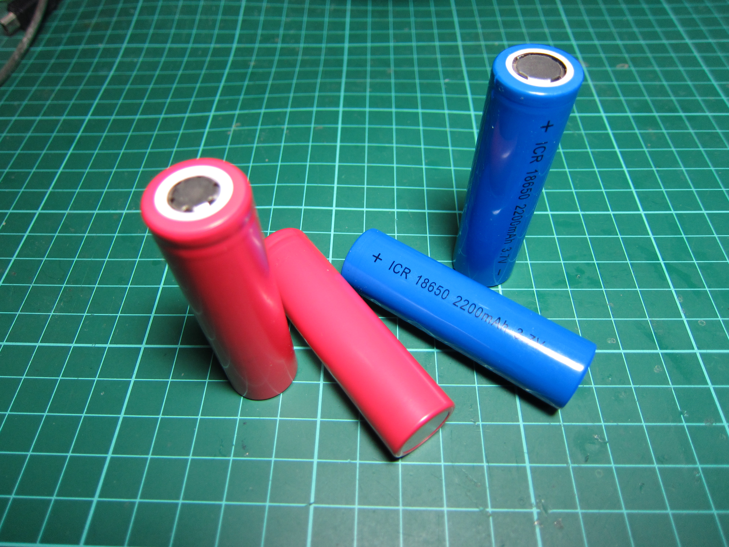
rx63t_chager/docs/liion_18650.JPG
