hirakuni45/RX/RX65x/RTK5_LOGGER/bitmap/font12_24.png

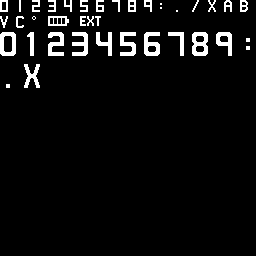
RX65x/RTK5_LOGGER/bitmap/font12_24.png
