hirakuni45/RX/rx64m_test/setting_ffftp.txt

「基本」
・ホスト名：　　SEEDA03のIPアドレス
・ユーザー名：　SEEDA03
・パスワード：　SEEDA03

「拡張」
・PASVモードを使う：　有効
・ポート番号：　21
・ネットワークの種類：　TCP/IPv4
・セキリティ：　使用しない

「文字コード」
・ホストの漢字コード：　UTF-8
・ファイル名の漢字コード：　UTF-8

「高度」
・LISTコマンドでファイル一覧を取得：　有効
・可能であればMLSDコマンドで一覧を取得：　有効

「暗号化」
・暗号なしで接続を許可：　有効
