hirakuni45/RX/docs/RenesasDebug.jpg

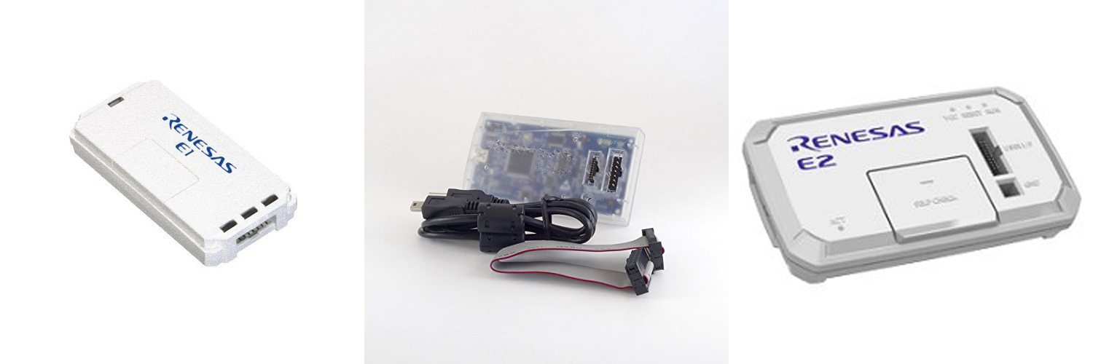
docs/RenesasDebug.jpg
