hirakuni45/RX/(threads)

Thread 1 (2019-07-27):

FreeRTOS の移植を開始する

hirakuni45, 2019-07-27:
やはり、ネットワークのような形態だと、マルチタスクでは無いシステムでは、複雑になり過ぎる。
また、ネットワークスタック等、再利用が難しい。
そこで、評判が良さそうな、FreeRTOS のポートを実験する。
既に、ＲＸマイコンでの動作実績があり、デモプロジェクトもあるのだが、純粋な gcc 環境用では無いので、これにトライする。

hirakuni45, 2019-08-06:
とりあえず、RXv2 コア版、FreeRTOS カーネルが動作する事を確認でき、簡単なサンプルも動作するようになったので、一旦クローズする。

Closed 2019-08-06.

Thread 2 (2019-10-19):

SDHI ドライバー、SDHC カードが初期化に失敗する

hirakuni45, 2019-10-19:
・2GB、1GB などの非 SDHC カードでは、初期化が完了して使える。
・4GB 以上のカード（SDHC 仕様のカード）では、ACMD41 が BUSY のままで、先に進めない。

hirakuni45, 2019-10-21:
ACMD41 コマンドパラメーター、B0～B23 の電圧範囲を指定しなかった為にエラーとなっていた。
電圧範囲、2.7V～3.6V（0xFF8000）を指定する事で、正常終了する事を確認。

Closed 2019-10-21.

Thread 6 (2019-11-11):

CP2102N を使ったUSBシリアルインターフェース基板の作成

hirakuni45, 2019-11-11:
rx_prog でシリアルから書き込む場合に使える、汎用的な USB シリアルコンバーターの基板設計など。
・KiCAD によるソリューション

hirakuni45, 2020-06-08:
PCBGOGO で基板を作成。

動作確認したので、クローズとする。

rx_prog の不具合も修正。
- CP2102N は、FTDI より応答が速く高速なので、コマンドを間隔を置かずに送ると、マイコン側でバッファがオーバーフローするようだった。
- そこで、erase-page、write-page コマンド発行毎に、遅延を設けた。
- erase-page における、応答待ち。（ページ毎に2ms）
- write-page における、応答待ち。（ページ毎に 5ms）

Closed 2020-06-08.

Thread 10 (2020-02-12):

USB 関係ドライバー整備

hirakuni45, 2020-02-12:
USB 関係のドライバーを整備する。

hirakuni45, 2020-02-13:
ルネサス r_usb ライブラリを使った USB ホストのサンプルを加えた。
RX65N（Envision Kit 向け）で、マスストレージデバイスクラスの実験コードを作成。

hirakuni45, 2020-02-25:
r_usb のライブラリーを、更新、以前の物は少し古く、新しいバージョンでは、GCC でコンパイルする事を考えて、変更が加えられている。
それに伴い、コンパイラー依存の切り替え（ヘッダー）を取り入れた。

hirakuni45, 2020-03-22:
HHID 関係の実験コード追加

Thread 23 (2020-04-05):

RX72N Envision Kit 対応

hirakuni45, 2020-04-05:
最近発表されたフラッグシップモデルに対応する。

hirakuni45, 2020-04-10:
FIRST_sample
SCI_sample
RAYTRACER_sample
SDCARD_sample
などのプロジェクト対応

hirakuni45, 2020-04-13:
RX72N SSIE デバイスドライバーを実装して、D2 オーディオ出力をサポート
NESEMU_sample
SIDE_sample
に対応

hirakuni45, 2020-05-02:
AUDIO_sample に対応

hirakuni45, 2020-05-05:
DSOS_sample に対応
DSOS プロジェクトが、未完成なので、コンパイルが通り、動作する事を確認したのみ。

hirakuni45, 2020-05-12:
インサーネットの動作と、FreeRTOS 下で、ネットスタック関係の検証などを開始。

Thread 145 (2021-03-08):

SCI I2C 割り込みドライバーの不具合修正

hirakuni45, 2021-03-08:
題名の通り、割り込みドライバーは、動作しない。

Thread 148 (2021-03-22):

RX72T サポート

hirakuni45, 2021-03-22:
RX72T デバイスのサポート
- FIRST_sample
- SCI_sample
- RAYTRACER_sample
- CALC_sample

hirakuni45, 2021-04-10:
- GPTW ポートマッピング（０～９チャネル）
- HRPWM（RX72T 専用クロック設定）

hirakuni45, 2021-05-02:
- まだ完璧とは言えないまでも、主要なデバイス関係の設定、登録は出来たので、とりあえずこのissueはクローズする。

Closed 2021-05-02.

Thread 185 (2021-11-26):

dac_stream クラスの自由度の改善

hirakuni45, 2021-11-26:
- dac_stream クラスは、ストリームタイミングを TPU で行うようになっています。
- TPU は、RX66T、RX72T など、ハードウェアーを持っていないデバイスがあります。
- TPU に依存しないように実装を行うように修正する必要があります。

hirakuni45, 2021-12-04:
dac_stream は、インターバルタイマーを TPU から MTU にする事で、各 CPU 対応となったので、この issues はクローズとする。

Closed 2021-12-04.

Thread 190 (2021-12-04):

power_mng クラスの不具合修正

hirakuni45, 2021-12-04:
- 各 CPU で、省電力設定が抜けているペリフェラルがある。

hirakuni45, 2021-12-04:
- 各 CPU で、ペリフェラル、省電力設定を精査して、抜けていた部分を補填、改修を行った。

Closed 2021-12-04.

Thread 200 (2021-12-14):

tinyusb に対応したドライバーの実装

hirakuni45, 2021-12-14:
- tinyusb には、koji Kitayama さんが実装した RX マイコン用 USB ドライバーがあります。
- この実装は、iodefine.h に依存した実装となっており、C++ フレームワークで扱うには不向きです。
- そこで、RX マイコン依存部分を C++ フレームワークのインスタンスを使って実装し直します。
- この改修により、より簡潔で正確な実装が可能となり、他の RX マイコンに対応が楽になります。
- iodefine.h は C 言語の規約に違反した実装であり、コンパイラに依存します。
- iodefine.h は、良く使われるようなキーワードを「#define」で定義してあり実用的ではありません。
- ありふれたキーワードは、階層構造の奥にあるキーワードと当たる事があり、その場合コンパイル出来ません。

Thread 230 (2022-07-16):

GUI widget の機能追加と改修

hirakuni45, 2022-07-16:
- スピンボックスを追加
- widget クラスに、標準的な GUI のサイズなどを定義

hirakuni45, 2022-07-16:
GUI は、機能が足りないので、今後、新しい widget や、機能を改修していく。

hirakuni45, 2022-07-17:
- spinbox クラスに、inc/dec の加速機能を追加。
- コールバック、プロトタイプの吟味。
- ドキュメント加筆、修正。

hirakuni45, 2022-07-26:
- ソフトキーボード（ASCII）の追加（まだ実装中）。
- ファイラー機能の実装。
- １０キーボードの実装。

hirakuni45, 2022-07-28:
- ASCII ソフトキーボード、必要な機能は実装したので、テストして改修が必要か検討する。
- １０キーの雛形を追加。

Thread 249 (2022-08-14):

DSO_sample に対する改修など

hirakuni45, 2022-08-14:
- DSO のソフトウェアは複雑でボリュームが大きい為、改修、バグ修正など、issue を登録
- 時間軸を拡大した場合に波形が階段状になるので、それをスムージングする
- FFT 解析機能の実装
- ハードウェアー（フロントエンド、プリアンプなどの基本回路、PCBのレイアウト、トラックなど）

Thread 265 (2022-10-12):

RX621/RX62N のサポート

hirakuni45, 2022-10-12:
- 今まで、レガシー扱いだった RX621/RX62N を格上げ、標準的にサポートを開始する。

hirakuni45, 2022-10-25:
- CQ 出版、FRK-RX62N ボードの定義を追加
- MTU2、MTU3 定義見直し
- mtu_io MTU2 対応
- port_map_mtu ポート定義の確認（RX24T, RX62x, RX64M, RX71M, RX66T, RX72T）

hirakuni45, 2022-11-20:
- RX62x 固有の機能実装は一応完了したので、この issue はクローズする。

Closed 2022-11-20.

Thread 268 (2022-10-24):

MTU2(RX62x)/MTU3(RX24T, RX600 group) 関係の見直し修正

hirakuni45, 2022-10-24:
- MTU2/MTU3x 関係の実装を見直す。
- MTU の機能は複雑で柔軟なので、中途半端な実装になっていた部分を全面的に見直す。

hirakuni45, 2022-10-24:
- MTU 関係ポートマップの見直し、修正実績

|RX62x|RX24T|RX64M/RX71M|RX65x|RX72N|RX66T/RX72T|
|:---:|:---:|:---:|:---:|:---:|:---:|
|O|-|-|-|-|O|

Closed 2025-09-22.

Thread 278 (2022-11-08):

RX63T のサポート

hirakuni45, 2022-11-08:
- 以前、レガシーとしてサポートを中断していたデバイスを正式にフレームワークに組み込む。

hirakuni45, 2022-11-20:
- RX63T 固有の機能実装は一応終了したので、この issue はクローズする。
- FIRST_sample、SCI_sample にのみプロジェクト（Makefile）を追加した。
- 他のプロジェクトで、問題が発生したら、その都度対応する。

Closed 2022-11-20.

Thread 336 (2023-09-12):

RX26T 関係リソースの追加

hirakuni45, 2023-09-12:
- RX26T をサポートする為、リソースの追加とパスの改修。
- とりあえず、「FIRST_sample」をコンパイル可能にする。

hirakuni45, 2023-09-22:
- FIRST_sample 動作
- SCI_sample 動作
- CALC_sample 動作
- RAYTRACER_sample 動作

hirakuni45, 2023-09-30:
- RSCI 関係追加。
- RSCI FIFOを使わないドライバークラスの追加。
- RX26T/port_map へ、RSCI8、RSCI9、RSCI11 のFIRSTオーダーを追加。

hirakuni45, 2023-10-15:
- PLL ベースクロックの不具合を修正。

hirakuni45, 2025-09-22:
- 一通り必要なファイルの追加と修正が終わったのでクローズする。

Thread 455 (2025-07-26):

Compilation fails with the new gcc-rx compiler version 14.2.0

sayyadumar, 2025-07-26:
The following is my setup:

```
sayyad@sayyad-tux:~/projects/rx/RX$ lsb_release -a
No LSB modules are available.
Distributor ID: Ubuntu
Description:    Ubuntu 24.04.2 LTS
Release:        24.04
Codename:       noble

sayyad@sayyad-tux:~/projects/rx/RX$ rx-elf-gcc --version
rx-elf-gcc (GCC_Build_9b12496d2) 14.2.0.202505-GNURX 20240801
Copyright (C) 2024 Free Software Foundation, Inc.
This is free software; see the source for copying conditions.  There is NO
warranty; not even for MERCHANTABILITY or FITNESS FOR A PARTICULAR PURPOSE.

```

When i try to compile with the _./all_project_build.sh -debug_ , I get the following errors,

```
sayyad@sayyad-tux:~/projects/rx/RX$ ./all_project_build.sh -debug
Start project (debug):  RX600/drw2d
Build project:  RX600/drw2d
Start project (debug):  ADC_sample RX140
Build project:  ADC_sample RX140
Start project (debug):  ADC_sample RX220
Build project:  ADC_sample RX220
Start project (debug):  ADC_sample RX231
Build project:  ADC_sample RX231
Start project (debug):  ADC_sample RX24T
Build project:  ADC_sample RX24T
Start project (debug):  ADC_sample RX26T
In file included from ../../common/renesas.hpp:449,
                 from ../../ADC_sample/main.cpp:10:
../../RX26T/system_io.hpp: In static member function ‘static void device::system_io<OSCT>::boost_master_clock()’:
**../../RX26T/system_io.hpp:188:25: error: there are no arguments to ‘__init_tfu’ that depend on a template parameter, so a declaration of ‘__init_tfu’ must be available [-fpermissive]
  188 |                         __init_tfu();**
      |                         ^~~~~~~~~~
```

This error can be fixed by defining the  missing function, which i did. But after fixing that i get further errors,

```
In file included from /home/sayyad/toolchains/gcc_14.2.0.202505_rx_elf/rx-elf/include/c++/14.2.0.202505-GNURX/bits/postypes.h:40,
                 from /home/sayyad/toolchains/gcc_14.2.0.202505_rx_elf/rx-elf/include/c++/14.2.0.202505-GNURX/bits/char_traits.h:42,
                 from /home/sayyad/toolchains/gcc_14.2.0.202505_rx_elf/rx-elf/include/c++/14.2.0.202505-GNURX/string:42,
                 from ../../common/format.hpp:60,
                 from ../../RX62x/flash_io.hpp:27,
                 from ../../common/renesas.hpp:450:
/home/sayyad/toolchains/gcc_14.2.0.202505_rx_elf/rx-elf/include/c++/14.2.0.202505-GNURX/cwchar:148:11: error: ‘fwide’ has not been declared in ‘::’
  148 |   using ::fwide;
      |           ^~~~~
/home/sayyad/toolchains/gcc_14.2.0.202505_rx_elf/rx-elf/include/c++/14.2.0.202505-GNURX/cwchar:149:11: error: ‘fwprintf’ has not been declared in ‘::’
  149 |   using ::fwprintf;
      |           ^~~~~~~~
/home/sayyad/toolchains/gcc_14.2.0.202505_rx_elf/rx-elf/include/c++/14.2.0.202505-GNURX/cwchar:150:11: error: ‘fwscanf’ has not been declared in ‘::’
  150 |   using ::fwscanf;
      |           ^~~~~~~
/home/sayyad/toolchains/gcc_14.2.0.202505_rx_elf/rx-elf/include/c++/14.2.0.202505-GNURX/cwchar:160:11: error: ‘swprintf’ has not been declared in ‘::’
  160 |   using ::swprintf;
      |           ^~~~~~~~
/home/sayyad/toolchains/gcc_14.2.0.202505_rx_elf/rx-elf/include/c++/14.2.0.202505-GNURX/cwchar:162:11: error: ‘swscanf’ has not been declared in ‘::’
  162 |   using ::swscanf;
      |           ^~~~~~~
/home/sayyad/toolchains/gcc_14.2.0.202505_rx_elf/rx-elf/include/c++/14.2.0.202505-GNURX/cwchar:164:11: error: ‘vfwprintf’ has not been declared in ‘::’
  164 |   using ::vfwprintf;
      |           ^~~~~~~~~
/home/sayyad/toolchains/gcc_14.2.0.202505_rx_elf/rx-elf/include/c++/14.2.0.202505-GNURX/cwchar:169:11: error: ‘vswprintf’ has not been declared in ‘::’
  169 |   using ::vswprintf;
```

This looks like a libc error, so i thought passing the _**-specs=nano.specs**_  would help, but this complains about missing _sbrk function.

Could you please take a look? If you want i can help too.
