hirakuni45/RX/rxprog/USB_CH9102F/PinAssignPlate.pdf

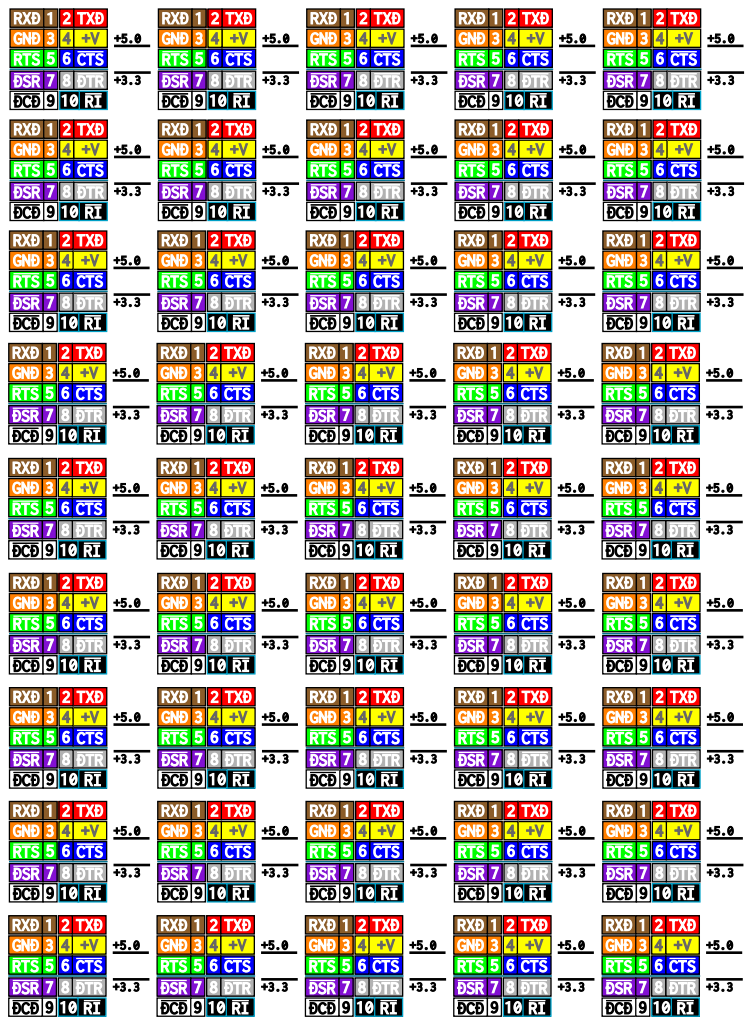
[picture p71: page 1]
RXD 1 2 TXD GND 3 4 +V RTS 5 6 CTS DSR 7 8 DTR DCD 9 10 RI
