hirakuni45/RX/OBD2_sample/canif/canif.pdf

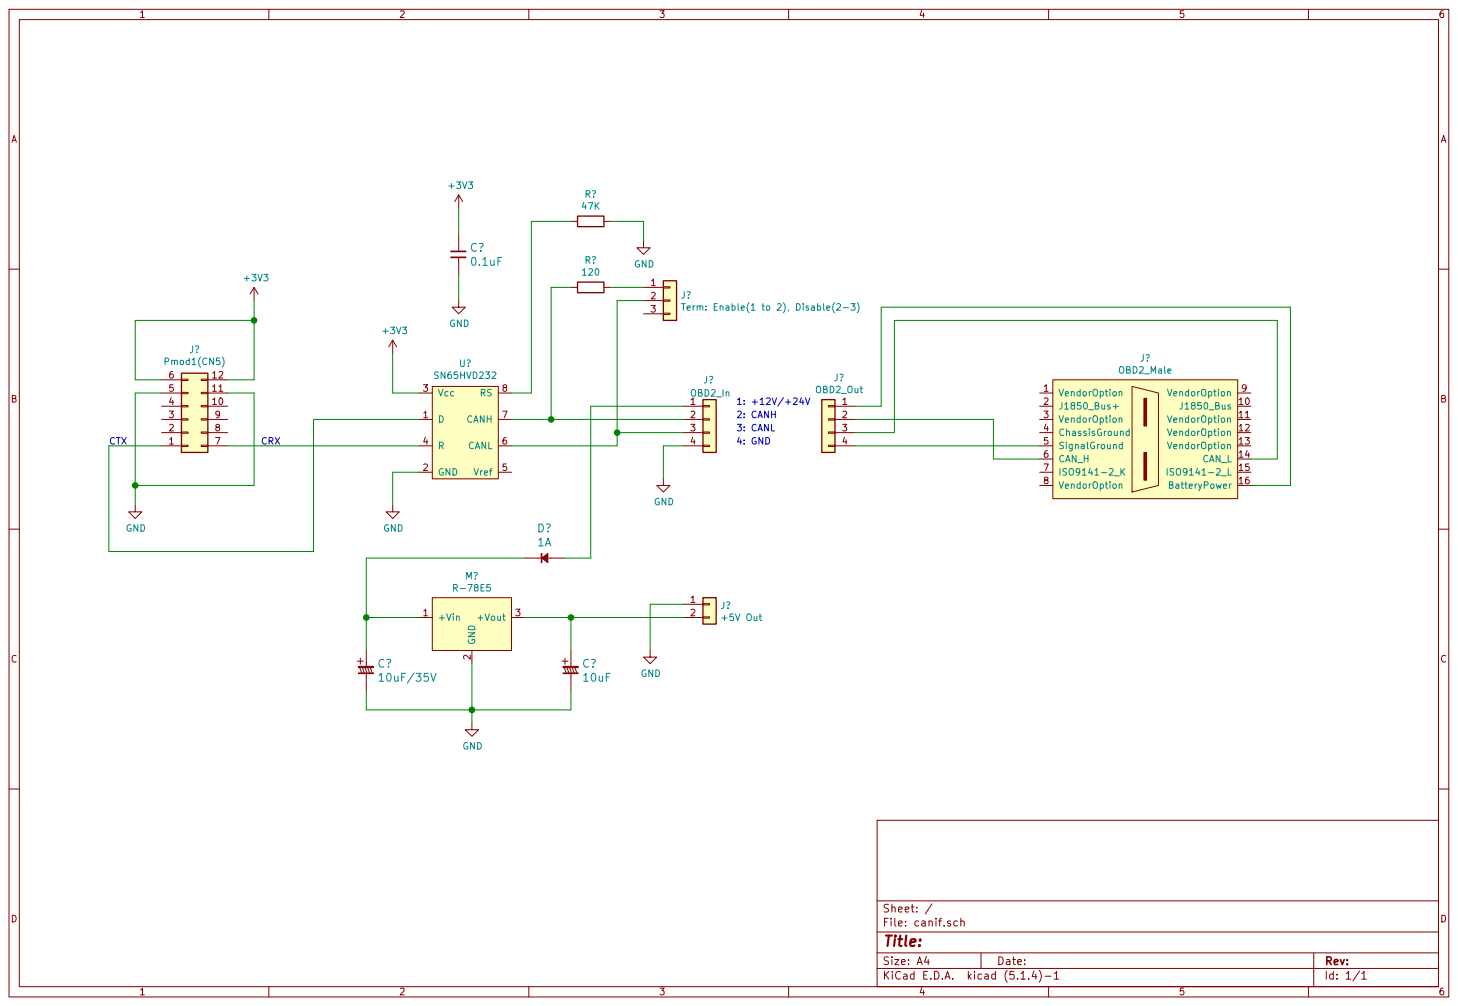
[picture p72: page 1]

Id: 1/1 Title: File: canif.sch Sheet: / GND
