hirakuni45/RX/DSOS_sample/DSO_FE/DSO_LTspice.asc

R1: res; 15K
R2: res; 5K
R3: res; 5K
R4: res; 5K
R5: res; 10K
R7: res; 5K
U1: ADTL082
U2: ADTL082
V1: voltage; 5
V2: voltage; 5
V3: voltage; 3.3V
V4: voltage; SINE(0 1 10000)
Named nets: 0, -5V, +5V, OUT, +3.3V, BFO
.tran 0.1
