hirakuni45/RX/(list of files, drawings)

Other design files:
STEP_TACHO/StepDriver/StepDriver.dsn
