hirakuni45/RX/rxprog/USB_CH9102F/USB_CH9102F.kicad_pcb

## KiCad design rxprog/USB_CH9102F/USB_CH9102F.kicad_pcb (2026-09-30)

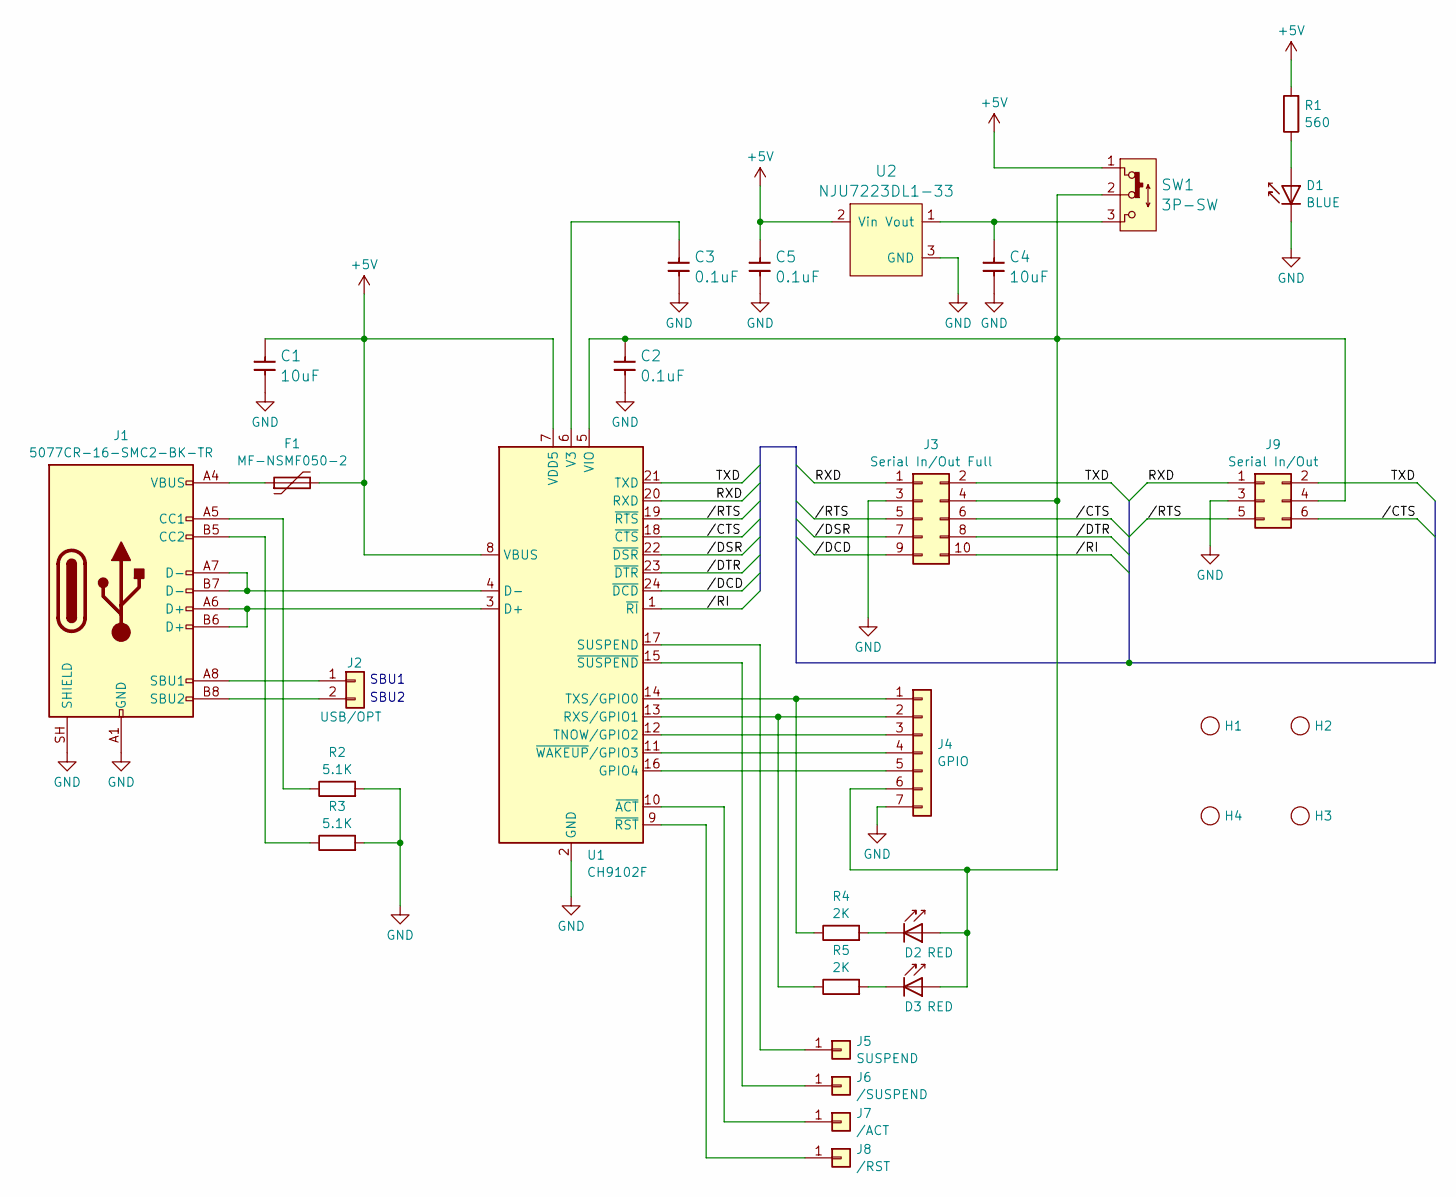
[picture p81: schematic USB_CH9102F.kicad_sch]

Parts:
C1, C4: 10uF; C_0603_1608Metric_Pad1.08x0.95mm_HandSolder
C2, C3, C5: 0.1uF; C_0603_1608Metric_Pad1.08x0.95mm_HandSolder
D1: BLUE; LED_0805_2012Metric_Pad1.15x1.40mm_HandSolder
D2, D3: RED; LED_0603_1608Metric_Pad1.05x0.95mm_HandSolder
F1: MF-NSMF050-2; Fuse_1206_3216Metric_Pad1.42x1.75mm_HandSolder
H1, H2, H3, H4: Hole3.2mm
J1: 5077CR-16-SMC2-BK-TR; USB_C_Receptacle_HCTL_HC-TYPE-C-16P-01A
J2: USB/OPT; PinHeader_1x02_P2.54mm_Vertical
J3: Serial In/Out Full; IDC-Header_2x05_P2.54mm_Vertical
J4: GPIO; PinHeader_1x07_P2.54mm_Vertical
J5: SUSPEND; PinHeader_1x01_P2.54mm_Vertical
J6: /SUSPEND; PinHeader_1x01_P2.54mm_Vertical
J7: /ACT; PinHeader_1x01_P2.54mm_Vertical
J8: /RST; PinHeader_1x01_P2.54mm_Vertical
J9: Serial In/Out; IDC-Header_2x03_P2.54mm_Vertical
R1: 560; R_0603_1608Metric_Pad0.98x0.95mm_HandSolder
R2, R3: 5.1K; R_0603_1608Metric_Pad0.98x0.95mm_HandSolder
R4, R5: 2K; R_0603_1608Metric_Pad0.98x0.95mm_HandSolder
SW1: 3P-SW; PinHeader_1x03_P2.54mm_Vertical
U1: CH9102F; QFN-24-1EP_4x4mm_P0.5mm_EP2.6x2.6mm
U2: NJU7223DL1-33; TO-252-2

Connections:
+5V: C1.2, C5.2, F1.2, R1.2, SW1.1, U1.7 (VDD5), U1.8 (VBUS), U2.2 (Vin)
/RXD: J3.1, J9.1, U1.20 (RXD)
/TXD: J3.2, J9.2, U1.21 (TXD)
//CTS: J3.6, J9.6, U1.18 (~CTS)
//DCD: J3.9, U1.24 (~DCD)
//DSR: J3.7, U1.22 (~DSR)
//DTR: J3.8, U1.23 (~DTR)
//RI: J3.10, U1.1 (~RI)
//RTS: J3.5, J9.5, U1.19 (~RTS)
GND: C1.1, C2.1, C3.1, C4.1, C5.1, D1.1 (K), J1.A1 (GND), J1.A12 (GND), J1.B1 (GND), J1.B12 (GND), J1.SH (SHIELD), J3.3, J4.7, J9.3, R2.2, R3.2, U1.2 (GND), U1.25 (GND), U2.3 (GND)
unnamed: D1.2 (A), R1.1
unnamed: C2.2, D2.2 (A), D3.2 (A), J3.4, J4.6, J9.4, SW1.2, U1.5 (VIO)
unnamed: D2.1 (K), R4.2
unnamed: D3.1 (K), R5.2
unnamed: F1.1, J1.A4 (VBUS), J1.A9 (VBUS), J1.B4 (VBUS), J1.B9 (VBUS)
unnamed: J1.A5 (CC1), R2.1
unnamed: J1.B5 (CC2), R3.1
unnamed: J1.A8 (SBU1), J2.1
unnamed: J1.B8 (SBU2), J2.2
unnamed: J4.1, R4.1, U1.14 (TXS/GPIO0)
unnamed: J4.2, R5.1, U1.13 (RXS/GPIO1)
unnamed: J4.3, U1.12 (TNOW/GPIO2)
unnamed: J4.4, U1.11 (~WAKEUP/GPIO3)
unnamed: J4.5, U1.16 (GPIO4)
unnamed: J5.1 (Pin_1_1), U1.17 (SUSPEND)
unnamed: J6.1 (Pin_1_1), U1.15 (~SUSPEND)
unnamed: J7.1 (Pin_1_1), U1.10 (~ACT)
unnamed: J8.1 (Pin_1_1), U1.9 (~RST)
unnamed: J1.A6 (D+), J1.B6 (D+), U1.3 (D+)
unnamed: J1.A7 (D-), J1.B7 (D-), U1.4 (D-)
unnamed: C3.2, U1.6 (V3)
unnamed: C4.2, SW1.3, U2.1 (Vout)

Notes on the sheet:
SBU2
SBU1

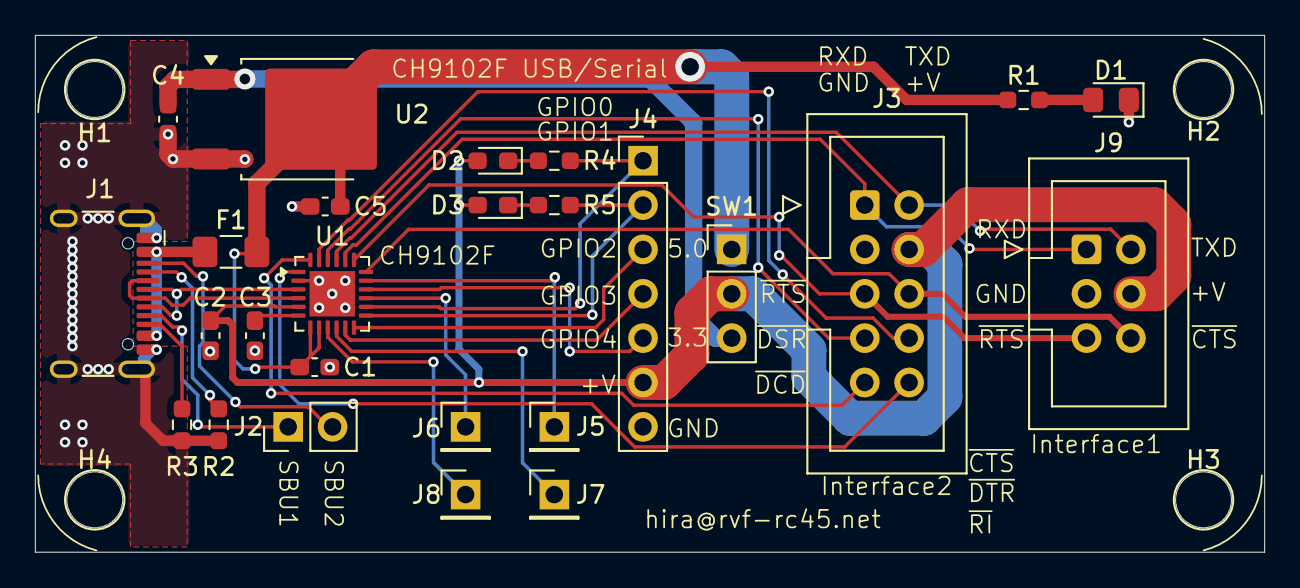
[picture p82: board USB_CH9102F.kicad_pcb from above]

Board: 2 copper layers, 70.4 x 29.6 mm, 30 parts (0 on the bottom side), 32 nets.
