hirakuni45/RX/STEP_TACHO/StepDriver/StepDriver.kicad_pcb

## KiCad design STEP_TACHO/StepDriver/StepDriver.kicad_pcb (2024-07-08)

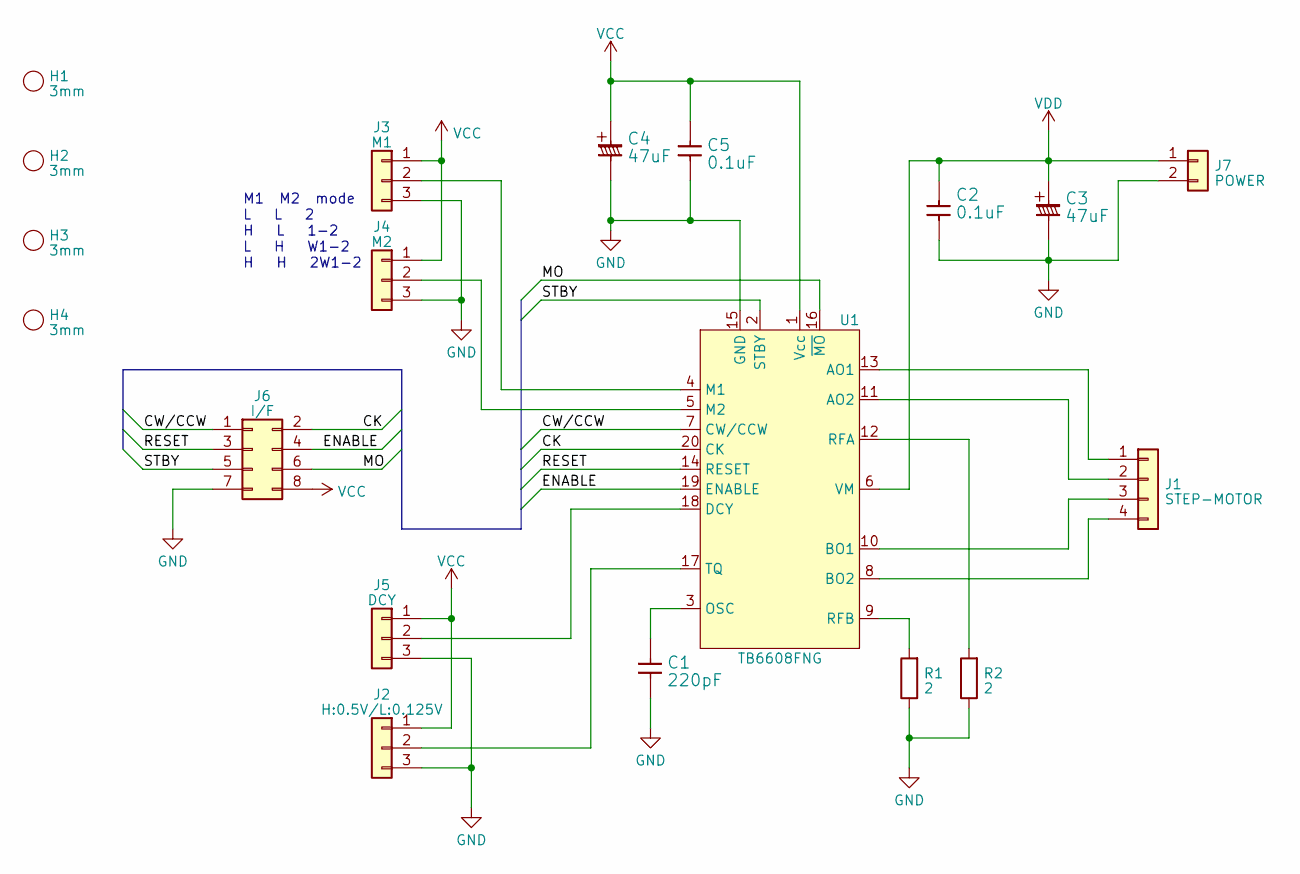
[picture p83: schematic StepDriver.kicad_sch]

Parts:
C1: 220pF; C_0603_1608Metric_Pad1.08x0.95mm_HandSolder
C2, C5: 0.1uF; C_0603_1608Metric_Pad1.08x0.95mm_HandSolder
C3, C4: 47uF; CP_Elec_6.3x5.4
H1, H2, H3, H4: 3mm; Hole3mm
J1: STEP-MOTOR; JST_EH_B4B-EH-A_1x04_P2.50mm_Vertical
J2: H:0.5V/L:0.125V; PinHeader_1x03_P2.54mm_Vertical
J3: M1; PinHeader_1x03_P2.54mm_Vertical
J4: M2; PinHeader_1x03_P2.54mm_Vertical
J5: DCY; PinHeader_1x03_P2.54mm_Vertical
J6: I/F; IDC-Header_2x04_P2.54mm_Vertical
J7: POWER; JST_EH_B2B-EH-A_1x02_P2.50mm_Vertical
R1, R2: 2; R_Box_L8.4mm_W2.5mm_P5.08mm
U1: TB6608FNG; SSOP-20_4.4x6.5mm_P0.65mm

Connections:
/CK: J6.2, U1.20 (CK)
/CW/CCW: J6.1, U1.7 (CW/CCW)
/ENABLE: J6.4, U1.19 (ENABLE)
/MO: J6.6, U1.16 (~MO)
/RESET: J6.3, U1.14 (RESET)
/STBY: J6.5, U1.2 (STBY)
GND: C1.1, C2.1, C3.2, C4.2, C5.1, J2.3, J3.3, J4.3, J5.3, J6.7, J7.2, R1.1, R2.1, U1.15 (GND)
unnamed: J1.1, U1.13 (AO1)
unnamed: J1.2, U1.11 (AO2)
unnamed: J1.3, U1.10 (BO1)
unnamed: J1.4, U1.8 (BO2)
unnamed: J2.2, U1.17 (TQ)
unnamed: J3.2, U1.4 (M1)
unnamed: J4.2, U1.5 (M2)
unnamed: J5.2, U1.18 (DCY)
unnamed: C1.2, U1.3 (OSC)
unnamed: R2.2, U1.12 (RFA)
unnamed: R1.2, U1.9 (RFB)
VCC: C4.1, C5.2, J2.1, J3.1, J4.1, J5.1, J6.8, U1.1 (Vcc)
VDD: C2.2, C3.1, J7.1, U1.6 (VM)

Notes on the sheet:
M1 M2 mode L L 2 H L 1-2 L H W1-2 H H 2W1-2

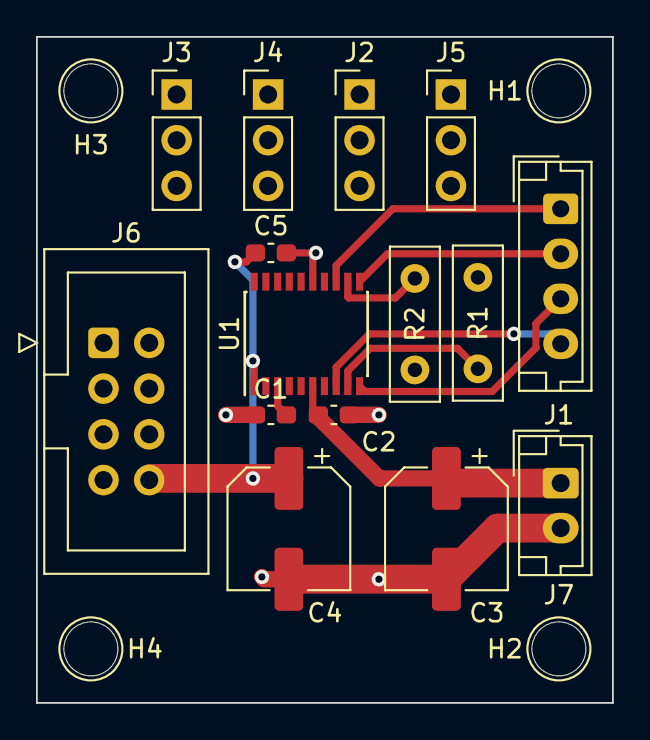
[picture p84: board StepDriver.kicad_pcb from above]

Board: 2 copper layers, 32.0 x 37.0 mm, 19 parts (0 on the bottom side), 20 nets.
