hirakuni45/RX/RX140/RX140_board/RX140_board.kicad_pcb

## KiCad design RX140/RX140_board/RX140_board.kicad_pcb (2024-07-08)

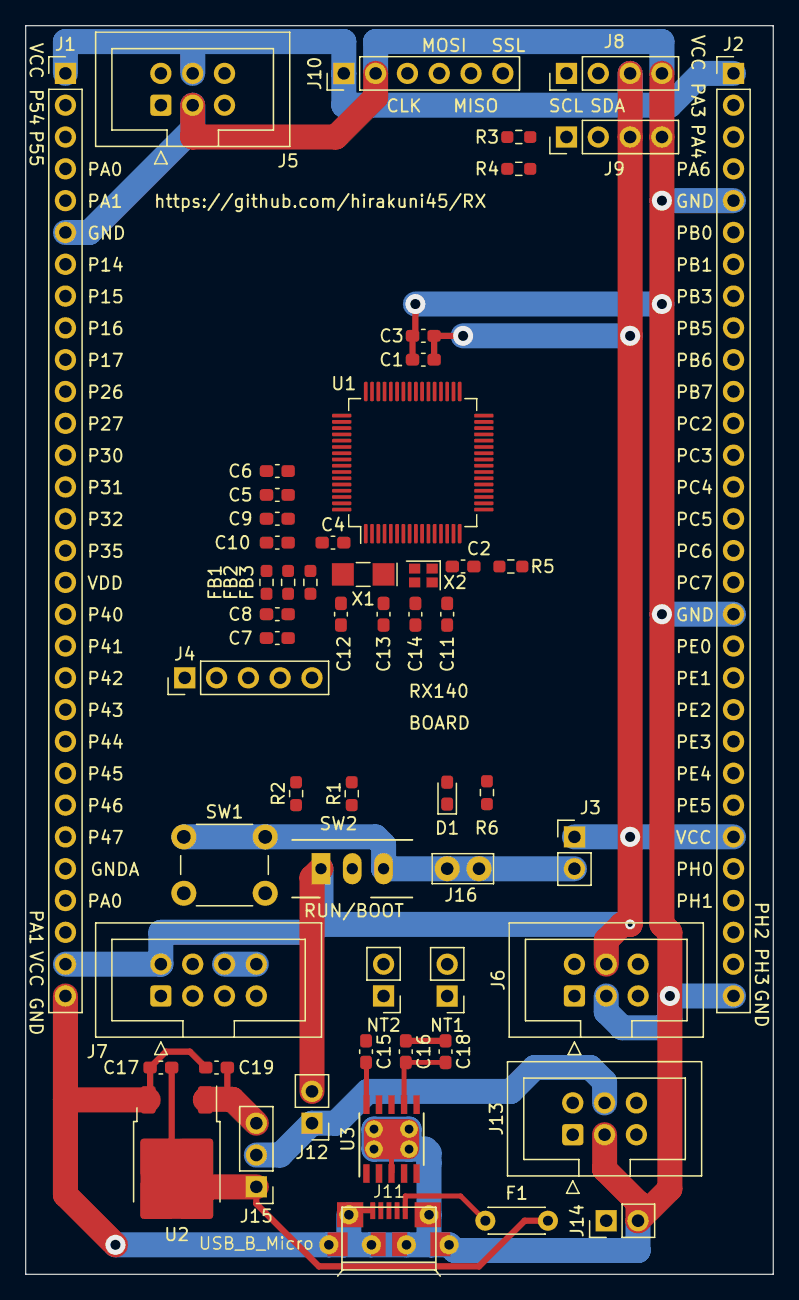
[picture p85: board RX140_board.kicad_pcb from above]

Board: 2 copper layers, 59.7 x 99.7 mm, 55 parts (0 on the bottom side), 75 nets.

Parts:
C1, C2, C6, C7, C10, C15, C17, C18: 0.1uF; C_0603_1608Metric_Pad1.08x0.95mm_HandSolder
C3, C8, C16: 10uF; C_0603_1608Metric_Pad1.08x0.95mm_HandSolder
C4: 4.7uF; C_0603_1608Metric_Pad1.08x0.95mm_HandSolder
C5, C9: 0.01uF; C_0603_1608Metric_Pad1.08x0.95mm_HandSolder
C11, C14: 5pF; C_0603_1608Metric_Pad1.08x0.95mm_HandSolder
C12, C13: 10pF; C_0603_1608Metric_Pad1.08x0.95mm_HandSolder
C19: 1uF; C_0603_1608Metric_Pad1.08x0.95mm_HandSolder
D1: LED; LED_0603_1608Metric_Pad1.05x0.95mm_HandSolder
F1: MF-R050; C_Disc_D4.3mm_W1.9mm_P5.00mm
FB1, FB2, FB3: FB; R_0603_1608Metric_Pad0.98x0.95mm_HandSolder
J1: PIN-A; PinHeader_1x30_P2.54mm_Vertical
J2: PIN-B; PinHeader_1x30_P2.54mm_Vertical
J3: POWER; PinHeader_1x02_P2.54mm_Vertical
J4: D/A; PinHeader_1x05_P2.54mm_Vertical
J5: SCI12; IDC-Header_2x03_P2.54mm_Vertical
J6: SCI1; IDC-Header_2x03_P2.54mm_Vertical
J7: EMU; IDC-Header_2x04_P2.54mm_Vertical
J8: I2C-A; PinHeader_1x04_P2.54mm_Vertical
J9: I2C-B; PinHeader_1x04_P2.54mm_Vertical
J10: RSPI; PinHeader_1x06_P2.54mm_Vertical
J11: USB_B_Micro; USB_MICRO_B-HIROSE-ZX62R-B-5P
J12: 3.3V_CON; PinHeader_1x02_P2.54mm_Vertical
J13: Serial; IDC-Header_2x03_P2.54mm_Vertical
J14: /DTR; PinHeader_1x02_P2.54mm_Vertical
J15: 5/3.3; PinHeader_1x03_P2.54mm_Vertical
J16: GND; TestPoint_Bridge_Pitch2.54mm_Drill1.0mm
NT1: TIE_RXD; PinHeader_1x02_P2.54mm_Vertical
NT2: TIE_TXD; PinHeader_1x02_P2.54mm_Vertical
R1, R2, R5: 10K; R_0603_1608Metric_Pad0.98x0.95mm_HandSolder
R3, R4: 2K; R_0603_1608Metric_Pad0.98x0.95mm_HandSolder
R6: 1.5K; R_0603_1608Metric_Pad0.98x0.95mm_HandSolder
SW1: RES; SW_PUSH_6mm
SW2: RUN/BOOT; SW_3P_SPDT_Angled
U1: RX140; LQFP-64_10x10mm_P0.5mm
U2: NJU7223DL1-33; TO-252-2
U3: CH340K; SSOP-10_3.9x4.9mm_P1.00mm
X1: 32.768KHz; Crystal_SMD_EuroQuartz_EQ161-2Pin_3.2x1.5mm_HandSoldering
X2: 12MHz; Crystal_SMD_2016-4Pin_2.0x1.6mm

Connections:
/CH340 Serial USB/RXD: J13.1, NT2.1, U3.9 (RXD)
/CH340 Serial USB/TXD: J13.2, NT1.1, U3.8 (TXD)
DA0: J1.27, J4.2, U1.1 (P03)
DA1: J1.28, J4.3, U1.63 (P05)
GND: C1.1, C2.1, C3.2, C4.1, C7.1, C8.1, C11.1, C12.1, C13.1, C14.1, C15.1, C16.1, C17.1, C18.1, C19.1, FB1.1, J1.6, J1.30, J2.5, J2.18, J2.30, J3.2, J5.3, J6.3, J7.6, J7.8, J8.4, J9.4, J10.2, J11.5 (GND), J11.6 (Shield), J13.3, J14.2, J16.1, SW1.1, SW2.3, U1.8 (VSS), U1.40 (VSS), U2.3 (GND), U3.0 (GND), U3.3 (GND), X2.2, X2.4
GNDA: C5.2, C6.2, C9.1, C10.1, FB1.2, J1.26, J4.4, J4.5, U1.59 (VREFL0/PJ7), U1.64 (AVSS0)
LED: J1.8, R6.1, U1.19 (P15)
MISOA: J2.17, J10.5, U1.27 (PC7)
MOSIA: J2.16, J10.4, U1.28 (PC6)
NMI: J1.16, R5.1, U1.11 (P35)
unnamed: D1.1 (K), R6.2
unnamed: J7.1, R2.1, SW1.2, U1.6 (~RES)
unnamed: J7.3, R1.2, U1.3 (PG7/MD)
unnamed: J11.3 (D+), U3.1 (UD+)
unnamed: J11.2 (D-), U3.2 (UD-)
unnamed: F1.1, J11.1 (VBUS)
unnamed: J12.1, J13.4, J15.2
unnamed: J13.5, U3.6 (RTS#)
unnamed: J13.6, U3.5 (CTS#)
unnamed: J14.1, U3.4 (DTR#)
unnamed: C16.2, C17.2, C18.2, F1.2, J15.1, U2.2 (Vin), U3.7 (VCC)
unnamed: C19.2, J15.3, U2.1 (Vout)
unnamed: R1.1, SW2.2
unnamed: C11.2, U1.9 (P36/EXTAL), X2.1
unnamed: C14.2, U1.7 (P37/XTAL), X2.3
unnamed: C13.2, U1.5 (PH6/XCOUT), X1.1
unnamed: C12.2, U1.4 (PH7/XCIN), X1.2
unnamed: C4.2, U1.2 (VCL)
unnamed: C9.2, C10.2, FB3.1, U1.61 (VREFH0/PJ6)
unnamed: C15.2, U3.10 (V3)
P27: J1.12, U1.15 (P27)
P32: J1.15, U1.12 (P32)
P40: J1.18, U1.60 (P40)
P41: J1.19, U1.58 (P41)
P42: J1.20, U1.57 (P42)
P43: J1.21, U1.56 (P43)
P44: J1.22, U1.55 (P44)
P45: J1.23, U1.54 (P45)
P46: J1.24, U1.53 (P46)
P47: J1.25, U1.52 (P47)
P54: J1.2, U1.26 (P54)
P55: J1.3, U1.25 (P55)
PA0: J1.4, U1.45 (PA0)
PA1: J1.5, U1.44 (PA1)
PA3: J2.2, U1.43 (PA3)
PA4: J2.3, U1.42 (PA4)
PA6: J2.4, U1.41 (PA6)
PB0: J2.6, U1.39 (PB0)
PB1: J2.7, U1.37 (PB1)
PB3: J2.8, U1.36 (PB3)
PB5: J2.9, U1.35 (PB5)
PB6: J2.10, U1.34 (PB6/PC0)
PB7: J2.11, U1.33 (PB7/PC1)
PC2: J2.12, U1.32 (PC2)
PC3: J2.13, U1.31 (PC3)
PE0: J2.19, J5.6, U1.51 (PE0)
PE4: J2.23, U1.47 (PE4)
PE5: J2.24, U1.46 (PE5)
PH0: J2.26, U1.24 (PH0)
PH1: J2.27, U1.23 (PH1)
PH2: J2.28, U1.22 (PH2)
PH3: J2.29, U1.21 (PH3)
RSPCKA: J2.15, J10.3, U1.29 (PC5)
RXD1: J1.13, J6.2, J7.5, NT1.2, U1.14 (P30)
RXD12: J2.21, J5.2, U1.49 (PE2)
SCL0: J1.9, J8.1, J9.1, R3.2, U1.18 (P16)
SDA0: J1.10, J8.2, J9.2, R4.2, U1.17
SSLA0: J2.14, J10.6, U1.30 (PC4)
TXD1: J1.11, J6.1, J7.7, NT2.2, U1.16 (P26)
TXD12: J2.20, J5.1, U1.50 (PE1)
VCC: C1.2, C2.2, C3.1, C7.2, C8.2, D1.2 (A), FB2.2, FB3.2, J1.1, J1.29, J2.1, J2.25, J3.1, J5.4, J6.4, J7.2, J8.3, J9.3, J10.1, J12.2, R2.2, R3.1, R4.1, R5.2, SW2.1, U1.10 (VCC), U1.38 (VCC)
VDD: C5.1, C6.1, FB2.1, J1.17, J4.1, U1.62 (AVCC0)
/CTS1: J1.7, J6.5, U1.20 (P14)
/CTS12: J2.22, J5.5, U1.48 (PE3)
/RTS1: J1.14, J6.6, U1.13 (P31)
