hirakuni45/RX/RX72T/RX72T_100_PGA_USB/rx72t_100_pga_usb.kicad_pcb

## KiCad design RX72T/RX72T_100_PGA_USB/rx72t_100_pga_usb.kicad_pcb (2024-02-21)

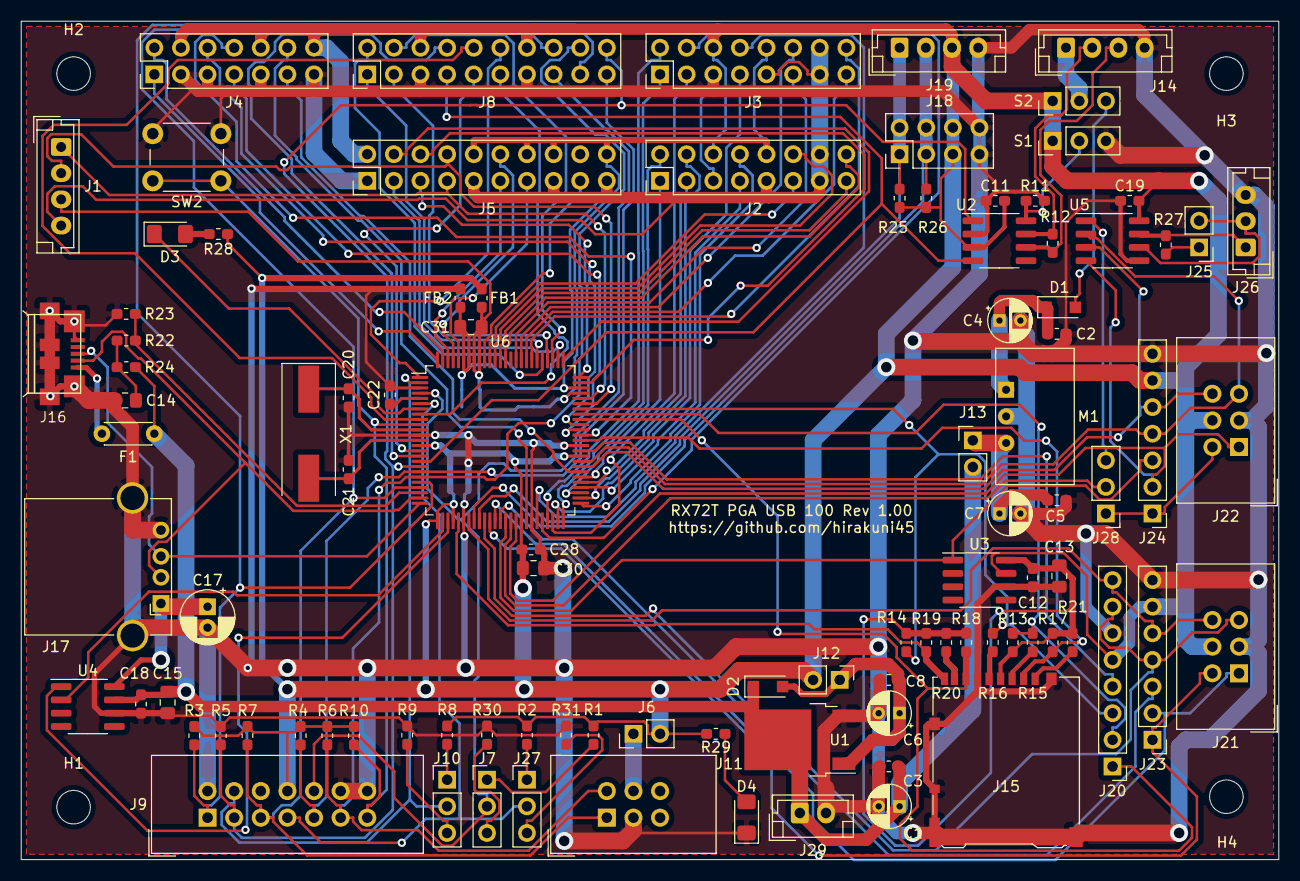
[picture p86: board rx72t_100_pga_usb.kicad_pcb from above]

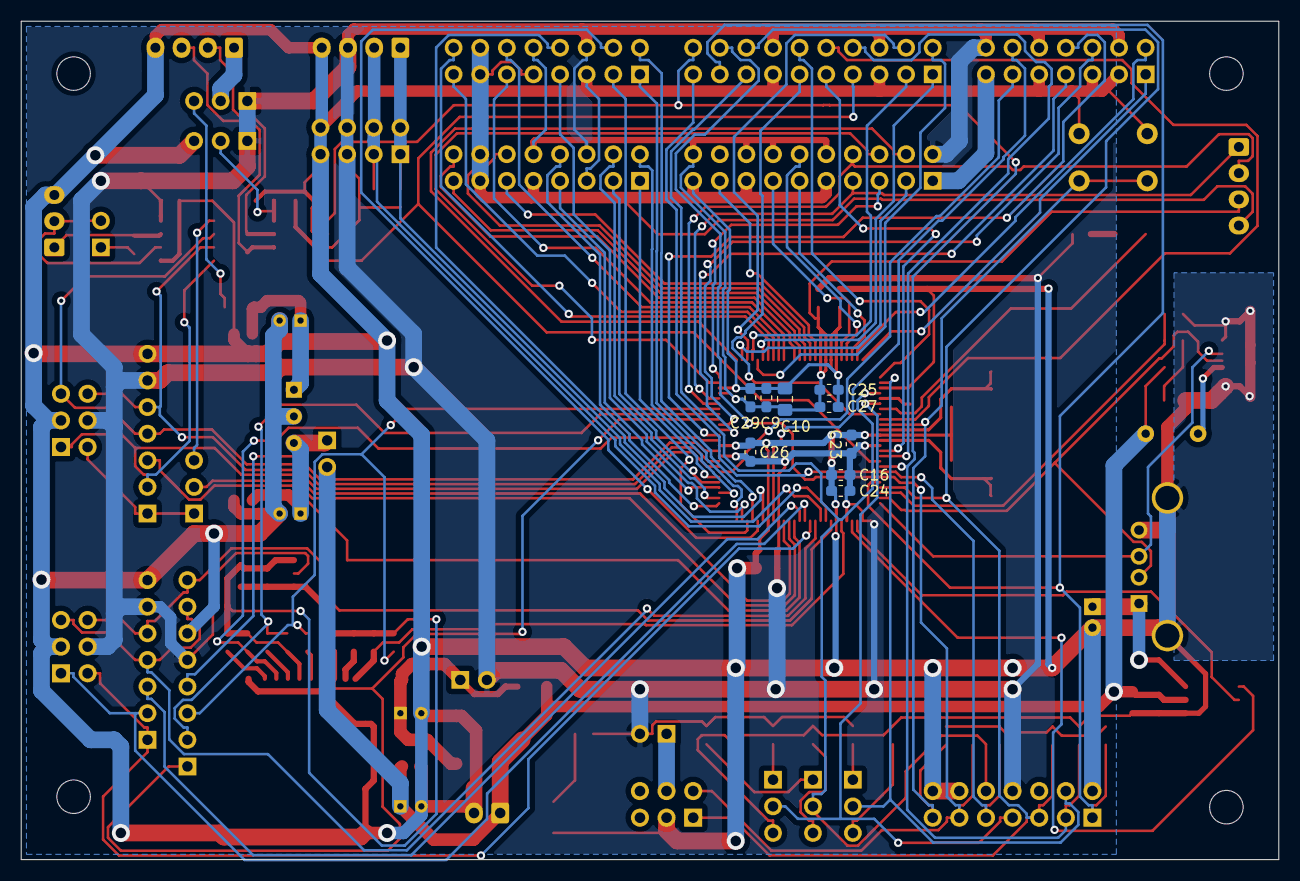
[picture p87: board rx72t_100_pga_usb.kicad_pcb from below]

Board: 2 copper layers, 120.0 x 80.0 mm, 113 parts (9 on the bottom side), 118 nets.

Parts:
C1, C6: 47uF; CP_Radial_D4.0mm_P2.00mm
C2, C5, C11, C12, C16, C18, C19: 0.1uF; C_0603_1608Metric_Pad1.05x0.95mm_HandSolder
C3, C8, C9, C22: 0.47uF; C_0603_1608Metric_Pad1.05x0.95mm_HandSolder
C4, C7: 10uF; CP_Radial_D4.0mm_P2.00mm
C10, C13: 10uF; C_0805_2012Metric_Pad1.15x1.40mm_HandSolder
C14, C15: 1uF; C_0805_2012Metric_Pad1.15x1.40mm_HandSolder
C17: 100uF; CP_Radial_D5.0mm_P2.00mm
C20, C21: 8pF; C_0603_1608Metric_Pad1.05x0.95mm_HandSolder
C23, C24, C25, C26, C27, C28, C29: 104; C_0603_1608Metric_Pad1.05x0.95mm_HandSolder
C30, C31: 47uF; C_0805_2012Metric_Pad1.15x1.40mm_HandSolder
D1, D2: 1A; D_SOD-123F
D3: RED; LED_1206_3216Metric_Pad1.42x1.75mm_HandSolder
D4: BLUE; LED_1206_3216Metric_Pad1.42x1.75mm_HandSolder
F1: 0.5A; C_Disc_D4.3mm_W1.9mm_P5.00mm
FB1, FB2: FB; R_0603_1608Metric_Pad1.05x0.95mm_HandSolder
H1, H2, H3, H4: Hole; MountingHole_3.2mm_M3
J1: DA_OUT; JST_EH_B4B-EH-A_1x04_P2.50mm_Vertical
J2: GPTW_012; PinHeader_2x08_P2.54mm_Vertical
J3: GPTW_456; PinHeader_2x08_P2.54mm_Vertical
J4: EXT_DG0; PinHeader_2x07_P2.54mm_Vertical
J5: EXT_AN; PinHeader_2x10_P2.54mm_Vertical
J6: SCI1_POW; PinHeader_1x02_P2.54mm_Vertical
J7: UB; PinHeader_1x03_P2.54mm_Vertical
J8: EXT_DG1; PinHeader_2x10_P2.54mm_Vertical
J9: E1_E2_Lite; IDC-Header_2x07_P2.54mm_Vertical
J10: EMU_MODE; PinHeader_1x03_P2.54mm_Vertical
J11: SCI1; IDC-Header_2x03_P2.54mm_Vertical
J12: 5V_POW; PinHeader_1x02_P2.54mm_Vertical
J13: 12V_POW; PinHeader_1x02_P2.54mm_Vertical
J14: CAN; JST_EH_B4B-EH-A_1x04_P2.50mm_Vertical
J15: MSD_Hirose_DM3AT; microSD_HC_Hirose_DM3AT-SF-PEJM5
J16: SLAVE; HIROSE_MicroB_SMD
J17: MASTER; USB-4AF103BS
J18: I2C_B; PinHeader_2x04_P2.54mm_Vertical
J19: I2C_A; JST_EH_B4B-EH-A_1x04_P2.50mm_Vertical
J20: RSPI; PinHeader_1x08_P2.54mm_Vertical
J21: SCI8; IDC-Header_2x03_P2.54mm_Vertical
J22: SCI11; IDC-Header_2x03_P2.54mm_Vertical
J23: SPI8; PinHeader_1x07_P2.54mm_Vertical
J24: SPI11; PinHeader_1x07_P2.54mm_Vertical
J25: RS-485 TERM; PinHeader_1x02_P2.54mm_Vertical
J26: RS-485; JST_EH_B3B-EH-A_1x03_P2.50mm_Vertical
J27: MD; PinHeader_1x03_P2.54mm_Vertical
J28: SER/RS-485; PinHeader_1x03_P2.54mm_Vertical
J29: 5VIN; JST_EH_B2B-EH-A_1x02_P2.50mm_Vertical
M1: BP5293-5; BP5293
R1, R2, R3, R4, R5, R6, R7, R9, R10, R30, R31: 4.7K; R_0603_1608Metric_Pad1.05x0.95mm_HandSolder
R8, R25, R26: 1K; R_0603_1608Metric_Pad1.05x0.95mm_HandSolder
R11: 47K; R_0603_1608Metric_Pad1.05x0.95mm_HandSolder
R12, R27: 120; R_0603_1608Metric_Pad1.05x0.95mm_HandSolder
R13, R14, R17, R18, R19, R20, R21: 22K; R_0603_1608Metric_Pad1.05x0.95mm_HandSolder
R15, R16: 22; R_0603_1608Metric_Pad1.05x0.95mm_HandSolder
R22: 15K; R_0603_1608Metric_Pad1.05x0.95mm_HandSolder
R23: 30K; R_0603_1608Metric_Pad1.05x0.95mm_HandSolder
R24: 100; R_0603_1608Metric_Pad1.05x0.95mm_HandSolder
R28: 1.5K; R_0603_1608Metric_Pad1.05x0.95mm_HandSolder
R29: 330; R_0603_1608Metric_Pad1.05x0.95mm_HandSolder
S1: T-POW; PinHeader_1x03_P2.54mm_Vertical
S2: CAN-POW; PinHeader_1x03_P2.54mm_Vertical
SW2: RESET; SW_PUSH_6mm_H4.3mm
U1: NJU7223DL1-33; TO-252-2
U2: SN65HVD230; SOP-8_3.76x4.96mm_P1.27mm
U3, U4: MIC2026-1BM; SOP-8_3.76x4.96mm_P1.27mm
U5: MAX3485; SOP-8_3.76x4.96mm_P1.27mm
U6: RX72T_100_PGA_USB; LQFP-100_14x14mm_P0.5mm
X1: 16MHz; Crystal_SMD_HC49-SD

Connections:
+3.3VA: C9.2, C10.2, C25.2, C27.2, C29.2, C31.1, FB1.2, J1.3, J2.10, J3.10, J5.10, J5.14, J5.16, J5.20, U6.72, U6.92, U6.93
+3V3: C11.2, C16.2, C19.2, C23.2, C24.2, C26.2, C28.2, C30.1, FB1.1, J2.6, J3.6, J4.4, J4.10, J4.14, J5.2, J6.2, J8.6, J8.14, J9.8, J12.2, J18.5, J18.6, J19.3, J20.5, J21.4, J22.4, J23.6, J24.6, R1.2, R2.1, R3.1, R4.1, R6.2, R7.1, R8.2, R10.1, R25.1, R26.1, R28.1, R29.1, S1.1, S2.1, U2.3, U3.7, U5.8, U6.14, U6.26, U6.29, U6.42, U6.60
+5V: C1.1, C3.2, C15.2, C18.2, D2.1, F1.1, J13.2, J29.1, R24.2, U1.2, U4.7
+12V: D1.2, S2.3
/I2C_SPI_SCI/MISO: J15.7, J20.1, R18.2, U6.67
/I2C_SPI_SCI/MOSI: J20.2, R13.2, R15.1, U6.68
/I2C_SPI_SCI/P32: J22.5, J24.4, U5.2, U6.59
/I2C_SPI_SCI/P33: J22.6, J24.5, U5.3, U6.58
/I2C_SPI_SCI/PB0: J20.7, J21.5, J23.4, U6.35
/I2C_SPI_SCI/PB3: J20.8, J21.6, J23.5, U6.32
/JTAG_IF/EMLE: J9.4, J10.2, U6.2
/JTAG_IF/MD_FINED: J9.7, J27.2, U6.6
/JTAG_IF/RESn: J9.13, R10.2, SW2.1, U6.10
/P00: J7.2, J8.15, J9.10, U6.4
/P10: J4.1, U6.100
/P11: J4.2, U6.99
/P23: J4.6, U6.66
/P24: J4.7, U6.65
/P25: J4.8, U6.64
/P40: J2.11, U6.90
/P41: J2.12, U6.89
/P42: J2.15, U6.88
/P43: J2.16, U6.87
/P44: J3.11, U6.85
/P45: J3.12, U6.84
/P46: J3.15, U6.83
/P47: J3.16, U6.82
/P52: J8.1, U6.81
/P53: J8.2, U6.80
/P54: J8.3, U6.79
/P55: J8.4, U6.78
/P60: J5.3, U6.77
/P61: J5.4, U6.76
/P62: J5.5, U6.75
/P63: J5.6, U6.74
/P64: J1.1, J5.7, U6.71
/P65: J1.2, J5.8, U6.70
/P70: J4.11, U6.57
/P71: J2.1, U6.56
/P72: J2.3, U6.55
/P73: J2.7, U6.54
/P74: J2.2, U6.53
/P75: J2.4, U6.52
/P76: J2.8, U6.51
/P80: J5.11, U6.98
/P81: J5.12, U6.97
/P82: J5.13, U6.96
/P90: J3.1, U6.50
/P91: J3.3, U6.48
/P92: J3.7, U6.49
/P93: J3.2, U6.47
/P94: J3.4, U6.46
/P95: J3.8, U6.45
/P96: J4.12, U6.43
/PD3: J8.16, J9.5, J11.1, R7.2, U6.22
/PD4: J8.17, J9.1, R3.2, U6.21
/PD5: J8.18, J9.11, J11.2, R6.1, U6.20
/PD6: J8.19, J9.9, R4.2, U6.19
/PD7: J8.20, J9.3, R5.2, U2.1, U6.18
/PE0: J8.7, U2.4, U6.17
/PE1: J8.8, U6.16
/PE2: J8.9, U6.15
/PE3: J8.10, U6.9
/PE4: J8.11, U6.8
/PE5: J8.12, U6.1
/PH0: J5.17, U6.91
/RX72T/P20_RSPCK: J20.3, R14.2, R16.1, U6.69
/RX72T/P30_SSL0: J15.2, R17.2, U6.63
/RX72T/P31_SSL1: J20.4, U6.61
/RX72T/PA0_TXD11: J22.1, J24.2, U5.4, U6.41
/RX72T/PA1_RXD11: J28.2, U6.40
/RX72T/PA2_SCK11: J24.3, U3.1, U6.39
/RX72T/PA3_SCK8: J23.3, U6.38
/RX72T/PA4_TXD8: J21.1, J23.2, U6.37
/RX72T/PA5_RXD8: J21.2, J23.1, U6.36
/RX72T/PB1_SCL: J18.1, J18.2, J19.1, R25.2, U6.34
/RX72T/PB2_SDA: J18.3, J18.4, J19.2, R26.2, U6.33
/RX72T/PB5_USB_VBUSEN: U4.1, U6.28
/RX72T/PB6_USB_OVRCUR: U4.2, U6.27
/RX72T/PD2_USB_VBUS: R22.2, R23.1, U6.23
/RX72T/USB_DM: J16.2, J17.2, U6.24
/RX72T/USB_DP: J16.3, J17.3, U6.25
/SDC_IF/INS: J15.9, R19.2, U6.30
GND: C1.2, C2.1, C3.1, C4.2, C5.1, C6.2, C7.2, C8.1, C11.1, C12.1, C13.1, C14.1, C15.1, C16.1, C17.2, C18.1, C19.1, C20.1, C21.1, C22.1, C23.1, C24.1, C26.1, C28.1, C30.2, D4.1, FB2.1, J2.5, J3.5, J4.3, J4.5, J4.9, J4.13, J5.1, J8.5, J8.13, J9.2, J9.12, J9.14, J11.3, J14.4, J15.6, J15.10, J15.11, J16.5, J16.6, J17.4, J17.5, J18.7, J18.8, J19.4, J20.6, J21.3, J22.3, J23.7, J24.7, J26.3, J29.2, M1.2, R5.1, R9.2, R11.2, R23.2, R30.1, R31.1, S1.3, SW2.2, U1.3, U2.2, U3.6, U4.6, U5.5, U6.3, U6.12, U6.31, U6.44, U6.62
GNDA: C9.1, C10.1, C25.1, C27.1, C29.1, C31.2, FB2.2, J1.4, J2.9, J2.13, J2.14, J3.9, J3.13, J3.14, J5.9, J5.15, J5.19, U6.73, U6.94, U6.95
unnamed: C2.2, C4.1, D1.1, M1.1
unnamed: C5.2, C7.1, J13.1, M1.3
unnamed: C6.1, C8.2, D2.2, J12.1, U1.1
unnamed: C12.2, C13.2, J15.4, R13.1, R14.1, R17.1, R18.1, R19.1, R20.1, R21.1, U3.8
unnamed: C14.2, R22.1, R24.1
unnamed: C17.1, J17.1, U4.8
unnamed: C20.2, U6.11, X1.1
unnamed: C21.2, U6.13, X1.2
unnamed: C22.2, U6.5
unnamed: D3.1, U6.7
unnamed: D3.2, R28.2
unnamed: D4.2, R29.2
unnamed: F1.2, J16.1
unnamed: J7.1, R1.1
unnamed: J7.3, R30.2
unnamed: J10.1, R8.1
unnamed: J10.3, R9.1
unnamed: J6.1, J11.4
unnamed: J14.1, S2.2
unnamed: J14.2, R12.1, U2.7
unnamed: J14.3, R12.2, U2.6
unnamed: J15.1, R21.2
unnamed: J15.3, R15.2
unnamed: J15.5, R16.2
unnamed: J15.8, R20.2
unnamed: J22.2, J24.1, J28.1
unnamed: J25.1, R27.1
unnamed: J25.2, J26.2, U5.6
unnamed: J26.1, R27.2, U5.7
unnamed: J27.1, R2.2
unnamed: J27.3, R31.2
unnamed: J28.3, U5.1
unnamed: R11.1, S1.2, U2.8
