hirakuni45/RX/rxprog/USB_CP2102N/USB_CP2102N.kicad_pcb

## KiCad design rxprog/USB_CP2102N/USB_CP2102N.kicad_pcb (2019-11-24)

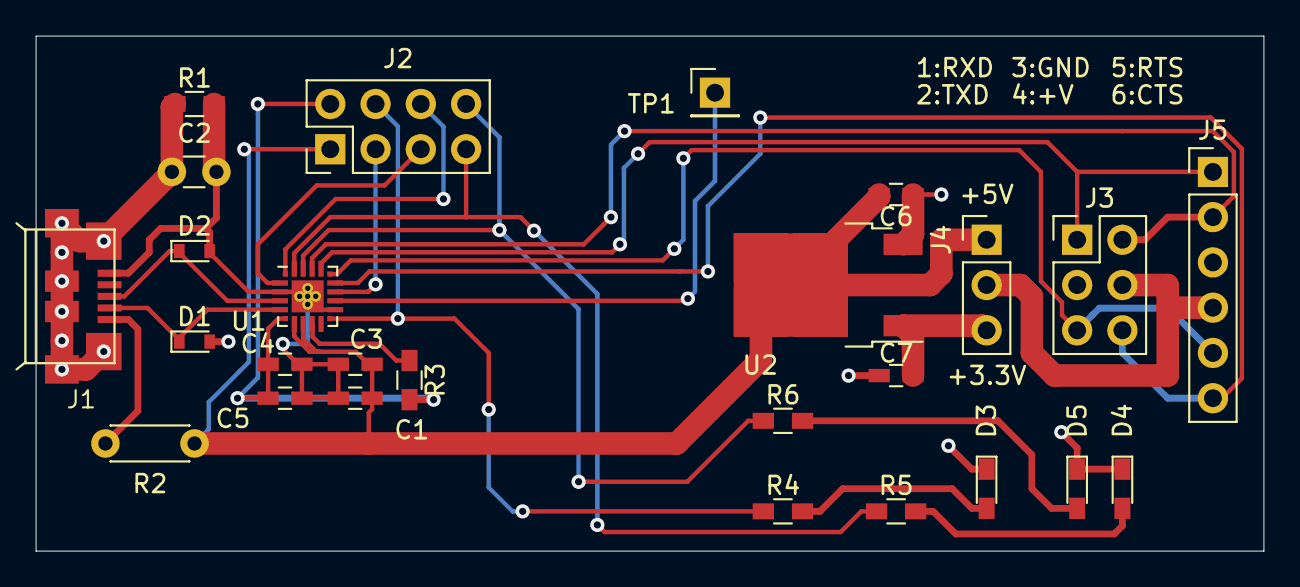
[picture p88: board USB_CP2102N.kicad_pcb from above]

Board: 2 copper layers, 68.9 x 28.9 mm, 26 parts (0 on the bottom side), 24 nets.

Parts:
C1, C4, C6, C7: 0.1uF; C_0603_HandSoldering
C2: 100pF; C_Disc_D3.0mm_W1.6mm_P2.50mm
C3, C5: 4.7uF; C_0603_HandSoldering
D1, D2: 5.7V; D_0603
D3: Green; LED_0603_HandSoldering
D4: Red; LED_0603_HandSoldering
D5: Orange; LED_0603_HandSoldering
J1: USB_B_Micro; USB_MICRO_B-HIROSE-ZX62R-B-5P
J2: 01x08; Pin_Header_Straight_2x04_Pitch2.54mm
J3: 02x03; Pin_Header_Straight_2x03_Pitch2.54mm
J4: 01x03; Pin_Header_Straight_1x03_Pitch2.54mm
J5: 01x06; Pin_Header_Straight_1x06_Pitch2.54mm
R1: 1M; R_0603_HandSoldering
R2: 0.05; C_Disc_D4.3mm_W1.9mm_P5.00mm
R3: 1K; R_0603_HandSoldering
R4, R5, R6: 470; R_0603_HandSoldering
TP1: WAKEUP; Pin_Header_Straight_1x01_Pitch2.54mm
U1: CP2102N; SiliconLabs_QFN-20-1EP_3x3mm_Pitch0.5mm_ThermalVias
U2: NJU7223DL1-33; TO-252-2

Connections:
+3V3: C7.2, J4.3, U2.1
+5V: C1.2, C3.2, C6.2, J2.1, J4.1, R2.1, U1.7, U1.8, U2.2
CTS: J3.6, J5.6, U1.15
GND: C1.1, C2.2, C3.1, C4.1, C5.1, C6.1, C7.1, D1.2, D2.2, D3.1, D4.1, D5.1, J1.5, J3.3, J5.3, R1.2, U1.3, U1.12, U1.21, U2.3
unnamed: C2.1, J1.6, R1.1
unnamed: D1.1, J1.2, U1.5
unnamed: D2.1, J1.3, U1.4
unnamed: D3.2, R4.2
unnamed: D4.2, R5.2
unnamed: D5.2, R6.2
unnamed: J1.1, R2.2
unnamed: J2.3, U1.14
unnamed: J2.4, R4.1, U1.11
unnamed: J2.5, U1.2
unnamed: J2.6, U1.1
unnamed: J3.4, J4.2, J5.4
unnamed: R3.1, U1.9
unnamed: TP1.1, U1.13
RTS: J3.5, J5.5, U1.16
RXD: J3.1, J5.1, U1.17
RXT: J2.8, R6.1, U1.19
TXD: J3.2, J5.2, U1.18
TXT: J2.7, R5.1, U1.20
VDD: C4.2, C5.2, J2.2, R3.2, U1.6
