hirakuni45/RX/RX24T/base_board/rx24t_core.kicad_pcb

## KiCad design RX24T/base_board/rx24t_core.kicad_pcb (2017-01-30)

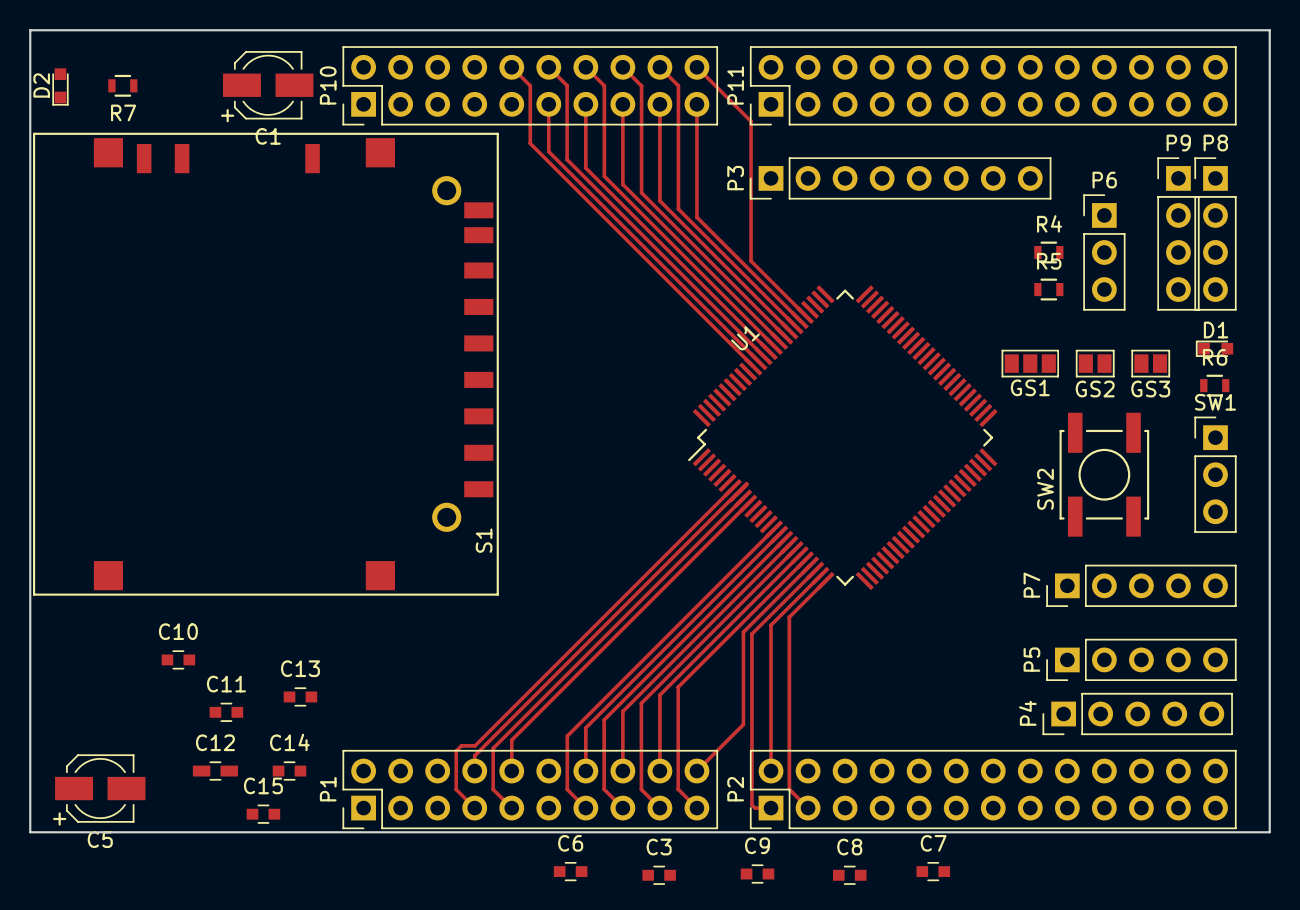
[picture p89: board rx24t_core.kicad_pcb from above]

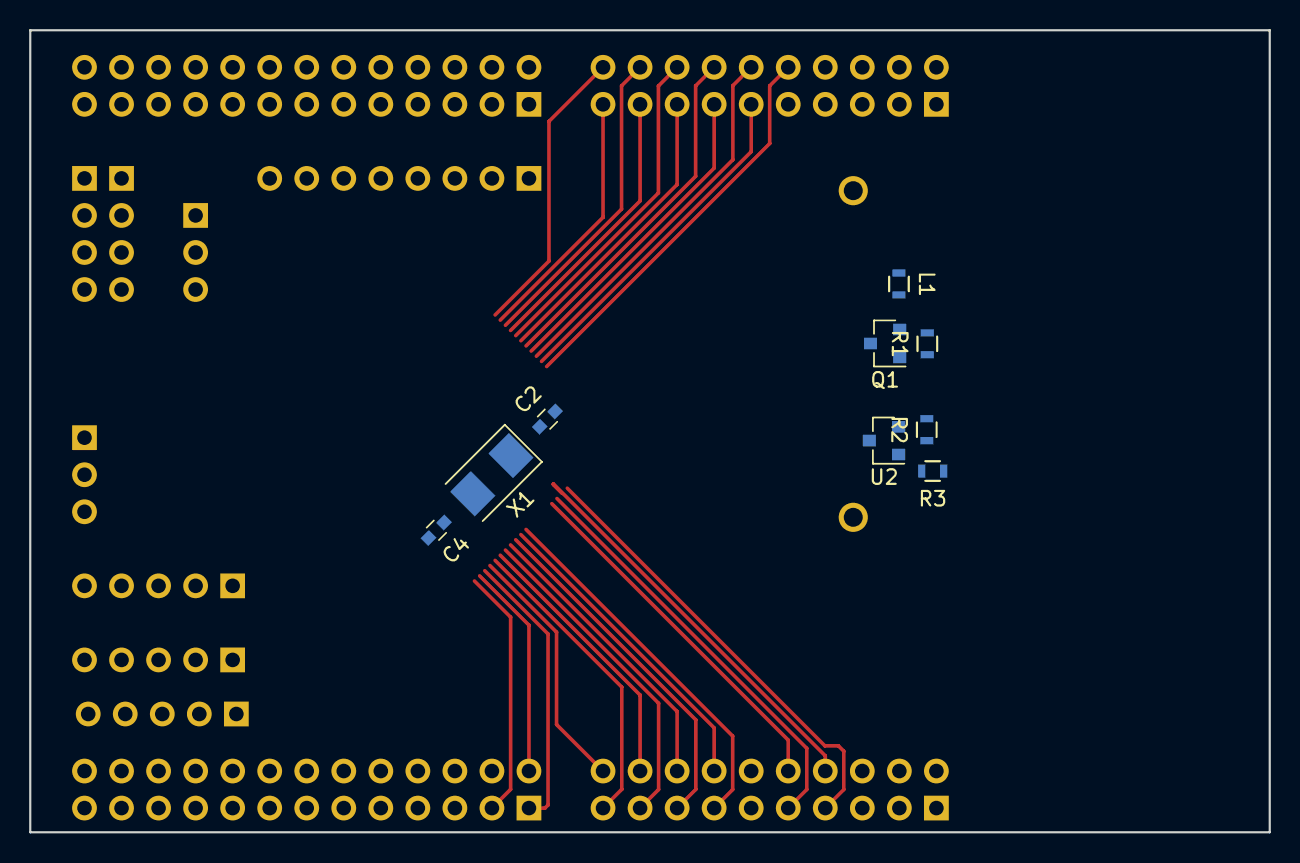
[picture p90: board rx24t_core.kicad_pcb from below]

Board: 2 copper layers, 85.0 x 55.0 mm, 46 parts (9 on the bottom side), 94 nets.

Parts:
C1: 22uF; CP_Elec_4x5.8
C2, C4: 10pF; C_0603
C3: 4.7uF; C_0603
C5: 47uF; CP_Elec_4x5.8
C6, C7, C8, C9, C10, C11, C13, C14, C15: 0.1uF; C_0603
C12: 1uF; C_0603_HandSoldering
D1, D2: LED; LED_0603
GS1: GS3
GS2, GS3: GS2
L1: FB; R_0603
P1, P10: 2X10; Pin_Header_Straight_2x10_Pitch2.54mm
P2, P11: 2X13; Pin_Header_Straight_2x13_Pitch2.54mm
P3: SPI-LCD; Pin_Header_Straight_1x08_Pitch2.54mm
P4: SCI1; Pin_Header_Straight_1x05_Pitch2.54mm
P5: SCI5; Pin_Header_Straight_1x05_Pitch2.54mm
P6: APOWER; Pin_Header_Straight_1x03_Pitch2.54mm
P7: SCI6; Pin_Header_Straight_1x05_Pitch2.54mm
P8, P9: I2C; Pin_Header_Straight_1x04_Pitch2.54mm
Q1: DMG3415U; SOT-23(DMG3415U)
R1: 47K; R_0603
R2, R3: 10K; R_0603
R4, R5, R6, R7: 1K; R_0603
S1: SD-CARD; DM1AA-SF-PEJ
SW1: 3P-SW; Pin_Header_Straight_1x03_Pitch2.54mm
SW2: RESET; SW_SPST_EVPBF
U1: RX24T; LQFP-100_14x14mm_Pitch0.5mm
U2: TCM809R; SOT-23
X1: 10MHz; Crystal_SMD_5032-2pin_5.0x3.2mm

Connections:
+3.3VADC: C11.1, C13.1, C14.1, GS3.1, P6.1, P10.5, U1.71, U1.92, U1.93
+3V3: C5.2, C6.1, C7.1, C8.1, C9.1, C10.1, C15.1, GS3.2, L1.2, P1.5, P1.12, P2.8, P3.1, P3.7, P4.4, P5.4, P7.4, P8.2, P9.2, P11.8, R2.1, R3.1, R4.1, R5.1, R6.1, U1.14, U1.29, U1.42, U1.60, U2.3
//RES: P1.10, P3.3, R2.2, SW2.1, U1.10, U2.2
/MD: P1.6, R3.2, SW1.2, U1.6
/P00: D1.1, P1.4, U1.4
/P01: P1.7, U1.7
/P02: P1.2, U1.2
/P10: P10.2, U1.100
/P11: P10.1, U1.99
/P20: P11.11, U1.68
/P21: P11.12, U1.67
/P22: P11.13, S1.7, U1.66
/P23: P3.6, P11.14, S1.2, U1.65
/P24: P3.5, P11.15, S1.5, U1.64
/P30: P11.16, U1.63
/P31: P11.17, U1.61
/P32: P11.18, U1.59
/P33: P11.19, U1.58
/P40: P10.9, U1.91
/P41: P10.10, U1.90
/P42: P10.11, U1.89
/P43: P10.12, U1.88
/P44: P10.13, U1.87
/P45: P10.14, U1.86
/P46: P10.15, U1.85
/P47: P10.16, U1.84
/P50: P10.17, U1.83
/P51: P10.18, U1.82
/P52: P10.19, U1.81
/P53: P10.20, U1.80
/P54: P11.1, U1.79
/P55: P11.2, U1.78
/P60: P11.3, S1.12, U1.77
/P61: P3.2, P11.4, U1.76
/P62: P3.4, P11.5, U1.75
/P63: P11.6, S1.10, U1.74
/P64: GS1.1, P11.9, U1.70
/P65: P11.10, S1.1, U1.69
/P70: P11.20, U1.57
/P71: P11.21, U1.56
/P72: P11.22, U1.55
/P73: P11.23, U1.54
/P74: P11.24, U1.53
/P75: P11.25, U1.52
/P76: P11.26, U1.51
/P80: P10.4, U1.98
/P81: P10.3, U1.97
/P82: P10.6, U1.96
/P90: P2.26, U1.50
/P91: P2.25, U1.49
/P92: P2.24, U1.48
/P93: P2.23, U1.47
/P94: P2.22, U1.46
/P95: P2.21, U1.45
/P96: P2.20, U1.43
/PA0: P2.19, U1.41
/PA1: P2.18, U1.40
/PA2: P2.17, U1.39
/PA3: P2.16, U1.38
/PA4: P2.15, P7.5, U1.37
/PA5: P2.14, P7.2, U1.36
/PB0: P2.13, P7.3, U1.35
/PB1: P2.12, P8.4, P9.4, R5.2, U1.34
/PB2: P2.11, P8.3, P9.3, R4.2, U1.33
/PB3: P2.10, U1.32
/PB4: P2.9, U1.30
/PB5: P2.6, P5.3, U1.28
/PB6: P2.5, P5.2, U1.27
/PB7: P2.4, P5.5, U1.26
/PD0: P2.3, U1.25
/PD1: P2.2, U1.24
/PD2: P2.1, U1.23
/PD3: P1.20, P4.3, U1.22
/PD4: P1.19, P4.5, U1.21
/PD5: P1.18, P4.2, U1.20
/PD6: P1.17, U1.19
/PD7: P1.16, U1.18
/PE0: P1.15, U1.17
/PE1: P1.14, U1.16
/PE2: P1.13, U1.15
/PE3: P1.9, U1.9
/PE4: P1.8, U1.8
/PE5: P1.1, U1.1
GND: C1.1, C2.2, C3.2, C4.2, C5.1, C6.2, C7.2, C8.2, C9.2, C10.2, C15.2, GS1.3, GS2.2, P1.3, P1.11, P2.7, P3.8, P4.1, P5.1, P7.1, P8.1, P9.1, P10.8, P11.7, R7.2, S1.3, S1.6, S1.11, SW1.3, SW2.2, U1.3, U1.12, U1.31, U1.44, U1.62, U2.1
GNDA: C11.2, C12.2, C13.2, C14.2, GS2.1, P6.3, P10.7, U1.73, U1.94, U1.95
unnamed: C1.2, D2.2, Q1.D, S1.4
unnamed: C2.1, U1.11, X1.1
unnamed: C3.1, U1.5
unnamed: C4.1, U1.13, X1.2
unnamed: C12.1, P6.2, U1.72
unnamed: D1.2, R6.2
unnamed: D2.1, R7.1
unnamed: GS1.2, Q1.G, R1.1
unnamed: L1.1, Q1.S, R1.2
