hirakuni45/RX/RX65x/board/POWER.sch

## KiCad design RX65x/board/POWER.sch (2020-04-02)

Schematic: POWER.sch

Parts:
BT1: 3V
C1: 10uF
C2, C3, C4, C5, C6, C7, C8, C9, C10, C12, C13, C14, C15: 0.1uF
C11: 0.22uF
C16: 1F
D1: Shotkey
R1: 0
U1: RX65N_176
