hirakuni45/RX/rx63t_chager/KiCAD/controller.sch

## KiCad design rx63t_chager/KiCAD/controller.sch (2014-04-23)

Schematic: controller.sch

Parts:
C1, C2: 18pF
C3, C4, C5: 0.1uF
C6: C
C7: 0.1uF
R1: 820
R2: 10K
U1: R5F563T6EDFM
U2: LM336-2.5
U3: NJU7034
X1: 12MHz

Notes on the sheet:
RUN(VCC)/Flash BOOT(GND)
