hirakuni45/RX/rx63t_chager/KiCAD/dcdc_converter.sch

## KiCad design rx63t_chager/KiCAD/dcdc_converter.sch (2014-04-19)

Schematic: dcdc_converter.sch

Parts:
U1: IR2104STRPBF
U2, U3: RSS100N03
