hirakuni45/RX/RX24T/rx24t_LOGGER/KiCAD/FTDI_serial.sch

## KiCad design RX24T/rx24t_LOGGER/KiCAD/FTDI_serial.sch (2017-08-15)

Schematic: FTDI_serial.sch

Parts:
C1, C2: 47PF
C3, C4: 0.1uF
C5: 4.7uF
C6: 10uF
CN1: USB
R1: FB
R2, R3: 27
U1: FT231XS; SSOP-20
U2: NJU7223DL1-33
