hirakuni45/RX/rxprog/main.cpp

//=========================================================================//
/*!	@file
	@brief	Renesas RX Series Programmer (RX Flash Writer)
    @author 平松邦仁 (hira@rvf-rc45.net)
	@copyright	Copyright (C) 2016, 2026 Kunihito Hiramatsu @n
				Released under the MIT license @n
				https://github.com/hirakuni45/RX/blob/master/LICENSE
*/
//=========================================================================//
#include <iostream>
#include <format>
#include "rx_prog.hpp"
#include "conf_in.hpp"
#include "motsx_io.hpp"
#include "string_utils.hpp"

namespace {

	static constexpr char version_[] = "2.11";
	static constexpr char conf_file_[] = "rx_prog.conf";
	static constexpr uint32_t cpr_last_year_ = 2026;
	static constexpr uint32_t progress_num_ = 50;
	static constexpr char progress_cha_ = '#';

	utils::conf_in conf_in_;
	utils::motsx_io motsx_;

/// motsx_io クラスの検証を行う場合に有効にする。
// #define S_REC_TEST

	void memory_dump_() noexcept
	{
#if 0
		int i = 0;
		for(auto v : mem) {
			std::cout << std::format("{:02X}, ", static_cast<uint32_t>(v));
			++i;
			if(i >= 16) {
				i = 0;
				std::cout << std::endl;
			} 
		}
#endif
	}

	const std::string get_current_path_(const std::string& exec) noexcept
	{
		std::string exec_path;
#ifdef WIN32
		{
			auto tmp = utils::sjis_to_utf8(exec);
			exec_path = utils::convert_delimiter(tmp, '\\', '/');
		}
#else
		exec_path = exec;
#endif
		std::string spch;
		std::string env;
		{
#ifdef WIN32
			auto tmp = sjis_to_utf8(getenv("PATH"));
			env = utils::convert_delimiter(tmp, '\\', '/');
			spch = ';';
#else
			env = getenv("PATH");
			spch = ':';
#endif
		}
		utils::strings ss = utils::split_text(env, spch);
		for(const auto& s : ss) {
			std::string path = s + '/' + utils::get_file_name(exec_path);
			if(utils::probe_file(path)) {
				return s;
			}
		}

		return std::string("");
	}


	struct page_t {
		uint32_t	n = 0;
		uint32_t	c = 0;
	};


	void progress_(const char* tag, uint32_t pageall, page_t& page) noexcept
	{
		std::string s;
		s += tag;
		std::cout << '\r';
		uint32_t pos = progress_num_ * page.n / pageall;
		for(uint32_t i = 0; i < progress_num_; ++i) {
			char ch = progress_cha_;
			if(pos < i) {
				ch = ' ';
			}
			s += ch;
		}
		s += std::format(" {:>3} %", ((page.n  + 1) * 100 / pageall));
		std::cout << s << std::flush;
		page.c = pos;
	}


	struct options {
		bool verbose = false;

		std::string platform;

		std::string	inp_file;
		std::string	out_file;

		std::string	device;
		bool	dv = false;

		std::string	com_speed;
		bool	br = false;

		std::string com_path;
		std::string com_name;
		bool	dp = false;

		std::string id_pad;
		rx::protocol::ID ida = { 0xff };
//		bool	id = false;

		rx::protocol::OFS ofs = { 0xffff'ffff };

		std::string erase_page_wait = "2000";
		std::string write_page_wait = "5000";

		rx::protocol::areas area_val;
//		bool	area = false;

		bool	read = false;
		bool	erase = false;
		bool	write = false;
		bool	id_table_write = false;
		bool	ofs_register_write = false;
		bool	verify = false;
		bool	device_list = false;
		bool	progress = false;
		bool	erase_data = false;
		bool	erase_rom = false;
		bool	clear_config = false;
		bool	help = false;


		bool set_area_(const std::string& s) noexcept
		{
			utils::strings ss = utils::split_text(s, ":,");
			std::string t;
			if(ss.empty()) t = s;
			else if(ss.size() >= 1) t = ss[0];
			uint32_t org = 0;
			bool err = false;
			if(!utils::string_to_hex(t, org)) {
				err = true;
			}
			uint32_t end = org + 256;
			if(ss.size() >= 2) {
				if(!utils::string_to_hex(ss[1], end)) {
					err = true;
				}
			}
			if(org >= end) {
				err = true;
			}
			if(err) {
				return false;
			}
			area_val.emplace_back(org, end);
			return true;
		}


		bool set_ofs_(const std::string& s) noexcept
		{
			utils::strings ss = utils::split_text(s, ":,");
			std::string t;
			if(ss.empty()) t = s;
			else if(ss.size() >= 1) t = ss[0];
			ofs[0] = 0xffff'ffff;
			if(!utils::string_to_hex(t, ofs[0])) {
				return false;
			}
			ofs[1] = 0xffff'ffff;
			if(ss.size() >= 2) {
				if(!utils::string_to_hex(ss[1], ofs[1])) {
					return false;
				}
			}
			return true;
		}


		bool set_str(const std::string& t) noexcept
		{
			bool ok = true;
			if(br) {
				com_speed = t;
				br = false;
			} else if(dv) {
				device = t;
				dv = false;
			} else if(dp) {
				com_path = t;
				dp = false;
//			} else if(id) {
//				id_val = t;
//				id = false;
//			} else if(area) {
//				if(!set_area_(t)) {
//					ok = false;
//				}
//				area = false;
			} else {
				if(read) {
					out_file = t;
				} else {
					inp_file = t;
				}
			}
			return ok;
		}
	};


	void help_(const std::string& cmd) noexcept
	{
		using namespace std;

		std::string c = utils::get_file_base(cmd);

		cout << "Renesas RX Series Programmer Version " << version_ << endl;
		cout << "Copyright (C) 2016, " << cpr_last_year_ << " Hiramatsu Kunihito (hira@rvf-rc45.net)" << endl;
		cout << "usage:" << endl;
		cout << c << " [options] [mot file] ..." << endl;
		cout << endl;
		cout << "Options :" << endl;
		cout << "    -P PORT,   --port=PORT     Specify serial port" << endl;
		cout << "    -s SPEED,  --speed=SPEED   Specify serial speed" << endl;
		cout << "    -d DEVICE, --device=DEVICE Specify device name" << endl;
//		cout << "    --erase-all, --erase-chip\tPerform rom and data flash erase" << endl;
//		cout << "    --erase-rom\t\t\tPerform rom flash erase" << endl;
//		cout << "    --erase-data\t\tPerform data flash erase" << endl;
		cout << "    --id=ID[:,]ID[:,] ...      Specify protect ID (16 bytes)" << endl;
		cout << "    --id-table-write           Perform ID-Tables write" << endl;
		cout << "    --ofs=OFS0[:,]OFS1         Specify OFS0/1 value (32 bits)" << endl;
		cout << "    --ofs-register-write       Perform OFS0/1 write" << endl;
		cout << "    --clear-configuration      Perform clear configuration" << endl;
		cout << "    --area=ORG[:,]END          Specify read/erase area" << endl;
		cout << "    -r, --read                 Perform data read" << endl;
		cout << "    -e, --erase                Perform a device erase to a minimum" << endl;
		cout << "    -w, --write                Perform data write" << endl;
		cout << "    -v, --verify               Perform data verify" << endl;
		cout << "    --progress                 display Progress output" << endl;
		cout << "    --erase-page-wait=WAIT     Delay per read page  (2000) [uS]" << endl;
		cout << "    --write-page-wait=WAIT     Delay per write page (5000) [uS]" << endl;
		cout << "    --device-list              Display device list" << endl;
		cout << "    --verbose                  Verbose output" << endl;
		cout << "    -h, --help                 Display this" << endl;
	}


	uint32_t count_ff_(const uint8_t* src, uint32_t num) noexcept
	{
		uint32_t ffn = 0;
		for(uint32_t i = 0; i < num; ++i) {
			if(src[i] == 0xff) {
				++ffn;
			}
		}
		return ffn;
	}


	uint32_t count_page_(const rx::protocol::areas& areas, uint32_t pgs) noexcept
	{
		uint32_t pageall = 0;
		for(const auto& a : areas) {
			auto org = a.org_ & (~(pgs - 1));
			auto lim = a.end_ | (pgs - 1);
			pageall += (lim - org + 1) / pgs;
		}
		return pageall;
	}
}

int main(int argc, char* argv[])
{
#ifdef S_REC_TEST
	{
		utils::motsx_io motsx;
		uint32_t len = (rand() & 0x3'ffff) + 100;  // 100 to 256K
		std::vector<uint8_t> data;
		for(uint32_t i = 0; i < len; ++i) {
			data.push_back(rand() & 255);
		}
		motsx.write(rand(), &data[0], len);
		char fn[] = "motsx_rand.mot";
		if(motsx.save(fn)) {
			motsx.list_area_map("Rand data save ");
			if(motsx_.load(fn)) {
				motsx_.list_area_map("Rand data load ");
				auto am = motsx_.create_area_map();
				int page = 0;
				int ng = 0;
				for(auto m : am) {
					for(uint32_t a = m.min_; a < m.max_; a += 256) {
						if(motsx_.get_memory(a) == motsx.get_memory(a)) {
							page++;
						} else {
							++ng;
						}
					}
				}
				if(ng > 0) {
					std::cout << "No match data record: " << ng << " NG!" << std::endl;
				} else {
					std::cout << "Match data array: " << page << " OK!" << std::endl;
				}
			} else {
				std::cout << "MotSx rand test: load error '" << fn << "'" << std::endl;
			}
		} else {
			std::cout << "MotSx rand test: save error '" << fn << "'" << std::endl;
		}
	}
	return 0;
#endif

	if(argc == 1) {
		help_(argv[0]);
		return 0;
	}

	options	opts;

	// 設定ファイルの読み込み
	std::string conf_path;
	if(utils::probe_file(conf_file_)) {  // カレントにあるか？
		conf_path = conf_file_;
	} else {  // コマンド、カレントから読んでみる
		conf_path = get_current_path_(argv[0]) + '/' + conf_file_;
	}	
	if(conf_in_.load(conf_path)) {
		auto defa = conf_in_.get_default();
		opts.device = defa.device_;
#ifdef __CYGWIN__
		opts.platform = "MSYS2";
		opts.com_path = defa.port_win_;
		opts.com_speed = defa.speed_win_;
#endif
#ifdef __APPLE__
		opts.platform = "OS-X";
		opts.com_path = defa.port_osx_;
		opts.com_speed = defa.speed_osx_;
#endif
#ifdef __linux__
		opts.platform = "Linux";
		opts.com_path = defa.port_linux_;
		opts.com_speed = defa.speed_linux_;
#endif
		if(opts.com_path.empty()) {
			opts.com_path = defa.port_;
		}
		if(opts.com_speed.empty()) {
			opts.com_speed = defa.speed_;
		}
		opts.id_pad = defa.id_;
		opts.erase_page_wait = defa.erase_page_wait_;
		opts.write_page_wait = defa.write_page_wait_;
	} else {
		std::cerr << "Configuration file can't load: '" << conf_path << '\'' << std::endl;
		return -1;
	}

   	// コマンドラインの解析
	bool opterr = false;
	for(int i = 1; i < argc; ++i) {
		const std::string p = argv[i];
		if(p[0] == '-') {
			if(p == "--verbose") {
				opts.verbose = true;
			} else if(p == "-s") {
				opts.br = true;
			} else if(p.find("--speed=") == 0) {
				opts.com_speed = &p[std::strlen("--speed=")];
			} else if(p == "-d") {
				opts.dv = true;
			} else if(p.find("--device=") == 0) {
				opts.device = &p[std::strlen("--device=")];
			} else if(p == "-P") {
				opts.dp = true;
			} else if(p.find("--port=") == 0) {
				opts.com_path = &p[std::strlen("--port=")];
//			} else if(p == "-a") {
//				opts.area = true;
			} else if(p.find("--area=") == 0) {
				if(!opts.set_area_(&p[std::strlen("--area=")])) {
					opterr = true;
				}
			} else if(p.find("--ofs=") == 0) {
				if(!opts.set_ofs_(&p[std::strlen("--ofs=")])) {
					opterr = true;
				}
			} else if(p == "-r" || p == "--read") {
				opts.read = true;
//			} else if(p == "-i") {
//				opts.id = true;
			} else if(p.find("--id=") == 0) {
				opts.id_pad = &p[std::strlen("--id=")];
			} else if(p == "-w" || p == "--write") {
				opts.write = true;
			} else if(p == "--id-table-write") {
				opts.id_table_write = true;
			} else if(p == "--ofs-register-write") {
				opts.ofs_register_write = true;
			} else if(p == "--clear-configuration") {
				opts.clear_config = true;
			} else if(p == "-v" || p == "--verify") {
				opts.verify = true;
			} else if(p == "--progress") {
				opts.progress = true;
			} else if(p == "--device-list") {
				opts.device_list = true;
			} else if(p == "-e" || p == "--erase") {
				opts.erase = true;
///			} else if(p == "--erase-rom") opts.erase_rom = true;
///			} else if(p == "--erase-data") opts.erase_data = true;
///			} else if(p == "--erase-all" || p == "--erase-chip") {
//				opts.erase_rom = true;
//				opts.erase_data = true;
			} else if(p.find("--erase-page-wait=") == 0) {
				opts.erase_page_wait = &p[std::strlen("--erase-page-wait=")];
			} else if(p.find("--write-page-wait=") == 0) {
				opts.write_page_wait = &p[std::strlen("--write-page-wait=")];
			} else if(p == "-h" || p == "--help") {
				opts.help = true;
			} else {
				opterr = true;
			}
		} else {
			if(!opts.set_str(p)) {
				opterr = true;
			}
		}
		if(opterr) {
			std::cerr << "Option error: '" << p << "'" << std::endl;
			opts.help = true;
		}
	}

	// ID 変換
	if(!opts.id_pad.empty()) {
		auto ss = utils::split_text(opts.id_pad, ":,");
		if(ss.size() != 16) {
			std::cerr << "The number of IDs must be 16: '" << opts.id_pad << "'" << std::endl;
			opts.help = true;
		} else {
			int i = 0;
			for(auto s : ss) {
				uint32_t v;
				if(!utils::string_to_hex(s, v)) {
					std::cerr << "Hexa-decimal conversion fail: '" << s << "'" << std::endl;
					opts.help = true;
					break;
				}
				opts.ida[i] = v;
				++i;
			}
		}
	}

	// erase/write page wait の変換
	int erase_page_wait = 0;
	if(!utils::string_to_int(opts.erase_page_wait, erase_page_wait)) {
		std::cerr << "Erase page wait value conversion error: '" << opts.erase_page_wait << "'" << std::endl;
		opts.help = true;
	}
	int write_page_wait = 0;
	if(!utils::string_to_int(opts.write_page_wait, write_page_wait)) {
		std::cerr << "Write page wait value conversion error: '" << opts.write_page_wait << "'" << std::endl;
		opts.help = true;
	}

	if(opts.verbose) {
		std::cout << "# Platform: '" << opts.platform << '\'' << std::endl;
		std::cout << "# Configuration file path: '" << conf_path << '\'' << std::endl;
		std::cout << "# Group: '" << opts.device << '\'' << std::endl;
		std::cout << "# Serial port path: '" << opts.com_path << '\'' << std::endl;
		std::cout << "# Serial port speed: " << opts.com_speed << std::endl;
		if(opts.id_pad.empty()) {
			std::cout << "# ID Passphrase: ---" << std::endl;
		} else {
			std::cout << "# ID Passphrase: " << opts.id_pad << std::endl;
		}
		if(opts.area_val.empty()) {
			std::cout << "# Read Area: ---" << std::endl;
		} else {
			for(auto t : opts.area_val) {
				std::cout << std::format("# Read area: 0x{:08X} to 0x{:08X}", t.org_, t.end_);
			}
			std::cout << std::endl;
		}
		if(opts.ofs_register_write) {
			std::cout << std::format("# OFS0/1 new value: 0x{:08X}, 0x{:08X}", opts.ofs[0], opts.ofs[1]) << std::endl;
		}
		std::cout << std::format("# Clear configuration: {}", (opts.clear_config ? "Enable" : "Disable")) << std::endl;
		std::cout << "# Erase Page Wait: " << erase_page_wait << " [uS]" << std::endl;
		std::cout << "# Write Page Wait: " << write_page_wait << " [uS]" << std::endl;
	}

	// デバイス・リスト表示
	if(!conf_path.empty() && opts.device_list) {
		for(const auto& t : conf_in_.get_device_list()) {
			std::string s;
			s += std::format("{} ({}):", t.name_, t.group_);
			s += std::format(" Program-Flash: {:>5}", t.rom_);
			s += std::format(", RAM: {:>5}", t.ram_);
			if(!t.data_.empty()) {
				s += std::format(", Data-Flash: {:>3}", t.data_);
			} else {
				s += std::format(", Data-Flash: ---");
			}
			std::cout << s << std::endl;
		}
		return 0;
	}

	// HELP 表示
	if(opts.help || opts.com_path.empty() || opts.com_speed.empty() || opts.device.empty()) {
///			&& opts.sequrity_set.empty() && !opts.sequrity_get && !opts.sequrity_release)
		if(opts.device.empty()) {
			std::cout << "Device name null." << std::endl;
		}
		if(opts.com_speed.empty()) {
			std::cout << "Serial speed none." << std::endl;
		}
		help_(argv[0]);
		return 0;
	}

	// 入力ファイルの読み込み
	if(!opts.inp_file.empty()) {
		if(opts.verbose) {
			std::cout << "# Input file path: '" << opts.inp_file << '\'' << std::endl;
		}
		if(!motsx_.load(opts.inp_file)) {
			std::cerr << "Can't open input file: '" << opts.inp_file << "'" << std::endl;
			return -1;
		}
		if(opts.verbose) {
			motsx_.list_area_map("# ");
		}
	}

    // Windwos系シリアル・ポート（COMx）の変換
    if(!opts.com_path.empty() && opts.com_path[0] != '/') {
		std::string s = utils::to_lower_text(opts.com_path);
        if(s.size() > 3 && s[0] == 'c' && s[1] == 'o' && s[2] == 'm') {
            int val;
            if(utils::string_to_int(&s[3], val)) {
                if(val >= 1 ) {
                    --val;
                    opts.com_name = opts.com_path;
                    opts.com_path = "/dev/ttyS" + std::format("{}", val);
                }
            }
        }
		if(opts.verbose) {
			std::cout << "# Serial port alias: " << opts.com_name << " ---> " << opts.com_path << std::endl;
		}
    }
	if(opts.com_path.empty()) {
		std::cerr << "Serial port path not found." << std::endl;
		return -1;
	}
	if(opts.verbose) {
		std::cout << "# Serial port path: '" << opts.com_path << '\'' << std::endl;
	}
	int com_speed = 0;
	if(!utils::string_to_int(opts.com_speed, com_speed)) {
		std::cerr << "Serial speed conversion error: '" << opts.com_speed << '\'' << std::endl;
		return -1;
	}

	rx::protocol::rx_t rx;
	rx.verbose_ = opts.verbose;
	rx.cpu_type_ = opts.device;
	rx.id_ = opts.ida;
	rx.id_write_ = opts.id_table_write;
	rx.ofs_ = opts.ofs;
	rx.ofs_write_ = opts.ofs_register_write;
	rx.clear_config_ = opts.clear_config;

	// 接続されたクロック周波数が必要なグループ
	if(rx.cpu_type_ == "RX220" || rx.cpu_type_ == "RX621" || rx.cpu_type_ == "RX62N"
		|| rx.cpu_type_ == "RX631" || rx.cpu_type_ == "RX63N" || rx.cpu_type_ == "RX63T") {
		std::string name;
		for(const auto& t : conf_in_.get_device_list()) {
			if(t.group_ != rx.cpu_type_) continue;

			int32_t val = 0;;
			if(!utils::string_to_int(t.clock_, val)) {
				std::cerr << rx.cpu_type_ << " 'clock' tag conversion error: '" << t.clock_ << '\'' << std::endl;
				return -1;
			}
			rx.master_ = val;

			if(!utils::string_to_int(t.divide_sys_, val)) {
				std::cerr << rx.cpu_type_ << " 'divide_sys' tag conversion error: '" << t.divide_sys_ << '\'' << std::endl;
				return -1;
			}
			rx.iclk_multi_ = val;

			if(!utils::string_to_int(t.divide_ext_, val)) {
				std::cerr << rx.cpu_type_ << " 'divide_ext' tag conversion error: '" << t.divide_ext_ << '\'' << std::endl;
				return -1;
			}
			rx.pclk_multi_ = val;
			name = t.name_;
			break;
		}
		if(opts.verbose) {
			std::cout << std::format("# Device: {} (first find)", name) << std::endl; 
			std::cout << std::format("#   Master clock: {}.{:02} MHz", (rx.master_ / 100), (rx.master_ % 100)) << std::endl;
			{
				int val = (rx.master_ * rx.iclk_multi_) / 100;
				int mod = (rx.master_ * rx.iclk_multi_) % 100;
				std::cout << std::format("#   ICLK multiplier: {} ({}.{:02} MHz)", rx.iclk_multi_, val, mod) << std::endl;
			}
			{
				int val = (rx.master_ * rx.pclk_multi_) / 100;
				int mod = (rx.master_ * rx.pclk_multi_) % 100;
				std::cout << std::format("#   PCLK multiplier: {} ({}.{:02} MHz)", rx.pclk_multi_, val, mod) << std::endl;
			}
		}
	}

	//================================ 接続
	rx::prog prog_(opts.verbose);
	if(!prog_.start(opts.com_path, com_speed, rx)) {
		prog_.end();
		return -1;
	}

	//================================ 読み込み
	if(opts.read && !opts.out_file.empty()) {

		rx::protocol::areas areas;
		areas = prog_.get_area();
		if(opts.area_val.size() != 0) {
			areas = opts.area_val;
		}

		if(opts.verbose) {
			for(const auto& a : areas) {
				std::cout << std::format("Read area: 0x{:08X} to 0x{:08X}", a.org_, a.end_) << std::endl;
			}
		}
		uint32_t pgs = 256;
		uint32_t pageall = count_page_(areas, pgs);
		page_t page;
		uint32_t wpg = 0;
		for(const auto& a : areas) {
			auto org = a.org_ & (~(pgs - 1));
			auto lim = a.end_ | (pgs - 1);
			auto len = lim - org + 1;
			if(opts.verbose) {
				std::cout << std::format("Read     : 0x{:08X} to 0x{:08X}", org, lim) << std::endl;
			}
			uint32_t n = 0;
			while(len > 0) {
				uint8_t tmp[pgs];
				if(!prog_.read_page(org, tmp)) {
					prog_.end();
					return -1;
				}
				if(opts.progress) {
					progress_("Read:   ", pageall, page);
				} else if(opts.verbose) {
					std::cout << '.' << std::flush;
					++n;
					if(n >= 64) {
						n = 0;
						std::cout << std::endl;
					}
				}
				if(count_ff_(tmp, pgs) != pgs) {
					motsx_.write(org, tmp, pgs);
					++wpg;
				}
				++page.n;
				org += pgs;
				len -= pgs;
			}
		}
		if(page.n > 0) {
			if(opts.progress) {
				std::cout << std::endl << std::flush;
			}
		}
		if(opts.verbose) {
			std::cout << "Output motolola-record: '" << opts.out_file << "' (" << (wpg * pgs) << " read bytes)" << std::endl;
		}
		if(wpg != 0) {
			if(!motsx_.save(opts.out_file)) {
				std::cerr << "Output file write fail: '" << opts.out_file << '\'' << std::endl;
			}
		} else {
			std::cerr << "No read area." << std::endl;
		}
	}

	//================================ 消去
	auto page_size = prog_.get_page_size();
	auto page_all = motsx_.get_total_page(page_size);
	if(opts.erase) {  // erase
		utils::motsx_io::areas as = motsx_.create_area_map();
		uint32_t pga = page_all;
		if(as.empty()) {
			if(opts.area_val.empty()) {
				for(auto t : prog_.get_area()) {
					as.emplace_back(t.org_, t.end_);
				}
				pga = count_page_(prog_.get_area(), page_size);
			} else {
				for(auto t : opts.area_val) {
					as.emplace_back(t.org_, t.end_);
				}
				pga = count_page_(opts.area_val, page_size);
			}
		}
		page_t page;
		for(const auto& a : as) {
			uint32_t adr = a.min_ & ~(page_size - 1);
			uint32_t len = 0;
			while(len < (a.max_ - a.min_ + 1)) {
				if(opts.progress) {
					progress_("Erase:  ", pga, page);
				} else if(opts.verbose) {
					std::cout << std::format("Erase: 0x{:08X} to 0x{:08X}", adr, (adr + page_size - 1)) << std::endl;
				}
				// 256/128 バイト単位で消去要求を送る
				auto st = prog_.erase_page(adr);
				if(st == rx::protocol::erase_state::ERROR) {  
					prog_.end();
					return -1;
				}
				adr += page_size;
				len += page_size;
				++page.n;
				if(st == rx::protocol::erase_state::ERASE_OK) {  // ブロックイレースが走ったら、時間待ち～
					usleep(erase_page_wait);	// 2[ms] wait 待ちを入れないとマイコン側がロストする・・
				}
			}
		}
		if(opts.progress) {
			std::cout << std::endl << std::flush;
		}
	}

	//=============================== 書き込み
	if(opts.write && page_all > 0) {  // write
		auto areas = motsx_.create_area_map();
		if(!areas.empty()) {
			if(!prog_.start_write(true)) {
				prog_.end();
				return -1;
			}
		}
		
		page_t page;
		for(const auto& a : areas) {
			uint32_t adr = a.min_ & ~(page_size - 1);
			uint32_t len = 0;
			while(len < (a.max_ - a.min_ + 1)) {
				if(opts.progress) {
					progress_("Write:  ", page_all, page);
				} else if(opts.verbose) {
					std::cout << std::format("Write: 0x{:08X} to 0x{:08X}", adr, (adr + page_size - 1)) << std::endl;
				}
				auto mem = motsx_.get_memory(adr);
				auto ofs = adr & 0xff;
				if(!prog_.write(adr, &mem[ofs])) {
					prog_.end();
					return -1;
				}
				adr += page_size;
				len += page_size;
				++page.n;
				usleep(write_page_wait);	// 待ち（通常、5ms）を入れないとマイコン側がストールする・・
			}
		}
		if(opts.progress) {
			std::cout << std::endl << std::flush;
		}
		if(!prog_.final_write()) {
			prog_.end();
			return -1;
		}
	}

	//================================ ベリファイ
	if(opts.verify) {  // verify
		auto areas = motsx_.create_area_map();
		page_t page;
		for(const auto& a : areas) {
			uint32_t adr = a.min_ & ~(page_size - 1);
			uint32_t len = 0;
			while(len < (a.max_ - a.min_ + 1)) {
				if(opts.progress) {
					progress_("Verify: ", page_all, page);
				} else if(opts.verbose) {
					std::cout << std::format("Verify: 0x{:08X} to 0x{:08X}", adr, (adr + page_size - 1)) << std::endl;
				}
				auto mem = motsx_.get_memory(adr);
				auto ofs = adr & 0xff;
				if(!prog_.verify_page(adr, &mem[ofs])) {
					prog_.end();
					return -1;
				}
				adr += page_size;
				len += page_size;
				++page.n;
			}
		}
		if(opts.progress) {
			std::cout << std::endl << std::flush;
		}
	}

	prog_.end();
}
