hirakuni45/RX/r_usb/basic/src/driver/inc/r_usb_basic_define.h

/*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
 * Copyright (C) 2014(2019) Renesas Electronics Corporation. All rights reserved.
 ***********************************************************************************************************************/
/***********************************************************************************************************************
 * File Name    : r_usb_basic_define.h
 * Description  : USB common macro define header
 ***********************************************************************************************************************/
/**********************************************************************************************************************
 * History : DD.MM.YYYY Version Description
 *         : 08.01.2014 1.00 First Release
 *         : 26.12.2014 1.10 RX71M is added
 *         : 30.09.2015 1.11 RX63N/RX631 is added.
 *         : 30.09.2016 1.20 RX65N/RX651 is added.
 *         : 26.01.2017 1.21 USB_VERSION_MINOR is updated.
 *         : 30.09.2017 1.22 RX62N/RX630/RX63T-H is added.
 *         : 31.03.2018 1.23 Supporting Smart Configurator
 *         : 16.11.2018 1.24 Supporting RTOS Thread safe
 *         : 31.05.2019 1.26 Added support for GNUC and ICCRX.
 *         : 30.07.2019 1.27 RX72M is added.
 ***********************************************************************************************************************/

#ifndef R_USB_BASIC_DEFINE_H
#define R_USB_BASIC_DEFINE_H

#define USB_CFG_LITTLE          (0u)
#define USB_CFG_BIG             (1u)

#if defined(__CCRX__)

  #ifdef __BIG
    #define    USB_CFG_ENDIAN           (USB_CFG_BIG)
  #else   /* __BIG */
    #define    USB_CFG_ENDIAN           (USB_CFG_LITTLE)
  #endif  /* __BIG */

#elif defined(__GNUC__)

  #ifdef __RX_BIG_ENDIAN__
    #define    USB_CFG_ENDIAN           (USB_CFG_BIG)
  #else   /* __RX_BIG_ENDIAN__ */
    #define    USB_CFG_ENDIAN           (USB_CFG_LITTLE)
  #endif  /* __RX_BIG_ENDIAN__ */

#elif defined(__ICCRX__)

  #if __BIG_ENDIAN__
    #define    USB_CFG_ENDIAN           (USB_CFG_BIG)
  #else   /* __BIG_ENDIAN__ */
    #define    USB_CFG_ENDIAN           (USB_CFG_LITTLE)
  #endif  /* __BIG_ENDIAN__ */

#endif /* defined(__CCRX__), defined(__GNUC__), defined(__ICCRX__) */

#if defined(USB_DEBUG_ON)
    #include    <stdlib.h>          /* @@@MISRA del */
    #include    <stdio.h>           /* @@@MISRA del */
#endif  /* defined(USB_DEBUG_ON) */

#if defined(BSP_MCU_RX631)
    #define BSP_MCU_RX63N BSP_MCU_RX631
#endif /* #if defined(BSP_MCU_RX631) */

#if defined(BSP_MCU_RX621)
    #define BSP_MCU_RX62N BSP_MCU_RX621
#endif /* #if defined(BSP_MCU_RX631) */

#if defined(BSP_MCU_RX66T)
    #define BSP_MCU_RX72T BSP_MCU_RX66T
#endif /* #if defined(BSP_MCU_RX72T) */


#define R_USB_HmscTask              usb_hmsc_task
#define R_USB_HmscStrgReadSector    usb_hmsc_strg_read_sector
#define R_USB_HmscStrgWriteSector   usb_hmsc_strg_write_sector

/**********************************************************************************************************************
 * Macro definitions
 **********************************************************************************************************************/
/* Version Number of API. */
#define USB_VERSION_MAJOR   (1)
#define USB_VERSION_MINOR   (27)

#define CLSDATASIZE         (512u)              /* Transfer data size for Standard Request */
#if (BSP_CFG_RTOS_USED == 1)
    /* The buffer size of interrupt info is increased to avoid overlapping interrupt events. */
    #define USB_INT_BUFSIZE     (64u)           /* Size of Interrupt info buffer */
#else /* (BSP_CFG_RTOS_USED == 1) */
    #define USB_INT_BUFSIZE     (10u)           /* Size of Interrupt info buffer */
#endif /* (BSP_CFG_RTOS_USED == 1) */
#define USB_EVENT_MAX       (10)

/* Scheduler use define */
#define USB_TBLCLR          (0u)                /* Table clear */
#define USB_CNTCLR          (0u)                /* Counter clear */
#define USB_FLGCLR          (0u)                /* Flag clear */
#define USB_FLGSET          (1u)                /* Flag set */
#define USB_IDCLR           (0xFFu)             /* Priority clear */

/* Task ID define */
#define USB_TID_0           (0u)                /* Task ID 0 */
#define USB_TID_1           (1u)                /* Task ID 1 */
#define USB_TID_2           (2u)                /* Task ID 2 */
#define USB_TID_3           (3u)                /* Task ID 3 */
#define USB_TID_4           (4u)                /* Task ID 4 */
#define USB_TID_5           (5u)                /* Task ID 5 */
#define USB_TID_6           (6u)                /* Task ID 6 */
#define USB_TID_7           (7u)                /* Task ID 7 */
#define USB_TID_8           (8u)                /* Task ID 8 */
#define USB_TID_9           (9u)                /* Task ID 9 */
#define USB_TID_10          (10u)               /* Task ID 9 */

/* Task priority define */
#define USB_PRI_0           (0u)                 /* Priority 0 */
#define USB_PRI_1           (1u)                 /* Priority 1 */
#define USB_PRI_2           (2u)                 /* Priority 2 */
#define USB_PRI_3           (3u)                 /* Priority 3 */
#define USB_PRI_4           (4u)                 /* Priority 4 */
#define USB_PRI_5           (5u)                 /* Priority 5 */
#define USB_PRI_6           (6u)                 /* Priority 6 */

/* Host Control Driver Task */
#define USB_HCD_TSK         (USB_TID_1)          /* Task ID */
#define USB_HCD_MBX         (USB_HCD_TSK)        /* Mailbox ID */
#define USB_HCD_MPL         (USB_HCD_TSK)        /* Memory pool ID */

/* Host Manager Task */
#define USB_MGR_TSK         (USB_TID_2)          /* Task ID */
#define USB_MGR_MBX         (USB_MGR_TSK)        /* Mailbox ID */
#define USB_MGR_MPL         (USB_MGR_TSK)        /* Memory pool ID */

/* Hub Task */
#define USB_HUB_TSK         (USB_TID_3)          /* Task ID */
#define USB_HUB_MBX         (USB_HUB_TSK)        /* Mailbox ID */
#define USB_HUB_MPL         (USB_HUB_TSK)        /* Memory pool ID */

#if (BSP_CFG_RTOS_USED == 1)
/* Class Request for Internal Communication  */
#define USB_CLS_TSK         (USB_TID_4)          /* Task ID */
#define USB_CLS_MBX         (USB_CLS_TSK)        /* Mailbox ID */
#define USB_CLS_MPL         (USB_CLS_TSK)        /* Memory pool ID */

/* Peripheral Control Driver Task */
#define USB_PCD_TSK         (USB_TID_5)          /* Task ID */
#define USB_PCD_MBX         (USB_PCD_TSK)        /* Mailbox ID */
#endif /* (BSP_CFG_RTOS_USED == 1) */

/* Error discrimination */
#define USB_DEBUG_HOOK_HWR      (0x0100)
#define USB_DEBUG_HOOK_HOST     (0x0200)
#define USB_DEBUG_HOOK_PERI     (0x0400)
#define USB_DEBUG_HOOK_STD      (0x0800)
#define USB_DEBUG_HOOK_CLASS    (0x1000)
#define USB_DEBUG_HOOK_APL      (0x2000)

/* Error Code */
#define USB_DEBUG_HOOK_CODE1    (0x0001)
#define USB_DEBUG_HOOK_CODE2    (0x0002)
#define USB_DEBUG_HOOK_CODE3    (0x0003)
#define USB_DEBUG_HOOK_CODE4    (0x0004)
#define USB_DEBUG_HOOK_CODE5    (0x0005)
#define USB_DEBUG_HOOK_CODE6    (0x0006)
#define USB_DEBUG_HOOK_CODE7    (0x0007)
#define USB_DEBUG_HOOK_CODE8    (0x0008)
#define USB_DEBUG_HOOK_CODE9    (0x0009)
#define USB_DEBUG_HOOK_CODE10   (0x000A)
#define USB_DEBUG_HOOK_CODE11   (0x000B)
#define USB_DEBUG_HOOK_CODE12   (0x000C)
#define USB_DEBUG_HOOK_CODE13   (0x000D)
#define USB_DEBUG_HOOK_CODE14   (0x000E)
#define USB_DEBUG_HOOK_CODE15   (0x000F)

#ifdef USB_DEBUG_HOOK_USE
    #define USB_DEBUG_HOOK(x)     (usb_cstd_debug_hook(x))
#else
    #define USB_DEBUG_HOOK(x)
#endif

/* H/W function type */
#define USB_HOST                ((uint16_t)1u)     /* Host mode */
#define USB_PERI                ((uint16_t)2u)     /* Peripheral mode */

/* H/W function type */
#define USB_BIT0                ((uint16_t)0x0001)
#define USB_BIT1                ((uint16_t)0x0002)
#define USB_BIT2                ((uint16_t)0x0004)
#define USB_BIT3                ((uint16_t)0x0008)
#define USB_BIT4                ((uint16_t)0x0010)
#define USB_BIT5                ((uint16_t)0x0020)
#define USB_BIT6                ((uint16_t)0x0040)
#define USB_BIT7                ((uint16_t)0x0080)
#define USB_BIT8                ((uint16_t)0x0100)
#define USB_BIT9                ((uint16_t)0x0200)
#define USB_BIT10               ((uint16_t)0x0400)
#define USB_BIT11               ((uint16_t)0x0800)
#define USB_BIT12               ((uint16_t)0x1000)
#define USB_BIT13               ((uint16_t)0x2000)
#define USB_BIT14               ((uint16_t)0x4000)
#define USB_BIT15               ((uint16_t)0x8000)
#define USB_BITSET(x)           ((uint16_t)((uint16_t)1 << (x)))

/* nonOS Use */
#define USB_SEQ_0               ((uint16_t)0x0000)
#define USB_SEQ_1               ((uint16_t)0x0001)
#define USB_SEQ_2               ((uint16_t)0x0002)
#define USB_SEQ_3               ((uint16_t)0x0003)
#define USB_SEQ_4               ((uint16_t)0x0004)
#define USB_SEQ_5               ((uint16_t)0x0005)
#define USB_SEQ_6               ((uint16_t)0x0006)
#define USB_SEQ_7               ((uint16_t)0x0007)
#define USB_SEQ_8               ((uint16_t)0x0008)
#define USB_SEQ_9               ((uint16_t)0x0009)
#define USB_SEQ_10              ((uint16_t)0x000a)

/* USB HUB PIPE No. */
#define USB_HUB_PIPE            (9u)

#define USB_HUB_P1              ((uint16_t)0x0001)
#define USB_HUB_P2              ((uint16_t)0x0002)
#define USB_HUB_P3              ((uint16_t)0x0003)
#define USB_HUB_P4              ((uint16_t)0x0004)

#define USB_HUB                 (USB_REQUEST +1)

/* Interrupt message num */
#define USB_INTMSGMAX           ((uint16_t)15u)

/* USB Device Connect */
#define USB_DEV_NO_CONNECT      ((uint16_t)0u)
#define USB_DEV_CONNECTED       ((uint16_t)1u)

#define USB_OK              (0u)
#define USB_ERROR           (0xff)
#define USB_QOVR            (0xd5)      /* Submit overlap error */
#define USB_PAR             (0xef)      /* parameter error */

#define USB_TRUE            (1u)
#define USB_FALSE           (0u)

#define USB_YES             (1u)
#define USB_NO              (0u)

#define USB_CFG_HIGH        (0u)
#define USB_CFG_LOW         (1u)

/******************************************************************************
 Macro definitions
 ******************************************************************************/
/* The number of USBIP */
#if defined(BSP_MCU_RX64M) || defined(BSP_MCU_RX71M) || defined(BSP_MCU_RX63N) || defined(BSP_MCU_RX62N)
    #define USB_NUM_USBIP           (2u)

#else   /* defined(BSP_MCU_RX64M) || defined(BSP_MCU_RX71M) || defined(BSP_MCU_RX63N) || defined(BSP_MCU_RX62N) */
    #define USB_NUM_USBIP           (1u)

#endif  /* defined(BSP_MCU_RX64M) || defined(BSP_MCU_RX71M) || defined(BSP_MCU_RX63N) || defined(BSP_MCU_RX62N) */

/* USB module definition */
#define USB_M0  (USB0_)
#if defined(BSP_MCU_RX63N) || defined(BSP_MCU_RX62N)
/*    #define USB_M1  (USB1) */
#define USB_M1  (*(struct st_usb0    R_BSP_VOLATILE_EVENACCESS *)0xA0200)

#endif  /* defined(BSP_MCU_RX63N) || defined(BSP_MCU_RX62N) */
#if defined(BSP_MCU_RX64M) || defined(BSP_MCU_RX71M)
    #define USB_M1  (USBA)
#endif  /* defined(BSP_MCU_RX64M) || defined(BSP_MCU_RX71M) */

/* FIFO port register default access size */
#define USB0_CFIFO_MBW          (USB_MBW_16)
#define USB0_D0FIFO_MBW         (USB_MBW_16)
#define USB0_D1FIFO_MBW         (USB_MBW_16)

#if defined(BSP_MCU_RX64M) || defined(BSP_MCU_RX71M)
#define USB1_CFIFO_MBW          (USB_MBW_32)
#define USB1_D0FIFO_MBW         (USB_MBW_32)
#define USB1_D1FIFO_MBW         (USB_MBW_32)
#else   /* defined(BSP_MCU_RX64M) || defined(BSP_MCU_RX71M) */
#define USB1_CFIFO_MBW          (USB_MBW_16)
#define USB1_D0FIFO_MBW         (USB_MBW_16)
#define USB1_D1FIFO_MBW         (USB_MBW_16)
#endif  /* defined(BSP_MCU_RX64M) || defined(BSP_MCU_RX71M) */

/* Start Pipe No */
#define USB_MIN_PIPE_NO         (1u)

/* Max device */
#define USB_MAXPIPE_BULK        (5u)
#define USB_MAXPIPE_ISO         (2u)
#define USB_MAXPIPE_NUM         (9u)

#define USB_BULK_PIPE_START     (1u)
#define USB_BULK_PIPE_END       (5u)
#define USB_INT_PIPE_START      (6u)
#define USB_INT_PIPE_END        (9u)
#define USB_ISO_PIPE_START      (1u)
#define USB_ISO_PIPE_END        (2u)


/* SPEED mode */
#define USB_HS_DISABLE          ((uint16_t)0u)
#define USB_HS_ENABLE           ((uint16_t)1u)

#define USBA_ADDRESS_OFFSET     (0x0010)
#define USB_ADDRESS_MASK        (0x000f)
#define USB_IP_MASK             (0x00f0)

/* USB Device address define */
#define USB_DEVICEADDR          (1u)      /* PORT0 USB Address (1 to 10) */

/* HUB Address */
#define USB_HUBDPADDR           ((uint16_t)(USB_DEVICEADDR + 1u))

#define USB_PIPE_DIR_IN         (0u)
#define USB_PIPE_DIR_OUT        (1u)
#define USB_PIPE_DIR_MAX        (2u)

#define USB_CFG_ENABLE          (1u)
#define USB_CFG_DISABLE         (0u)

#define USB_CFG_IP0             (0)
#define USB_CFG_IP1             (1)
#define USB_CFG_MULTI           (2)

#define USB_CFG_HOST            (1)
#define USB_CFG_PERI            (2)

#define USB_CFG_CDC             (0)
#define USB_CFG_VEN             (1)

#define USB_CFG_24MHZ           (0)
#define USB_CFG_20MHZ           (1)
#define USB_CFG_OTHER           (2)

/* Channel Number */
#define USB_CFG_CH0             (0u)
#define USB_CFG_CH1             (1u)
#define USB_CFG_CH2             (2u)
#define USB_CFG_CH3             (3u)
#define USB_CFG_CH4             (4u)
#define USB_CFG_CH5             (5u)
#define USB_CFG_CH6             (6u)
#define USB_CFG_CH7             (7u)

#define USB_CFG_USE             (0u)
#define USB_CFG_NOUSE           (0xFFFFu)

#define USB_CFG_ON              (1u)
#define USB_CFG_OFF             (0u)

#define USB_CFG_FS              (1)
#define USB_CFG_HS              (2)

/******************************************************************************
 USB specification define
 ******************************************************************************/

/* Standard Device Descriptor Define */
#define USB_DEV_B_LENGTH                    (0u)        /* Size of descriptor */
#define USB_DEV_B_DESCRIPTOR_TYPE           (1u)        /* Descriptor type */
#define USB_DEV_BCD_USB_L                   (2u)        /* USB Specification Release Number */
#define USB_DEV_BCD_USB_H                   (3u)        /* USB Specification Release Number */
#define USB_DEV_B_DEVICE_CLASS              (4u)        /* Class code */
#define USB_DEV_B_DEVICE_SUBCLASS           (5u)        /* Subclass code */
#define USB_DEV_B_DEVICE_PROTOCOL           (6u)        /* Protocol code */
#define USB_DEV_B_MAX_PACKET_SIZE_0         (7u)        /* Max packet size for EP0(only 8,16,32,64 are valid) */
#define USB_DEV_ID_VENDOR_L                 (8u)        /* Vendor ID */
#define USB_DEV_ID_VENDOR_H                 (9u)        /* Vendor ID */
#define USB_DEV_ID_PRODUCT_L                (10u)       /* Product ID */
#define USB_DEV_ID_PRODUCT_H                (11u)       /* Product ID */
#define USB_DEV_BCD_DEVICE_L                (12u)       /* Device release number */
#define USB_DEV_BCD_DEVICE_H                (13u)       /* Device release number */
#define USB_DEV_I_MANUFACTURER              (14u)       /* Index of string descriptor describing manufacturer */
#define USB_DEV_I_PRODUCT                   (15u)       /* Index of string descriptor describing product */
#define USB_DEV_I_SERIAL_NUMBER             (16u)       /* Device serial number */
#define USB_DEV_B_NUM_CONFIGURATION         (17u)       /* Number of possible configuration */

/* Standard Configuration Descriptor Define */
#define USB_DEV_W_TOTAL_LENGTH_L            (2u)        /* Total length of data returned for this configuration */
#define USB_DEV_W_TOTAL_LENGTH_H            (3u)        /* Total length of data returned for this configuration */
#define USB_DEV_B_NUM_INTERFACES            (4u)        /* Number of interfaces supported by this configuration */
#define USB_DEV_B_CONFIGURATION_VALUE       (5u)        /* Configuration value */
#define USB_DEV_I_CONFIGURATION             (6u)        /* Index of string descriptor describing this configuration */
#define USB_DEV_BM_ATTRIBUTES               (7u)        /* Configuration characteristics */
#define USB_DEV_B_MAX_POWER                 (8u)        /* Max power consumption of the USB device from the bus */

/* Endpoint Descriptor  Define */
#define USB_EP_DIRMASK                      (0x80u)     /* Endpoint direction mask [2] */
#define USB_EP_NUMMASK                      (0x0Fu)     /* Endpoint number mask [2] */
#define USB_EP_USGMASK                      (0x30u)     /* Usage type mask [2] */
#define USB_EP_SYNCMASK                     (0x0Cu)     /* Synchronization type mask [2] */
#define USB_EP_TRNSMASK                     (0x03u)     /* Transfer type mask [2] */
#define USB_EP_CNTRL                        (0x00u)     /* Control Transfer */

#define USB_EP_B_LENGTH                     (0u)      /* Size of descriptor */
#define USB_EP_B_DESCRIPTORTYPE             (1u)      /* Descriptor type */
#define USB_EP_B_ENDPOINTADDRESS            (2u)      /* Endpoint No. , Dir */
#define USB_EP_B_ATTRIBUTES                 (3u)      /* Transfer Type */
#define USB_EP_B_MAXPACKETSIZE_L            (4u)      /* Max packet size */
#define USB_EP_B_MAXPACKETSIZE_H            (5u)      /* Max packet size */
#define USB_EP_B_INTERVAL                   (6u)      /* Interval */

/* Standard Interface Descriptor Offset Define */
#define USB_IF_B_INTERFACENUMBER            (2u)      /* bInterfaceNumber */
#define USB_IF_B_ALTERNATESETTING           (3u)      /* bAlternateSetting */
#define USB_IF_B_NUMENDPOINTS               (4u)      /* bNumEndpoints */
#define USB_IF_B_INTERFACECLASS             (5u)      /* bInterfaceClass */
#define USB_IF_B_INTERFACESUBCLASS          (6u)      /* bInterfaceSubClass @@*/
#define USB_IF_B_INTERFACEPROTOCOL          (7u)      /* bInterfacePtorocol */
#define USB_IF_I_INTERFACE                  (8u)      /* iInterface */

/* GET_STATUS request information */
/* Standard Device status */
#define USB_GS_BUSPOWERD                    (0x0000u)
#define USB_GS_SELFPOWERD                   (0x0001u)
#define USB_GS_REMOTEWAKEUP                 (0x0002u)

/* Endpoint status */
#define USB_GS_NOTHALT                      (0x0000u)
#define USB_GS_HALT                         (0x0001u)

/* CLEAR_FEATURE/GET_FEATURE/SET_FEATURE request information */
/* Standard Feature Selector */
#define USB_ENDPOINT_HALT                   (0x0000u)
#define USB_DEV_REMOTE_WAKEUP               (0x0001u)
#define USB_TEST_MODE                       (0x0002u)

/* GET_DESCRIPTOR/SET_DESCRIPTOR request information */
/* Standard Descriptor type */
#define USB_HUB_DESCRIPTOR                  (0x0000u)
#define USB_DEV_DESCRIPTOR                  (0x0100u)
#define USB_CONF_DESCRIPTOR                 (0x0200u)
#define USB_STRING_DESCRIPTOR               (0x0300u)
#define USB_INTERFACE_DESCRIPTOR            (0x0400u)
#define USB_ENDPOINT_DESCRIPTOR             (0x0500u)
#define USB_DEV_QUALIFIER_DESCRIPTOR        (0x0600u)
#define USB_OTHER_SPEED_CONF_DESCRIPTOR     (0x0700u)
#define USB_INTERFACE_POWER_DESCRIPTOR      (0x0800u)

/* HUB CLASS REQUEST */
#define USB_HUB_CLEAR_TT_BUFFER             (0x0800u)
#define USB_HUB_RESET_TT                    (0x0900u)
#define USB_HUB_GET_TT_STATE                (0x0A00u)
#define USB_HUB_STOP_TT                     (0x0B00u)

/* HUB CLASS FEATURE SELECTER */
#define USB_HUB_C_HUB_LOCAL_POWER           (0x0000u)
#define USB_HUB_C_HUB_OVER_CURRENT          (0x0001u)
#define USB_HUB_PORT_CONNECTION             (0x0000u)
#define USB_HUB_PORT_ENABLE                 (0x0001u)
#define USB_HUB_PORT_SUSPEND                (0x0002u)
#define USB_HUB_PORT_OVER_CURRENT           (0x0003u)
#define USB_HUB_PORT_RESET                  (0x0004u)
#define USB_HUB_PORT_POWER                  (0x0008u)
#define USB_HUB_PORT_LOW_SPEED              (0x0009u)
#define USB_HUB_PORT_HIGH_SPEED             (0x000Au)
#define USB_HUB_C_PORT_CONNECTION           (0x0010u)
#define USB_HUB_C_PORT_ENABLE               (0x0011u)
#define USB_HUB_C_PORT_SUSPEND              (0x0012u)
#define USB_HUB_C_PORT_OVER_CURRENT         (0x0013u)
#define USB_HUB_C_PORT_RESET                (0x0014u)
#define USB_HUB_PORT_TEST                   (0x0015u)
#define USB_HUB_PORT_INDICATOR              (0x0016u)

/* HUB PORT STAUS */
#define USB_HUB_STS_PORT_CONNECT            (0x0001u)
#define USB_HUB_STS_PORT_ENABLE             (0x0002u)
#define USB_HUB_STS_PORT_SUSPEND            (0x0004u)
#define USB_HUB_STS_PORT_OVRCURRNET         (0x0008u)
#define USB_HUB_STS_PORT_RESET              (0x0010u)
#define USB_HUB_STS_PORT_POWER              (0x0100u)
#define USB_HUB_STS_PORT_LOWSPEED           (0x0200u)
#define USB_HUB_STS_PORT_FULLSPEED          (0x0000u)
#define USB_HUB_STS_PORT_HIGHSPEED          (0x0400u)
#define USB_HUB_STS_PORT_TEST               (0x0800u)
#define USB_HUB_STS_PORT_INDICATOR          (0x1000u)

/* HUB PORT CHANGE */
#define USB_HUB_CHG_PORT_CONNECT            (0x0001u)
#define USB_HUB_CHG_PORT_ENABLE             (0x0002u)
#define USB_HUB_CHG_PORT_SUSPEND            (0x0004u)
#define USB_HUB_CHG_PORT_OVRCURRNET         (0x0008u)
#define USB_HUB_CHG_PORT_RESET              (0x0010u)

/* Device connect information */
#define USB_ATTACH                          (0x0040u)
#define USB_ATTACHL                         (0x0041u)
#define USB_ATTACHF                         (0x0042u)
#define USB_DETACH                          (0x0043u)

/* Reset Handshake result */
#define USB_NOCONNECT                       (0x0000u)   /* Speed undecidedness */
#define USB_HSCONNECT                       (0x00C0u)   /* Hi-Speed connect */
#define USB_FSCONNECT                       (0x0080u)   /* Full-Speed connect */
#define USB_LSCONNECT                       (0x0040u)   /* Low-Speed connect */

/* Pipe define */
#define USB_USEPIPE                         (0x00FEu)
#define USB_PERIPIPE                        (0x00FDu)
#define USB_CLRPIPE                         (0x00FCu)   /* Clear Pipe registration */
#define USB_MAX_PIPE_NO                     (9u)        /* PIPE0 ... PIPE9 */

/* Pipe configuration table define */
#define USB_EPL                             (6u)        /* Pipe configuration table length */
#define USB_TYPFIELD                        (0xC000u)   /* Transfer type */
#define USB_PERIODIC                        (0x8000u)   /* Periodic pipe */
#define USB_TYPFIELD_ISO                    (0xC000u)   /* Isochronous */
#define USB_TYPFIELD_INT                    (0x8000u)   /* Interrupt */
#define USB_TYPFIELD_BULK                   (0x4000u)   /* Bulk */
#define USB_NOUSE                           (0x0000u)   /* Not configuration */
#define USB_BFREFIELD                       (0x0400u)   /* Buffer ready interrupt mode select */
#define USB_BFREON                          (0x0400u)
#define USB_BFREOFF                         (0x0000u)
#define USB_DBLBFIELD                       (0x0200u)   /* Double buffer mode select */
#define USB_CFG_DBLBON                      (0x0200u)
#define USB_CFG_DBLBOFF                     (0x0000u)
#define USB_CNTMDFIELD                      (0x0100u)   /* Continuous transfer mode select */
#define USB_CFG_CNTMDON                     (0x0100u)
#define USB_CFG_CNTMDOFF                    (0x0000u)
#define USB_SHTNAKFIELD                     (0x0080u)   /* Transfer end NAK */
#define USB_DIRFIELD                        (0x0010u)   /* Transfer direction select */
#define USB_DIR_H_OUT                       (0x0010u)   /* HOST OUT */
#define USB_DIR_P_IN                        (0x0010u)   /* PERI IN */
#define USB_DIR_H_IN                        (0x0000u)   /* HOST IN */
#define USB_DIR_P_OUT                       (0x0000u)   /* PERI OUT */
#define USB_BUF2FIFO                        (0x0010u)   /* Buffer --> FIFO */
#define USB_FIFO2BUF                        (0x0000u)   /* FIFO --> buffer */
#define USB_EPNUMFIELD                      (0x000Fu)   /* Endpoint number select */
#define USB_MAX_EP_NO                       (15u)       /* EP0 EP1 ... EP15 */

#define USB_BUF_SIZE(x)                     ((uint16_t)(((x) / 64u) - 1u) << 10u)
#define USB_BUF_NUMB(x)                     (x)

#define USB_IFISFIELD                       (0x1000u) /* Isochronous in-buf flash mode */
#define USB_IFISON                          (0x1000u)
#define USB_IFISOFF                         (0x0000u)
#define USB_IITVFIELD                       (0x0007u) /* Isochronous interval */
#define USB_IITV_TIME(x)                    (x)

/* FIFO port & access define */
#define USB_CUSE                            (0u)  /* CFIFO  trans */
#define USB_D0USE                           (1u)  /* D0FIFO trans */
#define USB_D1USE                           (2u)  /* D1FIFO trans */
#define USB_FIFO_ACCESS_NUM_MAX             (3u)  /* MAX number for FIFO port define */

/******************************************************************************
 Another define
 ******************************************************************************/
/* FIFO read / write result */
#define USB_FIFOERROR                       (USB_ERROR)   /* FIFO not ready */
#define USB_WRITEEND                        (0x0000u)     /* End of write (but packet may not be outputting) */
#define USB_WRITESHRT                       (0x0001u)     /* End of write (send short packet) */
#define USB_WRITING                         (0x0002u)     /* Write continues */
#define USB_READEND                         (0x0000u)     /* End of read */
#define USB_READSHRT                        (0x0001u)     /* Insufficient (receive short packet) */
#define USB_READING                         (0x0002u)     /* Read continues */
#define USB_READOVER                        (0x0003u)     /* Buffer size over */

/* Pipe define table end code */
#define USB_PDTBLEND                        (0xFFFFu) /* End of table */

/* Transfer status Type */
#define USB_CTRL_END                        (0u)
#define USB_DATA_NONE                       (1u)
#define USB_DATA_WAIT                       (2u)
#define USB_DATA_OK                         (3u)
#define USB_DATA_SHT                        (4u)
#define USB_DATA_OVR                        (5u)
#define USB_DATA_STALL                      (6u)
#define USB_DATA_ERR                        (7u)
#define USB_DATA_STOP                       (8u)
#define USB_DATA_TMO                        (9u)
#define USB_CTRL_READING                    (17u)
#define USB_CTRL_WRITING                    (18u)
#define USB_DATA_READING                    (19u)
#define USB_DATA_WRITING                    (20u)

/* Utr member (segment) */
#define USB_TRAN_CONT                       (0x00u)
#define USB_TRAN_END                        (0x80u)

/* Callback argument */
#define USB_NO_ARG                          (0u)

/* USB interrupt type (common)*/
#define USB_INT_UNKNOWN                     (0x0000u)
#define USB_INT_BRDY                        (0x0001u)
#define USB_INT_BEMP                        (0x0002u)
#define USB_INT_NRDY                        (0x0003u)
#define USB_INT_DXFIFO                      (0x0004u)   /* BSP_CFG_RTOS_USED == 1 */

/* USB interrupt type (PERI)*/
#define USB_INT_VBINT                       (0x0011u)
#define USB_INT_RESM                        (0x0012u)
#define USB_INT_SOFR                        (0x0013u)
#define USB_INT_DVST                        (0x0014u)
#define USB_INT_CTRT                        (0x0015u)
#define USB_INT_ATTACH                      (0x0016u)
#define USB_INT_DETACH                      (0x0017u)

/* USB interrupt type (HOST)*/
#define USB_INT_OVRCR0                      (0x0041u)
#define USB_INT_BCHG0                       (0x0042u)
#define USB_INT_DTCH0                       (0x0043u)
#define USB_INT_ATTCH0                      (0x0044u)
#define USB_INT_EOFERR0                     (0x0045u)
#define USB_INT_PDDETINT0                   (0x0046u)
#define USB_INT_OVRCR1                      (0x0051u)
#define USB_INT_BCHG1                       (0x0052u)
#define USB_INT_ATTCH1                      (0x0053u)
#define USB_INT_DTCH1                       (0x0054u)
#define USB_INT_EOFERR1                     (0x0055u)
#define USB_INT_SACK                        (0x0061u)
#define USB_INT_SIGN                        (0x0062u)

#define USB_UACTON                          (1u)
#define USB_UACTOFF                         (0u)
#define USB_VBON                            (1u)
#define USB_VBOFF                           (0u)

#define USB_NOVENDOR                        (0xFFFFu) /* Vendor ID no check */
#define USB_NOPRODUCT                       (0xFFFFu) /* Product ID no check */

#define USB_INTFCLSHET                      (0xAAu)   /* Host electrical test class */

/* Root port */
#define USB_NOPORT                          (0xFFFFu) /* Not connect */

/* Condition compilation by the difference of IP */
#define USB_MAXDEVADDR                      (5u)

#define USB_DEVICE_0                        (0x0000u) /* Device address 0 */
#define USB_DEVICE_1                        (0x1000u) /* Device address 1 */
#define USB_DEVICE_2                        (0x2000u) /* Device address 2 */
#define USB_DEVICE_3                        (0x3000u) /* Device address 3 */
#define USB_DEVICE_4                        (0x4000u) /* Device address 4 */
#define USB_DEVICE_5                        (0x5000u) /* Device address 5 */
#define USB_DEVICE_6                        (0x6000u) /* Device address 6 */
#define USB_DEVICE_7                        (0x7000u) /* Device address 7 */
#define USB_DEVICE_8                        (0x8000u) /* Device address 8 */
#define USB_DEVICE_9                        (0x9000u) /* Device address 9 */
#define USB_DEVICE_A                        (0xA000u) /* Device address A */
#define USB_NODEVICE                        (0xF000u) /* No device */
#define USB_DEVADDRBIT                      (12u)

/* DCP Max packet size */
#define USB_MAXPFIELD                       (0x007Fu) /* Max packet size of DCP */

/******************************************************************************
 Another define
 ******************************************************************************/
/* ControlPipe Max Packet size */
#define USB_DEFPACKET                       (0x0040u) /* Default DCP Max packet size */

/* Device state define */
#define USB_NONDEVICE                       (0u)
#define USB_NOTTPL                          (1u)
#define USB_DEVICEENUMERATION               (3u)
#define USB_COMPLETEPIPESET                 (10u)

/* Control Transfer Stage */
#define USB_IDLEST                          (0u)  /* Idle */
#define USB_SETUPNDC                        (1u)  /* Setup Stage No Data Control */
#define USB_SETUPWR                         (2u)  /* Setup Stage Control Write */
#define USB_SETUPRD                         (3u)  /* Setup Stage Control Read */
#define USB_DATAWR                          (4u)  /* Data Stage Control Write */
#define USB_DATARD                          (5u)  /* Data Stage Control Read */
#define USB_STATUSRD                        (6u)  /* Status stage */
#define USB_STATUSWR                        (7u)  /* Status stage */
#define USB_SETUPWRCNT                      (17u) /* Setup Stage Control Write */
#define USB_SETUPRDCNT                      (18u) /* Setup Stage Control Read */
#define USB_DATAWRCNT                       (19u) /* Data Stage Control Write */
#define USB_DATARDCNT                       (20u) /* Data Stage Control Read */

/******************************************************************************
 HUB define
 ******************************************************************************/
/* HUB spec */
#define USB_FSHUB                           (1u)
#define USB_HSHUBS                          (2u)
#define USB_HSHUBM                          (3u)

/* Interface number */
#define USB_HUB_INTNUMFS                    (1u)
#define USB_HUB_INTNUMHSS                   (1u)
#define USB_HUB_INTNUMHSM                   (1u)

/*  USB Manager mode    */
#define USB_PORTOFF                         (0u)      /* Disconnect(VBUSoff) */
#define USB_DETACHED                        (10u)     /* Disconnect(VBUSon) */
#define USB_ATTACHED                        (20u)     /* Disconnect(HUBdiconfigured) */
#define USB_POWERED                         (30u)     /* Start reset handshake */
#define USB_DEFAULT                         (40u)     /* Set device address */
#define USB_ADDRESS                         (50u)     /* Enumeration start */
#define USB_ENUMERATION                     (60u)     /* Wait device enumeration */
#define USB_CONFIGURED                      (70u)     /* Detach detected */
#define USB_SUSPENDED                       (80u)     /* Device suspended */
#define USB_DETACH_PROCESS                  (101u)    /* Wait device detach */
#define USB_SUSPENDED_PROCESS               (102u)    /* Wait device suspend */
#define USB_RESUME_PROCESS                  (103u)    /* Wait device resume */

/* HCD common task message command */
#define USB_MSG_HCD_ATTACH                  (0x0101u)
#define USB_MSG_HCD_DETACH                  (0x0102u)
#define USB_MSG_HCD_USBRESET                (0x0103u)
#define USB_MSG_HCD_SUSPEND                 (0x0104u)
#define USB_MSG_HCD_RESUME                  (0x0105u)
#define USB_MSG_HCD_REMOTE                  (0x0106u)
#define USB_MSG_HCD_VBON                    (0x0107u)
#define USB_MSG_HCD_VBOFF                   (0x0108u)
#define USB_MSG_HCD_CLR_STALL               (0x0109u)
#define USB_MSG_HCD_DETACH_MGR              (0x010Au)
#define USB_MSG_HCD_ATTACH_MGR              (0x010Bu)

#define USB_MSG_HCD_CLR_STALL_RESULT        (0x010Cu)
#define USB_MSG_HCD_CLR_STALLBIT            (0x010Du)
#define USB_MSG_HCD_SQTGLBIT                (0x010Fu)

/* HCD task message command */
#define USB_MSG_HCD_SETDEVICEINFO           (0x0111u)
#define USB_MSG_HCD_SUBMITUTR               (0x0112u)
#define USB_MSG_HCD_TRANSEND1               (0x0113u)
#define USB_MSG_HCD_TRANSEND2               (0x0114u)
#define USB_MSG_HCD_CLRSEQBIT               (0x0115u)
#define USB_MSG_HCD_SETSEQBIT               (0x0116u)
#define USB_MSG_HCD_INT                     (0x0117u)
#define USB_MSG_HCD_DMAINT                  (0x0119u)

#define USB_MSG_HCD_D0FIFO_INT              (0x0141u)
#define USB_MSG_HCD_D1FIFO_INT              (0x0142u)
#define USB_MSG_HCD_RESM_INT                (0x0143u)
#define USB_MSG_PCD_D0FIFO_INT              (0x0144u)
#define USB_MSG_PCD_D1FIFO_INT              (0x0145u)
#define USB_MSG_PCD_RESM_INT                (0x0146u)

/* USB Manager task message command */
#define USB_MSG_MGR_AORDETACH               (0x0121u)
#define USB_MSG_MGR_OVERCURRENT             (0x0122u)
#define USB_MSG_MGR_STATUSRESULT            (0x0123u)
#define USB_MSG_MGR_SUBMITRESULT            (0x0124u)
#define USB_MSG_MGR_TRANSENDRESULT          (0x0125u)

#define USB_MSG_MGR_SETCONFIGURATION        (0x0300 )
#define USB_MSG_MGR_SETCONFIGURATION_RESULT (0x0301 )

#define USB_MSG_MGR_GETDESCRIPTOR           (0x0400 )
#define USB_MSG_MGR_GETDESCRIPTOR_RESULT    (0x0401 )

/* USB HUB task message command */
#define USB_MSG_HUB_HUB2HUBSTART            (0x0131u)
#define USB_MSG_HUB_START                   (0x0132u)
#define USB_MSG_HUB_STOP                    (0x0133u)
#define USB_MSG_HUB_SUBMITRESULT            (0x0134u)
#define USB_MSG_HUB_EVENT                   (0x0135u) /* nonOS */
#define USB_MSG_HUB_ATTACH                  (0x0136u) /* nonOS */
#define USB_MSG_HUB_RESET                   (0x0137u) /* nonOS */

/* CLS task message command */
#define USB_MSG_CLS_CHECKREQUEST            (0x0201u) /* nonOS */
#define USB_MSG_CLS_INIT                    (0x0202u) /* nonOS */
#define USB_MSG_CLS_TASK                    (0x0203u) /* nonOS */
#define USB_MSG_CLS_WAIT                    (0x0204u) /* nonOS */
#define USB_MSG_CLS_PROCESSRESULT           (0x0205u) /* nonOS */

/* HET task message command */
#define USB_MSG_HET_UACTOFF                 (0x0171u)
#define USB_MSG_HET_UACTON                  (0x0172u)
#define USB_MSG_HET_VBUSOFF                 (0x0173u)
#define USB_MSG_HET_VBUSON                  (0x0174u)
#define USB_MSG_HET_RESET                   (0x0175u)
#define USB_MSG_HET_SUSPEND                 (0x0176u)
#define USB_MSG_HET_RESUME                  (0x0177u)
#define USB_MSG_HET_ENUMERATION             (0x0178u)
#define USB_MSG_HET_TESTNONE                (0x0181u)
#define USB_MSG_HET_TESTPACKET              (0x0182u)
#define USB_MSG_HET_TESTJ                   (0x0183u)
#define USB_MSG_HET_TESTK                   (0x0184u)
#define USB_MSG_HET_TESTSE0                 (0x0185u)
#define USB_MSG_HET_TESTSIGSTOP             (0x0186u)
#define USB_MSG_HET_SINGLESETUP             (0x0187u)
#define USB_MSG_HET_SINGLEDATA              (0x0188u)

/* Descriptor index */
#define USB_DEV_MAX_PKT_SIZE                (7u)  /* Index of bMAXPacketSize */
#define USB_DEV_NUM_CONFIG                  (17u) /* Index of bNumConfigurations */
#define USB_ALT_NO                          (255u)
#define USB_SOFT_CHANGE                     (0u)

/* USB Peripheral task message command */
#define USB_MSG_PCD_INT                     (0x0151u)
#define USB_MSG_PCD_SUBMITUTR               (0x0152u)
#define USB_MSG_PCD_TRANSEND1               (0x0153u)
#define USB_MSG_PCD_TRANSEND2               (0x0154u)
#define USB_MSG_PCD_REMOTEWAKEUP            (0x0155u)
#define USB_MSG_PCD_DETACH                  (0x0161u)
#define USB_MSG_PCD_ATTACH                  (0x0162u)
#define USB_MSG_PCD_CLRSEQBIT               (0x0163u)
#define USB_MSG_PCD_SETSTALL                (0x0164u)
#define USB_MSG_PCD_PCUTINT                 (0x0156u)

#define USB_MSG_PCD_DP_ENABLE               (0x0157u)
#define USB_MSG_PCD_DP_DISABLE              (0x0158u)
#define USB_MSG_PCD_DM_ENABLE               (0x0159u)
#define USB_MSG_PCD_DM_DISABLE              (0x015Au)

#define USB_MSG_PCD_DMAINT                  (0x015bu)

#define USB_DO_REMOTEWAKEUP                 (USB_MSG_PCD_REMOTEWAKEUP)
#define USB_DP_ENABLE                       (USB_MSG_PCD_DP_ENABLE)
#define USB_DP_DISABLE                      (USB_MSG_PCD_DP_DISABLE)
#define USB_DM_ENABLE                       (USB_MSG_PCD_DM_ENABLE)
#define USB_DM_DISABLE                      (USB_MSG_PCD_DM_DISABLE)

#define USB_DO_STALL                        (USB_MSG_PCD_SETSTALL)

#define USB_DO_RESET_AND_ENUMERATION        (0x0202u) /* USB_MSG_HCD_ATTACH */
#define USB_PORT_ENABLE                     (0x0203u) /* USB_MSG_HCD_VBON */
#define USB_PORT_DISABLE                    (0x0204u) /* USB_MSG_HCD_VBOFF */
#define USB_DO_GLOBAL_SUSPEND               (0x0205u) /* USB_MSG_HCD_SUSPEND */
#define USB_DO_SELECTIVE_SUSPEND            (0x0206u) /* USB_MSG_HCD_SUSPEND */
#define USB_DO_GLOBAL_RESUME                (0x0207u) /* USB_MSG_HCD_RESUME */
#define USB_DO_SELECTIVE_RESUME             (0x0208u) /* USB_MSG_HCD_RESUME */
#define USB_DO_CLR_STALL                    (0x0209u) /* USB_MSG_HCD_CLR_STALL */
#define USB_DO_SET_SQTGL                    (0x020Au) /* USB_MSG_HCD_SQTGLBIT */
#define USB_DO_CLR_SQTGL                    (0x020Bu) /* USB_MSG_HCD_CLRSEQBIT */

/* BC State Define */
#define USB_BC_STATE_INIT                   (0x00u)
#define USB_BC_STATE_DET                    (0x01u)
#define USB_BC_STATE_CDP                    (0x02u)
#define USB_BC_STATE_SDP                    (0x03u)
#define USB_BC_STATE_DCP                    (0x04u)
#define USB_BC_STATE_MAX                    (0x05u)

/* BC State Change Event Define */
#define USB_BC_EVENT_VB                     (0x00u)
#define USB_BC_EVENT_AT                     (0x01u)
#define USB_BC_EVENT_DT                     (0x02u)
#define USB_BC_EVENT_MAX                    (0x03u)

/* DCP Mode Setting Define */
#define USB_BC_DCPMODE                      (0x01u)
/*#define USB_BC_DCPMODE                      (0x00u)*/

#define USB_NOT_BC                          (0xFFFEu)

/*************************************************************************
 old basic_cfg.h #define
 *************************************************************************/
#define USB_SND_MSG(ID, MESS)           (usb_cstd_snd_msg((uint8_t)(ID), (usb_msg_t*)(MESS)))
#define USB_ISND_MSG(ID, MESS)          (usb_cstd_isnd_msg((uint8_t)(ID), (usb_msg_t*)(MESS)))
#define USB_WAI_MSG(ID, MESS, TM)       (usb_cstd_wai_msg((uint8_t)(ID), (usb_msg_t*)(MESS), (usb_tm_t)(TM)))
#define USB_RCV_MSG(ID, MESS)           (usb_cstd_rec_msg((uint8_t)(ID), (usb_msg_t**)(MESS), (usb_tm_t)(0u)))
#define USB_TRCV_MSG(ID, MESS, TM)      (usb_cstd_rec_msg((uint8_t)(ID), (usb_msg_t**)(MESS), (usb_tm_t)(TM)))

#define USB_PGET_BLK(ID, BLK)           (usb_cstd_pget_blk((uint8_t)(ID),(usb_utr_t**)(BLK)))
#define USB_REL_BLK(ID, BLK)            (usb_cstd_rel_blk((uint8_t)(ID), (usb_utr_t*)(BLK)))

/* Descriptor size */
#define USB_DEVICESIZE                  (20u)   /* Device Descriptor size */
#define USB_CONFIGSIZE                  (256u)  /* Configuration Descriptor size */

/* Number of software retries when a no-response condition occurs during a transfer */
#define USB_PIPEERROR                   (1u)

/** [Output debugging message in a console of IDE.]
 *   not defined(USB_DEBUG_ON) : No output the debugging message
 *   defined(USB_DEBUG_ON)     : Output the debugging message
 */
#if defined(USB_DEBUG_ON)
    #define USB_PRINTF0(FORM)                           (printf(FORM))
    #define USB_PRINTF1(FORM,x1)                        (printf((FORM), (x1)))
    #define USB_PRINTF2(FORM,x1,x2)                     (printf((FORM), (x1), (x2)))
    #define USB_PRINTF3(FORM,x1,x2,x3)                  (printf((FORM), (x1), (x2), (x3)))
    #define USB_PRINTF4(FORM,x1,x2,x3,x4)               (printf((FORM), (x1), (x2), (x3), (x4)))
    #define USB_PRINTF5(FORM,x1,x2,x3,x4,x5)            (printf((FORM), (x1), (x2), (x3), (x4), (x5)))
    #define USB_PRINTF6(FORM,x1,x2,x3,x4,x5,x6)         (printf((FORM), (x1), (x2), (x3), (x4), (x5), (x6)))
    #define USB_PRINTF7(FORM,x1,x2,x3,x4,x5,x6,x7)      (printf((FORM), (x1), (x2), (x3), (x4), (x5), (x6), (x7)))
    #define USB_PRINTF8(FORM,x1,x2,x3,x4,x5,x6,x7,x8)   (printf((FORM), (x1), (x2), (x3), (x4), (x5), (x6), (x7), (x8)))
#else   /* defined(USB_DEBUG_ON) */
    #define USB_PRINTF0(FORM)
    #define USB_PRINTF1(FORM,x1)
    #define USB_PRINTF2(FORM,x1,x2)
    #define USB_PRINTF3(FORM,x1,x2,x3)
    #define USB_PRINTF4(FORM,x1,x2,x3,x4)
    #define USB_PRINTF5(FORM,x1,x2,x3,x4,x5)
    #define USB_PRINTF6(FORM,x1,x2,x3,x4,x5,x6)
    #define USB_PRINTF7(FORM,x1,x2,x3,x4,x5,x6,x7)
    #define USB_PRINTF8(FORM,x1,x2,x3,x4,x5,x6,x7,x8)
#endif  /* defined(USB_DEBUG_ON) */

#endif  /* R_USB_BASIC_DEFINE_H */
/******************************************************************************
 End  Of File
 ******************************************************************************/
