hirakuni45/RX/FreeRTOS_TCP/main.cpp

//=====================================================================//
/*! @file
    @brief  FreeRTOS_TCP TCP sample @n
			RX64M, RX71M, RX72M: @n
					12MHz のベースクロックを使用する @n
			　　　　P07 ピンにLEDを接続する @n
			RX65N (Renesas Envision kit RX65N): @n
					12MHz のベースクロックを使用する @n
			　　　　P70 に接続された LED を利用する @n
			RX72N: (Renesas Envision kit RX72N) @n
					16MHz のベースクロックを使用する @n
					P40 ピンにLEDを接続する
    @author 平松邦仁 (hira@rvf-rc45.net)
	@copyright	Copyright (C) 2020 Kunihito Hiramatsu @n
				Released under the MIT license @n
				https://github.com/hirakuni45/RX/blob/master/LICENSE
*/
//=====================================================================//
#include "common/renesas.hpp"

#include "common/fixed_fifo.hpp"
#include "common/sci_io.hpp"
#include "common/cmt_mgr.hpp"

#include "common/format.hpp"
#include "common/input.hpp"

#include "chip/phy_base.hpp"

#include "FreeRTOS.h"
// #include "task.h"
// #include "FreeRTOS_IP.h"

#include <random>

#ifdef SIG_RX64M
// GR-KAEDE の場合有効にする
// #define GR_KAEDE
#endif

namespace {

/// ベースクリスタルの定義
/// LED 接続ポートの定義
#if defined(SIG_RX71M)
	static const char* system_str_ = { "RX71M" };
	typedef device::PORT<device::PORT0, device::bitpos::B7> LED;
	typedef device::SCI1 SCI_CH;
    typedef device::ETHERC0 ETHERC;      // Ethernet Controller
    typedef device::EDMAC0 EDMAC;        // Ethernet DMA Controller
	// Ethernet PHY device
    typedef chip::phy_base<ETHERC, chip::phy_device::LAN8720, chip::phy_interface::RMII> PHY;
	// Ethernet MAC device
    typedef device::ether_io<ETHERC, EDMAC, PHY, device::port_map_order::ether_rmii_t> ETHD;
#elif defined(SIG_RX72M)
	static const char* system_str_ = { "RX72M" };
	typedef device::PORT<device::PORT0, device::bitpos::B7> LED;
	typedef device::SCI1 SCI_CH;
#elif defined(SIG_RX64M)

#ifdef GR_KAEDE
	static const char* system_str_ = { "GR-KAEDE" };
	typedef device::PORT<device::PORTC, device::bitpos::B1> LED;
	typedef device::PORT<device::PORTC, device::bitpos::B0> LED2;
	typedef device::SCI7 SCI_CH;
#else
	static const char* system_str_ = { "RX64M" };
	typedef device::PORT<device::PORT0, device::bitpos::B7> LED;
	typedef device::SCI1 SCI_CH;
#endif
#elif defined(SIG_RX65N)
	static const char* system_str_ = { "RX65N Envision Kit" };
	typedef device::PORT<device::PORT7, device::bitpos::B0> LED;
	typedef device::SCI9 SCI_CH;
#elif defined(SIG_RX72N)
	static const char* system_str_ = { "RX72N Envision Kit" };
	typedef device::PORT<device::PORT4, device::bitpos::B0> LED;
	typedef device::SCI2 SCI_CH;
#endif

	typedef device::cmt_mgr<device::CMT0> CMT;
	CMT		cmt_;

	typedef utils::fixed_fifo<char, 512> RXB;  // RX (RECV) バッファの定義
	typedef utils::fixed_fifo<char, 256> TXB;  // TX (SEND) バッファの定義

	typedef device::sci_io<SCI_CH, RXB, TXB> SCI;
	SCI		sci_;

	std::mt19937 mrand_;    // メルセンヌ・ツイスタの32ビット版

    ETHD    ethd_;
}

extern "C" {

	// syscalls.c から呼ばれる、標準出力（stdout, stderr）
	void sci_putch(char ch)
	{
		static volatile bool lock_ = false;
		while(lock_) ;
		lock_ = true;
		sci_.putch(ch);
		lock_ = false;
	}


	void sci_puts(const char* str)
	{
		static volatile bool lock_ = false;
		while(lock_) ;
		lock_ = true;
		sci_.puts(str);
		lock_ = false;
	}


	// syscalls.c から呼ばれる、標準入力（stdin）
	char sci_getch(void)
	{
		static volatile bool lock_ = false;
		while(lock_) ;
		lock_ = true;
		auto ch = sci_.getch();
		lock_ = false;
		return ch;
	}


	uint16_t sci_length()
	{
		return sci_.recv_length();
	}


	void vApplicationMallocFailedHook(void)
	{
		/* Called if a call to pvPortMalloc() fails because there is insufficient
		free memory available in the FreeRTOS heap.  pvPortMalloc() is called
		internally by FreeRTOS API functions that create tasks, queues, software
		timers, and semaphores.  The size of the FreeRTOS heap is set by the
		configTOTAL_HEAP_SIZE configuration constant in FreeRTOSConfig.h. */
		taskDISABLE_INTERRUPTS();
		for( ;; );
	}


	void vApplicationStackOverflowHook(TaskHandle_t pxTask, char *pcTaskName)
	{
		( void ) pcTaskName;
		( void ) pxTask;

		/* Run time stack overflow checking is performed if
		configCHECK_FOR_STACK_OVERFLOW is defined to 1 or 2.  This hook
		function is called if a stack overflow is detected. */
		taskDISABLE_INTERRUPTS();
		for( ;; );
	}


	void vApplicationIdleHook(void)
	{
///		volatile size_t xFreeHeapSpace;

		/* This is just a trivial example of an idle hook.  It is called on each
		cycle of the idle task.  It must *NOT* attempt to block.  In this case the
		idle task just queries the amount of FreeRTOS heap that remains.  See the
		memory management section on the http://www.FreeRTOS.org web site for memory
		management ORDERs.  If there is a lot of heap memory free then the
		configTOTAL_HEAP_SIZE value in FreeRTOSConfig.h can be reduced to free up
		RAM. */
///		xFreeHeapSpace = xPortGetFreeHeapSize();

		/* Remove compiler warning about xFreeHeapSpace being set but never used. */
///		( void ) xFreeHeapSpace;
	}


	void vApplicationTickHook(void)
	{
	}


	void vAssertCalled(void)
	{
		volatile unsigned long ul = 0;

		taskENTER_CRITICAL();
		{
			/* Use the debugger to set ul to a non-zero value in order to step out
			of this function to determine why it was called. */
			while( ul == 0 )
			{
				portNOP();
			}
		}
		taskEXIT_CRITICAL();
	}

	extern void vTickISR(void);
	extern void vSoftwareInterruptISR(void);

	void vApplicationSetupTimerInterrupt(void)
	{
		auto intr = static_cast<device::ICU::LEVEL>(configKERNEL_INTERRUPT_PRIORITY);
		cmt_.start(configTICK_RATE_HZ, intr, vTickISR);

		device::icu_mgr::set_task(device::ICU::VECTOR::SWINT, vSoftwareInterruptISR);
		device::icu_mgr::set_level(device::ICU::VECTOR::SWINT, intr);
	}


	//--------------------------------------------------------------------------//
	//
	// FreeRTOS+TCP 関係のバインドコード
	//
	//--------------------------------------------------------------------------//
	/// Ethernet の開始
	int InitializeEth()
    {
		// Microchip PHY: LAN8720 connected
		device::port_map_order::ether_rmii_t et;
		et.mdc_     = device::port_map_order::ORDER::FIRST;
		et.mdio_    = device::port_map_order::ORDER::FIRST;
		et.ref50ck_ = device::port_map_order::ORDER::FIRST;
		et.crs_dv_  = device::port_map_order::ORDER::FIRST;
		et.txd0_    = device::port_map_order::ORDER::FIRST;
		et.txd1_    = device::port_map_order::ORDER::FIRST;
		et.rxd0_    = device::port_map_order::ORDER::FIRST;
		et.rxd1_    = device::port_map_order::ORDER::FIRST;
		et.txd_en_  = device::port_map_order::ORDER::FIRST;
		et.rx_er_   = device::port_map_order::ORDER::FIRST;
		auto intr_level = device::ICU::LEVEL::_4;
		if(!ethd_.start(et, intr_level)) {
			utils::format("Ethernet start fail...\n");
			return 0;
		}

		static const uint8_t mac[6] = { 0xDE, 0xAD, 0xBE, 0xEF, 0xFE, 0xED };
		if(!ethd_.open(mac)) {
			utils::format("Ethernet open fail...\n");
			return 0;
		}

		return 1;
	}


	int GetLinkStatusPHY(void)
	{
		return ethd_.at_phy().get_link_status();
	}

#if 0
	/* DHCP has an ORDER for clients to register their hostname.  It doesn't
	 * have much use, except that a device can be found in a router along with its
	 * name. If this ORDER is used the callback below must be provided by the
	 * application writer to return a const string, denoting the device's name. */
	/* Typically this function is defined in a user module. */
	const char* pcApplicationHostnameHook( void )
	{
		return system_str_;
	}


	/* This xApplicationGetRandomNumber() will set *pulNumber to a random number,
	 * and return pdTRUE. When the random number generator is broken, it shall return
	 * pdFALSE.
	 * The function is defined in 'iot_secure_sockets.c'.
	 * If that module is not included in the project, the application must provide an
	 * implementation of it.
	 * The macro's ipconfigRAND32() and configRAND32() are not in use anymore. */

	/* "xApplicationGetRandomNumber" is declared but never defined, because it may
	 * be defined in a user module. */
    BaseType_t xApplicationGetRandomNumber( uint32_t * pulNumber )
	{
		uint32_t n = mrand_();
		*pulNumber = n;
		return pdTRUE;
	}


	/*
	 * Generate a randomized TCP Initial Sequence Number per RFC.
	 * This function must be provided by the application builder.
	 */
	/* This function is defined generally by the application. */
    uint32_t ulApplicationGetNextSequenceNumber( uint32_t ulSourceAddress,
                                                 uint16_t usSourcePort,
                                                 uint32_t ulDestinationAddress,
                                                 uint16_t usDestinationPort )
	{
		// See. RFC6528
		uint32_t sn = mrand_();
		sn ^= cmt_.get_counter();
		sn ^= ulSourceAddress;
		sn ^= (usSourcePort << 16) | usDestinationPort;
		sn ^= ulDestinationAddress;
		return sn;
	}


	void vApplicationIPNetworkEventHook( eIPCallbackEvent_t eNetworkEvent )
	{
	}
#endif
};


namespace {

	void vTask1(void *pvParameters)
	{
		uint32_t loop = 0;
		uint32_t cnt = 0;
		while(1) {
			vTaskEnterCritical();
			LED::P = !LED::P();
			vTaskExitCritical();
			vTaskDelay(500 / portTICK_PERIOD_MS);
			++loop;
			if(loop >= 10) {
				loop = 0;
				utils::format("Task1: %u\n") % cnt;
				++cnt;
			}
		}
	}


	void vTask2(void *pvParameters)
	{
		uint32_t loop = 0;
		uint32_t cnt = 0;
		while(1) {
			vTaskEnterCritical();
#ifdef GR_KAEDE
			LED2::P = !LED2::P();
#else
			LED::P = !LED::P();
#endif
			vTaskExitCritical();
			vTaskDelay(100 / portTICK_PERIOD_MS);
			++loop;
			if(loop >= 12) {
				loop = 0;
				utils::format("Task2: %u\n") % cnt;
				++cnt;
			}
		}
	}
}


int main(int argc, char** argv);

int main(int argc, char** argv)
{
	SYSTEM_IO::boost_master_clock();

	LED::OUTPUT();  // LED ポートを出力に設定
	LED::P = 1;		// Off
#ifdef GR_KAEDE
	LED2::OUTPUT();
	LED2::P = 1;
#endif

	{  // SCI の開始
		auto intr = device::ICU::LEVEL::_2;
		uint32_t baud = 115200;  // ボーレート
		sci_.start(baud, intr);
	}

	{  // 乱数生成器に初期値を与える
	    mrand_.seed(0x1234);
	}

	auto clk = device::clock_profile::ICLK / 1'000'000;
	utils::format("Start FreeRTOS %s + TCP, sample for '%s' %d[MHz]\n")
		% tskKERNEL_VERSION_NUMBER % system_str_ % clk;

	{
		uint32_t stack_size = 2048;
		void* param = nullptr;
		uint32_t prio = 1;
		xTaskCreate(vTask1, "Task1", stack_size, param, prio, nullptr);
		xTaskCreate(vTask2, "Task2", stack_size, param, prio, nullptr);
	}

	vTaskStartScheduler();

	// タスクスケジューラーが正常なら実行されない
	utils::format("FreeRTOS Stalled...\n");
	while(1) {
		utils::delay::milli_second(250);
		LED::P = !LED::P();
		utils::delay::milli_second(250);
		LED::P = !LED::P();
	}
}
