hirakuni45/RX/GR-KAEDE_ftps/main.cpp

//=====================================================================//
/*! @file
    @brief  GR-KAEDE(RX64M) http_server サンプル @n
			Copyright 2017 Kunihito Hiramatsu
    @author 平松邦仁 (hira@rvf-rc45.net)
*/
//=====================================================================//
#include "common/renesas.hpp"

#include "common/cmt_io.hpp"
#include "common/sci_io.hpp"
#include "common/rspi_io.hpp"
#include "common/sdc_io.hpp"
#include "common/fixed_fifo.hpp"
#include "common/format.hpp"
#include "common/input.hpp"
#include "common/time.h"

#include "r_net/ethernet.hpp"
#include "r_net/ftp_server.hpp"

extern "C" {
	void INT_Excep_ICU_GROUPAL1(void);
}

namespace {

	typedef device::system_io<12000000> SYSTEM_IO;

	class cmt_task {
		void (*task_10ms_)();

		volatile unsigned long millis_;
		volatile unsigned long delay_;
		volatile uint32_t millis10x_;
		volatile uint32_t cmtdiv_;

	public:
		cmt_task() : task_10ms_(nullptr),
			millis_(0), delay_(0), millis10x_(0), cmtdiv_(0) { }

		void operator() () {

			++millis_;
			++cmtdiv_;
			if(cmtdiv_ >= 10) {
				if(task_10ms_ != nullptr) (*task_10ms_)();
				cmtdiv_ = 0;
				++millis10x_;
			}
			if(delay_) {
				--delay_;
			}
			
		}

		void set_task_10ms(void (*task)(void)) {
			task_10ms_ = task;
		}

		void sync_100hz()
		{
			volatile uint32_t tmp = millis10x_;
			while(tmp == millis10x_) ;
		}

		volatile unsigned long get_millis() const { return millis_; }

		volatile unsigned long get_delay() const { return delay_; }

		void set_delay(volatile unsigned long n) { delay_ = n; }
	};

	typedef device::cmt_io<device::CMT0, cmt_task> CMT0;
	CMT0	cmt0_;

	typedef utils::fixed_fifo<char, 2048> BUFFER;

	typedef device::sci_io<device::SCI7, BUFFER, BUFFER> SCI;
	SCI		sci_;

	// SDC 用　SPI 定義（RSPI）
	typedef device::rspi_io<device::RSPI> SPI;
	typedef device::PORT<device::PORTC, device::bitpos::B4> SDC_SELECT;	///< カード選択信号
	typedef device::NULL_PORT  SDC_POWER;	///< カード電源制御（常に電源ＯＮ）
	typedef device::PORT<device::PORTB, device::bitpos::B7> SDC_DETECT;	///< カード検出

	SPI		spi_;

	typedef utils::sdc_io<SPI, SDC_SELECT, SDC_POWER, SDC_DETECT> SDC;
	SDC		sdc_(spi_, 20000000);

	typedef utils::rtc_io RTC;
	RTC		rtc_;

	net::ethernet		ethernet_;

	typedef net::ftp_server<SDC> FTP_SERVER;
	FTP_SERVER			ftp_(ethernet_, sdc_);
	

	//-----------------------------------------------------------------//
	/*!
		@brief  GMT 時間の設定
		@param[in]	t	GMT 時間
	*/
	//-----------------------------------------------------------------//
	void set_time(time_t t)
	{
		if(!rtc_.set_time(t)) {
			utils::format("Stall RTC write...\n");
		}
	}


#if 0
	//-----------------------------------------------------------------//
	/*!
		@brief  時間の表示
		@param[in]	t		時間
		@param[in]	dst		出力文字列
		@param[in]	size	文字列の大きさ
		@return 生成された文字列の長さ
	*/
	//-----------------------------------------------------------------//
	int disp_time(time_t t, char* dst, uint32_t size)
	{
		struct tm *m = localtime(&t);
		int n = (utils::format("%s %s %d %02d:%02d:%02d  %4d", dst, size)
			% get_wday(m->tm_wday)
			% get_mon(m->tm_mon)
			% static_cast<uint32_t>(m->tm_mday)
			% static_cast<uint32_t>(m->tm_hour)
			% static_cast<uint32_t>(m->tm_min)
			% static_cast<uint32_t>(m->tm_sec)
			% static_cast<uint32_t>(m->tm_year + 1900)).get_length();
		return n;
	}
#endif
}

extern "C" {

	//-----------------------------------------------------------------//
	/*!
		@brief  GMT 時間の取得
		@return GMT 時間
	*/
	//-----------------------------------------------------------------//
	time_t get_time()
	{
		time_t t = 0;
		rtc_.get_time(t);
		return t;
	}


	//-----------------------------------------------------------------//
	/*!
		@brief  システム・文字出力
		@param[in]	ch	文字
	*/
	//-----------------------------------------------------------------//
	void sci_putch(char ch)
	{
		sci_.putch(ch);
	}


	//-----------------------------------------------------------------//
	/*!
		@brief  システム・文字列出力
		@param[in]	s	文字列
	*/
	//-----------------------------------------------------------------//
	void sci_puts(const char* s)
	{
		sci_.puts(s);
	}


	//-----------------------------------------------------------------//
	/*!
		@brief  システム・文字入力
		@return	文字
	*/
	//-----------------------------------------------------------------//
	char sci_getch(void)
	{
		return sci_.getch();
	}


	//-----------------------------------------------------------------//
	/*!
		@brief  システム・文字列長の取得
		@return	文字列長
	*/
	//-----------------------------------------------------------------//
	uint16_t sci_length(void)
	{
		return sci_.recv_length();
	}


	//-----------------------------------------------------------------//
	/*!
		@brief	FatFs へ初期化関数を提供
		@param[in]	drv		Physical drive nmuber (0)
		@return ステータス
	 */
	//-----------------------------------------------------------------//
	DSTATUS disk_initialize(BYTE drv) {
		return sdc_.at_mmc().disk_initialize(drv);
	}


	//-----------------------------------------------------------------//
	/*!
		@brief	FatFs へステータスを提供
		@param[in]	drv		Physical drive nmuber (0)
	 */
	//-----------------------------------------------------------------//
	DSTATUS disk_status(BYTE drv) {
		return sdc_.at_mmc().disk_status(drv);
	}


	//-----------------------------------------------------------------//
	/*!
		@brief	FatFs へリード・セクターを提供
		@param[in]	drv		Physical drive nmuber (0)
		@param[out]	buff	Pointer to the data buffer to store read data
		@param[in]	sector	Start sector number (LBA)
		@param[in]	count	Sector count (1..128)
		@return リザルト
	 */
	//-----------------------------------------------------------------//
	DRESULT disk_read(BYTE drv, BYTE* buff, DWORD sector, UINT count) {
		return sdc_.at_mmc().disk_read(drv, buff, sector, count);
	}


	//-----------------------------------------------------------------//
	/*!
		@brief	FatFs へライト・セクターを提供
		@param[in]	drv		Physical drive nmuber (0)
		@param[in]	buff	Pointer to the data to be written	
		@param[in]	sector	Start sector number (LBA)
		@param[in]	count	Sector count (1..128)
		@return リザルト
	 */
	//-----------------------------------------------------------------//
	DRESULT disk_write(BYTE drv, const BYTE* buff, DWORD sector, UINT count) {
		return sdc_.at_mmc().disk_write(drv, buff, sector, count);
	}


	//-----------------------------------------------------------------//
	/*!
		@brief	FatFs へI/O コントロールを提供
		@param[in]	drv		Physical drive nmuber (0)
		@param[in]	ctrl	Control code
		@param[in]	buff	Buffer to send/receive control data
		@return リザルト
	 */
	//-----------------------------------------------------------------//
	DRESULT disk_ioctl(BYTE drv, BYTE ctrl, void* buff) {
		return sdc_.at_mmc().disk_ioctl(drv, ctrl, buff);
	}


	//-----------------------------------------------------------------//
	/*!
		@brief	FatFs へ時間を提供
		@return FatFs 時間
	 */
	//-----------------------------------------------------------------//
	DWORD get_fattime(void) {
		auto t = get_time();
		return utils::str::get_fattime(t);
	}


	unsigned long millis(void)
	{
		return cmt0_.at_task().get_millis();
	}


	void delay(unsigned long ms)
	{
		cmt0_.at_task().set_delay(ms);
		while(cmt0_.at_task().get_delay() != 0) ;		
	}


	void set_task_10ms(void (*task)(void)) {
		cmt0_.at_task().set_task_10ms(task);
	}


}

int main(int argc, char** argv);

int main(int argc, char** argv)
{
	device::PORT3::PCR.B5 = 1; // P35(NMI) pull-up

	// GR-KAEDE の SPI 端子のハードバグ回避
	// ※PC3 から、PC7 へ １K オームで接続
	device::PORTC::PDR.B3 = 1; // output
	device::PORTC::PODR.B3 = 1;

	SYSTEM_IO::setup_system_clock();

	{  // タイマー設定、１０００Ｈｚ（１ｍｓ）
		uint8_t int_level = 1;
		cmt0_.start(1000, int_level);
	}

	{  // SCI 設定
		uint8_t int_level = 2;
		sci_.start(115200, int_level);
	}

	{
		utils::format("\nStart GR-KAEDE ftp sample\n");
		uint8_t mde = device::SYSTEM::MDE.MDE();
		utils::format("Endian: %3b (%s)") % static_cast<uint32_t>(mde) % (mde == 0b111 ? "Little" : "Big");
		utils::format(", PCLKA: %u [Hz]") % static_cast<uint32_t>(F_PCLKA);
		utils::format(", PCLKB: %u [Hz]\n") % static_cast<uint32_t>(F_PCLKB);
	}

	// SD カード・クラスの初期化
	sdc_.start();

	device::power_mgr::turn(device::peripheral::ETHERC0);
	device::port_map::turn(device::peripheral::ETHERC0);

	set_interrupt_task(INT_Excep_ICU_GROUPAL1, static_cast<uint32_t>(device::ICU::VECTOR::GROUPAL1));

	ethernet_.start();

	{
		static const uint8_t mac[6] = { 0xDE, 0xAD, 0xBE, 0xEF, 0xFE, 0xED };
		net::ip_address ipa(192, 168, 0, 33);
		bool dhcp = true;
		if(dhcp) {
			if(ethernet_.begin(mac) == 0) {
				utils::format("Ethernet Fail: begin (DHCP)...\n");
				utils::format("SetIP: ");
				ethernet_.begin(mac, ipa);
			} else {
				utils::format("DHCP: ");
			}
		} else {
			ethernet_.begin(mac, ipa);
			utils::format("SetIP: ");
		}
		utils::format("%s\n") % ethernet_.get_local_ip().c_str();
	}

	ftp_.start("GR-KAEDE", "Renesas_RX64M", "KAEDE", "KAEDE");

	uint32_t cnt = 0;
	while(1) {
		cmt0_.at_task().sync_100hz();

		ethernet_.service();

		ftp_.service(100);

		sdc_.service();

		++cnt;
		if(cnt >= 30) {
			cnt = 0;
		}

		device::PORTC::PDR.B0 = 1; // output
		device::PORTC::PODR.B0 = (cnt < 10) ? 0 : 1;
	}
}
