hirakuni45/RX/RX24T/rx24t_LOGGER/main.cpp

//=====================================================================//
/*! @file
    @brief  RX24T データ・ロガー @n
			・P00(4) ピンに赤色LED（VF:1.9V）を吸い込みで接続する
    @author 平松邦仁 (hira@rvf-rc45.net)
	@copyright	Copyright (C) 2017 Kunihito Hiramatsu @n
				Released under the MIT license @n
				https://github.com/hirakuni45/RX/blob/master/LICENSE
*/
//=====================================================================//
#if 0
#include "main.hpp"

#include "common/scene.hpp"
#include "title.hpp"
#include "root_menu.hpp"
#include "logging.hpp"
#include "recall.hpp"
#include "setup.hpp"
#include "laptimer.hpp"

namespace {

	core_t	core_;

	typedef utils::scene_director<title, root_menu, logging, recall, setup, laptime> SCENES;
	SCENES	scenes_;

}


//---------------------------------------------------------------------//
/*!
	@brief	シーンを選択
	@param[in]	id	シーンＩＤ
*/
//---------------------------------------------------------------------//
void select_scene(app::scene_id id)
{
	switch(id) {
	case app::scene_id::title:
		scenes_.change<title>();
		break;
	case app::scene_id::root_menu:
		scenes_.change<root_menu>();
		break;
	case app::scene_id::logging:
		scenes_.change<logging>();
		break;
	case app::scene_id::recall:
		scenes_.change<recall>();
		break;
	case app::scene_id::setup:
		scenes_.change<setup>();
		break;
	case app::scene_id::laptimer:
		scenes_.change<laptimer>();
		break;
	default:
		break;
	}
}


//---------------------------------------------------------------------//
/*!
	@brief	コアの参照
	@return コア
*/
//---------------------------------------------------------------------//
core_t& at_core()
{
	return core_;
}


extern "C" {

	void sci_putch(char ch)
	{
		core_.sci1_.putch(ch);
	}

	void sci_puts(const char* str)
	{
		core_.sci1_.puts(str);
	}

	char sci_getch(void)
	{
		return core_.sci1_.getch();
	}

	uint16_t sci_length()
	{
		return core_.sci1_.recv_length();
	}

	void laptimer_service(uint8_t pitflag)
	{
		laptimer_.laptimer_service(pitflag);
	}

	DSTATUS disk_initialize(BYTE drv) {
		return core_.sdc_.at_mmc().disk_initialize(drv);
	}

	DSTATUS disk_status(BYTE drv) {
		return core_.sdc_.at_mmc().disk_status(drv);
	}

	DRESULT disk_read(BYTE drv, BYTE* buff, DWORD sector, UINT count) {
		return core_.sdc_.at_mmc().disk_read(drv, buff, sector, count);
	}

	DRESULT disk_write(BYTE drv, const BYTE* buff, DWORD sector, UINT count) {
		return core_.sdc_.at_mmc().disk_write(drv, buff, sector, count);
	}

	DRESULT disk_ioctl(BYTE drv, BYTE ctrl, void* buff) {
		return core_.sdc_.at_mmc().disk_ioctl(drv, ctrl, buff);
	}

	DWORD get_fattime(void) {
		time_t t = 0;
#if 0
		if(!rtc_.get_time(t)) {
			utils::format("Stall RTC read (%d)\n") % static_cast<uint32_t>(i2c_.get_last_error());
		}
#endif
		return utils::str::get_fattime(t);
	}

	void utf8_to_sjis(const char* src, char* dst, uint32_t len) {
		utils::str::utf8_to_sjis(src, dst, len);
	}
}
#endif

int main(int argc, char** argv);

int main(int argc, char** argv)
{
#if 0
	core_.init();

	core_.init_device();

	utils::format("G.P.S. Logger\n");
	core_.command_.set_prompt("# ");

	typedef device::PORT<device::PORT0, device::bitpos::B0> LED;
	LED::DIR = 1;

	select_scene(app::scene_id::title);

	uint32_t cnt = 0;
	while(1) {
		core_.cmt_.at_task().sync3();

		core_.adc_io_.scan();
		core_.adc_io_.sync();

		// ４つのスイッチ判定（排他的）
		auto val = core_.adc_io_.get(core_t::ADC::analog::AIN000);
		val += 512;  // 閾値のオフセット（4096 / 4(SWITCH) / 2）
		val /= 1024;  // デコード（4096 / 4(SWITCH）

		core_t::switch_bits tmp;
		if(val < 4) {
			tmp.set(static_cast<core_t::SWITCH>(val));
		}
		core_.switch_man_.service(tmp);
		core_.menu_item_service();

		auto f = core_.nmea_.service();
		if(f) {
			utils::format("%s: ") % core_.nmea_.get_satellite();
			utils::format("D/T: %s %s, ") % core_.nmea_.get_date() % core_.nmea_.get_time();
			utils::format("Lat: %s, ") % core_.nmea_.get_lat();
			utils::format("Lon: %s, ") % core_.nmea_.get_lon();
			utils::format("Alt: %s [%s]\n") % core_.nmea_.get_altitude() % core_.nmea_.get_altitude_unit();
		};

		core_.sdc_.service();

		{
			if(core_.fbc_enable_) {
				core_.bitmap_.clear(0);
			}
			scene_.service();
			// LCD 用速度と設定
////			core_.spi_.start(8000000, core_t::SPI::PHASE::TYPE4, core_t::SPI::DLEN::W8);
			core_.lcd_.copy(core_.bitmap_.fb(), core_.bitmap_.page_num());
////			core_.sdc_.setup_speed();  //  SDC 用速度と設定
		}

		++core_.loop_count_;

		++cnt;
		if(cnt >= 15) {
			cnt = 0;
		}
		LED::P = (cnt < 5) ? 0 : 1;
	}
#endif
}
