hirakuni45/RX/r_net/ethernet.hpp

#pragma once
//=====================================================================//
/*!	@file
	@brief	ethernet class
    @author 平松邦仁 (hira@rvf-rc45.net)
	@copyright	Copyright (C) 2017 Kunihito Hiramatsu @n
				Released under the MIT license @n
				https://github.com/hirakuni45/RX/blob/master/LICENSE
*/
//=====================================================================//
#include <cstdio>
#include <cstring>

#include "ip_address.hpp"

#include "T4_src/type.h"
#include "T4_src/config_tcpudp.h"
#include "T4_src/r_t4_dhcp_client_rx_if.h"
#include "T4_src/r_dhcp_client.h"
#include "T4_src/ether.h"
#include "T4_src/ip.h"
#include "T4_src/tcp.h"
#include "T4_src/tcp_api.h"
#include "driver/driver.h"
#include "driver/r_ether.h"
#include "r_byteq_v1.30/r_byteq_if.h"

#include "common/format.hpp"
#include "common/input.hpp"

extern "C" {
	unsigned long millis(void);
	void delay(unsigned long ms);
};

#ifdef DEBUG
#define ETH_DEBUG
#define FTPS_DEBUG
#define HTTP_DEBUG
#endif

// #define ETH_DEBUG

#ifdef ETH_DEBUG
typedef utils::format debug_format;
#else
typedef utils::null_format debug_format;
#endif

#define T4_CLOSED               0

#define T4_TCPS_CLOSED          0
#define T4_TCPS_ESTABLISHED     2
#define T4_TCPS_CLOSE_WAIT      4

#define DHCP_NOTHING_HAPPEND    0
#define DHCP_RENEW_SUCCESS      2
/// #define UDP_RCV_BUFFER_SIZE     1024
#define UDP_RCV_BUFFER_SIZE     4096
#define UDP_TX_PACKET_MAX_SIZE  24

extern _TCB   *head_tcb;
/// extern uint8_t dnsaddr1[];
/// extern uint8_t dnsaddr2[];
extern volatile uint16_t wait_timer;
extern uint8_t     cepid_max;
/// extern NAME_TABLE  name_table;
/// extern DNS_MNG     dns_mng;

#define UDP_RCV_DAT_DATAREAD_MAXIMUM    1366

#define RING_SIZ			(1024)	/* exsample 1024 */
#define RING_SIZ_forSize	(RING_SIZ >> 2)

namespace net {

	//+++++++++++++++++++++++++++++++++++++++++++++++++++++++++++++++++++++//
	/*!
		@brief  ethernet class
	*/
	//+++++++++++++++++++++++++++++++++++++++++++++++++++++++++++++++++++++//
	class ethernet {

	public:
		enum format_id {
			http,
			ftps_ctrl,
			ftps_data,
			server0,
			client0,
		};

		static const uint32_t TCP_MSS = 1460;
		static const uint32_t RECV_SIZE = 1024;
		static const uint32_t SEND_SIZE = 4096;

		struct CEP {
			uint32_t    status;
			T_IPV4EP    dst_addr;
			T_IPV4EP    src_addr;
			int32_t     current_recv_data_len;
			int32_t     total_rcv_len;
			uint8_t     recv_buf[RECV_SIZE];
			uint8_t     send_buf[SEND_SIZE];
			int32_t     sec_counter;
			int32_t     sec_timer;
			int32_t     pre_sec_timer;
			uint32_t	recv_pos_;
			uint32_t	send_pos_;
			bool		enable;
			bool		server;
			bool		acp;
			CEP() : recv_pos_(0), send_pos_(0), enable(false), server(false), acp(false) { }
		};

	private:
		CEP			cep_[TCP_CCEP_MAX + UDP_CCEP_MAX];

		uint32_t	tcpudp_work_[4000];

        uint32_t    dhcpIPAddressLeaseTime_sec;
        uint32_t    dhcpIPuse_sec;
        uint32_t    fromSystemGetLastTime;
		uint32_t	desc_;
        bool		dhcp_use_;

		static T_IPV4EP remoteIPV4EP_;
		static char UDPrecvBuf_[UDP_RCV_DAT_DATAREAD_MAXIMUM];
		static uint8_t byteq_buf[RING_SIZ];
		static byteq_hdl_t	hdl_;
		static byteq_hdl_t	hdl_forSize_;
		static uint8_t byteq_buf_forSize_[RING_SIZ_forSize];    /* sizeQueBody 1024 >> 2 = 256 */

        void dhcpSuccess(DHCP* tmpDhcpPt) {
			int ch = 0;
			memcpy(tcpudp_env[ch].ipaddr, tmpDhcpPt->ipaddr, 4);
			debug_format("ip = %08X\n") % get_local_ip();

			memcpy(tcpudp_env[ch].maskaddr, tmpDhcpPt->maskaddr, 4);
			memcpy(tcpudp_env[ch].gwaddr, tmpDhcpPt->gwaddr, 4);
///			memcpy((char *)dnsaddr1, (char *)tmpDhcpPt->dnsaddr, 4);
			memcpy(dhcpSvMac.bytes, ((DHCP_PACKET*)tcpudp_work_)->ether.source_address, EP_ALEN);
			memcpy(dhcpSvIp.bytes, ((DHCP_PACKET*)tcpudp_work_)->ipv4.source_ip, IP_ALEN);
			dhcp_use_ = true;

			dhcpIPuse_sec = 0;                 /*dhcp lease time local countup start*/
            fromSystemGetLastTime = millis();
            dhcpIPAddressLeaseTime_sec = tmpDhcpPt->dhcpIPAddressLeaseTime;     /*ip lease limit from dhcpSv*/
        }

///        void dhcpLeaseTimeCopy(DHCP *);
///		int32_t dhcp_release(DHCP *dhcp, DHCP_PACKET *dhcp_packet);
        

		void startLANController()
		{
            int  ercd = lan_open();
            debug_format("lan_open() = %d\n") % ercd;
            if(ercd != E_OK) {
				utils::format("lan_open() fail...\n");
                while(1);
            }
        }


        void initialize_TCP_IP()
		{
			uint32_t size = tcpudp_get_memory_size();
			uint32_t real = sizeof(tcpudp_work_);
            if(size > real) {
				utils::format("empty tcpudp RAM size: need(%d), real(%d)\n") % size % real;
                while(1);
            }
			debug_format("tcpudp RAM size: need(%d), real(%d)\n") % size % real;

			tcpudp_open(tcpudp_work_);
        }

	public:

        union _dhcp_sv_ip{
            uint8_t bytes[IP_ALEN];
            uint32_t dword;
        } dhcpSvIp;

        union _dhcp_sv_mac{
                uint8_t bytes[EP_ALEN+2];
                uint64_t lword;
        } dhcpSvMac;


		//-----------------------------------------------------------------//
		/*!
			@brief  コンストラクター
		*/
		//-----------------------------------------------------------------//
        ethernet() : dhcpIPAddressLeaseTime_sec(0),
			dhcpIPuse_sec(0),
			fromSystemGetLastTime(0),
			desc_(0),
			dhcp_use_(false) { }


		//-----------------------------------------------------------------//
		/*!
			@brief  デストラクター
		*/
		//-----------------------------------------------------------------//
        ~ethernet() { }


		//-----------------------------------------------------------------//
		/*!
			@brief  新規コネクションの作成（最大４つ）
			@return コネクションID（１～４）０なら失敗
		*/
		//-----------------------------------------------------------------//
		uint32_t new_connection()
		{
			uint32_t idx = desc_;
			for(uint32_t i = 0; i < tcp_ccep_num; ++i) {
				if(!cep_[idx].enable) {
					cep_[idx].enable = true;
					cep_[idx].acp = false;
					// ++desc_;
					return idx + 1;
				}
				++idx;
				if(idx >= tcp_ccep_num) idx = 0;
			}
			return 0;
		}


		//-----------------------------------------------------------------//
		/*!
			@brief  コネクションの終了
			@param[in]	cepid	コネクション ID
		*/
		//-----------------------------------------------------------------//
		void end_connection(uint32_t cepid)
		{
			if(cepid > 0 && cepid <= tcp_ccep_num) {
				cep_[cepid - 1].recv_pos_ = 0;
				cep_[cepid - 1].send_pos_ = 0;
				cep_[cepid - 1].enable = false;
			}
		}


		//-----------------------------------------------------------------//
		/*!
			@brief  コネクション・リソースへの参照
			@param[in]	cepid	コネクション ID
			@return コネクション・リソース
		*/
		//-----------------------------------------------------------------//
		CEP& at_cep(uint32_t cepid) { return cep_[cepid - 1]; }


		//-----------------------------------------------------------------//
		/*!
			@brief  コネクション・リソースへの参照(RO)
			@param[in]	cepid	コネクション ID
			@return コネクション・リソース
		*/
		//-----------------------------------------------------------------//
		const CEP& get_cep(uint32_t cepid) const { return cep_[cepid - 1]; }


		//-----------------------------------------------------------------//
		/*!
			@brief  イーサネット開始
		*/
		//-----------------------------------------------------------------//
		void start()
		{
			byteq_err_t byteq_err;
			/* Open and initialize a byte queue with a size of BUFSIZE bytes. */
			byteq_err = R_BYTEQ_Open(byteq_buf, RING_SIZ, &hdl_);
			if(BYTEQ_SUCCESS != byteq_err) {
				utils::format("start: step 0 halt...");
				while(1) ;
			}
			byteq_err = R_BYTEQ_Open(byteq_buf_forSize_, RING_SIZ_forSize, &hdl_forSize_);
			if(BYTEQ_SUCCESS != byteq_err) {
				utils::format("start: step 1 halt...");
				while(1);
			}
		}


		//-----------------------------------------------------------------//
		/*!
			@brief  開始
			@param[in]	mac	インサーネット・ＭＡＣアドレス
		*/
		//-----------------------------------------------------------------//
        int begin(const uint8_t* mac) {
			DHCP tmpDhcp;

#ifdef T4_ETHER_DEBUG
			Serial.print("t4:EthernetClass::begin(mac:");
			Serial.print((uchar)mac[0],HEX);
			Serial.print(":");
			Serial.print((uchar)mac[1],HEX);
			Serial.print(":");
			Serial.print((uchar)mac[2],HEX);
			Serial.print(":");
			Serial.print((uchar)mac[3],HEX);
			Serial.print(":");
			Serial.print((uchar)mac[4],HEX);
			Serial.print(":");
			Serial.print((uchar)(mac[5]),HEX);
			Serial.println(")");
#endif
			memcpy(&ethernet_mac[0], mac, EP_ALEN);           /*use from the beginning only 6byte*/
			startLANController();
			debug_format("open_timer()\n");
			open_timer();
			while(g_ether_TransferEnableFlag != ETHER_FLAG_ON) {
				R_ETHER_LinkProcess();
			}

			debug_format("r_dhcp_open:\n");
			if(r_dhcp_open(&tmpDhcp, tcpudp_work_, mac) == -1) {
				debug_format("fail...\n");
				close_timer();
				return 0;	/* 0 on failure */
			} else {
				debug_format("dhcpSuccess\n");
				dhcpSuccess(&tmpDhcp);
			}
			debug_format("close_timer()\n");
			close_timer();
			initialize_TCP_IP();
			return 1;	/* returns an int: 1 on a successful DHCP connection */
		}


		//-----------------------------------------------------------------//
		/*!
			@brief  開始
			@param[in]	mac	インサーネット・ＭＡＣアドレス
			@param[in]	local_ip	ローカルＩＰ
		*/
		//-----------------------------------------------------------------//
		void begin(const uint8_t* mac, const ip_address& local_ip)
		{
#ifdef T4_ETHER_DEBUG
			Serial.println("t4:EthernetClass::begin(mac,ip)");
#endif
			ip_address dns_server = local_ip;
			dns_server[3] = 1;
			begin(mac, local_ip, dns_server);
		}


		//-----------------------------------------------------------------//
		/*!
			@brief  開始
			@param[in]	mac	インサーネット・ＭＡＣアドレス
			@param[in]	local_ip	ローカルＩＰ
			@param[in]	dns_server	ＤＮＳサーバー
		*/
		//-----------------------------------------------------------------//
		void begin(const uint8_t* mac, const ip_address& local_ip, const ip_address& dns_server)
		{
#ifdef T4_ETHER_DEBUG
			Serial.println("t4:EthernetClass::begin(mac,ip,dns)");
#endif
			ip_address gateway = local_ip;
			gateway[3] = 1;
			begin(mac, local_ip, dns_server, gateway);
		}


		//-----------------------------------------------------------------//
		/*!
			@brief  開始
			@param[in]	mac	インサーネット・ＭＡＣアドレス
			@param[in]	local_ip	ローカルＩＰ
			@param[in]	dns_server	ＤＮＳサーバー
			@param[in]	gateway		ゲートウェイ
		*/
		//-----------------------------------------------------------------//
		void begin(const uint8_t* mac, const ip_address& local_ip, const ip_address& dns_server,
			const ip_address& gateway)
		{
#ifdef T4_ETHER_DEBUG
			Serial.println("t4:EthernetClass::begin(mac,ip,dns,gw)");
#endif
			ip_address subnet(255, 255, 255, 0);
			begin(mac, local_ip, dns_server, gateway, subnet);
		}


		//-----------------------------------------------------------------//
		/*!
			@brief  開始
			@param[in]	mac	インサーネット・ＭＡＣアドレス
			@param[in]	local_ip	ローカルＩＰ
			@param[in]	dns_server	ＤＮＳサーバー
			@param[in]	gateway		ゲートウェイ
			@param[in]	subnet		サブネット・マスク	
		*/
		//-----------------------------------------------------------------//
		void begin(const uint8_t* mac, const ip_address& local_ip, const ip_address& dns_server,
			const ip_address& gateway, const ip_address& subnet)
		{
			int ch = 0;
			memcpy(ethernet_mac[ch].mac, mac, EP_ALEN);
			memcpy(tcpudp_env[ch].ipaddr, local_ip.get(), IP_ALEN);
///			memcpy(dnsaddr1, dns_server.get(), IP_ALEN);
			memcpy(tcpudp_env[ch].gwaddr, gateway.get(), IP_ALEN);
			memcpy(tcpudp_env[ch].maskaddr, subnet.get(), IP_ALEN);
			dhcp_use_ = false;
#ifdef T4_ETHER_DEBUG
			Serial.print("t4:EthernetClass::begin(mac:");
			Serial.print((uchar)mac_address[0],HEX);
			Serial.print(":");
			Serial.print((uchar)mac_address[1],HEX);
			Serial.print(":");
			Serial.print((uchar)mac_address[2],HEX);
			Serial.print(":");
			Serial.print((uchar)mac_address[3],HEX);
			Serial.print(":");
			Serial.print((uchar)mac_address[4],HEX);
			Serial.print(":");
			Serial.print((uchar)(mac_address[5]),HEX);
			Serial.print(",ip:");
			Serial.print(localIP());
			Serial.print(",dns:");
			Serial.println(dnsServerIP());
			Serial.print(",gw:");
			Serial.print(gatewayIP());
			Serial.print(",snm:");
			Serial.print(subnetMask());
			Serial.println(")");
#endif
			startLANController();
			initialize_TCP_IP();
#if defined(T4_ETHER_DEBUG)
			Serial.print("R_ETHER_LinkProcess while start");
#endif
			while(g_ether_TransferEnableFlag != ETHER_FLAG_ON) {
				R_ETHER_LinkProcess();
			}
#if defined(T4_ETHER_DEBUG)
			Serial.print("R_ETHER_LinkProcess while finish");
#endif
		}


		//-----------------------------------------------------------------//
		/*!
			@brief  IP アドレスの取得
			@return IP アドレス
		*/
		//-----------------------------------------------------------------//
		static ip_address get_local_ip() {
			ip_address adr;
			int ch = 0;
			adr.set(tcpudp_env[ch].ipaddr);
			return adr;
		}


		//-----------------------------------------------------------------//
		/*!
			@brief  サブネット・マスクの取得
			@return サブネット・マスク
		*/
		//-----------------------------------------------------------------//
		static ip_address get_subnet_mask() {
			ip_address adr;
			int ch = 0;
			adr.set(tcpudp_env[ch].maskaddr);
			return adr;
		}


		//-----------------------------------------------------------------//
		/*!
			@brief  ゲートウェイの取得
			@return ゲートウェイ
		*/
		//-----------------------------------------------------------------//
		static ip_address get_gateway_ip() {
			ip_address adr;
			int ch = 0;
			adr.set(tcpudp_env[ch].gwaddr);
			return adr;
		}

#if 0
		//-----------------------------------------------------------------//
		/*!
			@brief  DNS の IP 取得
			@return DNS の IP
		*/
		//-----------------------------------------------------------------//
		static ip_address get_dns_ip() {
			ip_address adr;
			adr.set(dnsaddr1);
			return adr;
		}
#endif

		//-----------------------------------------------------------------//
		/*!
			@brief  通信ストリームをアップデート（最新にする）
		*/
		//-----------------------------------------------------------------//
        void update(uint32_t cepid)
		{
			if(cepid == 0 || cepid > tcp_ccep_num) return;

			TCP_API_STAT ercd = tcp_read_stat(cepid);
#if 0
			static TCP_API_STAT ercd_[8];
			if(ercd != ercd_[cepid - 1]) {
				debug_format("STAT: %d (%d)\n") % static_cast<int>(ercd) % cepid;
				ercd_[cepid - 1] = ercd;
			}
#endif
			ethernet::CEP& cep = at_cep(cepid);
			if(ercd == TCP_API_STAT_CLOSED && cep.server && !cep.acp) {
				int ret = tcp_acp_cep(cepid, cepid, &cep.dst_addr, TMO_NBLK);
				cep.acp = true;
			}
		}


		//-----------------------------------------------------------------//
		/*!
			@brief  サービス（メイン・ループ）
		*/
		//-----------------------------------------------------------------//
        void service()
		{
            R_ETHER_LinkProcess();

            if(dhcp_use_) {
                uint32_t    sec,ms;
                ms = millis();
                sec = (ms - fromSystemGetLastTime) / 1000;
                if(sec){
                    fromSystemGetLastTime = ms;
                    dhcpIPuse_sec += sec;
                }
            }

			// サービス
			for(uint32_t i = 0; i < tcp_ccep_num; ++i) {
				if(!cep_[i].enable) continue;

				uint32_t cepid = i + 1;
				update(cepid);
			}
        }


		static int udp_callback(uint32_t cepid, int32_t fncd , void *p_parblk)
		{
			union _recvSiz {
				int  dword;          /*typedef int32_t W;typedef W ER*/
				uint8_t bytes[4];
			} recvSiz;

			union _dhcp_sv_ip {
				uint8_t bytes[IP_ALEN];
				uint32_t dword;
			} ip;
			byteq_err_t byteq_err;
			uint16_t count;

			if(cepid > 0 && cepid <= static_cast<uint32_t>(6)) { 
				switch (fncd){
				/// UDP data received
				case TEV_UDP_RCV_DAT:
					/* queue filled with data by R_BYTEQ_Put()elsewhere */
					byteq_err = R_BYTEQ_Unused(hdl_forSize_, &count);
					if(count < 2) {  /*can not record any more DATA SIZE QUE*/
#if defined(T4_ETHER_DEBUG)
						Serial.print("<T4:t4_udp_callback:dataSizeQue:can not record any more DATA SIZE QUE>");
#endif
						break;
					}
					recvSiz.dword = udp_rcv_dat(cepid,
						&remoteIPV4EP_, /*IP address and port number acquisition of opponent*/
						UDPrecvBuf_,    /*Start address of the area for storing the received data*/
						UDP_RCV_DAT_DATAREAD_MAXIMUM,       /*work size*/
						TMO_POL);                           /*polling*/
						/* queue filled with data by R_BYTEQ_Put()elsewhere */
					byteq_err = R_BYTEQ_Unused(hdl_, &count);
					if(count < recvSiz.dword) {  /*can not record any more UDP PACKET SIZE QUE*/
#if defined(T4_ETHER_DEBUG)
						Serial.print("<t4_udp_callback:UDP PACKET Que:can not record any more UDP PACKET SIZE QUE>");
#endif
						break;
					}
					if(recvSiz.dword > 0) {
						byteq_err = R_BYTEQ_Put(hdl_forSize_, recvSiz.bytes[1]);     /*udp packet size upper*/
						if(BYTEQ_SUCCESS != byteq_err) {
                        	printf("<size memory Que ERROR>");
							break;
						}
						byteq_err = R_BYTEQ_Put(hdl_forSize_, recvSiz.bytes[0]);     /*udp packet size lower*/
						if(BYTEQ_SUCCESS != byteq_err) {
							printf("<size memory Que ERROR>");
							break;
						}
						/* Put characters in to the queue. */
						for(int i = 0; i < recvSiz.dword; i++) {
							byteq_err = R_BYTEQ_Put(hdl_, UDPrecvBuf_[i]);
							if(BYTEQ_SUCCESS != byteq_err) {
								printf("<t4:enQueue ERROR>");
								break;
							}
						}
						ip.dword = remoteIPV4EP_.ipaddr;
						remoteIPV4EP_.ipaddr = ((uint32_t)ip.bytes[0] << 24)
								| ((uint32_t)ip.bytes[1]<<16)
								| ((uint32_t)ip.bytes[2]<<8)
								| ((uint32_t)ip.bytes[3]);
					}
					break;
				default:
					break;
        		}
    		}
	    	return 0;
		}


		//-----------------------------------------------------------------//
		/*!
			@brief  ネットの起動
			@param[in]	port	ポート番号
			@return TCP/UDP ディスクリプタ
		*/
		//-----------------------------------------------------------------//
		uint32_t create(uint16_t port)
		{
			uint32_t cepid = new_connection();
			if(cepid == 0) {
				utils::format("Connection handle empty\n");
				return 0;
			}

			at_cep(cepid).status = T4_CLOSED;

			if(cepid > tcp_crep_num) {
				end_connection(cepid);
				return 0;
			}
			tcp_crep[cepid - 1].myaddr.portno = port;

			if(cepid > tcp_ccep_num) {
				end_connection(cepid);
				return 0;
			}
			tcp_ccep[cepid - 1].cepatr = 0;  // ch
			tcp_ccep[cepid - 1].rbufsz = ethernet::TCP_MSS;

			debug_format("Create TCP/UDP: %d\n") % cepid;			

			return cepid;
		}


		//-----------------------------------------------------------------//
		/*!
			@brief  読み込み
			@param[in]	cepid	TCP/UDP ディスクリプタ
			@param[out]	buff	読み込み先
			@param[in]	size	読み込みサイズ
			@return 読み込みサイズ（負の場合エラー）
		*/
		//-----------------------------------------------------------------//
		static int read(uint32_t cepid, void* buff, size_t size)
		{
			if(buff == nullptr || size == 0) return 0;

			int32_t ercd = tcp_recv_data(cepid, buff, size, TMO_FEVR);
			if(ercd <= 0) {
				ercd = -1;
			}
			return ercd;
		}


		//-----------------------------------------------------------------//
		/*!
			@brief  書き込み
			@param[in]	cepid	TCP/UDP ディスクリプタ
			@param[in]	buff	書き込み元
			@param[in]	size	サイズ
			@return 書き込みサイズ（負の場合エラー）
		*/
		//-----------------------------------------------------------------//
		static int32_t write(uint32_t cepid, const void* buff, uint32_t size)
		{
			if(buff == nullptr || size == 0) return 0;

			int32_t ercd;
			uint32_t current_send_size = 0;

			const uint8_t* p = static_cast<const uint8_t*>(buff);
			if (size <= 0x7fff) {
				ercd = tcp_send_data(cepid, p, size, TMO_FEVR);
			} else {
				while (size > current_send_size) {
					if((size - current_send_size) > 0x7fff) {
						ercd = tcp_send_data(cepid, (p + current_send_size), 0x7fff, TMO_FEVR);
					} else {
						ercd = tcp_send_data(cepid, (p + current_send_size),
									(size - current_send_size), TMO_FEVR);
					}
					if(ercd < 0) {
						break; // error
					}
					current_send_size += static_cast<uint32_t>(ercd);
				}
			}
			return current_send_size;
		}


		//-----------------------------------------------------------------//
		/*!
			@brief  接続確認
			@param[in]	cepid	TCP/UDP ディスクリプタ
			@return 接続中なら「true」
		*/
		//-----------------------------------------------------------------//
		bool connected(uint32_t cepid)
		{
			if(cepid == 0) return false;

			bool ret = false;
			TCP_API_STAT ercd = tcp_read_stat(cepid);
			if(ercd == TCP_API_STAT_ESTABLISHED || ercd == TCP_API_STAT_CLOSE_WAIT) {
				ret = true;
			}
			return ret;
		}


		//-----------------------------------------------------------------//
		/*!
			@brief  有効なデータがあるか
			@param[in]	cepid	TCP/UDP ディスクリプタ
			@return 有効なデータ数
		*/
		//-----------------------------------------------------------------//
		int available(uint32_t cepid)
		{
			int ret = 0;
			if(connected(cepid)) {
				ret = head_tcb[cepid - 1].rdsize;
				TCP_API_STAT ercd = tcp_read_stat(cepid);

				if(ret == 0 && ercd == TCP_API_STAT_CLOSE_WAIT) {
					tcp_sht_cep(cepid, TMO_FEVR);
				}
			}
			return ret;
		}


		//-----------------------------------------------------------------//
		/*!
			@brief  QOVR リセット
			@param[in]	cepid	TCP/UDP ディスクリプタ
		*/
		//-----------------------------------------------------------------//
		void reset(uint32_t cepid)
		{
			tcp_reset_queue(cepid);
		}


		//-----------------------------------------------------------------//
		/*!
			@brief  状態の取得
			@param[in]	cepid	TCP/UDP ディスクリプタ
			@return 状態コード
		*/
		//-----------------------------------------------------------------//
		TCP_API_STAT get_stat(uint32_t cepid) const
		{
			TCP_API_STAT ercd = tcp_read_stat(cepid);
			return ercd;
		}
	};


	//+++++++++++++++++++++++++++++++++++++++++++++++++++++++++++++++++++++//
	/*!
		@brief  Ethernet 文字出力テンプレートクラス
		@param[in]	ID		スタテッック領域の識別子として使用
		@param[in]	SIZE	バッファ・サイズ
	*/
	//+++++++++++++++++++++++++++++++++++++++++++++++++++++++++++++++++++++//
	template <ethernet::format_id ID, uint32_t SIZE>
	class ether_string
	{
	public:
		typedef utils::fixed_string<SIZE> STR;

	private:
		STR		str_;
		int		fd_;

	public:
		//-----------------------------------------------------------------//
		/*!
			@brief  コンストラクタ
		*/
		//-----------------------------------------------------------------//
		ether_string() : str_(), fd_(0) { }


		//-----------------------------------------------------------------//
		/*!
			@brief  クリア
		*/
		//-----------------------------------------------------------------//
		void clear() {
			str_.clear();
		}


		//-----------------------------------------------------------------//
		/*!
			@brief  フラッシュ @n
					キャッシュした文字列を全て書き出して、クリアする
		*/
		//-----------------------------------------------------------------//
		void flush() {
			if(str_.size() > 0) {
				if(fd_ > 0) {
					uint32_t len = str_.size();
					const char* p = str_.c_str();
					ethernet::write(fd_, p, len);
				} else {
					utils::format("ether_string: FD is null.\n");
				}
			}
			clear();
		}


		//-----------------------------------------------------------------//
		/*!
			@brief  文字出力 @n
					※LF コードを CR/LF に変換
			@param[in]	ch	文字
		*/
		//-----------------------------------------------------------------//
		void putch(char ch) {
			if(ch == '\n') {
				putch('\r');
			}
			str_ += ch;
			if(str_.size() >= str_.capacity()) {
				
				flush();
			}
		}


		//-----------------------------------------------------------------//
		/*!
			@brief  サイズを返す
			@return サイズ
		*/
		//-----------------------------------------------------------------//
		uint32_t size() const { return str_.size(); }


		//-----------------------------------------------------------------//
		/*!
			@brief  ファイル、ディスクリプタを設定
			@param[in]	fd	ファイル、ディスクリプタ
		*/
		//-----------------------------------------------------------------//
		void set_fd(int fd) { fd_ = fd; }


		//-----------------------------------------------------------------//
		/*!
			@brief  文字列への参照
			@return 文字列
		*/
		//-----------------------------------------------------------------//
		STR& at_str() { return str_; }


		//-----------------------------------------------------------------//
		/*!
			@brief  () オペレーター（文字出力）
			@param[in]	ch	文字
		*/
		//-----------------------------------------------------------------//
		void operator() (char ch) { putch(ch); }
	};
}
