hirakuni45/RX/chip/VL53L0X.hpp

#pragma once
//=====================================================================//
/*!	@file
	@brief	VL53L0X ドライバー
    @author 平松邦仁 (hira@rvf-rc45.net)
	@copyright	Copyright (C) 2017 Kunihito Hiramatsu @n
				Released under the MIT license @n
				https://github.com/hirakuni45/RX/blob/master/LICENSE
*/
//=====================================================================//
#include <cstdint>
#include <cstring>
#include "common/delay.hpp"

namespace chip {

	//+++++++++++++++++++++++++++++++++++++++++++++++++++++++++++++++++++++//
	/*!
		@brief  VL53L0X テンプレートクラス
		@param[in]	I2C_IO	i2c I/O クラス
	*/
	//+++++++++++++++++++++++++++++++++++++++++++++++++++++++++++++++++++++//
	template <class I2C_IO>
	class VL53L0X {
	public:

		//+++++++++++++++++++++++++++++++++++++++++++++++++++++++++++++++++//
		/*!
			@brief  シーケンスステップ許可、構造体
		*/
		//+++++++++++++++++++++++++++++++++++++++++++++++++++++++++++++++++//
		struct SequenceStepEnables {
			bool	tcc;
			bool	msrc;
			bool	dss;
			bool	pre_range;
			bool	final_range;
		};


		//+++++++++++++++++++++++++++++++++++++++++++++++++++++++++++++++++//
		/*!
			@brief  シーケンスステップタイムアウト、構造体
		*/
		//+++++++++++++++++++++++++++++++++++++++++++++++++++++++++++++++++//
		struct SequenceStepTimeouts {
			uint16_t	pre_range_vcsel_period_pclks;
			uint16_t	final_range_vcsel_period_pclks;

			uint16_t	msrc_dss_tcc_mclks;
			uint16_t	pre_range_mclks;
			uint16_t	final_range_mclks;

			uint32_t	msrc_dss_tcc_us;
			uint32_t	pre_range_us;
			uint32_t	final_range_us;
		};

	private:
		// I2C アドレス：（R/W ビットを含まない７ビット値）
		static constexpr uint8_t ADR_ = 0b010'1001;

	    enum class reg_addr : uint8_t {
			SYSRANGE_START                              = 0x00,
			SYSTEM_THRESH_HIGH                          = 0x0C,
			SYSTEM_THRESH_LOW                           = 0x0E,

			SYSTEM_SEQUENCE_CONFIG                      = 0x01,
			SYSTEM_RANGE_CONFIG                         = 0x09,
			SYSTEM_INTERMEASUREMENT_PERIOD              = 0x04,

			SYSTEM_INTERRUPT_CONFIG_GPIO                = 0x0A,

			GPIO_HV_MUX_ACTIVE_HIGH                     = 0x84,

			SYSTEM_INTERRUPT_CLEAR                      = 0x0B,

			RESULT_INTERRUPT_STATUS                     = 0x13,
			RESULT_RANGE_STATUS                         = 0x14,

			RESULT_CORE_AMBIENT_WINDOW_EVENTS_RTN       = 0xBC,
			RESULT_CORE_RANGING_TOTAL_EVENTS_RTN        = 0xC0,
			RESULT_CORE_AMBIENT_WINDOW_EVENTS_REF       = 0xD0,
			RESULT_CORE_RANGING_TOTAL_EVENTS_REF        = 0xD4,
			RESULT_PEAK_SIGNAL_RATE_REF                 = 0xB6,

			ALGO_PART_TO_PART_RANGE_OFFSET_MM           = 0x28,

			I2C_SLAVE_DEVICE_ADDRESS                    = 0x8A,

			MSRC_CONFIG_CONTROL                         = 0x60,

			PRE_RANGE_CONFIG_MIN_SNR                    = 0x27,
			PRE_RANGE_CONFIG_VALID_PHASE_LOW            = 0x56,
			PRE_RANGE_CONFIG_VALID_PHASE_HIGH           = 0x57,
			PRE_RANGE_MIN_COUNT_RATE_RTN_LIMIT          = 0x64,

			FINAL_RANGE_CONFIG_MIN_SNR                  = 0x67,
			FINAL_RANGE_CONFIG_VALID_PHASE_LOW          = 0x47,
			FINAL_RANGE_CONFIG_VALID_PHASE_HIGH         = 0x48,
			FINAL_RANGE_CONFIG_MIN_COUNT_RATE_RTN_LIMIT = 0x44,

			PRE_RANGE_CONFIG_SIGMA_THRESH_HI            = 0x61,
			PRE_RANGE_CONFIG_SIGMA_THRESH_LO            = 0x62,

			PRE_RANGE_CONFIG_VCSEL_PERIOD               = 0x50,
			PRE_RANGE_CONFIG_TIMEOUT_MACROP_HI          = 0x51,
			PRE_RANGE_CONFIG_TIMEOUT_MACROP_LO          = 0x52,

			SYSTEM_HISTOGRAM_BIN                        = 0x81,
			HISTOGRAM_CONFIG_INITIAL_PHASE_SELECT       = 0x33,
			HISTOGRAM_CONFIG_READOUT_CTRL               = 0x55,

			FINAL_RANGE_CONFIG_VCSEL_PERIOD             = 0x70,
			FINAL_RANGE_CONFIG_TIMEOUT_MACROP_HI        = 0x71,
			FINAL_RANGE_CONFIG_TIMEOUT_MACROP_LO        = 0x72,
			CROSSTALK_COMPENSATION_PEAK_RATE_MCPS       = 0x20,

			MSRC_CONFIG_TIMEOUT_MACROP                  = 0x46,

			SOFT_RESET_GO2_SOFT_RESET_N                 = 0xBF,
			IDENTIFICATION_MODEL_ID                     = 0xC0,
			IDENTIFICATION_REVISION_ID                  = 0xC2,

			OSC_CALIBRATE_VAL                           = 0xF8,

			GLOBAL_CONFIG_VCSEL_WIDTH                   = 0x32,
			GLOBAL_CONFIG_SPAD_ENABLES_REF_0            = 0xB0,
			GLOBAL_CONFIG_SPAD_ENABLES_REF_1            = 0xB1,
			GLOBAL_CONFIG_SPAD_ENABLES_REF_2            = 0xB2,
			GLOBAL_CONFIG_SPAD_ENABLES_REF_3            = 0xB3,
			GLOBAL_CONFIG_SPAD_ENABLES_REF_4            = 0xB4,
			GLOBAL_CONFIG_SPAD_ENABLES_REF_5            = 0xB5,

			GLOBAL_CONFIG_REF_EN_START_SELECT           = 0xB6,
			DYNAMIC_SPAD_NUM_REQUESTED_REF_SPAD         = 0x4E,
			DYNAMIC_SPAD_REF_EN_START_OFFSET            = 0x4F,
			POWER_MANAGEMENT_GO1_POWER_FORCE            = 0x80,

			VHV_CONFIG_PAD_SCL_SDA__EXTSUP_HV           = 0x89,

			ALGO_PHASECAL_LIM                           = 0x30,
			ALGO_PHASECAL_CONFIG_TIMEOUT                = 0x30,

			CONST_00 = 0x00,
			CONST_80 = 0x80,
			CONST_81 = 0x81,
			CONST_82 = 0x82,
			CONST_83 = 0x83,
			CONST_88 = 0x88,
			CONST_91 = 0x91,
			CONST_92 = 0x92,
			CONST_94 = 0x94,
			CONST_FF = 0xFF, 
		};


		enum class vcselPeriod {
			PreRange,
			FinalRange
		};

		I2C_IO&		i2c_io_;

		uint32_t	measurement_timing_budget_us_;

		uint16_t	timeout_start_ms_;
		uint16_t	io_timeout_;

		// read by init and used when starting measurement; is StopVariable field of VL53L0X_
		uint8_t		stop_variable_;

		bool		last_status_;
		bool		did_timeout_;


		void start_timeout_() {
			timeout_start_ms_ = 0;
		}


		bool check_timeout_expired_() {
			++timeout_start_ms_;
			utils::delay::micro_second(1000 - 100);  // 1ms から、他の処理を大雑把に100uS引く
			return (io_timeout_ > 0 && timeout_start_ms_ > io_timeout_);
		}


		void write_(reg_addr reg, uint8_t value)
		{
			uint8_t tmp[2];
			tmp[0] = static_cast<uint8_t>(reg);
			tmp[1] = value;
			last_status_ = i2c_io_.send(ADR_, tmp, 2);
		}


		void write_(reg_addr reg, const uint8_t* src, uint8_t len)
		{
			uint8_t tmp[1 + len];
			tmp[0] = static_cast<uint8_t>(reg);
			std::memcpy(&tmp[1], src, len); 
			last_status_ = i2c_io_.send(ADR_, tmp, len + 1);
		}


		void write16_(reg_addr reg, uint16_t value)
		{
			uint8_t tmp[3];
			tmp[0] = static_cast<uint8_t>(reg);
			tmp[1] = value >> 8;
			tmp[2] = value & 0xff;
			last_status_ = i2c_io_.send(ADR_, tmp, 3);
		}


		void write32_(reg_addr reg, uint32_t value)
		{
			uint8_t tmp[5];
			tmp[0] = static_cast<uint8_t>(reg);
			tmp[1] = value >> 24;
			tmp[2] = value >> 16;
			tmp[3] = value >> 8;
			tmp[4] = value & 0xff;
			last_status_ = i2c_io_.send(ADR_, tmp, 5);
		}


		uint8_t read_(reg_addr reg)
		{
			uint8_t tmp[1];
			tmp[0] = static_cast<uint8_t>(reg);
			last_status_ = i2c_io_.send(ADR_, tmp, 1);
			if(!last_status_) return 0;

			last_status_ = i2c_io_.recv(ADR_, tmp, 1);
			return tmp[0];
		}


		bool read_(reg_addr reg, uint8_t* dst, uint8_t len)
		{
			uint8_t tmp[1];
			tmp[0] = static_cast<uint8_t>(reg);
			if(!i2c_io_.send(ADR_, tmp, 1)) {
				return false;
			}

			return i2c_io_.recv(ADR_, dst, len);
		}


		uint16_t read16_(reg_addr reg)
		{
			uint8_t tmp[2];
			tmp[0] = static_cast<uint8_t>(reg);
			last_status_ = i2c_io_.send(ADR_, tmp, 1);
			if(!last_status_) return 0;

			last_status_ =  i2c_io_.recv(ADR_, tmp, 2);
			uint16_t value = static_cast<uint16_t>(tmp[0]) << 8;
			value |= static_cast<uint16_t>(tmp[1]);
			return value;
		}


		uint32_t read32_(reg_addr reg)
		{
			uint8_t tmp[4];
			tmp[0] = static_cast<uint8_t>(reg);
			last_status_ = i2c_io_.send(ADR_, tmp, 1);
			if(!last_status_) return 0;

			last_status_ =  i2c_io_.recv(ADR_, tmp, 4);
			uint32_t value = static_cast<uint32_t>(tmp[0]) << 24;
			value |= static_cast<uint32_t>(tmp[1]) << 16;
			value |= static_cast<uint32_t>(tmp[2]) << 8;
			value |= static_cast<uint32_t>(tmp[3]);
			return value;
		}


		bool get_spad_info_(uint8_t& count, bool& type_is_aperture)
		{
			write_(reg_addr::CONST_80, 0x01);
			write_(reg_addr::CONST_FF, 0x01);
			write_(reg_addr::CONST_00, 0x00);

			write_(reg_addr::CONST_FF, 0x06);
			write_(reg_addr::CONST_83, read_(static_cast<reg_addr>(0x83)) | 0x04);
			write_(reg_addr::CONST_FF, 0x07);
			write_(reg_addr::CONST_81, 0x01);

			write_(reg_addr::CONST_80, 0x01);

			write_(reg_addr::CONST_94, 0x6b);
			write_(reg_addr::CONST_83, 0x00);

			start_timeout_();
			while(read_(reg_addr::CONST_83) == 0x00) {
				if(check_timeout_expired_()) { return false; }
			}
			write_(reg_addr::CONST_83, 0x01);
			uint8_t tmp = read_(reg_addr::CONST_92);

			count = tmp & 0x7f;
			type_is_aperture = (tmp >> 7) & 0x01;

			write_(reg_addr::CONST_81, 0x00);
			write_(reg_addr::CONST_FF, 0x06);
			write_(reg_addr::CONST_83, read_(reg_addr::CONST_83)  & ~0x04);
			write_(reg_addr::CONST_FF, 0x01);
			write_(reg_addr::CONST_00, 0x01);

			write_(reg_addr::CONST_FF, 0x00);
			write_(reg_addr::CONST_80, 0x00);

			return true;
		}


		bool perform_single_ref_calibration_(uint8_t vhv_init_byte)
		{
			write_(reg_addr::SYSRANGE_START, 0x01 | vhv_init_byte); // VL53L0X_REG_SYSRANGE_MODE_START_STOP

			start_timeout_();
			while((read_(reg_addr::RESULT_INTERRUPT_STATUS) & 0x07) == 0) {
				if(check_timeout_expired_()) { return false; }
			}

			write_(reg_addr::SYSTEM_INTERRUPT_CLEAR, 0x01);

			write_(reg_addr::SYSRANGE_START, 0x00);

			return true;
		}


		static uint8_t decode_vcsel_period_(uint8_t reg_val) {
			return (reg_val + 1) << 1;
		}


		static uint32_t encode_vcsel_period_(uint32_t period_pclks) {
			return (period_pclks >> 1) - 1;
		}


		static uint32_t calc_macro_period_(uint32_t vcsel_period_pclks) {
			return ((2304 * vcsel_period_pclks * 1655) + 500) / 1000;
		}


	public:
		//-----------------------------------------------------------------//
		/*!
			@brief	コンストラクター
			@param[in]	i2c	iica_io クラスを参照で渡す
		 */
		//-----------------------------------------------------------------//
		VL53L0X(I2C_IO& i2c) : i2c_io_(i2c),
			measurement_timing_budget_us_(0), timeout_start_ms_(0), io_timeout_(500), 
			stop_variable_(0),
			last_status_(true), did_timeout_(false) { }


		//-----------------------------------------------------------------//
		/*!
			@brief	タイムアウトの設定（ミリ秒）
			@param[in]	timeout	タイムアウト
		 */
		//-----------------------------------------------------------------//
		void set_timeout(uint16_t timeout) { io_timeout_ = timeout; }


		//-----------------------------------------------------------------//
		/*!
			@brief	タイムアウトの取得（ミリ秒）
			@return	タイムアウト
		 */
		//-----------------------------------------------------------------//
		uint16_t get_timeout() const { return io_timeout_; }


		//-----------------------------------------------------------------//
		/*!
			@brief	開始
			@param[in]	io_2v8	I/O:2.8V「true」、I/O:1.8V「false」
			@return エラーなら「false」を返す
		 */
		//-----------------------------------------------------------------//
		bool start(bool io_2v8 = true) {

			// sensor uses 1V8 mode for I/O by default; switch to 2V8 mode if necessary
			if(io_2v8) {
				write_(reg_addr::VHV_CONFIG_PAD_SCL_SDA__EXTSUP_HV,
					read_(reg_addr::VHV_CONFIG_PAD_SCL_SDA__EXTSUP_HV) | 0x01); // set bit 0
			}

			// "Set I2C standard mode"
			write_(reg_addr::CONST_88, 0x00);

			write_(reg_addr::CONST_80, 0x01);
			write_(reg_addr::CONST_FF, 0x01);
			write_(reg_addr::CONST_00, 0x00);
			stop_variable_ = read_(reg_addr::CONST_91);
			write_(reg_addr::CONST_00, 0x01);
			write_(reg_addr::CONST_FF, 0x00);
			write_(reg_addr::CONST_80, 0x00);

			// disable SIGNAL_RATE_MSRC (bit 1) and SIGNAL_RATE_PRE_RANGE (bit 4) limit checks
			write_(reg_addr::MSRC_CONFIG_CONTROL, read_(reg_addr::MSRC_CONFIG_CONTROL) | 0x12);

			// set final range signal rate limit to 0.25 MCPS (million counts per second)
			set_signal_rate_limit(0.25f);

			write_(reg_addr::SYSTEM_SEQUENCE_CONFIG, 0xFF);

			// VL53L0X_DataInit() end
			// VL53L0X_StaticInit() begin

			uint8_t spad_count;
			bool spad_type_is_aperture;
			if(!get_spad_info_(spad_count, spad_type_is_aperture)) { return false; }

			// The SPAD map (RefGoodSpadMap) is read by VL53L0X_get_info_from_device() in
			// the API, but the same data seems to be more easily readable from
			// GLOBAL_CONFIG_SPAD_ENABLES_REF_0 through _6, so read it from there
			uint8_t ref_spad_map[6];
			read_(reg_addr::GLOBAL_CONFIG_SPAD_ENABLES_REF_0, ref_spad_map, 6);

			// -- VL53L0X_set_reference_spads() begin (assume NVM values are valid)

			write_(static_cast<reg_addr>(0xFF), 0x01);
			write_(reg_addr::DYNAMIC_SPAD_REF_EN_START_OFFSET, 0x00);
			write_(reg_addr::DYNAMIC_SPAD_NUM_REQUESTED_REF_SPAD, 0x2C);
			write_(static_cast<reg_addr>(0xFF), 0x00);
			write_(reg_addr::GLOBAL_CONFIG_REF_EN_START_SELECT, 0xB4);

			uint8_t first_spad_to_enable = spad_type_is_aperture ? 12 : 0; // 12 is the first aperture spad
			uint8_t spads_enabled = 0;
			for(uint8_t i = 0; i < 48; ++i) {
				if(i < first_spad_to_enable || spads_enabled == spad_count) {
					// This bit is lower than the first one that should be enabled, or
					// (reference_spad_count) bits have already been enabled, so zero this bit
					ref_spad_map[i / 8] &= ~(1 << (i % 8));
				} else if((ref_spad_map[i / 8] >> (i % 8)) & 0x1) {
					spads_enabled++;
				}
			}

			write_(reg_addr::GLOBAL_CONFIG_SPAD_ENABLES_REF_0, ref_spad_map, 6);

			// -- VL53L0X_set_reference_spads() end

			// -- VL53L0X_load_tuning_settings() begin
			// DefaultTuningSettings from vl53l0x_tuning.h
			static constexpr uint8_t tuning[] = {
				0xFF, 0x01,
				0x00, 0x00,

				0xFF, 0x00,
				0x09, 0x00,
				0x10, 0x00,
				0x11, 0x00,

				0x24, 0x01,
				0x25, 0xFF,
				0x75, 0x00,

				0xFF, 0x01,
				0x4E, 0x2C,
				0x48, 0x00,
				0x30, 0x20,

				0xFF, 0x00,
				0x30, 0x09,
				0x54, 0x00,
				0x31, 0x04,
				0x32, 0x03,
				0x40, 0x83,
				0x46, 0x25,
				0x60, 0x00,
				0x27, 0x00,
				0x50, 0x06,
				0x51, 0x00,
				0x52, 0x96,
				0x56, 0x08,
				0x57, 0x30,
				0x61, 0x00,
				0x62, 0x00,
				0x64, 0x00,
				0x65, 0x00,
				0x66, 0xA0,

				0xFF, 0x01,
				0x22, 0x32,
				0x47, 0x14,
				0x49, 0xFF,
				0x4A, 0x00,

				0xFF, 0x00,
				0x7A, 0x0A,
				0x7B, 0x00,
				0x78, 0x21,

				0xFF, 0x01,
				0x23, 0x34,
				0x42, 0x00,
				0x44, 0xFF,
				0x45, 0x26,
				0x46, 0x05,
				0x40, 0x40,
				0x0E, 0x06,
				0x20, 0x1A,
				0x43, 0x40,

				0xFF, 0x00,
				0x34, 0x03,
				0x35, 0x44,

				0xFF, 0x01,
				0x31, 0x04,
				0x4B, 0x09,
				0x4C, 0x05,
				0x4D, 0x04,

				0xFF, 0x00,
				0x44, 0x00,
				0x45, 0x20,
				0x47, 0x08,
				0x48, 0x28,
				0x67, 0x00,
				0x70, 0x04,
				0x71, 0x01,
				0x72, 0xFE,
				0x76, 0x00,
				0x77, 0x00,

				0xFF, 0x01,
				0x0D, 0x01,

				0xFF, 0x00,
				0x80, 0x01,
				0x01, 0xF8,

				0xFF, 0x01,
				0x8E, 0x01,
				0x00, 0x01,
				0xFF, 0x00,
				0x80, 0x00,				
			};
			for(uint8_t i = 0; i < sizeof(tuning); i += 2) {
				write_(static_cast<reg_addr>(tuning[i]), tuning[i + 1]);
			}
			// -- VL53L0X_load_tuning_settings() end

			// "Set interrupt config to new sample ready"
			// -- VL53L0X_SetGpioConfig() begin

			write_(reg_addr::SYSTEM_INTERRUPT_CONFIG_GPIO, 0x04);
			// active low
			write_(reg_addr::GPIO_HV_MUX_ACTIVE_HIGH, read_(reg_addr::GPIO_HV_MUX_ACTIVE_HIGH) & ~0x10);
			write_(reg_addr::SYSTEM_INTERRUPT_CLEAR, 0x01);

  			// -- VL53L0X_SetGpioConfig() end

			measurement_timing_budget_us_ = get_measurement_timing_budget();

			// "Disable MSRC and TCC by default"
			// MSRC = Minimum Signal Rate Check
			// TCC = Target CentreCheck
			// -- VL53L0X_SetSequenceStepEnable() begin

			write_(reg_addr::SYSTEM_SEQUENCE_CONFIG, 0xE8);

			// -- VL53L0X_SetSequenceStepEnable() end

			// "Recalculate timing budget"
			set_measurement_timing_budget(measurement_timing_budget_us_);

			// VL53L0X_StaticInit() end

			// VL53L0X_PerformRefCalibration() begin (VL53L0X_perform_ref_calibration())

			// -- VL53L0X_perform_vhv_calibration() begin

			write_(reg_addr::SYSTEM_SEQUENCE_CONFIG, 0x01);
			if(!perform_single_ref_calibration_(0x40)) { return false; }

			// -- VL53L0X_perform_vhv_calibration() end

			// -- VL53L0X_perform_phase_calibration() begin

			write_(reg_addr::SYSTEM_SEQUENCE_CONFIG, 0x02);
			if(!perform_single_ref_calibration_(0x00)) { return false; }

			// -- VL53L0X_perform_phase_calibration() end

			// "restore the previous Sequence Config"
			write_(reg_addr::SYSTEM_SEQUENCE_CONFIG, 0xE8);

			/// PerformRefCalibration() end
			return true;
		}


		//-----------------------------------------------------------------//
		/*!
			@brief	最後のタイムアウトを取得し、タイムアウトフラグを除去する。@n
					Did a timeout occur in one of the read functions since the last call to @n
					timeout_occurred()?
			@return タイムアウトなら「true」
		 */
		//-----------------------------------------------------------------//
		bool timeout_occurred()
		{
			bool tmp = did_timeout_;
			did_timeout_ = false;
			return tmp;
		}


		//-----------------------------------------------------------------//
		/*!
			@brief	VCSEL を設定 @n
					Set the VCSEL (vertical cavity surface emitting laser) pulse period for the
					given period type (pre-range or final range) to the given value in PCLKs.
					Longer periods seem to increase the potential range of the sensor.
					Valid values are (even numbers only):
					pre:  12 to 18 (initialized default: 14)
					final: 8 to 14 (initialized default: 10)
					based on VL53L0X_set_vcsel_pulse_period()
			@param[in]	type	vcselPeriod 型
			@param[in]	period_pclks PCLK 値	
		 */
		//-----------------------------------------------------------------//
		bool set_vcsel_pulse_period(vcselPeriod type, uint8_t period_pclks)
		{
			uint8_t vcsel_period_reg = encode_vcsel_period_(period_pclks);

			SequenceStepEnables enables;
			SequenceStepTimeouts timeouts;

			get_sequence_step_enables_(enables);
			get_sequence_step_timeouts_(enables, timeouts);

			// "Apply specific settings for the requested clock period"
			// "Re-calculate and apply timeouts, in macro periods"

			// "When the VCSEL period for the pre or final range is changed,
			// the corresponding timeout must be read from the device using
			// the current VCSEL period, then the new VCSEL period can be
			// applied. The timeout then must be written back to the device
			// using the new VCSEL period.
			//
			// For the MSRC timeout, the same applies - this timeout being
			// dependant on the pre-range vcsel period."

			if(type == vcselPeriod::PreRange) {
				// "Set phase check limits"
				switch(period_pclks) {
				case 12:
					write_(reg_addr::PRE_RANGE_CONFIG_VALID_PHASE_HIGH, 0x18);
					break;

				case 14:
					write_(reg_addr::PRE_RANGE_CONFIG_VALID_PHASE_HIGH, 0x30);
					break;

				case 16:
					write_(reg_addr::PRE_RANGE_CONFIG_VALID_PHASE_HIGH, 0x40);
					break;

				case 18:
					write_(reg_addr::PRE_RANGE_CONFIG_VALID_PHASE_HIGH, 0x50);
					break;

				default:
					// invalid period
					return false;
				}
				write_(reg_addr::PRE_RANGE_CONFIG_VALID_PHASE_LOW, 0x08);

				// apply new VCSEL period
				write_(reg_addr::PRE_RANGE_CONFIG_VCSEL_PERIOD, vcsel_period_reg);

				// update timeouts

				// set_sequence_step_timeout() begin
				// (SequenceStepId == VL53L0X_SEQUENCESTEP_PRE_RANGE)

				uint16_t new_pre_range_timeout_mclks =
					timeout_microseconds_to_mclks(timeouts.pre_range_us, period_pclks);

				write16_(reg_addr::PRE_RANGE_CONFIG_TIMEOUT_MACROP_HI,
						 encode_timeout(new_pre_range_timeout_mclks));

				// set_sequence_step_timeout() end

				// set_sequence_step_timeout() begin
				// (SequenceStepId == VL53L0X_SEQUENCESTEP_MSRC)

				uint16_t new_msrc_timeout_mclks =
					timeout_microseconds_to_mclks(timeouts.msrc_dss_tcc_us, period_pclks);

				write_(reg_addr::MSRC_CONFIG_TIMEOUT_MACROP,
					   (new_msrc_timeout_mclks > 256) ? 255 : (new_msrc_timeout_mclks - 1));

				// set_sequence_step_timeout() end
			} else if(type == vcselPeriod::FinalRange) {

				switch(period_pclks) {
				case 8:
					write_(reg_addr::FINAL_RANGE_CONFIG_VALID_PHASE_HIGH, 0x10);
					write_(reg_addr::FINAL_RANGE_CONFIG_VALID_PHASE_LOW,  0x08);
					write_(reg_addr::GLOBAL_CONFIG_VCSEL_WIDTH, 0x02);
					write_(reg_addr::ALGO_PHASECAL_CONFIG_TIMEOUT, 0x0C);
					write_(static_cast<reg_addr>(0xFF), 0x01);
					write_(reg_addr::ALGO_PHASECAL_LIM, 0x30);
					write_(static_cast<reg_addr>(0xFF), 0x00);
					break;

				case 10:
					write_(reg_addr::FINAL_RANGE_CONFIG_VALID_PHASE_HIGH, 0x28);
					write_(reg_addr::FINAL_RANGE_CONFIG_VALID_PHASE_LOW,  0x08);
					write_(reg_addr::GLOBAL_CONFIG_VCSEL_WIDTH, 0x03);
					write_(reg_addr::ALGO_PHASECAL_CONFIG_TIMEOUT, 0x09);
					write_(static_cast<reg_addr>(0xFF), 0x01);
					write_(reg_addr::ALGO_PHASECAL_LIM, 0x20);
					write_(static_cast<reg_addr>(0xFF), 0x00);
					break;

				case 12:
					write_(reg_addr::FINAL_RANGE_CONFIG_VALID_PHASE_HIGH, 0x38);
					write_(reg_addr::FINAL_RANGE_CONFIG_VALID_PHASE_LOW,  0x08);
					write_(reg_addr::GLOBAL_CONFIG_VCSEL_WIDTH, 0x03);
					write_(reg_addr::ALGO_PHASECAL_CONFIG_TIMEOUT, 0x08);
					write_(static_cast<reg_addr>(0xFF), 0x01);
					write_(reg_addr::ALGO_PHASECAL_LIM, 0x20);
					write_(static_cast<reg_addr>(0xFF), 0x00);
					break;

				case 14:
					write_(reg_addr::FINAL_RANGE_CONFIG_VALID_PHASE_HIGH, 0x48);
					write_(reg_addr::FINAL_RANGE_CONFIG_VALID_PHASE_LOW,  0x08);
					write_(reg_addr::GLOBAL_CONFIG_VCSEL_WIDTH, 0x03);
					write_(reg_addr::ALGO_PHASECAL_CONFIG_TIMEOUT, 0x07);
					write_(static_cast<reg_addr>(0xFF), 0x01);
					write_(reg_addr::ALGO_PHASECAL_LIM, 0x20);
					write_(static_cast<reg_addr>(0xFF), 0x00);
					break;

				default:
					// invalid period
					return false;
				}

				// apply new VCSEL period
				write_(reg_addr::FINAL_RANGE_CONFIG_VCSEL_PERIOD, vcsel_period_reg);

				// update timeouts

				// set_sequence_step_timeout() begin
				// (SequenceStepId == VL53L0X_SEQUENCESTEP_FINAL_RANGE)

				// "For the final range timeout, the pre-range timeout
				//  must be added. To do this both final and pre-range
				//  timeouts must be expressed in macro periods MClks
				//  because they have different vcsel periods."

				uint16_t new_final_range_timeout_mclks =
					timeout_microseconds_to_mclks(timeouts.final_range_us, period_pclks);

				if(enables.pre_range) {
					new_final_range_timeout_mclks += timeouts.pre_range_mclks;
				}

				write16_(reg_addr::FINAL_RANGE_CONFIG_TIMEOUT_MACROP_HI,
						 encode_timeout(new_final_range_timeout_mclks));

				// set_sequence_step_timeout end
			} else {
				// invalid type
				return false;
			}

			// "Finally, the timing budget must be re-applied"

			set_measurement_timing_budget(measurement_timing_budget_us_);

			// "Perform the phase calibration. This is needed after changing on vcsel period."
			// VL53L0X_perform_phase_calibration() begin

			uint8_t sequence_config = read_(reg_addr::SYSTEM_SEQUENCE_CONFIG);
			write_(reg_addr::SYSTEM_SEQUENCE_CONFIG, 0x02);
			perform_single_ref_calibration_(0x0);
			write_(reg_addr::SYSTEM_SEQUENCE_CONFIG, sequence_config);

			// VL53L0X_perform_phase_calibration() end
			return true;
		}


		//-----------------------------------------------------------------//
		/*!
			@brief	VCSEL を取得 @n
				Get the VCSEL pulse period in PCLKs for the given period type. @n
				based on VL53L0X_get_vcsel_pulse_period()
			@param[in]	type	vcselPeriod 型
		 */
		//-----------------------------------------------------------------//
		uint8_t get_vcsel_pulse_period(vcselPeriod type)
		{
			if(type == vcselPeriod::PreRange) {
				return decode_vcsel_period_(read_(reg_addr::PRE_RANGE_CONFIG_VCSEL_PERIOD));
			} else if(type == vcselPeriod::FinalRange) {
				return decode_vcsel_period_(read_(reg_addr::FINAL_RANGE_CONFIG_VCSEL_PERIOD));
			} else {
				return 255;
			}
		}


		//-----------------------------------------------------------------//
		/*!
			@brief	シーケンス許可状態を取得 @n
					Get sequence step enables @n
					based on VL53L0X_GetSequenceStepEnables()
			@param[out]	enables	ビット集合の参照
		 */
		//-----------------------------------------------------------------//
		void get_sequence_step_enables(SequenceStepEnables& enables)
		{
			uint8_t sequence_config = read_(reg_addr::SYSTEM_SEQUENCE_CONFIG);

			enables.tcc          = (sequence_config >> 4) & 0x1;
			enables.dss          = (sequence_config >> 3) & 0x1;
			enables.msrc         = (sequence_config >> 2) & 0x1;
			enables.pre_range    = (sequence_config >> 6) & 0x1;
			enables.final_range  = (sequence_config >> 7) & 0x1;
		}


		//-----------------------------------------------------------------//
		/*!
			@brief	シーケンス許可状態に対するタイムアウトの取得 @n
					Get sequence step timeouts @n
					based on get_sequence_step_timeout(), @n
					but gets all timeouts instead of just the requested one, and also stores @n
					intermediate values
			@param[in]	enables		ビット集合の参照
			@param[out]	timeouts	タイムアウト集合への参照	
		 */
		//-----------------------------------------------------------------//
		void get_sequence_step_timeouts(const SequenceStepEnables& enables, SequenceStepTimeouts& timeouts)
		{
			timeouts.pre_range_vcsel_period_pclks =
				get_vcsel_pulse_period(vcselPeriod::PreRange);

			timeouts.msrc_dss_tcc_mclks = read_(reg_addr::MSRC_CONFIG_TIMEOUT_MACROP) + 1;
			timeouts.msrc_dss_tcc_us = timeout_mclks_to_microseconds(timeouts.msrc_dss_tcc_mclks,
										   							 timeouts.pre_range_vcsel_period_pclks);

			timeouts.pre_range_mclks = decode_timeout(read16_(reg_addr::PRE_RANGE_CONFIG_TIMEOUT_MACROP_HI));
			timeouts.pre_range_us = timeout_mclks_to_microseconds(timeouts.pre_range_mclks,
																  timeouts.pre_range_vcsel_period_pclks);

			timeouts.final_range_vcsel_period_pclks =
				get_vcsel_pulse_period(vcselPeriod::FinalRange);

			timeouts.final_range_mclks = decode_timeout(
				read16_(reg_addr::FINAL_RANGE_CONFIG_TIMEOUT_MACROP_HI)
			);

			if(enables.pre_range) {
				timeouts.final_range_mclks -= timeouts.pre_range_mclks;
			}

			timeouts.final_range_us = timeout_mclks_to_microseconds(timeouts.final_range_mclks,
																	timeouts.final_range_vcsel_period_pclks);
		}


		//-----------------------------------------------------------------//
		/*!
			@brief	@n
					Set the measurement timing budget in microseconds, which is the time allowed @n
					for one measurement; the ST API and this library take care of splitting the @n
					timing budget among the sub-steps in the ranging sequence. A longer timing @n
					budget allows for more accurate measurements. Increasing the budget by a @n
					factor of N decreases the range measurement standard deviation by a factor of @n
					sqrt(N). Defaults to about 33 milliseconds; the minimum is 20 ms. @n
					based on VL53L0X_set_measurement_timing_budget_micro_seconds()
			@param[in]	budget_us	マイクロ秒
		 */
		//-----------------------------------------------------------------//
		bool set_measurement_timing_budget(uint32_t budget_us)
		{
			// note that this is different than the value in get_
			static constexpr uint16_t StartOverhead      = 1320;
			static constexpr uint16_t EndOverhead        = 960;
			static constexpr uint16_t MsrcOverhead       = 660;
			static constexpr uint16_t TccOverhead        = 590;
			static constexpr uint16_t DssOverhead        = 690;
			static constexpr uint16_t PreRangeOverhead   = 660;
			static constexpr uint16_t FinalRangeOverhead = 550;

			uint32_t constexpr MinTimingBudget = 20000;

			if(budget_us < MinTimingBudget) { return false; }

			uint32_t used_budget_us = StartOverhead + EndOverhead;

			SequenceStepEnables enables;
			SequenceStepTimeouts timeouts;

			get_sequence_step_enables(enables);
			get_sequence_step_timeouts(enables, timeouts);

			if(enables.tcc) {
				used_budget_us += (timeouts.msrc_dss_tcc_us + TccOverhead);
			}

			if(enables.dss) {
				used_budget_us += 2 * (timeouts.msrc_dss_tcc_us + DssOverhead);
			} else if(enables.msrc) {
				used_budget_us += (timeouts.msrc_dss_tcc_us + MsrcOverhead);
			}

			if(enables.pre_range) {
				used_budget_us += (timeouts.pre_range_us + PreRangeOverhead);
			}

			if(enables.final_range) {
				used_budget_us += FinalRangeOverhead;

				// "Note that the final range timeout is determined by the timing
				// budget and the sum of all other timeouts within the sequence.
				// If there is no room for the final range timeout, then an error
				// will be set. Otherwise the remaining time will be applied to
				// the final range."

				if(used_budget_us > budget_us) {
					// "Requested timeout too big."
					return false;
				}

				uint32_t final_range_timeout_us = budget_us - used_budget_us;

				// set_sequence_step_timeout() begin
				// (SequenceStepId == VL53L0X_SEQUENCESTEP_FINAL_RANGE)

				// "For the final range timeout, the pre-range timeout
				//  must be added. To do this both final and pre-range
				//  timeouts must be expressed in macro periods MClks
				//  because they have different vcsel periods."

				uint16_t final_range_timeout_mclks =
					timeout_microseconds_to_mclks(final_range_timeout_us,
												  timeouts.final_range_vcsel_period_pclks);

				if(enables.pre_range) {
					final_range_timeout_mclks += timeouts.pre_range_mclks;
				}

				write16_(reg_addr::FINAL_RANGE_CONFIG_TIMEOUT_MACROP_HI,
					encode_timeout(final_range_timeout_mclks));

				// set_sequence_step_timeout() end

				measurement_timing_budget_us_ = budget_us; // store for internal reuse
			}
			return true;
		}


		//-----------------------------------------------------------------//
		/*!
			@brief	連続モードでの計測 @n
					Start continuous ranging measurements. If period_ms (optional) is 0 or not @n
					given, continuous back-to-back mode is used (the sensor takes measurements as @n
					often as possible); otherwise, continuous timed mode is used, with the given @n
					inter-measurement period in milliseconds determining how often the sensor @n
					takes a measurement. @n
					based on VL53L0X_StartMeasurement()
			@param[in]	period_ms	ミリ秒
		 */
		//-----------------------------------------------------------------//
		void start_continuous(uint32_t period_ms)
		{
			write_(static_cast<reg_addr>(0x80), 0x01);
			write_(static_cast<reg_addr>(0xFF), 0x01);
			write_(static_cast<reg_addr>(0x00), 0x00);
			write_(static_cast<reg_addr>(0x91), stop_variable_);
			write_(static_cast<reg_addr>(0x00), 0x01);
			write_(static_cast<reg_addr>(0xFF), 0x00);
			write_(static_cast<reg_addr>(0x80), 0x00);

			if(period_ms != 0) {
				// continuous timed mode

				// VL53L0X_SetInterMeasurementPeriodMilliSeconds() begin

				uint16_t osc_calibrate_val = read16_(reg_addr::OSC_CALIBRATE_VAL);

				if(osc_calibrate_val != 0) {
					period_ms *= osc_calibrate_val;
				}

				write32_(reg_addr::SYSTEM_INTERMEASUREMENT_PERIOD, period_ms);

				// VL53L0X_SetInterMeasurementPeriodMilliSeconds() end

				write_(reg_addr::SYSRANGE_START, 0x04); // VL53L0X_REG_SYSRANGE_MODE_TIMED
			} else {
				// continuous back-to-back mode
				write_(reg_addr::SYSRANGE_START, 0x02); // VL53L0X_REG_SYSRANGE_MODE_BACKTOBACK
			}
		}


		//-----------------------------------------------------------------//
		/*!
			@brief	計測の停止 @n
					Stop continuous measurements @n
					based on VL53L0X_StopMeasurement()
			@param[in]	period_ms	ミリ秒
		 */
		//-----------------------------------------------------------------//
		void stop_continuous()
		{
			write_(reg_addr::SYSRANGE_START, 0x01); // VL53L0X_REG_SYSRANGE_MODE_SINGLESHOT

			write_(static_cast<reg_addr>(0xFF), 0x01);
			write_(static_cast<reg_addr>(0x00), 0x00);
			write_(static_cast<reg_addr>(0x91), 0x00);
			write_(static_cast<reg_addr>(0x00), 0x01);
			write_(static_cast<reg_addr>(0xFF), 0x00);
		}


		//-----------------------------------------------------------------//
		/*!
			@brief	連続モードでの距離の取得（ミリメートル）@n
					Returns a range reading in millimeters when continuous mode is active @n
					(readRangeSingleMillimeters() also calls this function after starting a @n
					single-shot range measurement)
			@return 距離（ミリメートル）
		 */
		//-----------------------------------------------------------------//
		uint16_t read_range_continuous_millimeters()
		{
			start_timeout_();
			while((read_(reg_addr::RESULT_INTERRUPT_STATUS) & 0x07) == 0) {
				if(check_timeout_expired_()) {
					did_timeout_ = true;
					return 65535;
				}
  			}

			// assumptions: Linearity Corrective Gain is 1000 (default);
			// fractional ranging is not enabled
			uint16_t range = read16_(static_cast<reg_addr>(
				static_cast<uint8_t>(reg_addr::RESULT_RANGE_STATUS) + 10));

			write_(reg_addr::SYSTEM_INTERRUPT_CLEAR, 0x01);

			return range;
		}


		//-----------------------------------------------------------------//
		/*!
			@brief	単発モードでの距離の取得（ミリメートル）@n
					Performs a single-shot range measurement and returns the reading in @n
					millimeters @n
					based on VL53L0X_PerformSingleRangingMeasurement()
			@return 距離（ミリメートル）
		 */
		//-----------------------------------------------------------------//
		uint16_t read_range_single_millimeters()
		{
			write_(static_cast<reg_addr>(0x80), 0x01);
			write_(static_cast<reg_addr>(0xFF), 0x01);
			write_(static_cast<reg_addr>(0x00), 0x00);
			write_(static_cast<reg_addr>(0x91), stop_variable_);
			write_(static_cast<reg_addr>(0x00), 0x01);
			write_(static_cast<reg_addr>(0xFF), 0x00);
			write_(static_cast<reg_addr>(0x80), 0x00);

			write_(reg_addr::SYSRANGE_START, 0x01);

			// "Wait until start bit has been cleared"
			start_timeout_();
			while(read_(reg_addr::SYSRANGE_START) & 0x01) {
				if(check_timeout_expired_()) {
					did_timeout_ = true;
					return 65535;
				}
			}

			return read_range_continuous_millimeters();
		}


		//-----------------------------------------------------------------//
		/*!
			@brief	タイムアウトのデコード @n
					Decode sequence step timeout in MCLKs from register value @n
					based on VL53L0X_decode_timeout() @n
					Note: the original function returned a uint32_t, but the return value is @n
					always stored in a uint16_t.
			@param[in]	reg_val	レジスターの値
			@return 時間
		 */
		//-----------------------------------------------------------------//
		uint16_t decode_timeout(uint16_t reg_val)
		{
			// format: "(LSByte * 2^MSByte) + 1"
			return ((reg_val & 0x00FF) << ((reg_val & 0xFF00) >> 8)) + 1;
		}


		// Encode sequence step timeout register value from timeout in MCLKs
		// based on VL53L0X_encode_timeout()
		// Note: the original function took a uint16_t, but the argument passed to it
		// is always a uint16_t.
		uint16_t encode_timeout(uint16_t timeout_mclks)
		{
			// format: "(LSByte * 2^MSByte) + 1"

			uint32_t ls_byte = 0;
			uint16_t ms_byte = 0;

			if(timeout_mclks > 0) {
				ls_byte = timeout_mclks - 1;

				while((ls_byte & 0xFFFFFF00) > 0) {
					ls_byte >>= 1;
					ms_byte++;
				}

				return (ms_byte << 8) | (ls_byte & 0xFF);
			} else {
				return 0;
			}
		}


		// Convert sequence step timeout from MCLKs to microseconds with given VCSEL period in PCLKs
		// based on VL53L0X_calc_timeout_us()
		uint32_t timeout_mclks_to_microseconds(uint16_t timeout_period_mclks, uint8_t vcsel_period_pclks)
		{
			uint32_t macro_period_ns = calc_macro_period_(vcsel_period_pclks);

			return ((timeout_period_mclks * macro_period_ns) + (macro_period_ns / 2)) / 1000;
		}


		// Convert sequence step timeout from microseconds to MCLKs with given VCSEL period in PCLKs
		// based on VL53L0X_calc_timeout_mclks()
		uint32_t timeout_microseconds_to_mclks(uint32_t timeout_period_us, uint8_t vcsel_period_pclks)
		{
			uint32_t macro_period_ns = calc_macro_period_(vcsel_period_pclks);

			return (((timeout_period_us * 1000) + (macro_period_ns / 2)) / macro_period_ns);
		}


		// Set the return signal rate limit check value in units of MCPS (mega counts
		// per second). "This represents the amplitude of the signal reflected from the
		// target and detected by the device"; setting this limit presumably determines
		// the minimum measurement necessary for the sensor to report a valid reading.
		// Setting a lower limit increases the potential range of the sensor but also
		// seems to increase the likelihood of getting an inaccurate reading because of
		// unwanted reflections from objects other than the intended target.
		// Defaults to 0.25 MCPS as initialized by the ST API and this library.
		bool set_signal_rate_limit(float limit_Mcps)
		{
			if(limit_Mcps < 0 || limit_Mcps > 511.99) { return false; }

			// Q9.7 fixed point format (9 integer bits, 7 fractional bits)
			write16_(reg_addr::FINAL_RANGE_CONFIG_MIN_COUNT_RATE_RTN_LIMIT, limit_Mcps * (1 << 7));
			return true;
		}


		// Get the return signal rate limit check value in MCPS
		float get_signal_rate_limit()
		{
			return static_cast<float>(
				read16_(reg_addr::FINAL_RANGE_CONFIG_MIN_COUNT_RATE_RTN_LIMIT) / (1 << 7));
		}


		// Get the measurement timing budget in microseconds
		// based on VL53L0X_get_measurement_timing_budget_micro_seconds()
		// in us
		uint32_t get_measurement_timing_budget()
		{
			// note that this is different than the value in set_
			static constexpr uint16_t StartOverhead     = 1910;
			static constexpr uint16_t EndOverhead        = 960;
			static constexpr uint16_t MsrcOverhead       = 660;
			static constexpr uint16_t TccOverhead        = 590;
			static constexpr uint16_t DssOverhead        = 690;
			static constexpr uint16_t PreRangeOverhead   = 660;
			static constexpr uint16_t FinalRangeOverhead = 550;

			// "Start and end overhead times always present"
			uint32_t budget_us = StartOverhead + EndOverhead;

			SequenceStepEnables enables;
			SequenceStepTimeouts timeouts;
			get_sequence_step_enables(enables);
			get_sequence_step_timeouts(enables, timeouts);

			if(enables.tcc) {
				budget_us += (timeouts.msrc_dss_tcc_us + TccOverhead);
			}

			if(enables.dss) {
				budget_us += 2 * (timeouts.msrc_dss_tcc_us + DssOverhead);
			} else if(enables.msrc) {
				budget_us += (timeouts.msrc_dss_tcc_us + MsrcOverhead);
			}

			if(enables.pre_range) {
				budget_us += (timeouts.pre_range_us + PreRangeOverhead);
			}

			if(enables.final_range) {
				budget_us += (timeouts.final_range_us + FinalRangeOverhead);
			}

			// store for internal reuse
			measurement_timing_budget_us_ = budget_us;
			return budget_us;
		}
	};
}
