hirakuni45/RX/common/can_io.hpp

#pragma once
//=========================================================================//
/*!	@file
	@brief	RX グループ・CAN I/O 制御 @n
			・CAN クロックは、正確に一致しない場合、エラーとする。 @n
			・CAN ポートに、CAN バス・トランシーバーを接続する。 @n
			・CAN ペリフェラル内蔵 FIFO 機能は使わない設計とする。
    @author 平松邦仁 (hira@rvf-rc45.net)
	@copyright	Copyright (C) 2019, 2024 Kunihito Hiramatsu @n
				Released under the MIT license @n
				https://github.com/hirakuni45/RX/blob/master/LICENSE
*/
//=========================================================================//
#include "common/renesas.hpp"
#include "common/vect.h"
#include "common/delay.hpp"
#include "common/format.hpp"

namespace device {

	//+++++++++++++++++++++++++++++++++++++++++++++++++++++++++++++++++++++//
	/*!
		@brief  CAN 制御定義クラス
	*/
	//+++++++++++++++++++++++++++++++++++++++++++++++++++++++++++++++++++++//
	class can_io_def {
	public:

		//+++++++++++++++++++++++++++++++++++++++++++++++++++++++++++++++++//
		/*!
			@brief  CAN スピード型
		*/
		//+++++++++++++++++++++++++++++++++++++++++++++++++++++++++++++++++//
		enum class SPEED {
			_50K  =    50'000,	///<  50 Kbps（標準ではない）
			_100K =   100'000,	///< 100 Kbps（標準ではない）
			_125K =   125'000,	///< 125 Kbps
			_250K =   250'000,	///< 250 Kbps
			_500K =   500'000,	///< 500 Kbps
			_750K =   750'000,	///< 750 Kbps（標準ではない）
			_1M   = 1'000'000	///< 1 Mbps
		};


		//+++++++++++++++++++++++++++++++++++++++++++++++++++++++++++++++++//
		/*!
			@brief  CAN モード型（動作モード）
		*/
		//+++++++++++++++++++++++++++++++++++++++++++++++++++++++++++++++++//
		enum class MODE : uint8_t {
			RESET,		///< リセット・モード
			HALT,		///< Halt モード
			OPERATION,	///< オペレーション・モード
			SLEEP,		///< スリープ・モード
		};


		//+++++++++++++++++++++++++++++++++++++++++++++++++++++++++++++++++//
		/*!
			@brief  割り込みレベル設定構造体
		*/
		//+++++++++++++++++++++++++++++++++++++++++++++++++++++++++++++++++//
		struct interrupt_t {
			ICU::LEVEL	rxm_level;		///< RXM 割り込みレベル
			ICU::LEVEL	txm_level;		///< TXM 割り込みレベル
			ICU::LEVEL	error_level;	///< エラー割り込みレベル
			explicit interrupt_t(ICU::LEVEL lvl, ICU::LEVEL erl = ICU::LEVEL::NONE) noexcept :
				rxm_level(lvl), txm_level(lvl), error_level(erl)
			{ }
			interrupt_t(ICU::LEVEL rxl, ICU::LEVEL txl, ICU::LEVEL erl = ICU::LEVEL::NONE) noexcept :
				rxm_level(rxl), txm_level(txl), error_level(erl)
			{ }
		};


		//-----------------------------------------------------------------//
		/*!
			@brief  CAN フレームの表示
			@param[in]	src		フレーム
			@param[in]	ht		ヘッダー文字列
		*/
		//-----------------------------------------------------------------//
		static void list(const can_frame& src, const char* ht = "") noexcept
		{
			if(src.get_RTR()) {
				utils::format("%sR: ") % ht;
			} else {
				utils::format("%sD: ") % ht;
			}
			if(src.get_IDE()) {
				uint32_t id = src.get_id();
				utils::format("ID: ext 0x%08X (%u)\n") % id % id;
			} else {
				utils::format("ID: std 0x%03X (%u)\n") % src.get_SID() % src.get_SID();
			}

			auto dlc = src.get_DLC();
			utils::format("%s(%u):") % ht % dlc;
			for(uint32_t i = 0; i < dlc; ++i) {
				utils::format(" %02X") % static_cast<uint16_t>(src.get_DATA(i));
			}
			utils::format("\n");
			utils::format("%sTS: %u\n") % ht % src.get_TS();
		}
	};


	//+++++++++++++++++++++++++++++++++++++++++++++++++++++++++++++++++++++//
	/*!
		@brief  CAN 制御クラス
		@param[in]	CAN		CAN ペリフェラル定義クラス
		@param[in]	RBF		受信バッファクラス (utils::fixed_fifo<can_frame, N>)
		@param[in]	SBF		送信バッファクラス (utils::fixed_fifo<can_frame, N>)
		@param[in]	PSEL	ポート候補
	*/
	//+++++++++++++++++++++++++++++++++++++++++++++++++++++++++++++++++++++//
	template <class CAN, class RBF, class SBF, port_map::ORDER PSEL = port_map::ORDER::FIRST>
	class can_io : public can_io_def {

		static_assert(RBF::size() > 16, "Receive buffer is too small.");
		static_assert(SBF::size() > 16, "Transmission buffer is too small.");

	public:

		typedef CAN peripheral_type;
		typedef RBF recv_buffer_type;
		typedef SBF send_buffer_type;
		static constexpr auto port_select_type = PSEL;

		static constexpr uint32_t RX_MB_TOP = 0;	///< 受信用メールボックス先頭番号
		static constexpr uint32_t RX_MB_NUM = 8;	///< 受信用メールボックス数（最小８）
		static constexpr uint32_t TX_MB_TOP = 8;	///< 送信用メールボックス先頭番号
		static constexpr uint32_t TX_MB_NUM = 4;	///< 送信用メールボックス数（最小４）

	private:
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
