hirakuni45/RX/(commit log)

2017-06-25 update http_server for socket
2017-06-26 update device list
2017-06-26 update ARP frame
2017-06-28 fix interrupt memory guard
    [arp.hpp]
2017-07-04 update power on initial port, LED indicator
2017-07-04 update LED indicator
2017-07-05 fix interrupt controle
2017-07-06 update CMT timer class
2017-07-10 fix ip-adrs, mac reload
    [tcp.hpp]
2017-07-12 fix TCP client SYN/ACK management
    [tcp.hpp]
2017-07-13 new file
    [rx24t_sub.sch]
2017-07-15 update PHY device define
2017-07-17 update indicator LED
2017-07-18 update debug printf
2017-07-20 fix SCI interrupt lock
    [main.cpp]
2017-07-20 update SCI interrupt lock
2017-07-20 change SCI port / LED Indicator
2017-07-20 update SD card mount reactions
2017-07-21 update DP83822 LED Controle
2017-07-24 update task group (frame slice)
2017-07-24 update interrupt level for CMT
2017-07-26 update LED ctrl for TI-PHY
2017-07-27 update switch SD/Flash
2017-08-11 new project
    [FTDI_serial.sch, MotorLogger.kicad_pcb, MotorLogger.sch, RX24T_base.sch, SDC_if.sch]
2017-08-15 update MTU interrupt
2017-08-15 update interrupt pheriphral
2017-08-25 update SPI/MODE
2017-08-25 update MTU PWM
2017-08-29 fix MLSD timezone offset
    [ftp_server.hpp]
2017-08-29 fix inline for get_timezone_offset
    [time.h]
2017-09-13 add device
2017-09-14 new file (Soft I2C I/O driver)
2017-09-15 fix multi byte recv
    [iica_io.hpp]
2017-09-24 fix zero divide exceptions
    [NTCTH.hpp]
2017-10-03 fix client stop blockking
    [ethernet_client.hpp]
2017-10-14 fix startup init port
    [main.cpp]
2017-10-17 change interrupt level
2017-10-17 fix disp_time string output
    [main.hpp]
2017-10-24 fix PASV port stop
    [ftp_server.hpp]
2017-10-24 update ETH buffer num, interrupt level
2017-10-24 update timer
2017-10-24 update selectable interrupt-A manage
2017-10-24 update TPU interrupt management
2017-10-24 fix TPU prs = 0
    [tpu_io.hpp]
2017-10-24 update TPU timer
2017-10-25 update CMT non-interrupt sync launch task
2017-11-03 update SPI api for SCI interface
2017-11-04 fix http buffer empty (+1024)
    [main.hpp]
2017-11-04 update file probe API
2017-11-05 fix buffer over run
    [ftp_server.hpp]
2017-11-05 fix buffer over insert EOT code
    [string_utils.hpp]
2017-11-05 update hard reset key operations
    [main.hpp]
2017-11-05 fix buffer over run for file path
    [ftp_server.hpp]
2017-11-05 fix utf8_to_sjis prototype
2017-11-05 fix full path create
    [sdc_io.hpp]
2017-11-05 update utf8_to_sjis prototype
2017-11-21 update prototype
2017-12-19 update SCI2 SPI
2017-12-21 update LTC special driver
2017-12-26 new file (soft SPI)
2017-12-27 update test interval for SPI
2017-12-27 update IRQ manage, first sample data destroy
2017-12-31 update first LED blink
2018-01-19 update 1000Hz/100Hz timer service
2018-01-19 update TELNET service switch
2018-01-26 update LED indicator for 1Hz
2018-01-28 update sample rate
2018-01-31 fix: RX600 group template include path
    [sdhi_io.hpp]
2018-01-31 update: disable MEDIAN filter
2018-02-01 fix: SCIF manage for interrupt/polling
    [scif_io.hpp]
2018-02-02 update: SD error log, fix: operating time
    [main.cpp]
2018-02-04 update: telnet data flow manage
2018-02-04 update: version, build-id print
2018-02-09 update: wave frame read
2018-02-14 cleanup: API prototype
2018-02-14 update: soft/hard-reset for LOG system
    [main.cpp]
2018-03-18 update: enable interrupt for ethernet interrupt handler
2018-03-18 update: add enable/disable interrupt function for supervisor mode
2018-03-18 update: mount manage
2018-03-27 update: disable interrupt for ethernet handler
2018-03-30 update: power ctrl for null_port
2018-04-06 update: flush manage, string manage for fixed_string
    [ethernet.hpp]
2018-04-12 update: POSIX API, FatFs mount status
2018-04-12 update: mount state API for POSIX
2018-04-13 update: mount retry
2018-04-13 update: 120 sec in reset loop 7 times to aborted write file
    [main.cpp]
2018-05-11 fix: RX64M/RX71M RSPI power config manage
2018-05-16 update: SCI/I2C
2018-05-20 update: reset voltage 2.94V
    [ofs.c]
2018-05-21 update: fifo to fixed_fifo class
    [main.cpp]
2018-05-21 update: LED typedef
2018-05-21 update: DMAC sample
2018-05-21 update: interrupt manage
2018-05-23 update: error message for dir_list class
    [sdc_io.hpp]
2018-05-27 update: not turn TPU interrupt flag
2018-05-30 update: DMAC manage for interrupt trigger
2018-05-30 update: add API (return to interrupt vector)
2018-06-01 update: SD error to mute
    [main.cpp]
2018-06-12 update: enable LCD device for ctrl
2018-06-13 update: group interrupt suport API
2018-06-14 update: group interrupt manage
2018-06-14 update: GLCDC interrupt manage, LCD config for maybe 60Hz
2018-06-15 update: setup frame buffer address
2018-06-16 update: strip STL
2018-06-17 update: Setting for SCI/I2C port
2018-06-18 update: famipad pin assign
2018-06-25 update: propotional size sample
2018-06-25 update: Font sample
2018-06-26 update: I2C
2018-07-04 update: LED port
2018-07-06 update: I2C manage
2018-07-12 update: Version 1.04 A/D Conversion timming (Conversion Fail)
    [main.cpp]
2018-07-19 update: cleanup soft I2C
2018-07-19 update: device reset sequence
    [FT5206.hpp]
2018-07-20 update: SCI/I2C port setting
2018-07-20 update: I2C manage for polling
2018-07-21 update: I2C error state
    [sci_io.hpp]
2018-07-22 update: TEIx interrupt vector
2018-07-22 update: RX65x/RX64M interrupt vector diff
2018-07-22 update: I2C start/stop condition error handling
    [sci_io.hpp]
2018-07-22 update: separate SPI/I2C
2018-07-22 update: split I2C/SPI
2018-07-22 update: dummy interrupt level
2018-07-22 update: interrupt for SCI/I2C
2018-07-25 update: change frame packet size 128 to 256
2018-07-27 add: new project for FIRST_sample (led_sample)
2018-07-30 update: illegual frame to lan restart
2018-07-30 update: SDHI port clock probe
2018-07-31 update: usb device include path
2018-08-02 update: SCI/SPI port mapping (SCK)
2018-08-05 update: adc manage
2018-08-14 fix: class name for intmath (imath)
    [intmath.hpp]
2018-08-27 fix: sign bit fail loop for binary, octal
    [format.hpp]
2018-09-01 fix: startup device for ready
    [FT5206.hpp]
2018-09-01 update: touch device startup
2018-09-05 fix: read block num
    [file_io.hpp]
2018-09-22 update: version NO, interval for 100Hz
2018-09-25 update: fixed_stack API name
    [filer.hpp]
2018-09-25 update: startup manage for SCI(UART)
2018-09-25 update: motor pulse output
2018-09-25 fix: enum class (OUTPUT_TYPE) typo
    [mtu_io.hpp]
2018-10-12 update: test case render
2018-10-18 update: comment for SCI5 'Version B Device'
2018-10-22 update: cleanup fifo to fixed_fifo
    [main.cpp]
2018-10-22 update: fifo to fixed_fifo
    [main.cpp]
2018-10-28 update: soft SPI clock speed
2018-10-30 update: Blink LED rate
2018-10-30 update: interrupt vector manage
2018-10-31 update: add interrupt vector API
2018-10-31 update: pin config
2018-10-31 update: interrupt vector
2018-11-03 update: wire color comment
2018-11-03 update: SDC spi clock
2018-11-03 update: interrupt vector, cleanup
2018-11-03 update: interrupt vector API
2018-11-13 fix: block size up to 8
    [picojpeg_in.hpp]
2018-11-13 fix: decode final status
    [picojpeg_in.hpp]
2018-11-14 update: USB interrupt vector
2018-11-19 update: touch device manage
2018-11-19 update: mount NG case for remount
2018-11-19 update: float format support switch for compile
2018-11-20 fix: up scaling width/height
    [scaling.hpp]
2018-11-22 fix: pointer miss match for scan_ext
    [string_utils.hpp]
2018-11-22 update: probe, info, API (for filename)
2018-11-24 update: protected for power config
2018-11-26 update: TFT LCD driver
2018-11-30 update: siguneture device guard
2018-11-30 update: RIIC interrupt vector
2018-12-01 update: cleanup, interrupt vector
2018-12-01 update: interrupt vector, peripheral
2018-12-02 update: new interrupt vector
2018-12-02 update: add interrupt vector
2018-12-12 update: interrupt vector, RX66T
2019-01-07 update: fix IOE5 interrupt vector
2019-01-09 update: change 'power_cfg' to 'power_mgr'
2019-01-15 update: API prototype
2019-01-22 update: NES pad pin assign
2019-01-26 update: frame buffer start address
2019-01-26 update: frame buffer prototype
2019-01-26 update: frame buffer manage
2019-02-06 update: test for frame renderring
2019-02-06 update: cleanup c++ frame work
2019-02-07 update: Frame buffer pointer API
2019-02-11 add: a new file
    [ETHER_PHY.sch, LCD_IF.sch, POWER.sch, SDC_IF.sch, board.kicad_pcb, board.sch]
2019-02-15 update: cleanup
    [ETHER_PHY.sch, LCD_IF.sch, POWER.sch, SDC_IF.sch, board.sch]
2019-02-26 update: change prototype for 'drw2d' class
2019-02-26 update: change prototype for soft render class
2019-02-26 update: change prototype render class
2019-03-09 fix: draw_text return to position
    [graphics.hpp]
2019-03-18 update: renderring ascii font case
2019-03-31 update: defaine directory to list by frame
2019-04-01 fix: d2_color types for RGB to BGR
    [color.hpp]
2019-04-02 update: round frame button
2019-04-03 update: button style
2019-04-04 update: reset recv error flags
    [sci_io.hpp]
2019-04-05 update: recv error collection
    [sci_io.hpp]
2019-04-10 update: flash prog device name
2019-04-10 fix: ICLK frequency for RX66T
    [main.cpp]
2019-04-10 fix: device name for RX66T
2019-04-10 fix: device type for RX66T
2019-04-11 update: add RX66T device
2019-04-12 update: In the case of RX66T, the master clock becomes PCLKA in the case of SCI11.
2019-04-12 update: UID command, print for flash drive clock
2019-04-15 update: selectable interrupt manage
2019-04-15 update: dma cycle interrupt manage for CPU
2019-04-16 update: ICU management for selected interrupt
2019-04-16 update: selectable interrupt
2019-04-21 fix: fini_array functions call
    [init.c]
2019-04-30 update: first radio button select
2019-05-01 fix: rx_prog device-name for RX71M
2019-05-04 fix: %g, %G supress under point
    [format.hpp]
2019-05-06 fix: decimal mode fail
    [format.hpp]
2019-06-22 Update: KiCAD version update
    [ETHER_PHY.sch, JTAG_IF.sch, LCD_IF.sch, POWER.sch, SDC_IF.sch, SDRAM.sch, WIFI.sch, board.sch]
2019-06-22 Update: KiCAD update
2019-07-30 Update: 2 LED for GR-KAEDE
2019-08-01 Fix: interrupt level
2019-08-01 Update: Enable RXv2 assembler
2019-08-01 Update: Move RXv2 cpu type option to assembler
2019-08-07 Update: ff13c mmc driver path
2019-08-11 Update: thread safe on FreeRTOS
2019-08-11 Update: FreeRTOS/FatFs sample
2019-08-14 Fix: mount flag for filer
    [main.cpp]
2019-09-01 Fix: include ifdef for FAT_FS
    [string_utils.hpp]
2019-10-13 Fix: over write mode
    [file_io.hpp]
2019-10-18 Update: SDHI power manage
2019-10-18 Update: add new class driver
2019-10-21 Fix: ACMD41 Voltage window
    [sdhi_io.hpp]
2019-10-21 Update: SDC_POWER port for Soft-SPI
2019-10-21 Update: SDHI interface, SDC-Power controle
2019-10-26 Update: IICA stall break
    [iica_io.hpp]
2019-10-26 Update: Safe port mode switch
2019-10-31 Update: add KiCad sch-bak
2019-11-03 Fix: error state for load
    [png_in.hpp]
2019-11-03 Update: skip for alpha:0
    [scaling.hpp]
2019-11-03 Update: plot operator prototype
2019-11-09 Update: footprint
2019-11-11 Update: KiCAD's file ext
2020-02-10 Update: USB interrupt vector (USBI, USBR)
2020-03-22 Move: move to legacy code
    [controller.sch, dcdc_converter.sch]
2020-03-22 Update: USB HHID/driver
2020-03-28 Update: RX72T sample
2020-03-28 Update: cleanup for RX72M device
    [Clock.sch, Power.sch, RX72M.sch, SDIO.sch, SDRAM.sch, USB.sch]
2020-03-28 Update: RX65N device
    [ETHER_PHY.sch, JTAG_IF.sch, LCD_IF.sch, POWER.sch, SDC_IF.sch, SDRAM.sch, WIFI.sch, board.sch]
2020-03-28 Update: clock speed fix for RX72T
    [main.cpp]
2020-04-02 Update: New device for RX72N
2020-04-02 Add: RX72T board project
    [MaxRX72T.kicad_pcb]
2020-04-02 Add: a lost file
    [USB_IF.sch]
2020-04-05 Update: power_port, write_protect_port controle, cleanup
2020-04-06 Update: Tunning soft delay loop para for RX72N
2020-04-08 Update: SSIE, Other interrupt manage
2020-04-12 Update: delay loop for, serial/para wait loop
2020-04-21 Update: Add a WUNI interrupt vector
2020-04-28 Fix: cmt_io get_rate API
    [cmt_io.hpp]
2020-04-29 Update: SCI6/I2C/P42,P43
2020-05-01 Fix: mmc_io power-port level
    [main.cpp]
2020-05-01 Update: RX64M DIY board picture
2020-05-02 Fix: sound_out constructor value
    [main.cpp]
2020-05-03 Update: file error collections
    [file_io.hpp, main.cpp, renesas.hpp, sdhi_io.hpp]
2020-05-04 Update: A provisional workaround for g++ stalling
2020-05-07 Update: sample count test
2020-05-07 Update: sample count API
2020-05-31 Update: PORT class, low active for power controle
2020-06-01 Fix: spi context destroy management
    [mmc_io.hpp]
2020-06-01 Update: SPI manage (destroy), mount manage
2020-06-07 Fix: erase-page, write-page, wait for command
    [main.cpp]
2020-06-07 Update: 3.3V regulator bypass capacity
    [USB_CP2102N.sch]
2020-06-29 Fix: setup sample rate for SSIE
    [main.cpp]
2020-06-29 Add: a new file for KiCAD
    [DSO_FE.kicad_pcb, DSO_FE.sch]
2020-07-16 Update: compile option, auto detected gcc(GNU-RX, current gcc)
2020-08-13 Add: FatFS (ff14)
    [mkfs.xlsx]
2020-08-20 Update: manage current path
2020-09-19 Add: KiCAD project
    [core_board.kicad_pcb, core_board.sch]
2020-10-27 Remove: Moved to a joint project
2020-10-29 Update: cleanup interrupt
2020-11-01 Fix: RX72N port map
    [main.cpp]
2020-11-01 Fix: receive remoto frame for mail-box, interrupt flag
    [can_io.hpp]
2020-11-01 Update: check power_mgr status
2020-11-01 Update: interrupt level check
2020-11-01 Update: stdapi error message output
    [main.cpp]
2020-11-01 Fix: RX71M CAN port settings
    [main.cpp]
2020-11-01 Update: ID filter
2020-11-06 Add: can-if circuit for RX72N Envision Kit
    [canif.kicad_pcb, canif.sch]
2020-11-13 Update: cleanup assembler option
2020-11-16 Update: assembler option
2020-11-17 Update: assembler options
2020-11-19 Fix: sign_ flag initialization
    [format.hpp]
2020-11-25 Update: memory button, exp, manage
2020-11-27 Update: remove skip space
    [basic_arith.hpp]
2020-11-29 Move: a move project
    [Analog.sch, FTDI_serial.sch, MotorLogger.kicad_pcb, MotorLogger.sch, RX24T_base.sch, SDC_if.sch]
2020-11-29 Delete: move project, then delete
    [Analog.sch, FTDI_serial.sch, MotorLogger.kicad_pcb, MotorLogger.sch, RX24T_base.sch, SDC_if.sch]
2020-12-02 Fix: ICUC interrupt vector
2020-12-12 Update: interrupt pad
2020-12-19 Fix: scroll fail fill
    [text.hpp]
2020-12-19 Fix: clipping for line_h
    [graphics.hpp]
2020-12-28 Fix: widget disable state manage
    [widget_director.hpp]
2021-01-04 Fix: hold back color
    [text.hpp]
2021-01-11 Fix: reset touch state at disable widget
    [box.hpp, button.hpp, menu.hpp, slider.hpp, text.hpp, textbox.hpp, widget.hpp, widget_director.hpp]
2021-01-24 Update: voltage offset
    [DSO_FE.sch]
2021-01-27 Update: voltage info
2021-02-09 Update: add draw wire frame
2021-02-09 Update: double buffer switch for RX72N
2021-02-13 Update: switch render engine for DRW2D
2021-02-25 Update: if error management
    [dir_list.hpp]
2021-02-25 Update: SD mount management
2021-02-28 Fix: SD-CARD mount management for level meter
2021-03-25 Update: cleanup SCI-I2C
2021-03-25 Update: I2C, system_io prototype
2021-03-25 Update: system_io prototype
2021-03-25 Update: port_mapping case, ICU management, cleanup
2021-03-25 Update: I2C manage, system_io prototype
2021-03-25 Update: I2C management, cleanup
2021-03-25 Update: I2C management
2021-04-10 Update: GPTWx, HRPWM power management
2021-05-01 Update: RX72N 224 pin device, port
2021-05-02 Update: change device teritory
2021-05-10 Update: cleanup interrupt management
2021-07-31 Add: a new project (KiCAD) RX72T 100 PGA USB
    [CAN_IF.sch, JTAG_IF.sch, POWER.sch, RX72T.sch, SDC_IF.sch, USB_IF.sch, rx72t_100_pga_usb.kicad_pcb, rx72t_100_pga_usb.sch]
2021-08-09 Add: a new directory (KiCad footprint)
2021-08-14 Add: base pcb (manual power track)
    [rx72t_100_pga_usb_base.kicad_pcb]
2021-08-16 Add: a new file (RX72T PCB image)
2021-08-27 Update: group interrupt set API 'set_interrupt'
2021-09-03 Update: I2C project
2021-09-03 Update: I2C start API prototype, I2C error management
    [i2c_base.hpp, iica_io.hpp, sci_i2c_io.hpp, si2c_io.hpp]
2021-09-03 Update: cleanup I2C start API
2021-10-12 Fix: Fixed initialization method.
    [MAX7219.hpp]
2021-11-25 Fix: basic_arith, func analize
    [basic_arith.hpp, main.cpp]
2021-12-04 Update: selected interrupt
2021-12-04 Update: power management
2021-12-04 Update: Interval Timer Instance TPUx to MTUx
2021-12-04 Add: I2C monitor management
2021-12-12 Update: I2C monitor
2021-12-18 Update: I2C device management
2021-12-20 Update: add RX72T test case
2021-12-21 Update: LED blinking for read/write block
2022-02-18 Update: KiCAD version up for turn EXT
    [Clock.kicad_sch, Ether.kicad_sch, LCD.kicad_sch, MaxRX72M.kicad_sch, Power.kicad_sch, RX72M.kicad_sch, SDIO.kicad_sch, SDRAM.kicad_sch]
2022-05-13 Update: Added usage of FLIP function
    [main.cpp]
2022-05-13 Update: Add RX72T (Not working)
    [main.cpp]
2022-06-06 Update: Changed constant names from lower case to upper case.
2022-06-24 Update: footprint attribute
2022-06-27 Update: Fixing the mechanism for obtaining peripheral values
    [cmtw_mgr.hpp, mtu_io.hpp, qspi_io.hpp, sci_i2c_io.hpp, sci_spi_io.hpp, scif_io.hpp]
2022-07-03 Update: fix LCD org address for RX72N
    [main.cpp]
2022-07-16 Update: sample for 'spinbox'
2022-07-18 Update: add progress sample code
2022-07-26 Update: add key_asc sample
2022-07-26 Update: change exec-func prototype
2022-08-07 Update: manage HID device
2022-08-14 Update: chanel, time info, trigger voltage
2022-08-17 Add: KiCAD 6 file
    [DSO_FE.kicad_sch, FrontEnd.kicad_sch, Power.kicad_sch, PreAmp.kicad_sch]
2022-08-28 Update: FrontEnd
    [DSO_FE.kicad_sch, FrontEnd.kicad_sch, Power.kicad_sch, PreAmp.kicad_sch]
2022-09-08 Update: add flow ctrl
2022-09-09 Update: add C++ hcd_usb driver
2022-09-11 Update: tinyusb driver
2022-10-05 Update: interrupt register (IR, IER, IPR)
2022-10-06 Add: new device (RX621/RX62N)
2022-10-25 Fix: MTU2 power management flag
2022-10-27 Update: Change current SCI port for RX62N
2022-11-16 Fix: GPT output enable
    [gpt_io.hpp]
2022-11-29 Fix: sci_io BRR setting
    [sci_io.hpp]
2022-12-01 Update: group interrupt management
2022-12-01 Update: power management for a peripheral
2022-12-09 Update: add API (get selectable interrupt level)
2022-12-11 Fix: protect register for power_mgr.hpp
2022-12-21 Update: add API (probe_baud)
2022-12-29 Update: Edit RX63N device
2022-12-29 Fix: add interrupt vector (S12ADI)
2023-01-11 Update: Correction related to AD/S12ADn
    [main.cpp]
2023-01-11 Update: Add group interrupt
2023-01-13 Update: Add 'probe_freq' API (constexpr)
2023-01-14 Update: Add RX63T_S (48/64pin device)
2023-03-02 Move: move to sdhi driver
2023-03-05 Fix: boost system clock
    [clock_profile.hpp]
2023-03-06 Add: a new file (Support I2C_sample for RX631)
2023-03-06 Fix: RX631 interrupt group
2023-03-22 Fix: fsqrt, RXv1 not support
    [vtx.hpp]
2023-04-13 Fix: ethernet port_map for RX64M/RX71M
    [device.hpp, main.cpp]
2023-09-27 Update: Add scif_io class sample
2023-09-30 Update: Support RSCI device I/O (RX26T)
2023-12-25 Fix: RX200 assemble define
2024-01-12 Fix: Forgetting to define the actual state of the template class
    [gpt_io.hpp]
2024-01-30 Add: Support RX140 board
    [RX140_board.kicad_pcb, RX140_board.kicad_sch]
2024-01-30 Add: RX140 board
    [Interface.kicad_sch, Power.kicad_sch]
2024-02-25 Fix: power management for CMTWx
2024-02-25 Fix: SCI1 order for RX64M/RX71M
    [main.cpp]
2024-02-26 Update: cleanup board_profile
2024-03-31 Update: tune soft delay timer loops
2024-03-31 Fix: lost initialization for DRW2D engine
    [main.cpp]
2024-05-12 Add: a new parts for KiCAD
2024-06-02 Add: a new project
    [StepDriver.dsn, StepDriver.kicad_pcb, StepDriver.kicad_sch]
2024-07-18 Update: Change current compiler to 202405
2024-07-27 Fix: zero suppress for strings
    [format.hpp]
2024-08-23 Update: fix first point number decode
    [basic_arith.hpp]
2024-09-30 Update: SCI error handling
    [main.cpp, rsci_io.hpp, sci_io.hpp, scif_io.hpp]
2024-12-05 Update: chage LED default port
2025-05-15 Add: KiCAD My footprint
2025-06-01 Add: Add 128K/48K device linker file
2025-09-29 Fix: MTU port map management (RX62x)
    [mtu_io.hpp]
2025-10-02 Update: sound key A, 440Hz to 432Hz
2025-10-04 Update: write in IRQ pin number, cleanup
2025-12-04 Update: cleanup 48 pin packeage
2025-12-09 Update: cleanup D/A port pin list
2026-01-27 Add: a new project (RX140: KiCAD)
    [ComponentTester.kicad_pcb, ComponentTester.kicad_sch, Controle.kicad_sch, analog.kicad_sch, power.kicad_sch]
2026-01-27 Add: a new file (KiCAD)
2026-01-30 Update: Add peripheral, device, renesas link
2026-02-01 Update: Add renesas, device link
2026-04-04 Add: RX21A's device file
2026-04-06 Add: RX21A device files
2026-04-15 Fix: motsx_io save func
    [main.cpp]
2026-06-20 Update: sch/pcb
    [USB_CH9102F.kicad_pcb, USB_CH9102F.kicad_sch]
2026-06-20 Add: pin assign label
2026-09-07 Update: cleanup/delete
    [core_board.kicad_pcb, core_board.sch]
2026-10-30 Update: change file_io, seek API prototype
